gokselozgur5/pcb-design-collar-tracker/mechanical/swim-r05-route-fit/README.md

# Preliminary fit for r05f

All 69 populated envelopes and 30 analytical shell checks pass using the actual
r05f placements. C9's new bottom-side position clears the existing carrier.
The smallest checked gap remains C10/carrier at 0.24 mm. The original carrier
still fails the D1 negative control.

PCB SHA256: `1b2b4bd7b90c3931bd8cbb151637408902332a94260d4a2a820ae6df04838a09`.

This retains the r03 height profile and r02 shell geometry. Nine resistor heights
remain requirements, not approved MPNs. Pack, antennas, harness, dock, retention,
seal materials and physical qualification remain open.

The rigid envelope remains 57.4 × 49.4 × 17.6 mm, or 58.7 mm including the key.
The boot is 60.4 × 52.4 × 22.4 mm. The provisional immersion condition is 2 m fresh
water for 60 minutes. No new mesh acceptance or physical dust/water test is claimed.
The inspected populated preview shows conservative boxes and reserved volumes.

Refresh the native export, fit checks, shell checks, preview and manifest after
any source change. The preserved r02 meshes and physical-test requirements do not
become r05f acceptance simply because these dimensional screens pass.
