gokselozgur5/pcb-design-collar-tracker/docs/PCB_DESIGN.md

# PCB Design

Treat PCB work like software engineering: requirements, versioned source, small
changes, checks and a verified release. Use this workflow for future boards too.

This file defines the method. The current board state is in [STATUS](STATUS.md),
its decisions in [decisions](decisions.md), and the application of Paul's review
in [paul-nanosim](paul-nanosim.md). Dimensions and results from one board do not
automatically apply to another.

## Software engineering equivalents

| Software | PCB equivalent |
|---|---|
| Requirements and acceptance criteria | Use, dimensions, power, interfaces, environment, manufacturing and test targets |
| Architecture and API contracts | Block diagram, power tree, pins, voltages, timing and connectors |
| Source code | Schematic, native PCB, project rules, footprint and symbol libraries |
| Dependency lock | CAD version, exact MPN, datasheet revision, library commit and stackup |
| Build | Netlist, Gerber, drill, BOM, CPL, stencil and mechanical outputs |
| Static analysis | ERC, DRC, schematic–PCB parity and geometry checks |
| Unit/regression tests | Pin mapping, footprint dimensions, connectivity and before/after failure examples |
| Integration tests | Actual supplier DFM, assembly review and physical board measurements |
| Release | Checked manufacturing package linked to source by hashes |
| Production smoke test | Bring-up, programming, power/radio/sensor and end-to-end function tests |

**Clean ERC/DRC does not prove the board works. Clean PCB DFM does not qualify
assembly or functionality.** State the scope of each result.

## 1. Define the requirements

Record the following before designing. Mark unknowns as assumptions; do not
silently turn them into decisions.

- Use: what does the device do, under which conditions and how often?
- Country/operator/service: are the connectivity technology and actual service compatible?
- Mechanics: board, battery, antennas, enclosure, mounts, cables and access clearances.
- Power: supply range, peak/average current, operating modes, charging and runtime.
- Interfaces: voltage levels, pin mapping, timing, boot/reset and debug.
- Manufacturing: quantity, budget, layer count, thickness, assembly and hand-soldering needs.
- Delivery: bare PCB, assembled board, or programmed and function-tested device?
- Acceptance: which measurement or test demonstrates completion?

Do not fix battery capacity or board dimensions from an estimate alone. Place real
components, antennas and mechanical volumes together; verify fit and runtime separately.

## 2. Architecture and component selection

Draw a block diagram and power tree. Define each block's inputs, outputs, power
domain and failure behavior. Review supply dips, reset, insertion/removal and
back-powering through interfaces while the device is off.

Every physical component needs an exact MPN, manufacturer, package, pinout and
manufacturer document. A distributor SKU does not replace the MPN. Availability
and suitability are dated evidence. Similar part names do not establish matching
manufacturers, packages or pins.

Read the manufacturer's datasheet and reference design first. Record source URL,
revision, download date and SHA-256. A library symbol or AI explanation alone is
not evidence of the manufacturer's pinout.

## 3. Schematic and footprints

- Make power domains, net names, NC pins, pull-ups/downs and debug paths explicit.
- Check the chain: pin number → manufacturer function → schematic net → PCB pad.
- Run ERC and record ignored checks and justified exceptions separately.
- Independently check critical connections in the netlist. Reading the same wrong
  table used by the generator is not independent verification.
- Compare each footprint with the package drawing: pin 1, top/bottom view, pitch,
  pad dimensions, exposed pad, pegs/holes, mask, paste, courtyard and keepouts.
- Check flipped bottom-side parts and CPL rotations separately.
- One pad number can identify multiple physical pads. Use UUIDs or pad indices.
- Version project-specific footprints in a local library. Resolve differences
  between the native board and library instead of hiding mismatch warnings.

Connector lands fitting on the PCB does not establish usability. Leave space for
card insertion/removal, cable bends, latch release and tools.

## 4. Manufacturing constraints and layer stack

Use the actual supplier's limits for the selected process, layers and thickness.
Set track width, copper clearance, drill, annular ring, mask bridge, board-edge
and silkscreen rules in the project. Keep a dated capability reference.

Supplier minima need not be the design targets. Leave margin where possible.
If fixed package pitch requires an exception, scope it to that geometry; do not
lower every track/via clearance.

Choose layer count and stackup from signal, current and RF requirements. This
project's four-layer/two-inner-GND choice is not a rule for every board.
For controlled impedance, calculate against actual dielectric thickness, material,
copper and supplier stackup. A trace width alone does not establish 50 ohms.

## 5. Placement and routing

Place mechanical constraints, connector/antenna access and critical power/RF
blocks first. Follow manufacturer layouts for decoupling and sensitive feedback
loops. Review critical paths before leaving them to an autorouter.

### Ground and return paths

- Connect the pins that require GND. Connecting every pin to ground is not a goal.
- A GND net name, zero open connections and a good return path are different findings.
- Avoid unnecessary splits in reference planes. Follow return paths across layer
  changes and plane interruptions.
- Give GND pads short local connections to the plane. Do not daisy-chain unrelated
  small passives along a long ground trace.
- Adjacent IC ground pins may share a suitable short connection; record its geometry.
- Place return vias near the relevant signal/power transition. Evaluate spacing
  against the signal and stackup; an inherited number is not a universal standard.
- Measure actual connection to the correct filled plane, not just via count.
  Check isolated islands and saved fills.

### Power, thermal behavior and RF

- Review operating-voltage margin and power sequencing from the actual netlist,
  not just connectivity or DFM. A charger battery cutoff is not automatically a
  modem-rail guarantee. Distinguish typical parameters from guaranteed limits.
- Trace off-state feeds through ADC dividers, pull-ups and debug interfaces.
  A nominal reset delay does not establish a minimum disable interval after a
  brief fault; inspect the supervisor's timing-capacitor reset behavior.
- Size power paths from peak current, allowed drop, copper thickness and temperature.
- Measure short pad escapes separately from long power runs. A netclass setting
  does not prove that every actual trace uses that width.
- Review sequencing, UVLO, charge limits, NTC/protection and transients.
- Compare copper attached to both pads of small passives. Assess soldering and
  thermal balance when one side has a plane and the other a narrow neck.
- Check RF geometry against the reference design and real stackup. Antenna
  keepouts, enclosure, battery and body proximity may need separate measurements.
- Check the full RF trace projection over reference copper; a backed centerline
  can miss an edge crossing a via antipad. Validate converted fill holes against
  native point containment before trusting an independent geometry checker.
- Compare the supplier calculator's actual inputs with its catalog and guide.
  Nominal copper weight, etch taper, mask and finished thickness can use different
  conventions. Record discrepancies; numerical solver tolerance is not process tolerance.
- Adding an ESD part is insufficient by itself. Review connector → protection → IC
  routing and the protection device's ground path.

### Autorouting

Pin CAD/router versions and settings. Export a copy rather than altering the native
source. Expanded pads or keepouts used by the router are not production geometry.
Prevent long autorouted GND buses where ground should connect through planes.

After import, recheck placements, pad/net mapping, layers, locked critical traces,
ground connections, via diameters/drills and minimum widths. A router completion
message does not replace native DRC.

## 6. Verification: what actually passed?

| Check | Required evidence | Does not prove |
|---|---|---|
| ERC | Report for the right schematic/revision, with ignored defaults | Physical operation |
| DRC + parity | Violations, opens and schematic match for the right PCB/project | RF/EMC or power stability |
| Ground review | Pin/net mapping, actual fill, local connection and return measurements | Laboratory EMC performance |
| Geometry regression | Check fails on the old defect and passes on the fix | Every supplier algorithm |
| Gerber review | Actual exported layers, pads, holes and dimensions compared | Assembly correctness |
| Supplier PCB DFM | Uploaded ZIP hash, record ID, rules, completed result and PDF | SMT or functional acceptance |
| PCBA review | BOM/CPL/part/orientation/stencil/factory-preview match | Firmware and product behavior |
| Physical acceptance | Conditions, board revision, firmware and actual test results | Untested environments |

Check commands against the installed KiCad version's `--help`. Include relevant
severities, all track errors and schematic parity. Refresh zone fills; do not
accidentally use `--save-board` on a released file.
[KiCad 10 CLI documentation](https://docs.kicad.org/10.0/en/cli/cli.html).

First map each warning to real coordinates, geometry and net. Similar locations
need not be the same defect. After fixing one, inspect its symmetric counterpart.
Do not weaken rules or arbitrarily shrink manufacturer lands to get green results.

Our release practice requires **two fresh DFM runs of the same final ZIP bytes**.
This is our repeatability check, not a universal supplier requirement. Confirm the
analysis finished, every row was evaluated and rules stayed unchanged. A loaded
web page is not an analysis result.

## 7. Assembly, programming and working delivery

The BOM needs exact parts, values/tolerances, packages, references and DNP status.
Match CPL references, side, coordinates, units, origin and rotation to the supplier
preview. Do not submit DNP parts or bare contact/test pads as fitted components.

An MPN match is not a package-model match. Compare numbered lands and polarity on
both sides; supplier libraries can require different zero angles or have missing
models. Preserve the native CPL and record supplier-specific corrections separately.
After a BOM/CPL reupload, reload the preview and compare downloaded placements with
the exact uploaded bytes: a cached preview can retain earlier rotations. Record
missing fitted references explicitly; an incomplete preview cannot pass full SMT.
[JLCPCB BOM requirements](https://jlcpcb.com/help/article/bill-of-materials-for-pcb-assembly).

Connector libraries may number a signal and duplicated ground lands differently.
Map electrical functions against the manufacturer drawing before comparing geometry.
Apply each pad's local rotation; width/height alone can suggest a false mismatch.
Keep the native physical centre separate from a supplier model's origin. If a
dated model needs a CPL offset, preserve it as a supplier-specific review candidate,
prove its placement in the actual preview and obtain factory datum confirmation
before machine programming. Do not move correct native copper to match a library.

Confirm actual stock, substitutions, bottom-side assembly, stencil and special
processes for the intended order. A datasheet does not establish factory availability.

For programmed delivery, define the firmware image/hash, debug/pogo access,
programming procedure, serial identity and test fixture. Specify acceptance inputs,
measurement limits and failed-board handling.

For a multi-image MCU, inspect the linked reset vectors and actual merged image,
not only a successful compile. Prove that programming bytes exclude the persistent
data region and that the chosen bootloader/secure/non-secure layout is complete.
Keep SDK revisions and source identities with the evidence. Check vendor API
preconditions such as radio functional mode and interrupt context. Test storage
failures and duplicate delivery in the real application core, then repeat critical
power-loss cases on hardware; a host storage model is not a flash qualification.

A caller timeout does not cancel a modem operation. Keep one explicit owner for
each outstanding SDK result, release late results, and prevent overlapping work
until it finishes or the entire subsystem resets. Feed a watchdog from bounded
main-progress leases; an expired lease must stay failed even if main returns late.
Check the vendor's reset-domain table and compiled peripheral ownership. Exercise
the actual worker/supervisor with controlled failures, then observe reset and
persistent-data recovery on hardware. Host adapters do not prove modem or scheduler
behavior, and sleep/watchdog wakeups belong in measured battery accounting.

Signed boot needs more than a successful signing command. Match the image's public
key to bytes embedded in the built bootloader, verify the actual header/payload
and check that primary-image validation and boot-region protection are compiled.
Reject SDK default private keys by public-key identity, including renamed copies.
Record production key custody separately from a development signature. Retain a
reviewed migration when adding a bootloader changes the flash layout.

Check staging offsets against the chosen swap algorithm and the actual downloader
implementation. A nominally supported DFU API can still write at the wrong slot
offset. Make trial confirmation depend on useful, bounded application evidence;
exercise missing acknowledgements, confirmation failures and interrupted writes.
Host bootloader simulation and target signatures are separate evidence; neither
qualifies physical flash, watchdog handoff or power loss during swap.

Bring-up proceeds through short/resistance checks, polarity, current-limited power,
rails, reset/debug, firmware, then radio/sensor and end-to-end functions. Test the
battery, charger and protection against the selected cell's limits. Do not claim
unmeasured health or sensor performance as a validated product feature.

## 8. Git, scripts and releases

```text
AGENTS.md / CLAUDE.md   Entry instructions for a new session
docs/STATUS.md         Current revision, verified results, gaps and exact next step
docs/decisions.md      Decisions, assumptions and supporting evidence
docs/WORKLOG.md        Short record of meaningful completed steps
hardware/             Native source and local libraries
scripts/              Reproducible generation, checks and exports
experiments/<rev>/    Isolated trial sources and evidence
references/           Manufacturer sources, revisions and hash manifest
evidence/             Selected reports, measurements and before/after evidence
release/              Immutable delivery packages linked to source
mechanical/           Enclosure, mounts and real component volumes
```

Identify the actual current source in STATUS. A directory named `hardware/` is not
necessarily the latest revision.

- Use a dedicated repository; do not accidentally stage files in its parent repo.
- Write all GitHub-facing content in English: docs, comments, generated labels,
  commits, issues and PRs. Conversation language does not change this rule.
- One coherent change per commit. Keep related schematic/footprint/PCB changes
  together; separate independent fixes. Mark unfinished work as WIP.
- Preserve source and old releases. Create new trials separately; do not silently
  regenerate a finished board over its existing source.
- Compare placements, pad shapes/nets, rules and critical routes semantically.
  A large KiCad text diff alone is not a review.
- Bind source SHA, tool versions, output list, ZIP SHA, local checks and supplier
  records in a release manifest.
- Actually open Gerber/drill/mask/paste outputs. Check layers, outline, holes,
  pad openings, board edges and both sides' orientation.
- Submit only suitable manufacturing files. Exclude browser profiles, tokens,
  cookies, raw sessions, virtual environments, private notes and unrelated files
  from Git and manufacturing ZIPs.
- Check the release in a clean checkout. A useful regression must reject an
  incorrect source or changed output.

For a retained battery, test the smallest allowed pack as well as the largest
in-service envelope. A seated-pack fit does not check upward travel, sensor contact
or escape through the cap. Keep intended bearing contact separate from component
clearance. When two stops share a monolithic carrier, calculate their relative
height; do not combine opposite translations of the same part. Record the full
tolerance chain, thermal bounds and unqualified tilt/load behavior.

## Completion criteria

Name the completed stage: schematic, placement, local checks, PCB DFM, PCBA or
working product. Inspect evidence for every acceptance criterion in that stage.
Another revision's green result or a report title is insufficient.

Deliver a short result, real remaining gaps and the full artifact path.
For local files, provide a copyable command such as
`open -R "/absolute/path/package.zip"`. Update STATUS so the next session knows
where work stopped and what to do next.

## New PCB brief

```text
Purpose / use:
Confirmed requirements:
Open decisions / assumptions:
Board + battery + antenna + enclosure limits:
Power tree / peak and average current:
Critical interfaces / manufacturer references:
Supplier + process + stackup + design margins:
Current native source / revision:
Acceptance criterion → check → evidence file:
Manufacturing delivery scope:
First concrete next step:
```

## Lessons from this board

- KiCad Python's `FOOTPRINT.SetLayerAndFlip` needs an owning `BOARD`. Attach a
  library-loaded footprint with `board.Add(footprint)` before flipping it. An
  unowned test object crashed in `BOARD::FlipLayer` on KiCad 10.0.7; attaching
  it first completed normally. Treat a native crash as a failed operation,
  inspect its cause and validate saved-file integrity before continuing.
  `scripts/check_kicad_flip.py` exercises that ownership order without saving CAD;
  its process must also exit normally. A separate finalization crash has not been
  attributed to this cause.

- Remembering Paul's GIMP review is not the same as applying it to this board.
  Review each new design against its actual source.
- Two copper pours do not prove two uninterrupted ground references. Inspect
  actual tracks and saved fills on each layer.
- The same 0.3.3 ZIP returned 0/0 and later 0/1. Recheck final bytes; do not turn
  one observation into a universal guarantee.
- The mask warning involved two similar ground necks. Match coordinates individually.
- Removing items while traversing KiCad 10 SWIG collections caused failures.
  Snapshot items first and use `Delete` for removed in-memory objects. Check the
  resulting native board with DRC.
- SIM form factor does not change modem technology. Nano-SIM does not remove
  LTE-M/NB-IoT operator compatibility or the 1.8 V UICC requirement.
- Check connector insertion against the manufacturer's drawing and an actual
  component-side CAD view. Bottom-side mirroring can reverse an assumed opening
  direction; a rotation angle alone does not prove access.
- Preserve working remote pin escapes during local placement changes. Removing
  whole nets can let later routes block fine-pitch pins that were already usable.
  Reserve nearby exits together before routing long connections.
- Placement must reserve signal escapes as well as local GND connections. A
  courtyard/copper-clear part can still have pins trapped between fixed routes.
  Retain unaffected rail geometry where changed pad nets and new lands permit it;
  blanket power-net removal can unnecessarily destroy usable routing.
- Test a suspected connectivity API limitation before changing the router around
  it. KiCad's recursive track connectivity already reached vias in this board;
  an initial one-step query was insufficient evidence of a missing connection.
- For a repair route, export and import must use the same lock policy. A no-routing
  DSN/SES round-trip exposed duplicated locked native copper and two co-located
  drill holes. Preserve the named escapes, unlock replacement routes on import,
  and check the result with native DRC before running a longer search.
- Reconcile router incompletes with native pin connectivity and dangling branches.
  A higher router count is not automatically that many new electrical opens.
  Disable a repair's fanout pre-pass explicitly when testing the existing escapes.

Add reusable lessons here. Current tasks and results belong in STATUS and WORKLOG,
not a growing diary inside this guide.

- Check the router's loaded lock state, not only native KiCad locks. Freerouting
  2.5.0 treats KiCad's `(type route)` token as `USER_FIXED`; use `(type normal)`
  for deliberately movable routes and retain `(type fix)` for protected copper.
  `InspectRouterLocks.java` must reject the old model and accept the corrected
  model. Count differences after loading can reflect merged polylines.
- Native copper can join a pad interior or a trace midpoint. A router expecting
  exact centers/endpoints can report false opens. Preserve coordinate precision,
  split real junctions and check modeled connectors against existing copper.
  Validate the transfer with an isolated no-route SES round-trip and native DRC.
- Run native DRC beside the matching project and schematic. Checking a copied
  board without its project can silently use different rules. This also affects
  `LoadBoard`/`SaveBoard`: loading a bare snapshot and saving it at the real project
  path can write default rules into that project. Restore a checkpoint at its
  matching project path before loading; compare design rules and net classes
  before and after mutations. A report produced with substituted rules is invalid.
- A dangling track may feed a live branch at its midpoint. Trim only the unused
  tail, then recheck pin connectivity; deleting the whole track can break a net.
- Grow the board in a separate experiment when measured routing warrants it.
  Compare resulting power paths and native checks; more area alone does not
  establish better signal routing, enclosure fit or manufacturing acceptance.
- Read the units of individual supplier fields. The JLC measurements used here
  are in mils while board-size metadata uses inches; a shared JSON response does
  not imply one common unit. Keep raw coordinates and the explicit transform.
- Derive label bounds from the actual outline and text size/stroke from native
  rules. Check real glyphs against mask/drill geometry, bind the plan to a source
  hash, and inspect connector association after applying it.
- Give Freerouting an explicit workspace `--user_data_path` even for `-h` or
  version/help probes. Startup can migrate and save the default user settings.
- Reserve fine-pitch pin exits during wider repair routing. Inspect imported
  via coordinates and drilled holes; a nominally protected via can be retained
  beside a shifted router replacement, leaving two near-coincident holes.
- Preserve a moving connector's insertion/removal volume before placing nearby
  protection or decoupling parts. A static footprint courtyard does not model a
  card sliding over the PCB. Check the manufacturer drawing, populated bodies,
  heights and tolerances on the actual component side.
- Audit ESD routing as physical copper topology. An autorouter can connect a
  protected branch back through its same-net connector pad, bypassing the clamp.
  Compare before/after paths; a clamp-land cut can detect bypasses but cannot
  qualify surge performance. Test same-layer branches and via-mediated bypasses.
- Count unique copper around a passive pad. Summing overlapping segment widths
  can double-count one physical connection. Compare both pad exits, nearby rail
  branches and short necks; retain solder/reflow qualification as a separate step.
- Copy SWIG vector coordinates before a native mutation. A stored `GetEnd()`
  wrapper can alias the track and change after `SetEnd()`, creating a zero-length
  split segment. Construct a new `VECTOR2I` and verify native connectivity.
- A joint signal-via/ground-via move can open a site that isolated placement
  searches miss. Record the coupled geometry and recheck every affected net,
  filled plane and return-screen point instead of weakening the target.
- A loaded supplier page is not an uploaded or analyzed design. Bind acceptance
  to an actual upload request, final ZIP hash, distinct record ID, complete rows,
  raw measurements and unchanged rule bytes. Preserve failed runs separately.
- Check seal tolerance extremes using the installed geometry and rubber volume.
  Include stretch, groove-bottom radii and cavity-corner webs; a nominal squeeze
  value alone misses overfilled grooves and thin corners. Retain rejected cases.
- Inspect exported mechanical solids as well as CAD previews. Bind mesh checks
  to their inputs and verify bounds, edge closure and connected surfaces. This
  detects export/model defects; it does not establish physical sealing.
- Check component heights at actual PCB placements, including mated connectors,
  solder/warp allowances and factory wire terminations. Treat unresolved harness
  limits as requirements, not purchased parts. Native board bounding boxes can
  include Edge.Cuts stroke width; use the physical outline for board dimensions.
- Check contact backing hardware and carrier topology together. A relief that
  clears a nut can split a carrier into disconnected pieces. Retain bridging
  material, inspect the exported mesh, and use a deliberately failing CAD variant
  to prove that the interference checker can detect the original problem.
- Specify immersion conditions separately from an IP68 design target. Complete
  battery, antenna, charging and assembly definitions before tooling; qualify
  the final assembly for ingress, power, RF and retention with physical tests.
- Include the motion allowed by a retaining frame, not only the seated PCB pose.
  A small lift can consume cable clearance even when the stationary board fits.
  Keep conservative swept component bounds separate from sampled cable poses;
  a finite pose grid does not prove every continuous deformation or flex cycle.
- Reference retainer and lid-stop dimensions to assembly datums and check the
  complete closing stack. Preserve SIM insertion access in the stated service
  configuration. An internal stop must not force the gasket joint open.
- Treat room-temperature fit, assigned manufacturing limits, material expansion
  and physical retention strength as distinct evidence. Datasheet guideline
  properties do not qualify a thin machined or printed retaining feature.
- Check exported meshes before rendering previews. Coincident rectangle and
  offset-contour faces can create submicron STL slivers; use a shared outer
  contour and real internal overlap, then repeat the same edge/manifold checks.
  Preserve the failed export instead of relaxing mesh precision to hide it.

- Separate guaranteed material bounds from engineering sensitivity intervals.
  A longitudinal CLTE guideline over 23–60°C does not establish cold or transverse
  behavior. Keep actual laminate identity and moisture/creep effects explicit.
- Define axial tolerance chains precisely. If 0.05mm is an assembled-plane budget,
  its constituent length errors must fit that total; do not silently allow each
  part its own 0.05mm. Preserve shared-part temperatures when summing lengths.
- A cable optimizer can find a collision-free curve while asking a connector to
  rotate or carry excessive load. Record the admitted endpoint orientation and
  leave actual connector force, continuous movement and flex life unqualified
  until they are supported by construction limits and physical evidence.

### Routing a congested board without losing ground references

Measure the blocked regions before rerunning the same search. If extra routing
layers are justified, retain two dedicated GND planes and explicitly declare the
signal/ground allocation. Every through-via must clear every spanned signal layer;
check its local return when placing it. A saved RF track shape does not preserve
impedance when dielectric thickness or stack arrangement changes.

Before calling the new revision complete for PCB DFM, refresh connectivity, filled
plane containment, local GND paths, SIM clamp topology and populated fit from the
final source. Inspect both copper attachments on new passives. Check text against
tented drill holes as well as mask openings; native DRC alone did not catch the
r05h silkscreen findings. Preserve a failed package separately and obtain two
fresh analyses of the corrected ZIP with unchanged supplier rules.

### Charging contacts and imported assembly frames

A pogo-pin current rating or nominal free height does not establish a dock fit.
Use the actual manufacturer's datum drawing, full travel and general tolerances.
Separate the rear-seated operating position from unloaded axial float. Check the
key before the earliest possible electrical touch, not just at the final position;
include the physically reversed geometry and leave skew/load qualification explicit.
A spring force at midstroke is not a whole-stroke bound, and magnet diameter alone
is not holding-force evidence. A fuse marking is not a current-regulation function.

Imported STLs can be in a print/export frame. Read the generating transformation
before performing assembly intersections. Preserve a failed frame check as a setup
error rather than modifying a correct part until the wrong frame turns green.

### Wire movement and evidence boundaries

If an electrical contact can move in its mount, a rear-seated straight wire is not
a complete harness layout. Check both the shortest and longest endpoint spans
against controlled cut length. Extra wire can create an excessive bend or collide
with the housing, so a minimum-length check alone is insufficient.

Distinguish a constant-length curve family from an implemented restraint. A free
wire does not automatically follow the mathematical family. State the clamp,
forming fixture, cut preparation and physical cycling work separately. A static
manufacturer bend limit is not a cyclic-flex-life rating.

For continuous clearance claims, use interval envelopes or another explicit bound;
rendered/sample poses are illustrative. Bound numerical integration error before
using it to assert a dimensional limit. Include controls that reject the old
housing, stretched straight wire, excessive slack and overly tight curves.

When a review uses successor mechanical parts with an unchanged PCB, publish a
single current package with an exact part/revision map. Keep earlier packages
immutable and make the remaining manufacturing/physical gates visible in the
current drawing. A higher test count is not evidence that those gates closed.

A friction clamp needs an implemented gap, pad pockets, closing stops and an
assembly method. Check incoming pad thickness and outline extremes, not only the
nominal sheet. Keep pad displacement separate from pressure, friction, creep,
insulation damage and measured pull strength. A forming fixture does not prove
that an unrestrained flexible wire follows its nominal curve during service.

Distinguish an intentional bearing face from an interference volume. If CAD
exports a zero-thickness contact surface, verify every vertex against the intended
plane and footprint, and include a deliberately penetrating control. Do not
silently remove a contact band to make an intersection empty. Deliverable parts
still need closed, valid solid meshes; a planar analysis surface is not a part.

An immutable review archive can contain dated STATUS/RESUME snapshots. Verify
their embedded hashes against the archive manifest, while checking preserved
CAD/source/evidence against repository bytes. Requiring historical status prose
to equal today's status defeats an otherwise intact snapshot.

### Rear contact retention and manufacturable meshes

A screw/nut fitting within a reservation does not prove that it retains a contact.
Compare the complete rear bearing surface with the actual enclosure bore and
follow the clamp load back to the external head. The collar's old 6.4mm circular
reservation was smaller than its 7.34mm bore. r16 adds explicit bearing ears;
force, torque, creep and electrical contact resistance still require qualification.

Inspect exported mesh topology as well as CAD diagnostics. Two overlapping
extrusions at an oblique thickness step generated near-duplicate vertices even
with `Simple: yes`. A single blank with one subtractive step preserved dimensions
and passed the unchanged inspection grid. Keep expected planar contact distinct
from penetration and include a deliberately shifted positive-volume control.

### Internal wire routes, solder lands and movement

Route all conductors together, including actual stripped ends and the adjacent
pads. Fit the bonded length on the native copper polygon; placing only the wire
tip at the pad centre is insufficient. Include cut and position uncertainty when
changing from the insulation envelope to the smaller conductor envelope.

Keep attached parts and endpoints correlated during PCB motion. Sweeping every
part independently against a stationary attached wire invents collisions. A
different fitted curve length at every pose is also invalid for one physical
wire: cut tolerance is not elastic stretch. Use fixed-length cases, actual end
restraint and a factory/service sequence before releasing wire cut instructions.

A thinner internal wire can meet the geometry without growing the shell, but its
resistance, maximum pull and fault-current behavior must be reconsidered. Never
transfer the external harness pull target to a smaller conductor by assumption.

Apply the declared component thermal and retention-movement envelopes to every
cable family. In r17, RF checks used those envelopes while charge-wire checks
used nominal solids; the combined green count therefore had a narrower scope
than the assembly needed. r18 preserves that source and its newly reproduced
failures, then checks the revised routes against expanded envelopes. Expand
the actual cut solid so tolerances reduce usable relief space. Removing material
must also preserve capture features and leave strength/creep acceptance explicit.

Validate an optimizer's routes independently. Sparse curvature samples missed a
short tight bend in one r18 candidate. Continuous bounds rejected it; refitting
the curve with control points distributed by arc length produced a tractable
replacement. A search score, iteration status or convenient representation is
not geometry acceptance, and static geometry is not physical wire restraint.

### Staking and forming tools

Define the actual substrates carrying an adhesive load. A silicone data sheet
does not establish adhesion to untreated PTFE, solder mask, a plating finish or
flux-contaminated joints. Keep each intentional contact explicit; a shared
insulating block can own two leads, but their electrical separation still needs
independent evidence. Check both the minimum filled and maximum occupied volumes,
including the combined placement/service budget.

A shape that clears 27 static poses may still demand deformation after curing.
Report captured-section displacement instead of treating independently fitted
curves as a validated elastic motion family. Keep cure, substrate coupons,
holding force, creep, fatigue and installation acceptance separate from CAD.

Export the actual forming tools. Bound the spline-to-polyline error, account for
polygon facets and machining allowance, then check the delivered tool against an
inflated wire witness. Include a physically wrong control. An open-top channel
helps removal, but does not establish springback, cut-length capability or the
shape after transfer into the product.
