gokselozgur5/pcb-design-collar-tracker/release/collar-tracker-0.3-35x28-dfm/drill-report.txt

Drill report for collar-tracker.kicad_pcb
Created on 2026-10-24T21:14:27

Copper Layer Stackup:
    =============================================================
    L1 :  F.Cu                      front
    L2 :  In1.Cu                    in1
    L3 :  In2.Cu                    in2
    L4 :  B.Cu                      back

Drill file 'collar-tracker-PTH.drl' contains
    plated through holes:
    =============================================================
    T1  0.200mm  0.0079"  (77 holes))

    Total plated holes count 77

Drill file 'collar-tracker-NPTH.drl' contains
    unplated through holes:
    =============================================================

    Total unplated holes count 0
