gokselozgur5/pcb-design-collar-tracker/experiments/power-r05l-charge-interlock/evidence/collar-tracker-05l-charge-final2-40x32-dfm/drill-report.txt

Drill report for collar-tracker.kicad_pcb
Created on 2026-10-25T23:44:11

Copper Layer Stackup:
    =============================================================
    L1 :  F.Cu                      front
    L2 :  In1.Cu                    in1
    L3 :  In2.Cu                    in2
    L4 :  In3.Cu                    in3
    L5 :  In4.Cu                    in4
    L6 :  B.Cu                      back

Drill file 'collar-tracker-PTH.drl' contains
    plated through holes:
    =============================================================
    T1  0.200mm  0.0079"  (276 holes))

    Total plated holes count 276

Drill file 'collar-tracker-NPTH.drl' contains
    unplated through holes:
    =============================================================

    Total unplated holes count 0
