gokselozgur5/pcb-design-collar-tracker/docs/paul-nanosim.md

# Paul review and nano-SIM revision

These are the applicable requirements from Paul's earlier GIMP review, adapted to
this different PCB. The earlier GIMP board's acceptance does not validate this one.
The source review was the archived 2026-09-24 second-review record and GIMP v0.1.6
implementation. Company board files are not copied into this personal repository.

| Review point | Collar action | Acceptance still needed |
|---|---|---|
| GND vias connected by long tracks | Short pad-to-via connections; planes carry GND | All grounds connected, short stubs, no long serial ground bus |
| Two GND core layers | Four-layer revisions: In1/In2. Six-layer r05h: In1/In4 | No tracks on either dedicated GND plane; inspect actual fills |
| Return beside signal via | Add local GND vias | Screen all non-GND vias at ≤2 mm; review RF/ESD needs individually |
| Broken power pours / thin paths | Size continuous power traces | Trunks, pad escapes and worst-case current/drop reviewed |
| Unbalanced copper on small passives | Avoid excessive copper on one end | Inspect both pads, width/count/length of copper attachment |
| Awkward angles and detours | Clean local routing | DRC plus actual geometry inspection |
| SMT and useful labels | Real SMT SIM socket; clear interface labels | BOM/CPL/body/card clearance and supplier assembly acceptance |
| Jumpers, USB/CAN connectors, mounting pattern | GIMP-specific details | Do not add irrelevant circuits or blindly copy hole coordinates |

The 2 mm screen came from the earlier implementation; Paul did not establish a
universal numerical RF limit. More than 2 mm is a review candidate, not by itself a
demonstrated product failure. Fewer vias is not the goal; connected local returns are.

## Socket and ESD

GCT SIM8051-6-0-14-00-A is the no-peg SMT nano-SIM candidate. Manufacturer drawing D5
was inspected locally; revision D6 was subsequently obtained from Mouser and its
full drawing and enlarged land pattern were also inspected. The relevant dimensions
match. Do not add the optional peg holes to this part. Verify insertion and
removal access before placement acceptance. Reference files and hashes are in
`references/paul-nanosim-r04/sources.json`.

| Socket pin | Function | Board net |
|---|---|---|
| 1 / C1 | VCC | SIM_1V8 |
| 2 / C2 | Reset | SIM_RST |
| 3 / C3 | Clock | SIM_CLK |
| 5 / C5 | Ground | GND |
| 6 / C6 | VPP | Unconnected |
| 7 / C7 | I/O | SIM_IO |
| 8 (two physical lands) | Shield | GND |

Contact lands: 1.00 × 1.10 mm at x = −2.54, 0, +2.54 and y = ±5.90 mm.
Shield lands: 1.00 × 3.00 mm at x = ±5.30, y = 0 mm.
Coordinates are component-side drawing coordinates, before bottom-side placement.
Central keepout: x = ±3.575, y = −2.15 to +2.70 mm. Six 1.20 × 1.00 mm
wiper keepouts: x = −2.54, 0, +2.54; y = −4.15 and +3.45 mm.
The builder expresses these as side-specific copper/pad/track/via keepouts.

TI TPD4E1U06DCKR is the four-channel SIM ESD candidate (SC70-6). r04i uses two:
D1 pin 1 reset, pin 3 clock, pin 6 SIM supply; D2 pin 3 data.
The preserved r04h mapping exchanged D1 pins 1 and 3. Pin 2 is GND and
unused I/O channels are NC. The four protection channels are interchangeable
under the [TI datasheet](https://www.ti.com/lit/ds/symlink/tpd4e1u06.pdf).
The older single-D1 mapping belongs only to the preserved earlier sources.
Connector → ESD → modem routing and the ESD ground return must be short;
adding a named component alone does not verify ESD protection.

[Nordic's UICC interface](https://docs.nordicsemi.com/r/bundle/ps_nrf9151/page/ip/radio_lte/doc/simif_lte_m/frontpage.html)
requires external ESD for a removable card and uses native 1.8 V Class C UICC.
SIM supply is not VIO_1V8. Power the modem down before card removal; this design
does not implement hot-swap/card-detect behavior.

[Turkcell NB-IoT](https://www.turkcell.com.tr/kurumsal/dijital-is-servisleri/iot-nesnelerin-interneti/nb-iot)
is an activated M2M service. A physical nano-SIM does not turn nRF9151 into a
general LTE Cat-1 modem or establish moving-dog coverage. Operator, plan and
mobility behavior still need qualification. These are open product checks.

## Preserved r04h placement

The pre-access-repair source is `experiments/paul-nanosim-r04h-review-40x32/hardware/`.
The active r04i source and its changed positions are described below.
The 35 × 28 mm r04e source is preserved separately.
J6 (127,108), D1 (127,99.5), D2 (126.8,116.2), J5 (125,125), R14 (121.5,119),
R15 (126,118) and C10 (130.6,100.35) are on B.Cu. Charger U3 is at (105,123)
on F.Cu; C17 is at (106.2,120.25) on B.Cu, C18 at (103,120.85) and C19
at (101.8,122.5) on F.Cu. J4 is at (106,126.05) on B.Cu.
That saved stage has zero open connections, violations, warnings or parity
findings. All 91 non-GND vias pass the 2 mm return screen. D1/C10 occupy the
projected card-insertion corridor, so placement remains WIP. There is no new JLC
result; the two actual 0/0 runs belong to r04g. See STATUS for exact identities.
Power trunks are provisionally 0.4 mm, VIO 0.3 mm, signal minimum 0.2 mm;
via target 0.60/0.20 mm. A width setting is not an ampacity or voltage-drop test.

The initial r04 ground stage connected 81 GND pads through 68 vias. The saved
r04h rework uses 90: its native inventory finds all 90 centers inside both saved
inner fills, each with one filled outline and no inner tracks. U3.4 joins its own
exposed GND pad. Perimeter nRF ground necks are 0.25 mm to leave clearance beside
the 0.5-mm-pitch contacts. Adjacent IC ground pins may share a local connection;
do not route a ground bus through separate passive components. All 82 GND pads
reach local vias without using a plane shortcut. The longest measured centerline
path is C4.2 at 1.644 mm, excluding pad spreading. The only intermediate pads are
other GND pads on the same IC (U2, U3, U5), not separate passive components.

Preserve the 0.3.4 source. Its RF segments are locked/copied by the WIP builder;
their original 50 Ω stackup/body/antenna qualification is still open.

## Placement review and corrections

The [GCT product page](https://gct.co/connector/sim8051) identifies a push-pull
socket, with no card-detect switch. Rechecking the complete D6 component-side
drawing against native bottom-side pad coordinates resolved an earlier mistake:
the original angle of 0 degrees already points the opening toward decreasing y, near
C1/C2/C3 at y=102.1. In r04g, D1/C10/R15 were behind the closed end. The rejected r04c
180-degree rotation pointed the opening inward and is not used in r04d.
Do not repeat that rotation. This establishes the drawing direction; final
enclosure access, card removal and physical fit still need qualification.

r04h shortened the electrical entry paths by moving D1/C10 in front of the socket,
but their bodies now overlap the nominal card-entry projection. That placement was rejected and corrected in r04i below. GCT D6 page 2 gives
an 8.80 × 12.30 mm nano-SIM. On this board, the nominal entry strip is
x=122.60…131.40, y=98…101.90 mm before tolerances. A courtyard pass does not
prove that a moving card clears components. See `card-insertion-review.json`.

The [TI datasheet](https://www.ti.com/lit/ds/symlink/tpd4e1u06.pdf), DCK0006A
drawing 4214835/D, gives a land/paste example of 0.90 × 0.40 mm, 0.65 mm pitch
and 2.20 mm between row centers. r04d now uses that example, with 0.05 mm corner
radius, matching local library and native footprint. The earlier KiCad-derived
1.025 × 0.35 mm lands / 1.675 mm row spacing are retained only in older sources.
This footprint correction does not establish assembly acceptance or ESD layout
quality. Review connector-to-ESD-to-modem topology and the short ESD ground return
after the final routing changes.

[Nordic's VDD guidance](https://docs.nordicsemi.com/r/bundle/nwp_056/page/wp/nwp_056/vdd.html)
sets a routing DCR target below 0.1 Ω and calls for local filtering, decoupling and
low-impedance grounds. Measure actual path widths/lengths and supply droop; a
0.4 mm netclass setting does not establish compliance. Battery, ferrite, vias,
copper thickness and dynamic supply impedance must be distinguished from trace
resistance alone. `scripts/audit_power_paths.py` estimates centerline copper and
via-barrel resistance from a hash-matched geometry export; it excludes ferrite,
IC, contact and cell impedance, pad spreading, transients and thermal behavior.
The preserved r04h report includes the connected J5 supply branches and their remaining
power-review limits.
The earlier snapshot's estimate is preserved as `power-path-routed1-review.json`.
Rerun the audit after routing changes; complete power qualification remains open.

## r04h copper review

The r04g connector-to-clamp paths were 28.57 mm (supply), 24.52 mm (reset),
22.61 mm (clock) and 3.44 mm (data). All four had a copper route that bypassed
the intended clamp land. The r04h paths are respectively 1.754, 3.666, 1.754 and
1.471 mm with no entry vias. Cutting each clamp land out of the actual copper
disconnects its connector from the modem, so no bypass remains in that snapshot.
This is a topology check, not a powered ESD immunity test. The next mechanical
change must preserve or re-establish this property.

C2 now connects to a 0.4 mm VSYS trunk through one short 0.3 mm neck. R9 has one
0.2 mm branch from an offset 0.3 mm rail. C20/C21 and R1 use bounded pad necks;
manufacturer lands, masks and paste remain unchanged. Summing overlapping track
widths exaggerated the old attachment counts, so the report also measures unique
copper on contours outside each land.

At the 0.05 mm contour, the reviewed pad-width ratios are approximately 1.03
(C2), 1.14 (C20), 1.33 (C21), 1.07 (R1), 1.22 (R10) and 1.08 (R9). R10 needed
no geometry change. Wider contours include nearby rail branches; they remain in
the report rather than being hidden. These are geometric review cues, not solder
acceptance thresholds. [Murata's mounting guidance](https://www.murata.com/en-global/support/faqs/capacitor/ceramiccapacitor/mnt/0012)
also identifies solder quantity, temperature and placement variation as factors.

The main battery/modem path estimates are unchanged. The LDO input estimate
increases from 44.53 to 45.13 mΩ; C20-to-input and C21-to-output estimates rise by
about 0.56 and 0.54 mΩ. The auxiliary VIO path is 57.33 mm / 95.38 mΩ, with no
accepted port load yet. These copper-only numbers do not close transient, thermal
or full supply qualification.

## r04i access repair and final DFM

D1 is now at (133.4,99.7) and C10 at (136.4,100.35), both B.Cu, beside the
card-entry lane. R12 moved to (120.5,99.9), F.Cu. Its two attachments are each
0.2 mm at all three reviewed contours. The protected reset route crosses the
entry corridor through a short outer-layer bridge; the SPI span moved to make
room. The rejected 59.319 mm reset detour was never accepted. The unused old
clock branch and its transition vias were removed after the new route connected.

All four entry paths have no clamp bypass: supply 5.900 mm, reset 6.395 mm,
clock 10.234 mm and data 1.471 mm, each with zero entry vias. These are geometry
measurements; the longer side-routed clock entry still needs powered ESD review.
The body/land projection checks 19 bottom-side parts with a 0.20 mm lateral margin
and finds no card-lane overlap. Vertical clearance and physical insertion in the
assembled enclosure remain separate checks; the proposed carrier lifts out for service.

The final source has 82 locally connected GND pads, 91 GND vias in both continuous
inner fills, 93 non-GND vias within 2 mm, no inner tracks and 24 unchanged RF
segments. Native DRC/ERC/parity and connectivity pass. Main power-path estimates
are unchanged; unknown loads, ferrite/cell/contact impedance and transients remain
explicit limitations. Two fresh, same-byte JLC PCB reports are 0 Danger / 0 Warning.
SMT was off. See STATUS and the r04i checkpoint for hashes and record identities.

## r05h six-layer completion

The preserved r05h uses F/In2/In3/B for routing and In1/In4 as dedicated GND. The
unchanged 71-part circuit is fully connected with clear native DRC/ERC/parity.
All 94 unique ground terminals (97 physical pads) have local paths; 110 GND vias
are contained in both continuous planes. All 128 signal vias pass the inherited
2 mm screen. The original 24 RF segments and four SIM clamp paths are preserved.

The POWER_GOOD replacement route is 18.214 mm with no new vias. C30's 0.82 mm
ground attachment now matches its 0.2 mm supply attachment; all three unique-copper
contour ratios are 1.0. Manufacturer lands are unchanged. Native terminal groups
were preserved throughout unused-copper cleanup.

Both final JLC PCB runs have 0 Danger / 0 Warning, 29 rows and 449 green
measurements, with unchanged rules and SMT off. The actual dielectric stack, RF
impedance, powered circuit, factory assembly and physical ingress remain open.
Changing the stack changes impedance even when RF track geometry is unchanged.
See STATUS for final identities; do not transfer older physical or mesh claims.

## r05i RF follow-up

The six port nets now use 0.36 mm main tracks against a documented 7628 candidate
stack, with bounded module escapes. The GNSS elbow avoids the SIM via's reference
opening. All non-port tracks, pads, vias and ground returns are unchanged. Native
checks pass; two actual JLC runs report 0/0/450. See the
[RF review](../experiments/power-r05i-rf-stack/README.md).

RF acceptance is still open. The supplier's calculator/catalog/guide parameters
differ, both module pads have lower-layer VBAT beneath them, and R3's two-entry
attachment still needs correction or assembly acceptance. Its measured unique-copper
ratio is 2.09–2.41; DFM cannot establish solder balance. C11/C12 are DNP. Do not
call this a completed physical RF or factory-assembly qualification.

## r05j R3 and tuning-junction follow-up

The new R3 location moves 0.30 mm and has one 0.36 mm copper entry per land.
Unique-copper ratios at 0.05/0.15/0.30 mm are 1.004/1.003/1.001. The first local
trial still crossed the outer contours; it is preserved separately. C11's branch
shortens to 0.42 mm and C12 moves onto the main route without moving its footprint.
The total main feed is 3.02 mm longer; no RF performance improvement is claimed.

All other placements, lands, vias, inner copper, planes and rules stay unchanged.
Native DRC/ERC/parity are clean and two actual same-ZIP JLC runs each return
0/0/450. Module-pad GND is retained to avoid exposing underlying VBAT; its RF
qualification remains open. The copper balance addresses the layout finding,
while reflow and physical RF acceptance still require evidence. See the
[r05j review](../experiments/power-r05j-rf-junctions/README.md).
