gokselozgur5/pcb-design-collar-tracker/previews/collar-tracker-schematic.pdf

1 | 2 | 3 | 4 | 5 | 6 | 7 | 8 | 9 | 10 | 11
1 | 2 | 3 | 4 | 5 | 6 | 7 | 8 | 9 | 10 | 11

AB

C

D

E

## FGH

AB

C

D

E

# FGH Date: 2026-10-24

Size: A2 | Rev: 0.1-DRAFT
KiCad E.D.A. 10.0.7 | Id: 1/1

# Title: Collar tracker — schematic review draft

# File: collar-tracker.kicad_sch

# Sheet: /

# Not for fabrication — unresolved power, eSIM, RF and heart-rate interfaces

1

1 | 2
2 | J1
| LTE antenna / 50R
1 | 2 C17

# 1uF /10V PWR_FLAG

1 | 2 R7
3k /1%
1 | 2 R6
18k /1%
1 | 2 C23
100nF
SCL 1 | CS 2 | SA0 3 | SDA 4 | NC | 5 GND

6 VDD 9 VDD_IO 10 INT2 11

INT1 12 U5

### LIS2DW12TR

1 | 2 R8
10k
1 | 2 C2

### 1uF /10V

1 | 2 C4

### 10uF /10V

### PWR_FLAG

1 | 2 C21
1uF
1 | 2 R9
10k
1 | 2 C22
10nF
1 | 2 R15
100k
1 | 2 R14
100k
1 | 2 R13
4.7k
1 | 2 C24
100nF
1 | 2 C6
4.7uF
1 | 2 C8
100nF
1 | 2 R12
4.7k
IN 1 | GND

2 EN 3 NC 4 OUT_1V8 5 U4

### TPS7A0218PDBVR

1 | 2 R11
1M
1 | 2 R10
2M
1 | 2 C20
1uF
SYS | 1 BAT | 2 STAT2 | 3 nCE 4 | GND

5

TS_MR 6

ILIM_VSET 7

ISET 8 | STAT1 | 9
IN 10 | U3 BQ25185DLHR
1 | 2 C18

### 10uF /10V

1 | 2 C19

### 1uF /10V

1

1 | 2
2 | 3
3 | J4 Protected cell + NTC

### PWR_FLAG

1 | 2 R2
1k
1 | 2 R1
10k
1 | 2 C7
4.7uF
1 | 2 C3

### 47uF /10V

1 | 2 C5
100nF
1 | 2 C1

### 1uF /10V

1 | 2 FB1

### 22R @100MHz GND

1 P0.20 2 SWDCLK 3 SWDIO 4 P0.21 5 P0.22 6 P0.23 8 nRESET_2V2 9 ENABLE 10 P0.24 11 P0.25 12

VDD | 14 SIM_RST | 16 SIM_IO | 17 SIM_CLK | 18 SIM_1V8 | 19 MAGPIO0 | 21 MAGPIO1 | 22 MAGPIO2 | 23 DEC0 | 24 SIM_DET_UNUSED | 26 SDATA | 27 SCLK | 28 VIO | 29 ANT | 35 AUX | 37 GPS | 42 P0.26 44 | P0.27 45 | P0.28 47 | P0.29 48 | P0.30 49 | P0.31 50 | COEX0 | 52 COEX1 | 53 COEX2 | 54 P0.00 56 | P0.01 57 | P0.02 58 | P0.03 59 | P0.04 61 | P0.05 62 | P0.06 63 | P0.07 64 | VDD_GPIO | 65 P0.08 67 | P0.09 68 | P0.10 69 | P0.11 70 | P0.12 72 | P0.13 73 | P0.14 74 | P0.15 75 | P0.16 77 | P0.17 78 | P0.18 79 | P0.19 80 | U1

### nRF9151-LACA

1

1 | 2
2 | J3
| 5V charging input
1 | 2 C9
100nF
1 | 2 R5
100k

1

1 | 2
2 | 3
3 | 4
4 | 5
5 | 6
6 | J7 SWD / debug

1

1 | 2
2 | 3
3 | 4
4 | 5
5 | J6

### eSIM interface / SKU TBD

1 | 2 C10
100nF

1

1 | 2
2 | 3
3 | 4
4 | 5
5 | 6
6 | 7
7 | 8
8 | 9
9 | 10
10 | 11
11 | 12
12 | J5 DIGITAL health sensor interface
1 | 2 R4
1k | GND
1 VEN
2 | VCC
3 | RF_IN
5 | FILT_OUT | 7 AMP_IN
8 RF_OUT | 10 U2

### SKY65943-11

1 | 2 C12 DNP / tune
1 | 2 C11 DNP / tune
1 | 2 R3

### 0R / tune

1 | 2 C15
100nF
1 | 2 C16
1uF

1

1 | 2
2 | J2 GNSS antenna / passive
1 | 2 C14

### 39pF RF

1 | 2 C13

### 39pF RF

1 | 2 L1
9.1nH

VDD_NRF

I2C_SCL | GND

FILT_OUT

VIN_5V | GND

GPS_RF

VIN_5V

GNSS_FEM_OUT

GND

# LTE_ANT GNSS_FEM_IN

VSYS | GNSS_ANT
ISET | GND

GND

GND

GNSS_ANT

ILIM_VSET

GND

GND

GND

VIO_1V8

I2C_SDA | VIO_1V8

GND

VIO_1V8

VIO_1V8

GND

GND

GND

VIO_1V8

LTE_RF

VIO_1V8

LTE_ANT

I2C_SDA

I2C_SCL

LTE_RF | GND

VIO_1V8

LTE_ANT

VIO_1V8

GNSS_FEM_IN

GND

VIO_1V8

CHG_STAT

GNSS_LNA_EN | AMP_IN

VBAT

VIO_1V8 | GNSS_FEM_OUT

GND

FILT_OUT VDD_NRF DEBUG_RESET

CHG_FAULT

GND

GND

COEX0 | GNSS_LNA_EN

VIO_1V8

VIO_1V8 BAT_ADC | GND
HEALTH_RESET VIO_1V8 | HEALTH_EN

VDD_NRF

GND | HEALTH_EN | GND

GND

VIO_1V8 | DEBUG_RESET HEALTH_CS

VIO_1V8

SWDIO

GND

SIM_CLK

SIM_IO

I2C_SCL | GND

VIO_1V8

VIO_1V8 | GND

NRF_ENABLE SIM_RST

SIM_RST ACC_INT

VSYS | GND
| SWDCLK

VSYS

VSYS

SIM_1V8

GND

VIO_1V8

NRF_RESET

BAT_ADC

GND

GND

VIO_1V8

VSYS

I2C_SDA

BAT_ADC

I2C_SCL

VBAT

HEALTH_INT SPI_SCK

SPI_MOSI

DEC0

SPI_MISO

HEALTH_CS

VSYS

GNSS_LNA_EN

GND

ISET

ILIM_VSET

GND

GND

VIN_5V | GND

BAT_NTC

VIO_1V8 HEALTH_CS HEALTH_RESET HEALTH_EN

CHG_STAT

VSYS | GND

NRF_ENABLE

VBAT

CHG_FAULT BAT_ADC

BAT_NTC

GND
CHG_STAT VBAT VSYS CHG_FAULT
GND NRF_RESET | GND

GND

VDD_NRF | GND

GND

VDD_NRF

VSYS

VSYS DEC0

VIO_1V8

# VDD_NRF SIM_1V8

SWDIO

ACC_INT HEALTH_INT SPI_SCK

SPI_MOSI SPI_MISO

SWDCLK NRF_RESET NRF_ENABLE

AMP_IN

COEX0 GPS_RF

VIN_5V

GND

LTE_RF SIM_IO

SIM_CLK

I2C_SDA

SIM_1V8

# REFERENCE DECOUPLING / NOT A COMPLETE RF LAYOUT

Reserved pins 31-33 and 81-104: electrically unconnected. SIM_DET is not supported. No external pull-up on nRESET.

# 02 / LTE AND GNSS FRONT END

GPS and cellular do not receive/transmit concurrently. GNSS RF ESD, matching and body/enclosure tuning remain open. No NTN/B255 requirement in this draft.

HOLD: add/verify hardware undervoltage cutoff (VDD >=3.0V), VDD_GPIO startup/shutdown sequencing, charging-input protection, and battery/NTC ratings before layout release. BQ25185 internal battery cutoff alone is insufficient for nRF9151. BAT_ADC: allow divider/filter settling; do not sample immediately.

# 05 / eSIM AND DEBUG INTERFACES

J6 is NOT a purchasable eSIM or its footprint. Select 1.8V eUICC + carrier profile, then map

these signals to its actual package pins. SIM_1V8 must remain separate from VIO_1V8. ENGINEERING DRAFT 0.1 — NOT FOR FABRICATION

# Turkey / shared lightweight body / heart-rate feasibility pending

# 01 / MODEM, GNSS AND APPLICATION MCU

# 03 / POWER — FIRST CIRCUIT DRAFT

Digital interface only — not an electrode connection. PPG/ECG measurement head, power switching and protection must be designed and validated separately. No heart-rate sensor selected; no heart-rate accuracy claim. | Reset has an internal 2.2V pull-up.

Debug reset driver: open drain, compatible voltage. No external reset pull-up.

# 04 / MOTION AND HEART-RATE EXPANSION
