gokselozgur5/pcb-design-collar-tracker/mechanical/universal-mount-r01/design-overview.pdf

C O L L A R T R A C K E R / U N I V E R S A L M O U N T R 0 1

# PCB, enclosure and adjustable collar attachment

Prototype CAD · actual design geometry · dimensions in millimetres

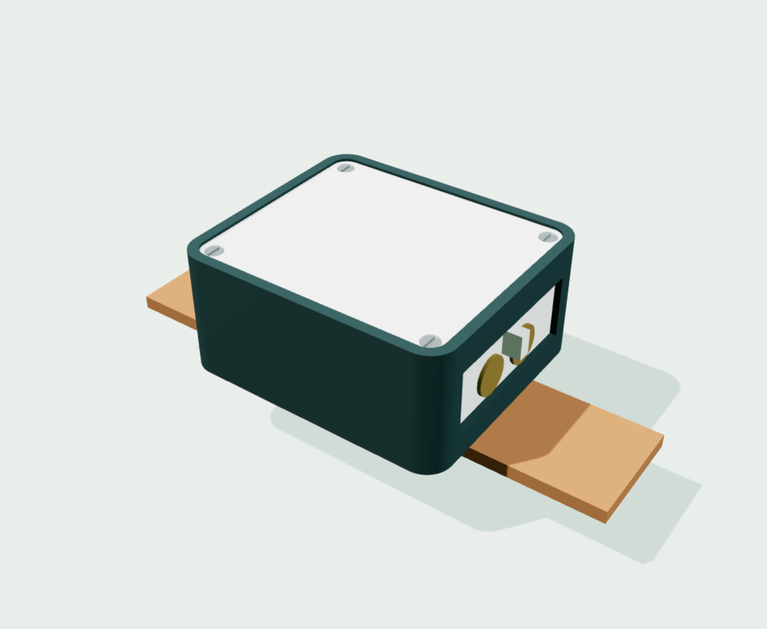
[picture p4: figure]

01 / ON THE COLLAR

Rigid housing 57.4 × 49.4 × 21 mm · outer holder 60.8 × 52.8 × 27.3 mm

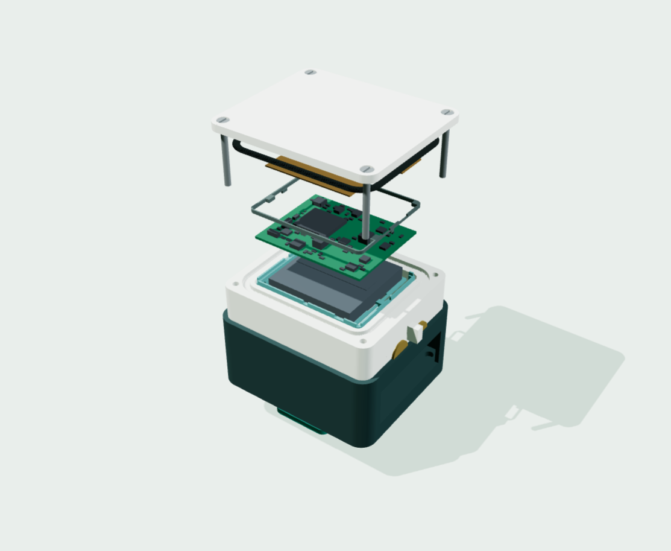
[picture p5: figure]

02 / INSIDE THE ENCLOSURE

Battery cradle · 40 × 32 mm PCB · antenna envelopes · gasket · lid

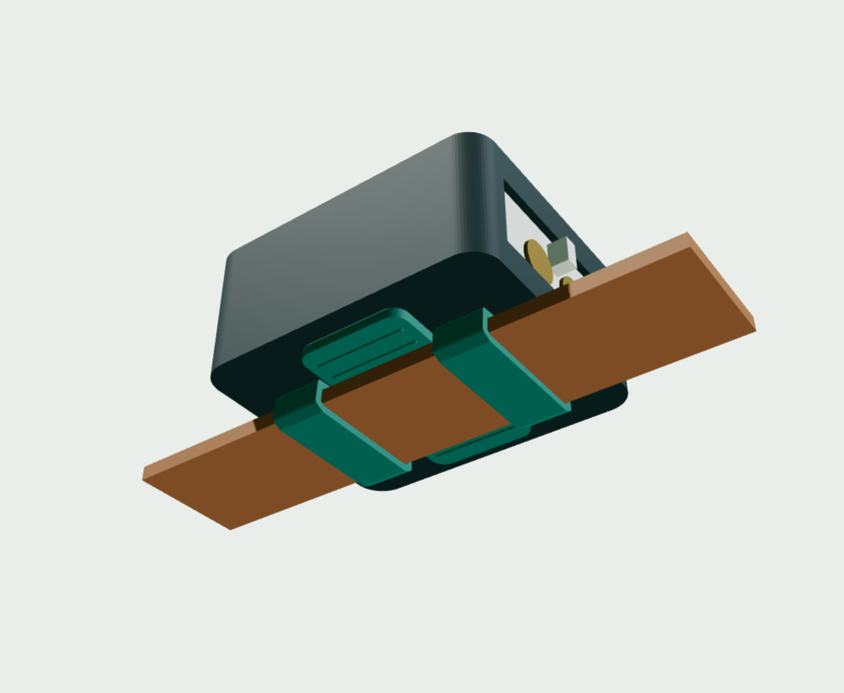
[picture p6: figure]

03 /ADJUSTABLE ATTACHMENT

Two wrap straps · flat or V-groove pad · 120 / 220 mm strap options

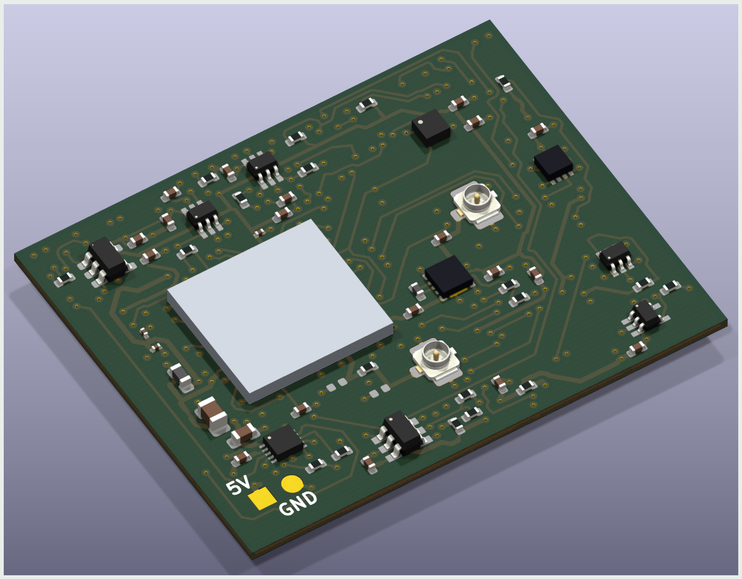
[picture p7: figure]

04 / CURRENT PCB

KiCad r05m render · four package bodies use dimensional substitutes

Checked examples: flat 8 × 1, 25 × 3, 60 × 8 mm; round Ø4, Ø8, Ø16 mm. Grip, comfort and IP68 need physical qualification.
