gokselozgur5/pcb-design-collar-tracker/mechanical/swim-r15-wire-clamp/wire-clamp-sheet.pdf

# CT-DOCK-001-C | Wire clamp and assembly fixture / r15

PROTOTYPE — geometry checked; clamp retention, dock holding and electrical release remain open

## External dry dock: 101.5 x 36 x 16mm

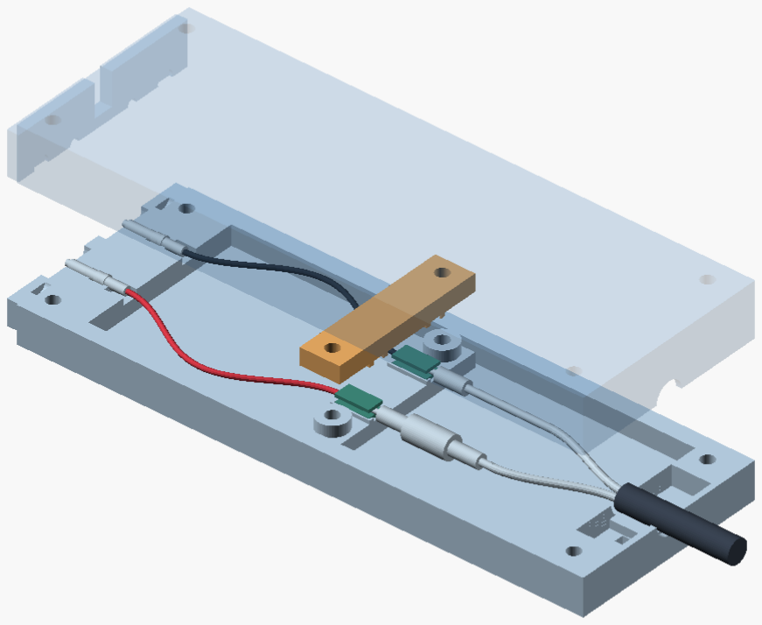
[picture p10: figure]

Wearable, PCB, key, seals and spring-contact seats unchanged.

## Clamp assembly (cap lifted for visibility)

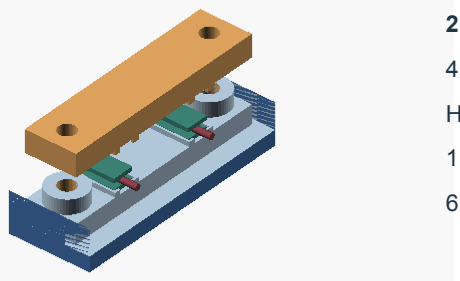
[picture p11: figure]

### 2 x M2 x 10

4 silicone pads
Hard-stop columns
1.93mm face gap
6 x 3mm pad outline

## Separate factory forming fixture

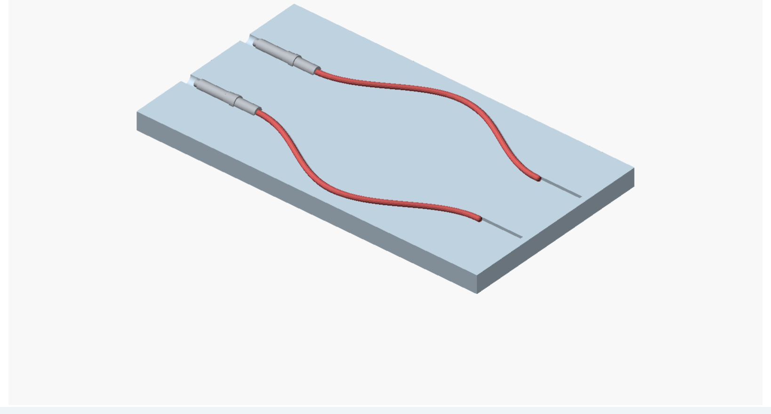
[picture p12: figure]

Free span / wire | 40.95 +/- 0.10mm at 23C
Fixed-end plane | X=49.00 +/- 0.10mm total
Sheet thickness | 0.7874 +/- 0.1016mm
Local pad displacement | 5.50..43.52% / assigned bounds
Housing / cap / fixture | Four closed CAD meshes
CAD collision checks | 5 clear / 3 contacts / 5 controls
PCB DFM | Unchanged: two runs at 0/0/455

The fixture controls assembly shape only. Free wires still require cycle tests. Squeeze is not a friction, insulation-strain or lifetime calculation.
Factory pull target: 5N / 60s per wire; no physical result exists.
Position error and later slip share the same +/- 0.10mm budget.

Open: latch, internal J3 route, pack approval, firmware and physical power/RF/water/dust testing. No order release.

2026-10-26 | Units: mm | See dock.json, sources.json, checks.json, mesh-checks.json and README | Review only
