gokselozgur5/pcb-design-collar-tracker/mechanical/swim-r12-pack-retention/pack-retention-sheet.pdf

# CT-BAT-RET-001-A | Battery capture / r12

CONDITIONAL PROTOTYPE — pack, contact regions, strength and ingress are not supplier-qualified

## Plan: cap and cradle

### Cap body: 34.4mm

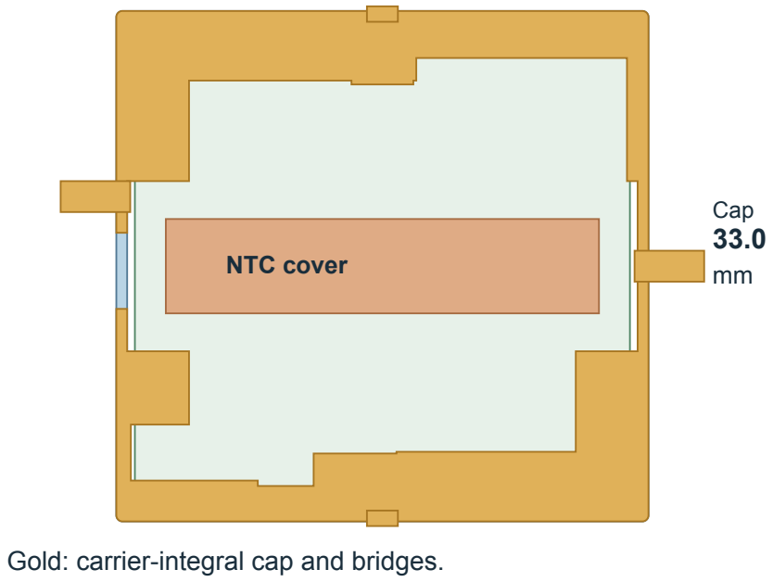
[picture p16: figure]
Cap 33.0 mm NTC cover; Gold: carrier-integral cap and bridges.

Blue: shell-integral cradle. Green: requested pack. Clearance cuts follow actual bottom-side parts.

## Vertical stack and limits

Pack support | Z=1.80mm; original shell floor
Maximum body top | Z=7.10mm seated
Cradle wall top | Z=7.10mm
Cap bearing / top | Z=7.56 / 8.31mm; 0.75mm thick
PCB support | Z=10.40mm; unchanged
Body max / min | 32 x 30.5 x 5.3 / 30.5 x 29 x 4.8mm
Component sweep | 85 parts; new-solid gap ≥0.225mm
Raised NTC cover | Gap to populated PCB ≥0.223mm
Capture regions | Four; minimum guaranteed area 1.429mm²
Rigid outside | 57.4 x 49.4 x 21.0mm + docking key
Material / process | PC candidate; physical capability unapproved

No rigid pouch preload or user soldering is intended.
Do not force the pack, carrier or lid into place.

Minimum pack dimensions and allowed bearing regions are added engineering requirements, not an approved supplier drawing. The raised-sensor check uses the shared carrier datum, independent component temperature and 0.10mm total feature error. Assigned CTE/tolerances are unchanged from r11. Pack/board tilt, loads, abrasion, cap strength and creep need physical checks. Factory lead exit, harness routing, contact termination, dock and programming/test remain unfinished. No order is authorized. The all-green PCB Gerber is unchanged. No physical water/dust test or IP68 approval is implied.

2026-10-26 | Units: mm | Actual plan geometry; dimensions govern | Review only | 1 / 1
