gokselozgur5/pcb-design-collar-tracker/mechanical/swim-r02-fit/drawing.pdf

# SWIM-r02 / DIMENSIONED PROTOTYPE

Nominal CAD plus controlled seal dimensions • CNC/process and material approval required before manufacture

### TOP VIEW / LID REMOVED

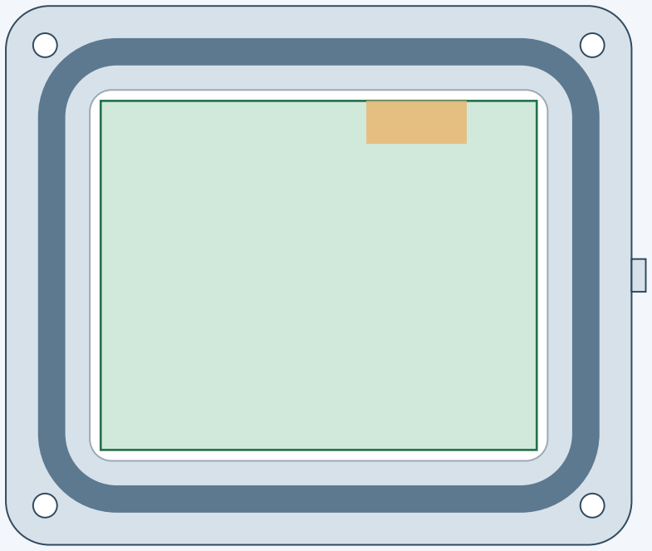
[picture p17: figure]

57.4 body width; 58.7 with key

49.4 body depth • R4 outer corners
42 × 34 cavity, R2 • PCB 40 × 32
4 × Ø2.2 at (±25.1, ±21.1)
Orange: SIM lane; lift tray for card service

### MAIN LID SEAL / SECTION

LID

BODY

1.34

2.50 ±0.05
Depth 1.34 ±0.02; local flatness budget 0.01 Centerline 49 × 41, R6; bottom corner R0.2
O-ring 50.52 ID × 1.78 section, EPDM 70A
Declared squeeze: 17.7–28.8%; fill: 62.6–83.2% Seal face Ra ≤0.8 µm; no burrs or crossing tool marks

SEALED CHARGING TARGET / CUSTOM TURNED PART

Head Ø8.5 × 0.8 | Shaft Ø7.28 × 7.70 | Rear M3 × 0.5 thread, 3.50 long
Radial gland root Ø4.64 ±0.01; width 2.80 ±0.05; center 3.85 behind head
Housing bore Ø7.34 ±0.02; seal ID 4.50 ±0.10 × section 1.80 ±0.08
Centers at Y=±6, Z=5.5 on +X wall. +Y is +5 V; −Y is GND.

Contact coating, edge finishing, retention, dock parts and electrical/immersion durability require prototype qualification.

2026-10-25 | Dimensions in mm. Diagrams are not print-scale. STL files are 1:1. | Prototype / no IP qualification
