gokselozgur5/pcb-design-collar-tracker/previews/compact-250-review.pdf

# 38 × 30 × 14 mm target body

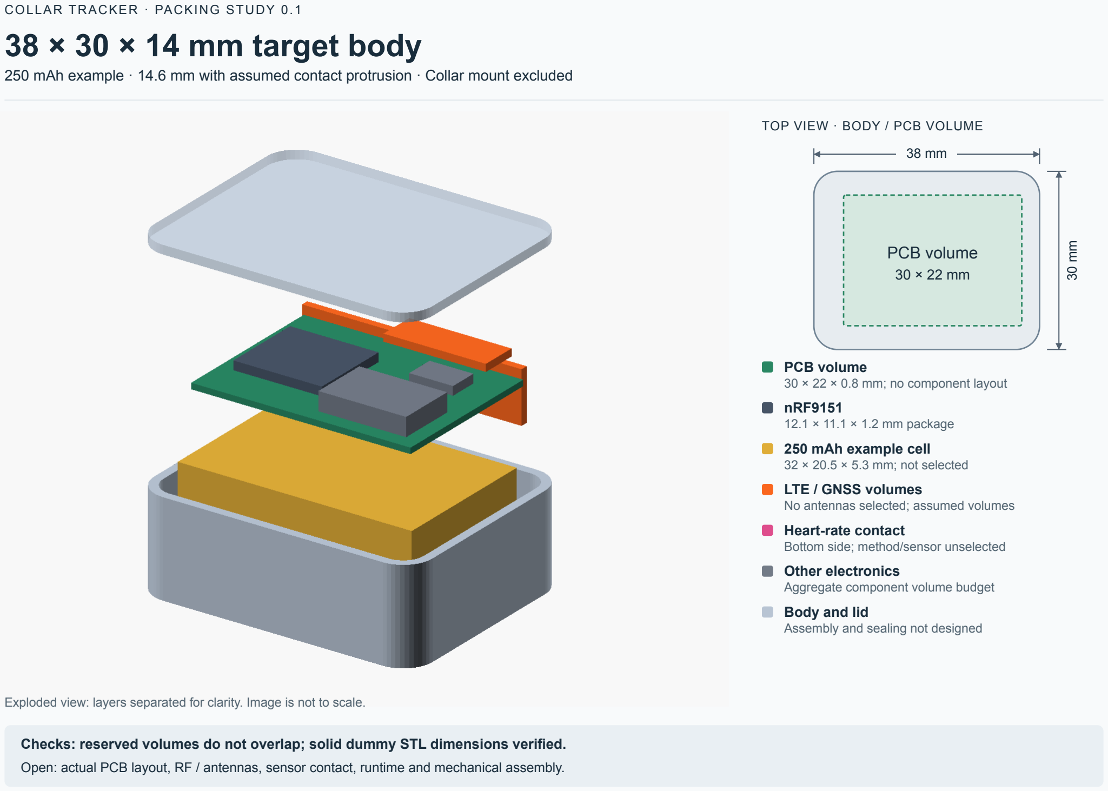
[picture p18: page 1]

CO L LAR TRACKER · PACKING STUDY 0. 1

250 mAh example · 14.6 mm with assumed contact protrusion · Collar mount excluded

Exploded view: layers separated for clarity. Image is not to scale.

TOP VIEW · BODY / PCB VOLUME

## PCB volume

30 × 22 mm

38 mm

30 mm

PCB volume
30 × 22 × 0.8 mm; no component layout nRF9151
12.1 × 11.1 × 1.2 mm package
250 mAh example cell
32 × 20.5 × 5.3 mm; not selected
LTE / GNSS volumes
No antennas selected; assumed volumes Heart-rate contact
Bottom side; method/sensor unselected Other electronics
Aggregate component volume budget Body and lid
Assembly and sealing not designed

Checks: reserved volumes do not overlap; solid dummy STL dimensions verified. Open: actual PCB layout, RF / antennas, sensor contact, runtime and mechanical assembly.
