gokselozgur5/pcb-design-collar-tracker/release/r16-current-review/pcb-review.pdf

# COLLAR TRACKER / VERIFIED PCB

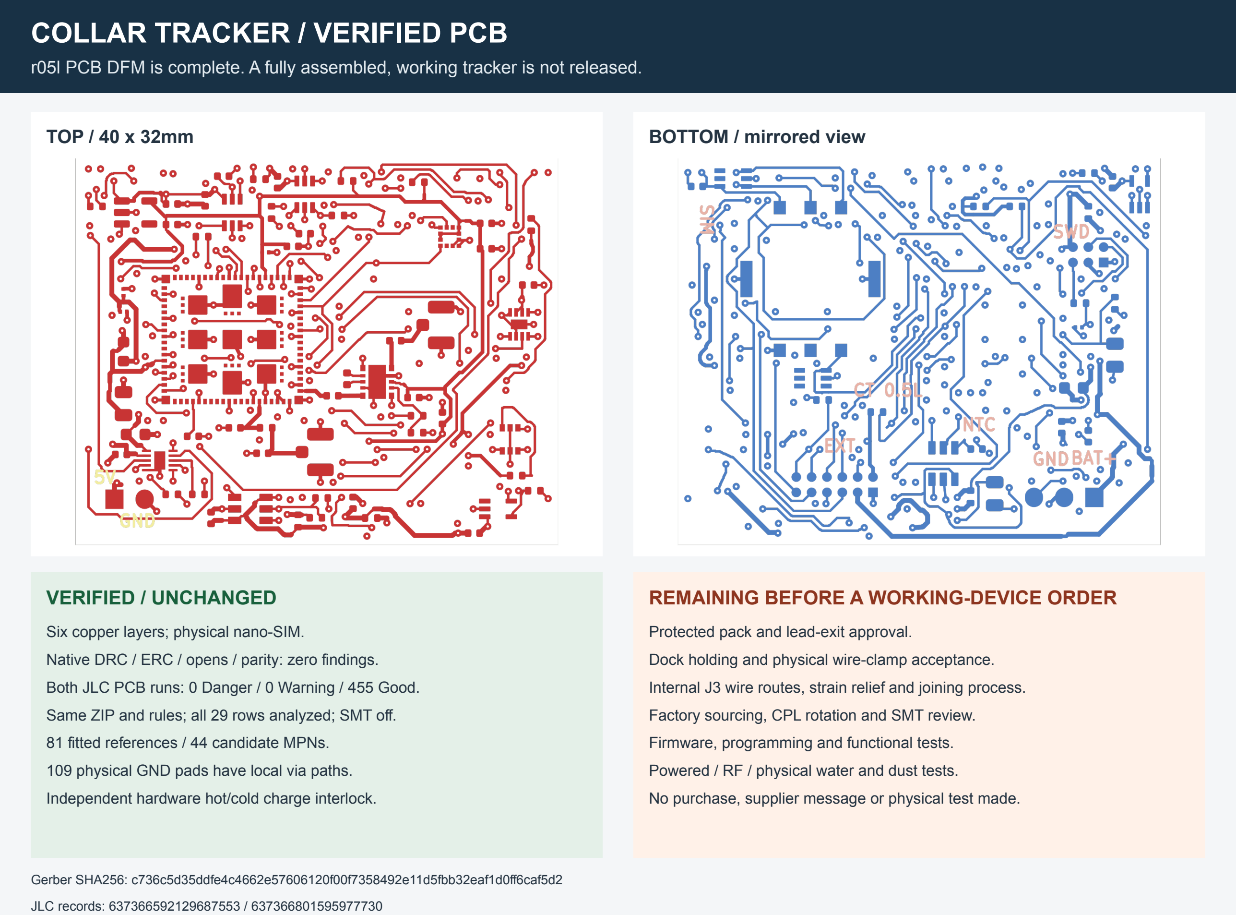
[picture p19: page 1]

r05l PCB DFM is complete. A fully assembled, working tracker is not released.

TOP / 40 x 32mm | BOTTOM / mirrored view

### VERIFIED / UNCHANGED

Six copper layers; physical nano-SIM.
Native DRC / ERC / opens / parity: zero findings.
Both JLC PCB runs: 0 Danger / 0 Warning / 455 Good. Same ZIP and rules; all 29 rows analyzed; SMT off. 81 fitted references / 44 candidate MPNs.
109 physical GND pads have local via paths. Independent hardware hot/cold charge interlock.

### REMAINING BEFORE A WORKING-DEVICE ORDER

Protected pack and lead-exit approval.
Dock holding and physical wire-clamp acceptance.
Internal J3 wire routes, strain relief and joining process. Factory sourcing, CPL rotation and SMT review. Firmware, programming and functional tests.
Powered / RF / physical water and dust tests.
No purchase, supplier message or physical test made.

Gerber SHA256: c736c5d35ddfe4c4662e57606120f00f7358492e11d5fbb32eaf1d0ff6caf5d2

JLC records: 637366592129687553 / 637366801595977730
