gokselozgur5/pcb-design-collar-tracker/release/r05l-review/pcb-review.pdf

# COLLAR TRACKER / r05l PCB REVIEW

Charge interlock implemented. Two clean PCB DFM reports; assembled release remains on hold.

TOP / native copper and silkscreen | BOTTOM / mirrored component view

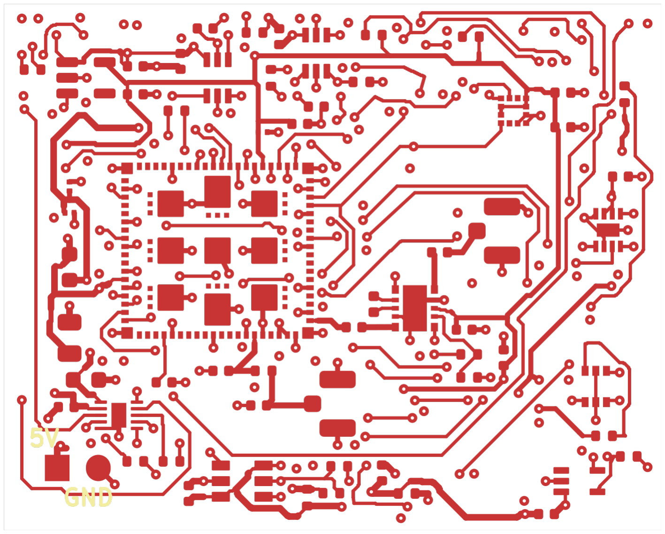
[picture p23: figure]

### VERIFIED PCB

40 × 32 mm / six Cu layers / 87 footprints
Native DRC, ERC, connectivity and parity: zero findings Two JLC runs: 0 Danger / 0 Warning / 455 Good each Same ZIP, same rules, all 29 rows analyzed; SMT off
81 fitted references / 44 exact candidate MPNs
109 physical GND pads have local paths to vias
Two GND planes; 154/154 signal-via return screens pass

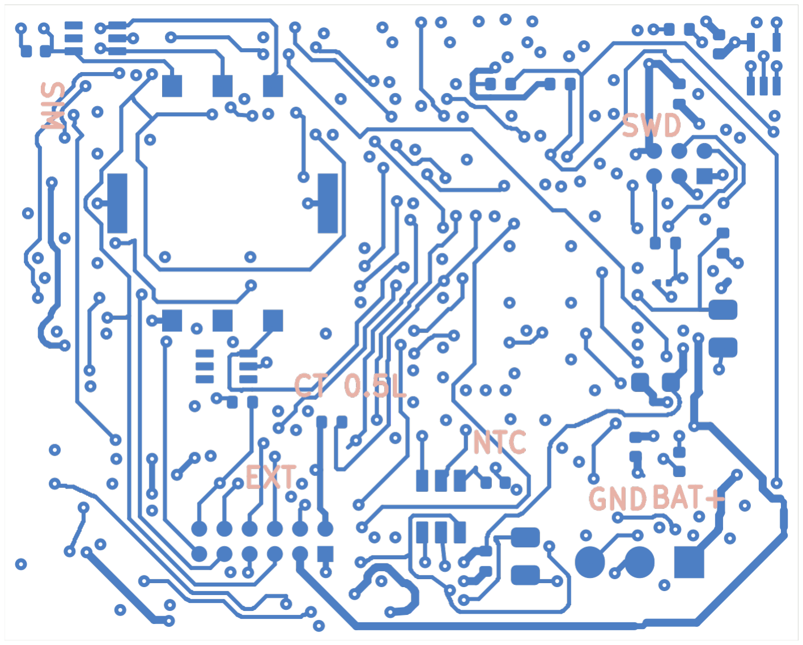
[picture p24: figure]

### REQUIRED BEFORE WORKING DELIVERY

Charge window is implemented; corner model is conditional. Thermal coupling, startup and fault transients need tests. Protected pack, NTC attachment and antennas: open. Firmware and factory programming/functional test: open. Procurement, CPL rotations and SMT acceptance: open. No physical powered, RF or water/dust result exists. This package is for review; it is not an order release.

PCB SHA256: 241c84d6ba98793c37344e1e46ddc4918e7b05322ba87daea7c9a90ffb8379b3

JLC records: 637366592129687553 / 637366801595977730
