gokselozgur5/pcb-design-collar-tracker/release/collar-tracker-0.3.4-jlc-dfm-report.pdf

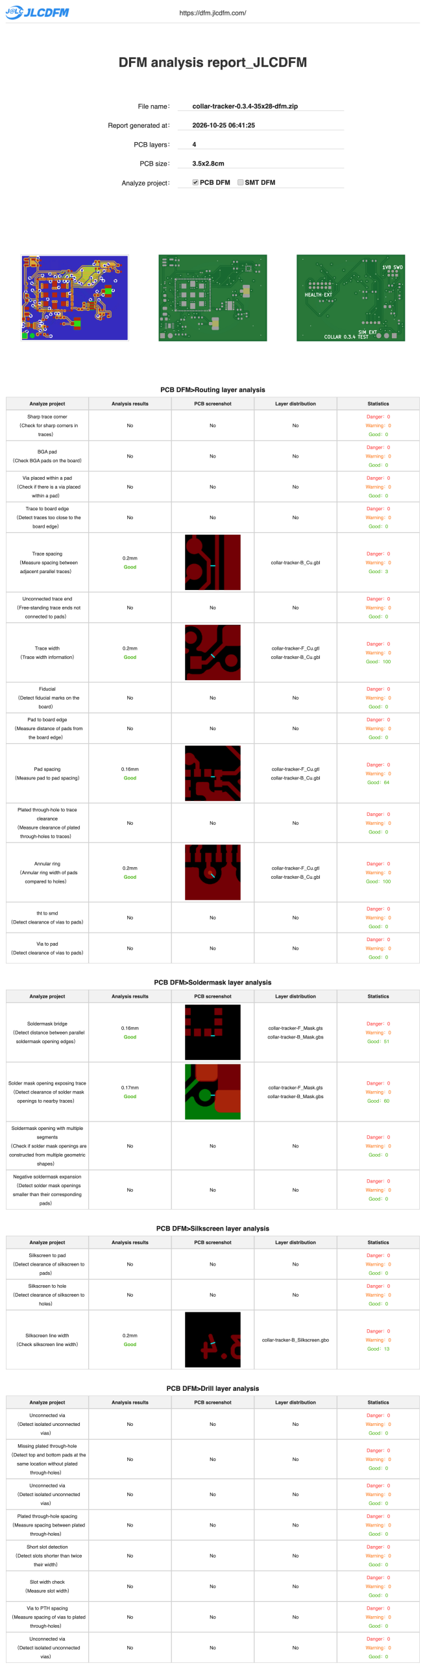
[picture p25: page 1]
