gokselozgur5/pcb-design-collar-tracker/release/collar-tracker-0.3.3-jlc-dfm-report.pdf

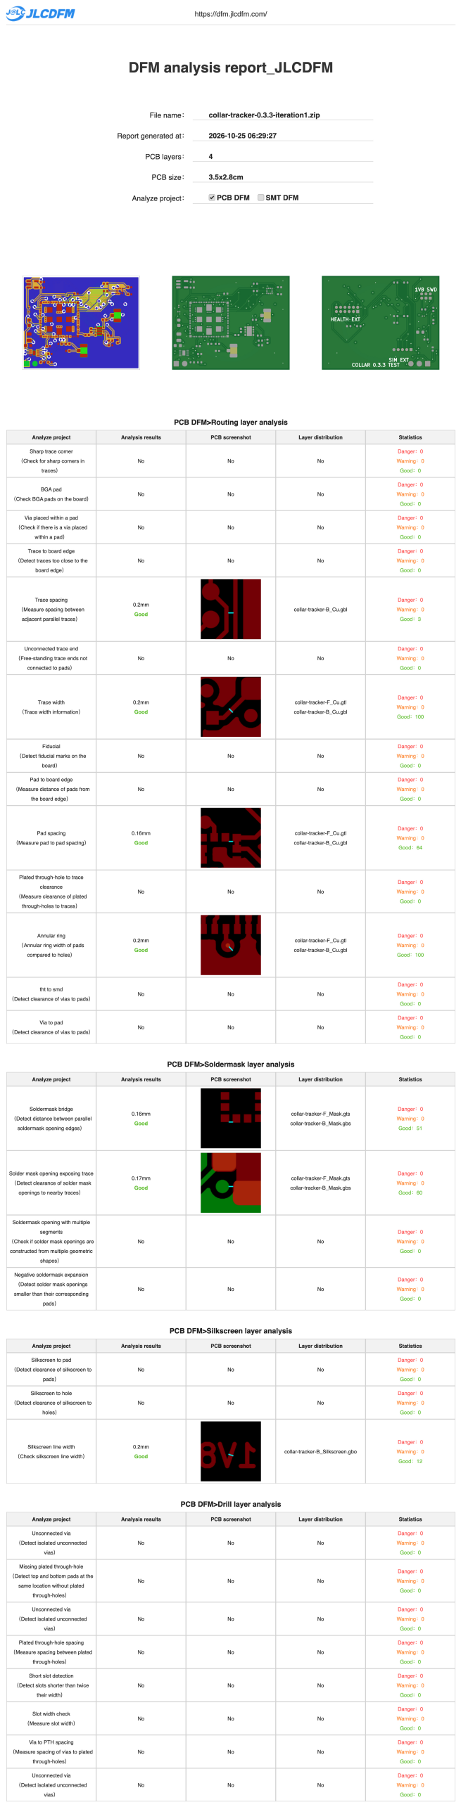
[picture p26: page 1]
