gokselozgur5/pcb-design-collar-tracker/assembly/pcba-r04/diagnostic-report.pdf

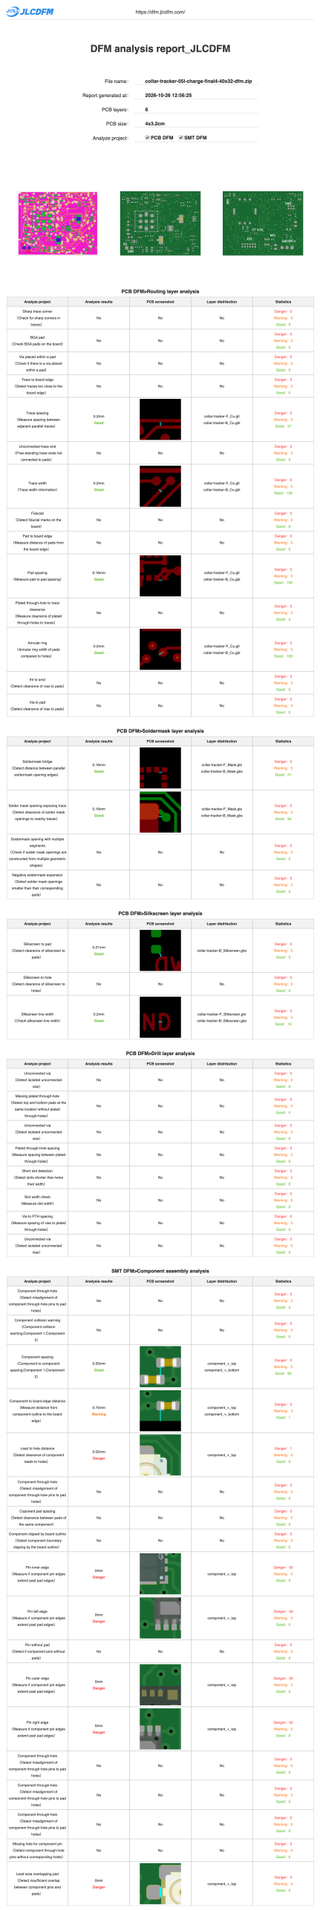
[picture p27: page 1]
