gokselozgur5/pcb-design-collar-tracker/assembly/pcba-r03/smt-report.pdf

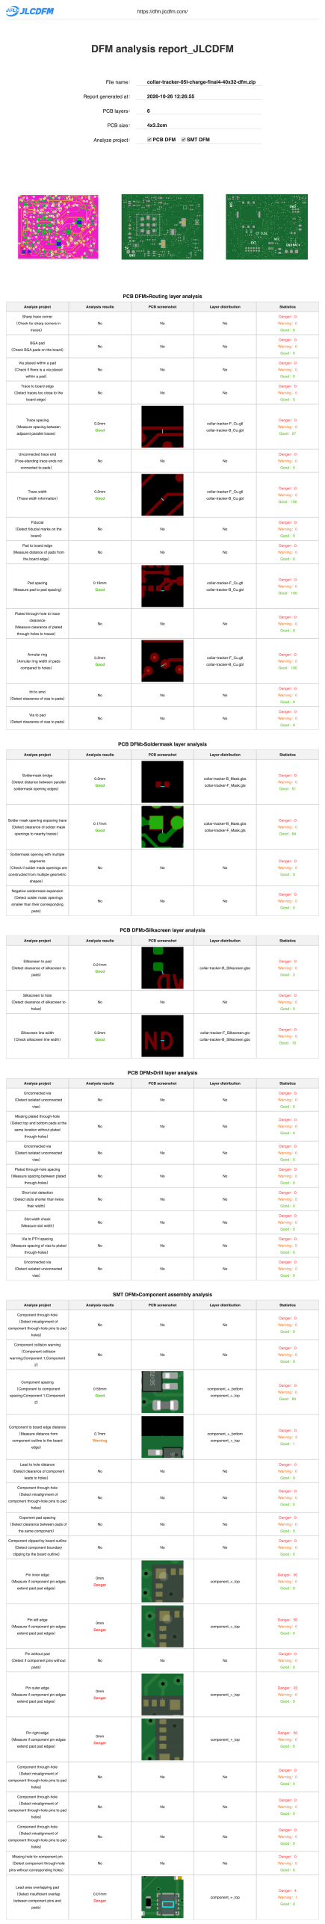
[picture p28: page 1]
