gokselozgur5/pcb-design-collar-tracker/experiments/power-r05l-charge-interlock/evidence/jlc-check1/report.pdf

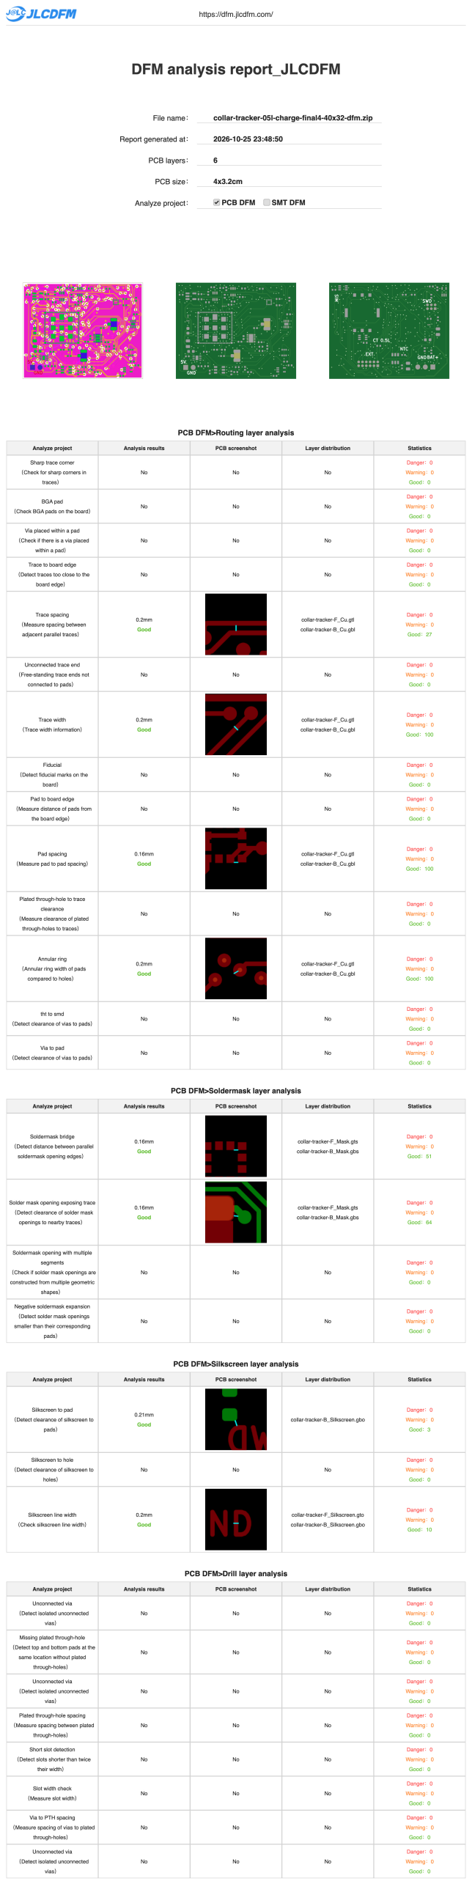
[picture p29: page 1]
