gokselozgur5/pcb-design-collar-tracker/experiments/power-r05l-charge-interlock/evidence/jlc-check2/report.pdf

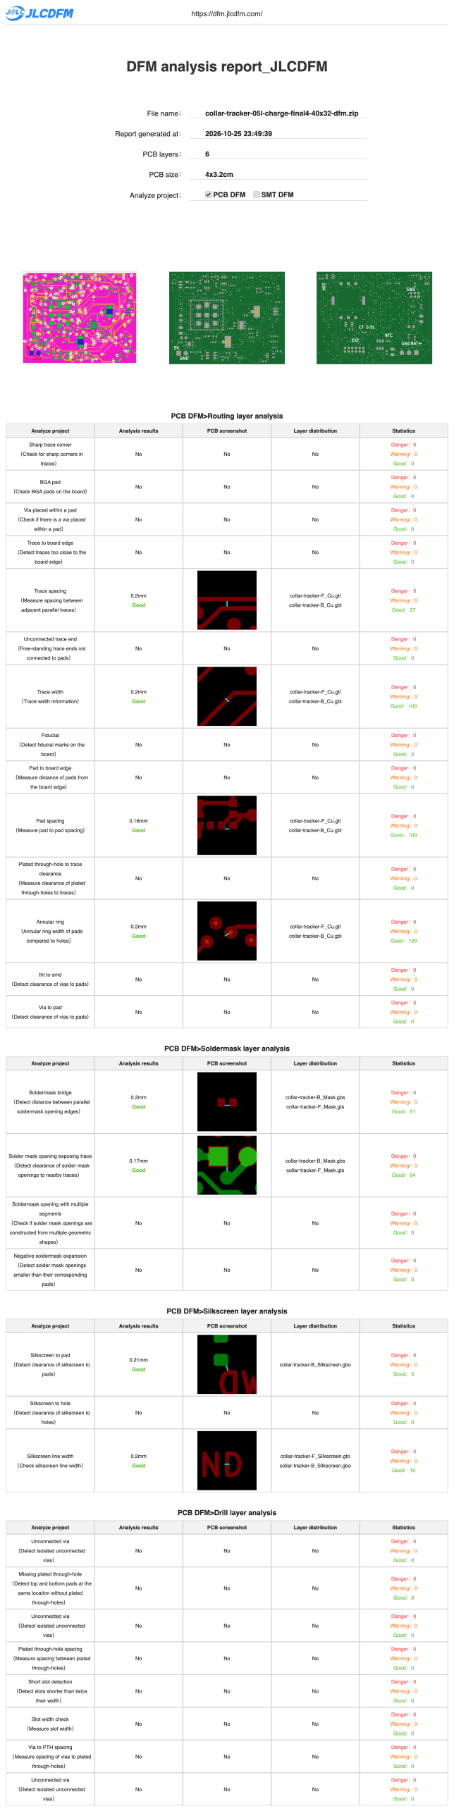
[picture p30: page 1]
