gokselozgur5/pcb-design-collar-tracker/experiments/power-r05l-charge-interlock/evidence/jlc-initial-findings/report.pdf

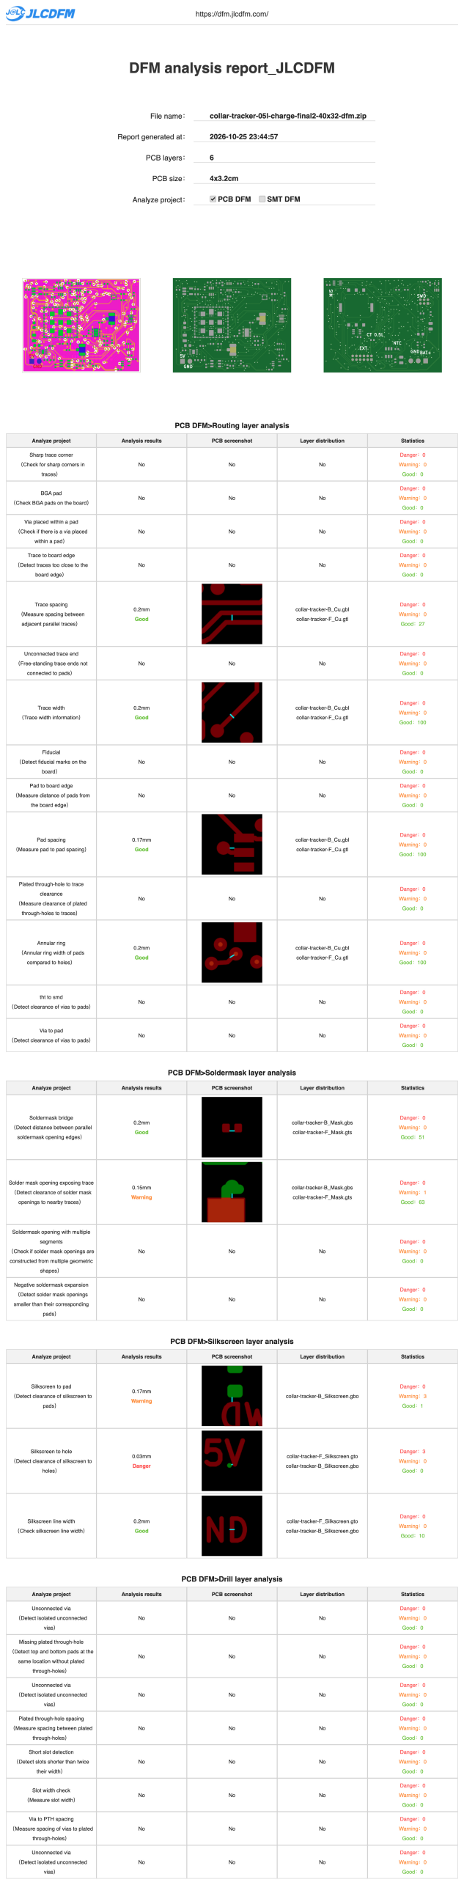
[picture p31: page 1]
