gokselozgur5/pcb-design-collar-tracker/release/r15-current-review/review.pdf

# COLLAR TRACKER / VERIFIED PCB

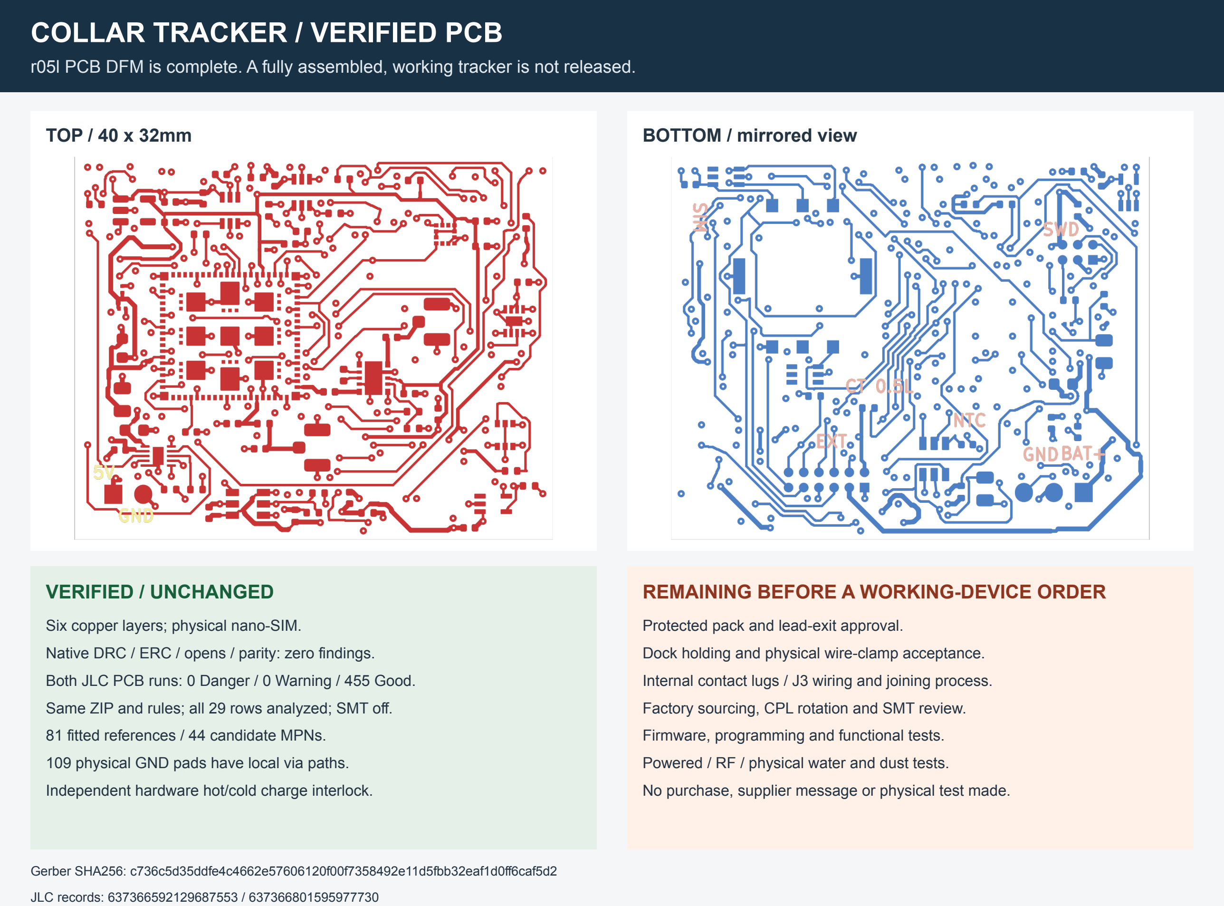
[picture p32: page 1]

r05l PCB DFM is complete. A fully assembled, working tracker is not released.

TOP / 40 x 32mm | BOTTOM / mirrored view

### VERIFIED / UNCHANGED

Six copper layers; physical nano-SIM.
Native DRC / ERC / opens / parity: zero findings.
Both JLC PCB runs: 0 Danger / 0 Warning / 455 Good. Same ZIP and rules; all 29 rows analyzed; SMT off. 81 fitted references / 44 candidate MPNs.
109 physical GND pads have local via paths. Independent hardware hot/cold charge interlock.

### REMAINING BEFORE A WORKING-DEVICE ORDER

Protected pack and lead-exit approval.
Dock holding and physical wire-clamp acceptance.
Internal contact lugs / J3 wiring and joining process. Factory sourcing, CPL rotation and SMT review. Firmware, programming and functional tests.
Powered / RF / physical water and dust tests.
No purchase, supplier message or physical test made.

Gerber SHA256: c736c5d35ddfe4c4662e57606120f00f7358492e11d5fbb32eaf1d0ff6caf5d2

JLC records: 637366592129687553 / 637366801595977730

# COLLAR TRACKER / CURRENT ASSEMBLY STUDY

Conditional geometry. Pack supplier response, factory assembly and physical validation remain open.

r12 / requested pack and retaining cap | r15 dry dock with separate wire clamp

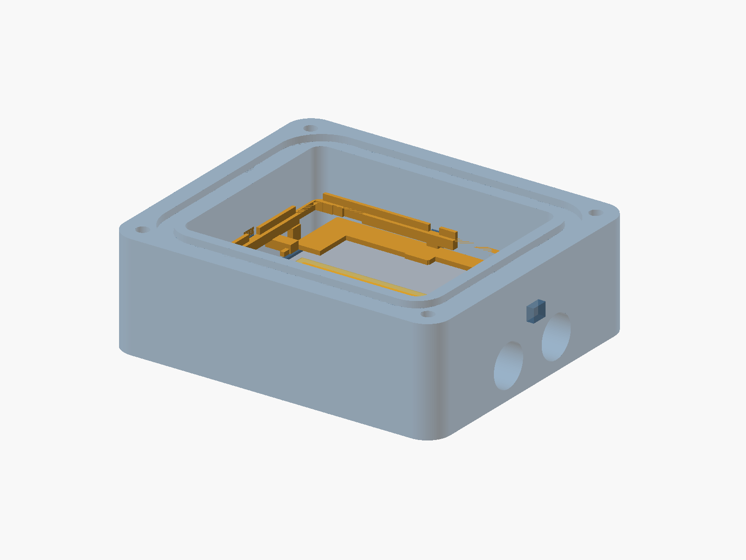
[picture p33: figure]

### CURRENT MODEL

Rigid shell + lid: 57.4 x 49.4 x 21.0mm.
Body including external key: 61.4mm in X. Boot: 60.4 x 52.4 x 25.8mm.
r12 carrier/cap; r11 lid, frame, boot and seals.
r13 shell/key; r15 dock: 101.5 x 36 x 16mm. Constant-length pigtails; continuous radius >=8.696mm. Separate padded clamp and factory forming fixture.


### LIMITS / DO NOT ORDER AS A FINISHED DEVICE

Requested pack: 32 x 30.5 x 5.3mm maximum.
That pack envelope is not supplier approved.
Free-wire geometry does not constrain real buckling. Contact holding, clamp pull and cycle tests remain open. Charging is a dry indoor prototype only.
IP68 is a target, not a certified or measured result.
2m fresh water / 60min is an engineering assumption.

Parts in this review are explicitly revision-mapped; previous releases remain preserved.

Open the repository STATUS / RESUME for the exact source, commands and remaining work.

### CT-DOCK-001-C | Wire clamp and assembly fixture / r15

PROTOTYPE — geometry checked; clamp retention, dock holding and electrical release remain open

External dry dock: 101.5 x 36 x 16mm


Wearable, PCB, key, seals and spring-contact seats unchanged.
Clamp assembly (cap lifted for visibility)


### 2 x M2 x 10

4 silicone pads
Hard-stop columns
1.93mm face gap
6 x 3mm pad outline

Separate factory forming fixture


Free span / wire | 40.95 +/- 0.10mm at 23C
Fixed-end plane | X=49.00 +/- 0.10mm total
Sheet thickness | 0.7874 +/- 0.1016mm
Local pad displacement | 5.50..43.52% / assigned bounds
Housing / cap / fixture | Four closed CAD meshes
CAD collision checks | 5 clear / 3 contacts / 5 controls
PCB DFM | Unchanged: two runs at 0/0/455

The fixture controls assembly shape only. Free wires still require cycle tests. Squeeze is not a friction, insulation-strain or lifetime calculation.
Factory pull target: 5N / 60s per wire; no physical result exists.
Position error and later slip share the same +/- 0.10mm budget.

Open: latch, internal J3 route, pack approval, firmware and physical power/RF/water/dust testing. No order release.

2026-10-26 | Units: mm | See dock.json, sources.json, checks.json, mesh-checks.json and README | Review only
