gokselozgur5/pcb-design-collar-tracker/release/r05k-review/review.pdf

# COLLAR TRACKER / r05k PCB REVIEW

Two clean PCB DFM reports. Working-device release remains on hold.

TOP / copper and silkscreen | BOTTOM / mirrored component view

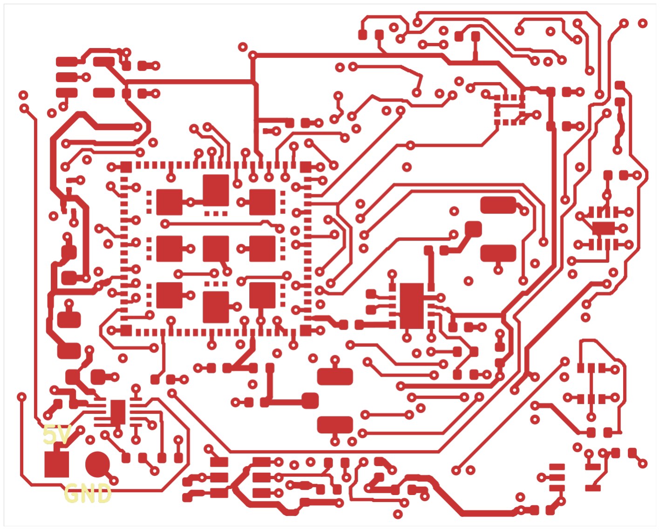
[picture p36: figure]

### VERIFIED PCB

40 × 32 mm / six Cu layers / 71 footprints
Native DRC, ERC, connectivity and parity: zero findings JLC: 0 Danger / 0 Warning / 450 Good in both runs Same ZIP, same rules, all 29 rows analyzed; SMT off 65 fitted references / 38 exact candidate MPNs
BOM, CPL, native KiCad and both reports included Two GND planes; inherited local return checks pass

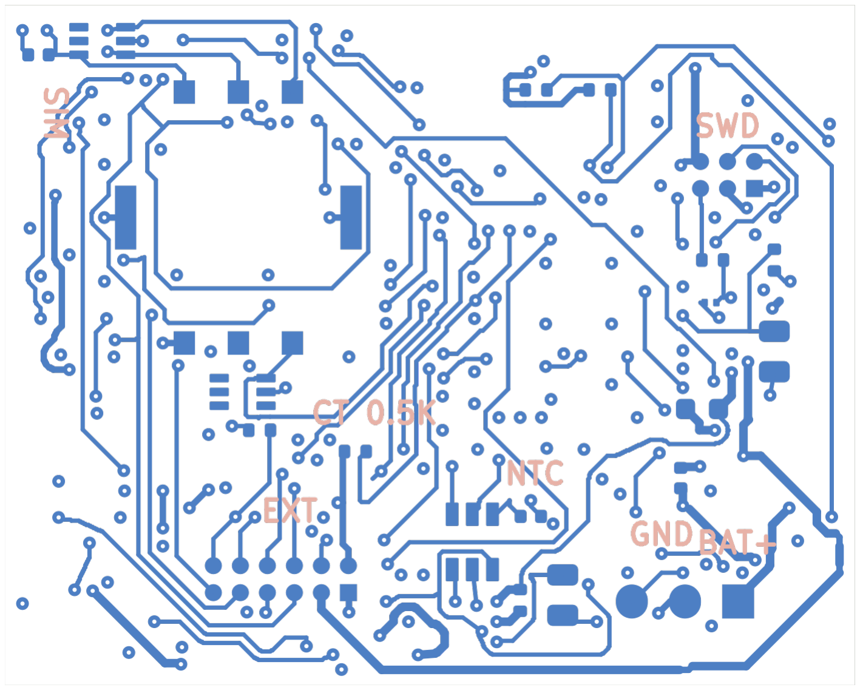
[picture p37: figure]

### REQUIRED BEFORE WORKING DELIVERY

Charging: direct 10k/B3435 NTC permits 50°C charging. Reviewed pack maximum: 45°C. /CE is tied to GND.
A cell-temperature charge interlock is not implemented. Protected pack, antennas, harness and retention: open. Firmware, factory programming and powered tests: open. Swimming/IP68: target only; no physical ingress test. This is a PCB review package, not an order release.

PCB SHA256: bea6c52a7f045b5fb21ac9714f3db0c70207f150aab3e9587b891f08e4e2b4d3
JLC records: 637356580811132930 / 637356797304328193 | 2026-10-25
