gokselozgur5/pcb-design-collar-tracker/evidence/release-034/check1/report.pdf

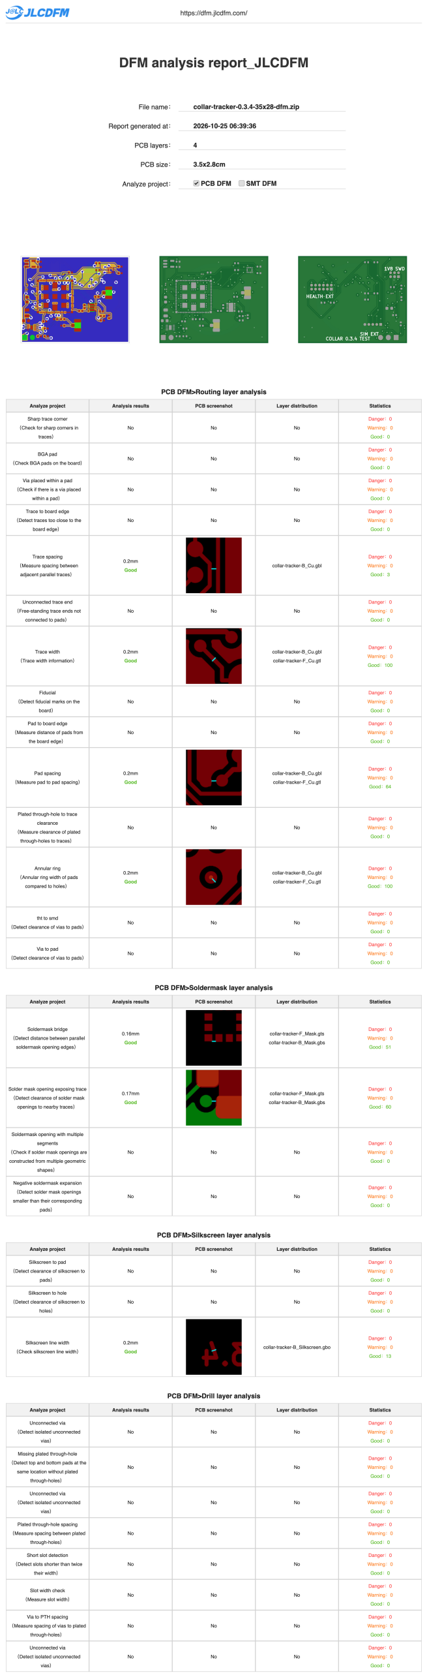
[picture p38: page 1]
