gokselozgur5/pcb-design-collar-tracker/experiments/power-r05k-selected-parts/evidence/jlc-check1/report.pdf

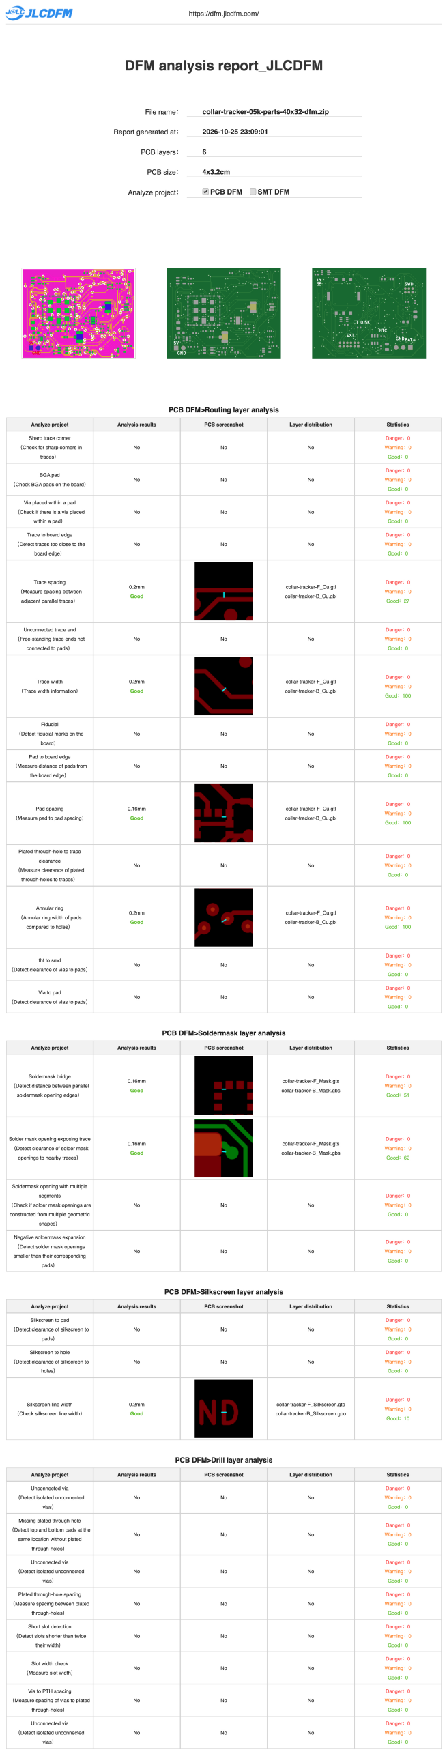
[picture p39: page 1]
