gokselozgur5/pcb-design-collar-tracker/experiments/power-r05k-selected-parts/evidence/jlc-check2/report.pdf

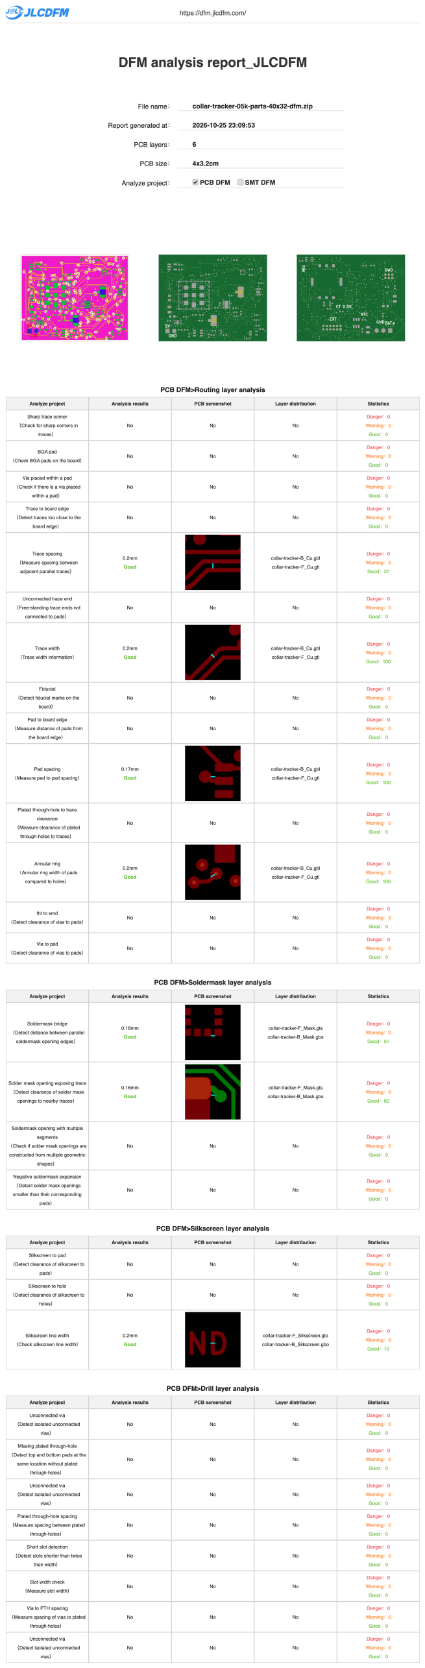
[picture p40: page 1]
