gokselozgur5/pcb-design-collar-tracker/experiments/power-r05j-rf-junctions/evidence/jlc-check1/report.pdf

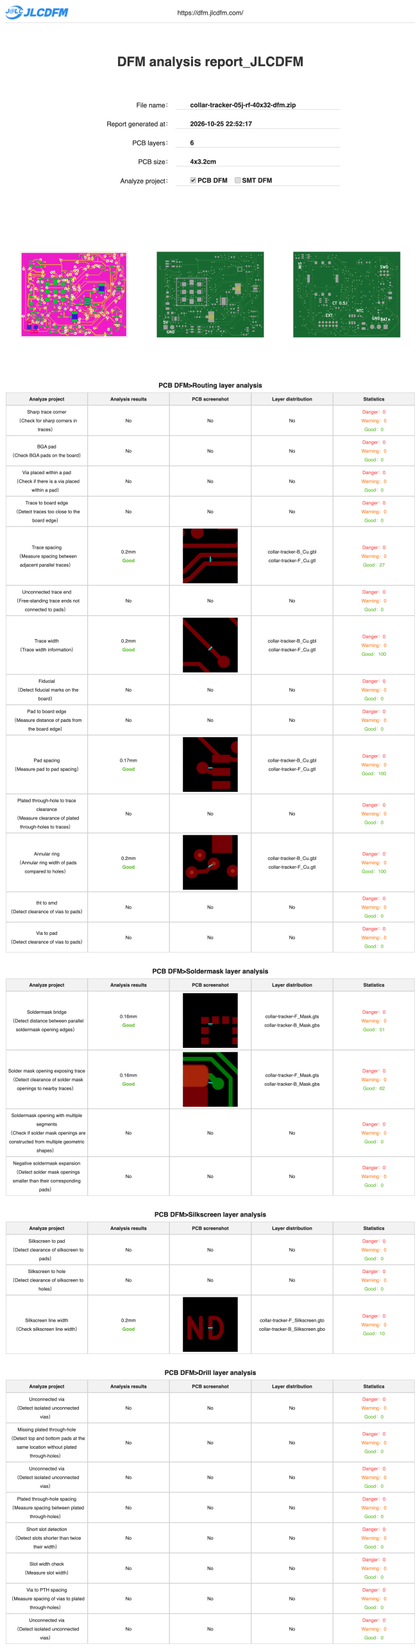
[picture p41: page 1]
