gokselozgur5/pcb-design-collar-tracker/experiments/power-r05j-rf-junctions/evidence/jlc-check2/report.pdf

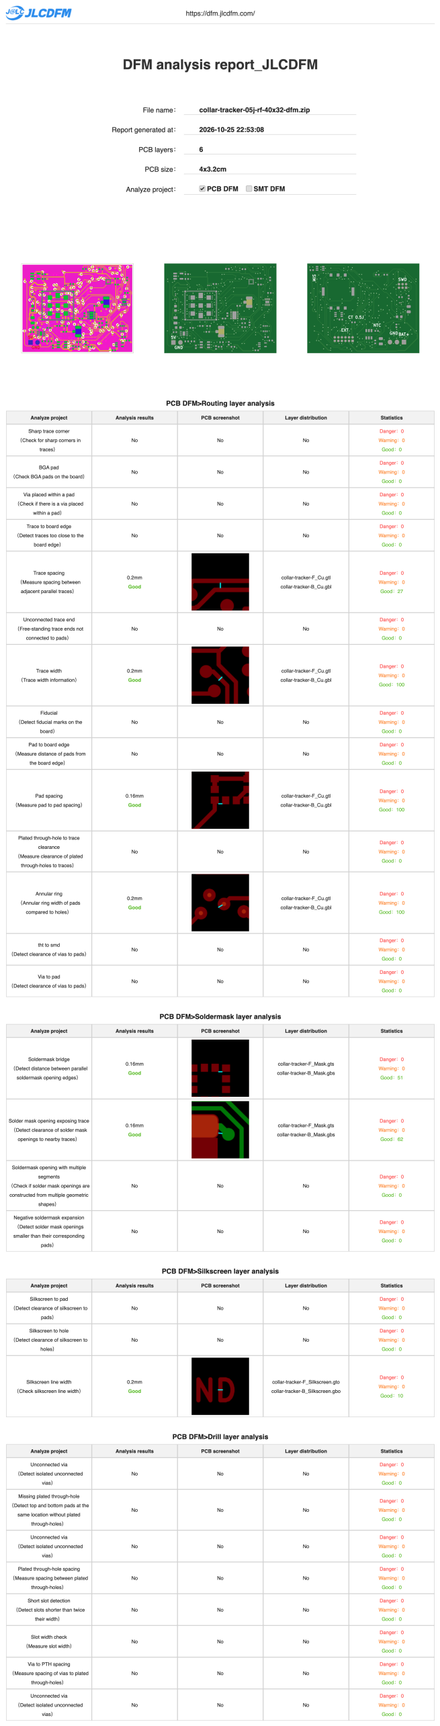
[picture p42: page 1]
