gokselozgur5/pcb-design-collar-tracker/experiments/power-r05i-rf-stack/evidence/jlc-check1/report.pdf

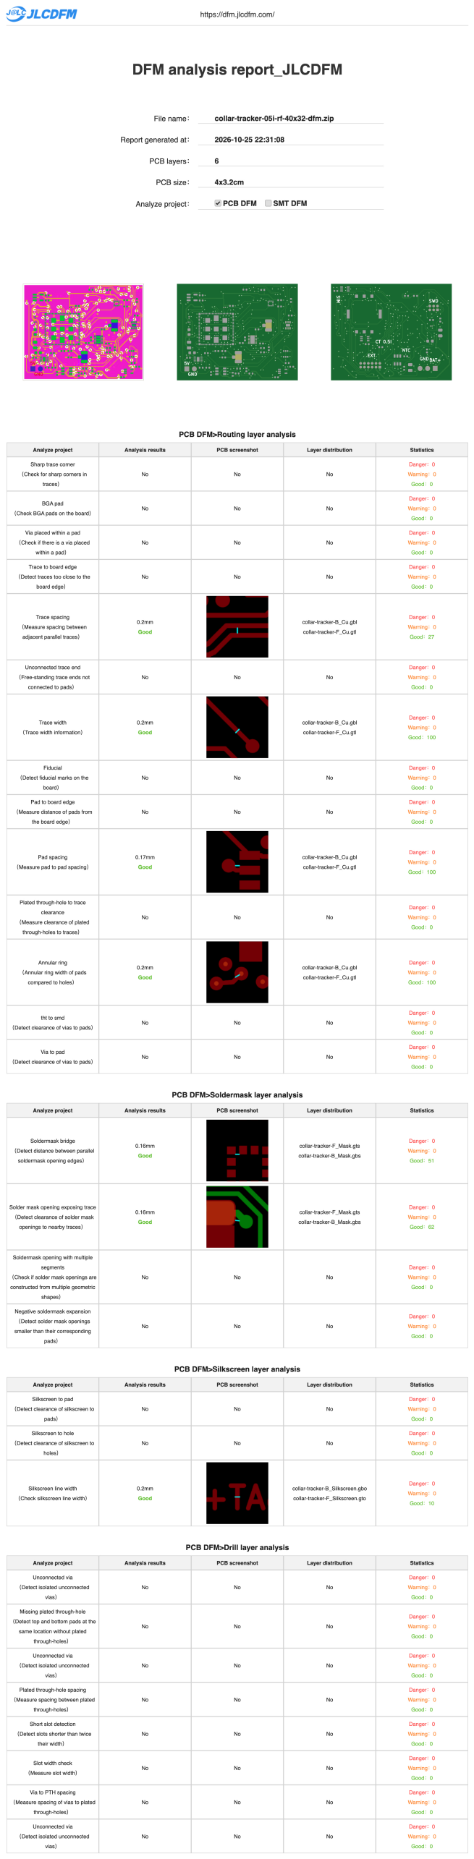
[picture p43: page 1]
