gokselozgur5/pcb-design-collar-tracker/experiments/power-r05i-rf-stack/evidence/jlc-check2/report.pdf

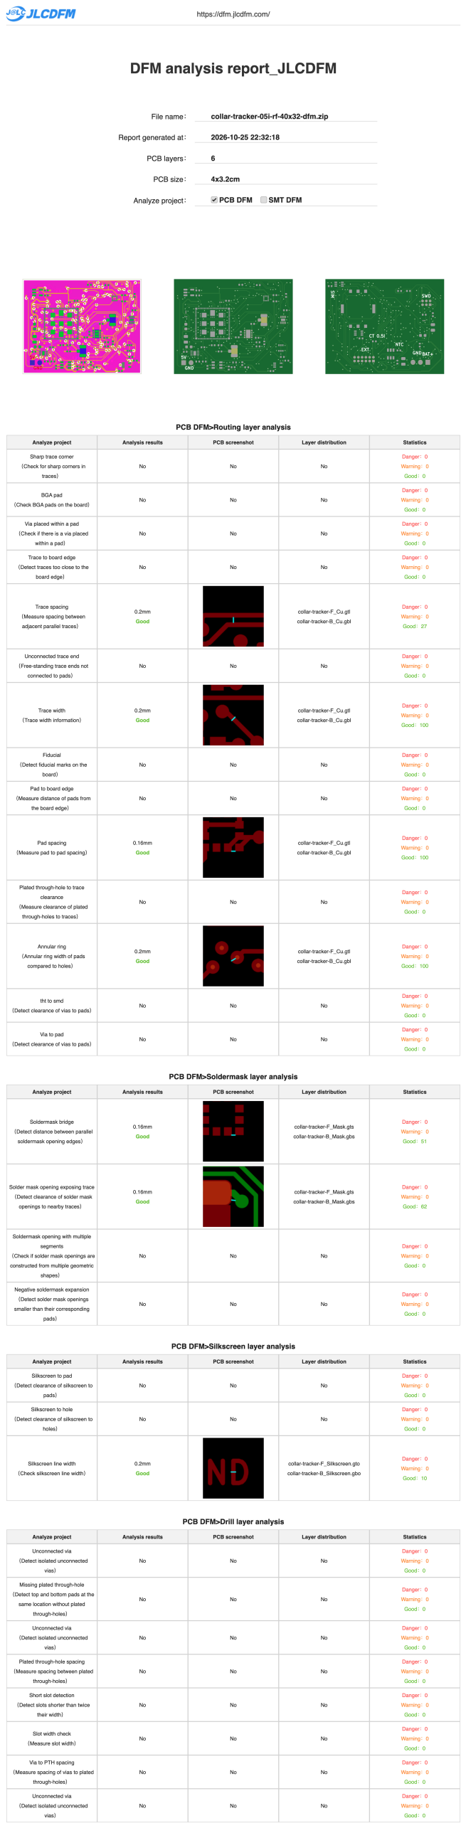
[picture p44: page 1]
