gokselozgur5/pcb-design-collar-tracker/experiments/power-r05h-six-layer/evidence/jlc-check1/report.pdf

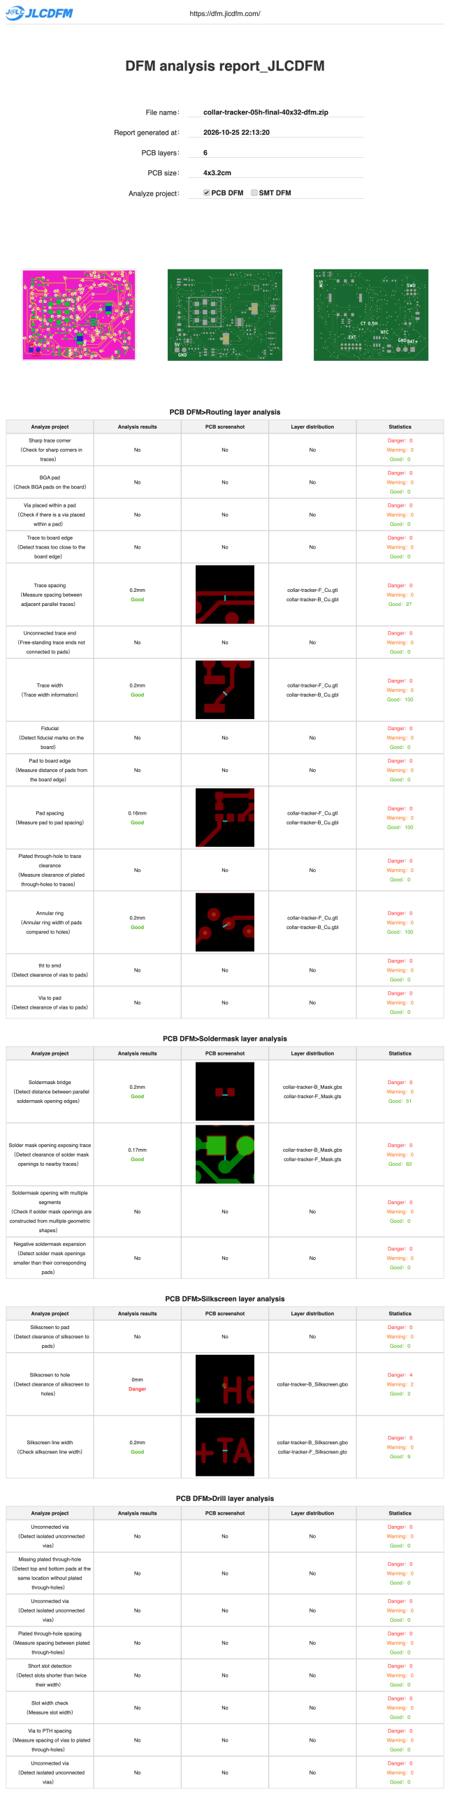
[picture p45: page 1]
