gokselozgur5/pcb-design-collar-tracker/experiments/power-r05h-six-layer/evidence/jlc-final-check1/report.pdf

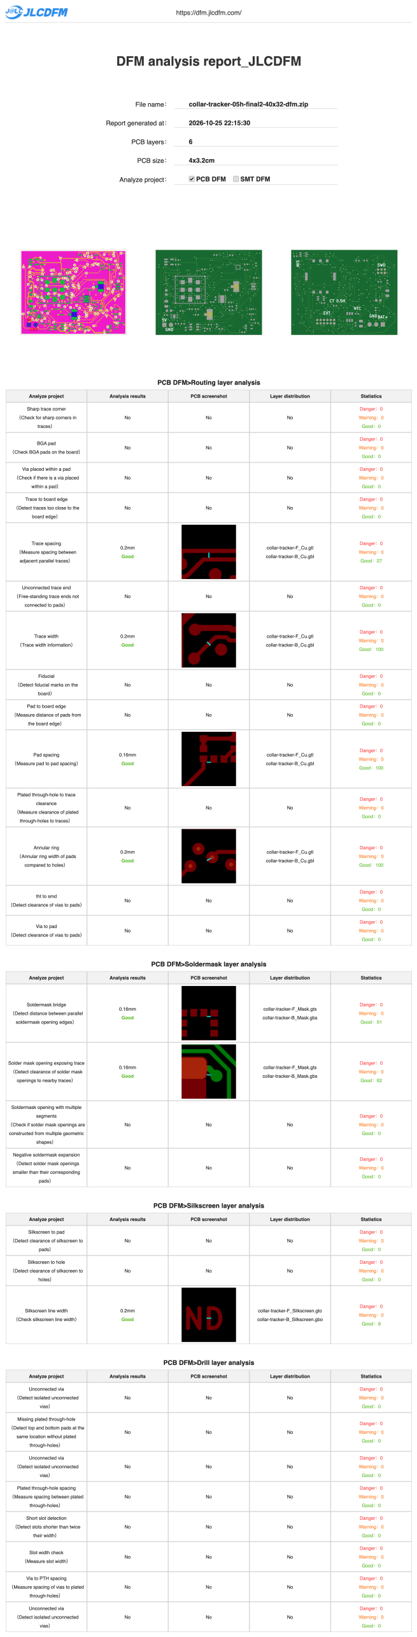
[picture p46: page 1]
