gokselozgur5/pcb-design-collar-tracker/experiments/power-r05h-six-layer/evidence/jlc-final-check2/report.pdf

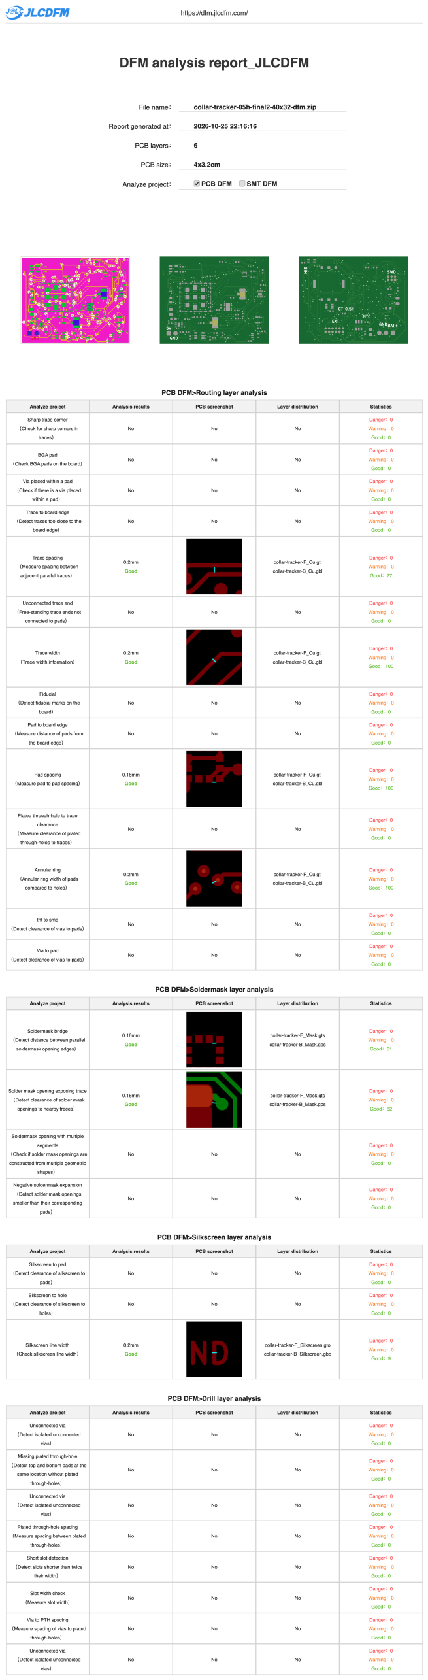
[picture p47: page 1]
