gokselozgur5/pcb-design-collar-tracker/experiments/paul-nanosim-r04i-sim-access-40x32/evidence/jlc-check1/report.pdf

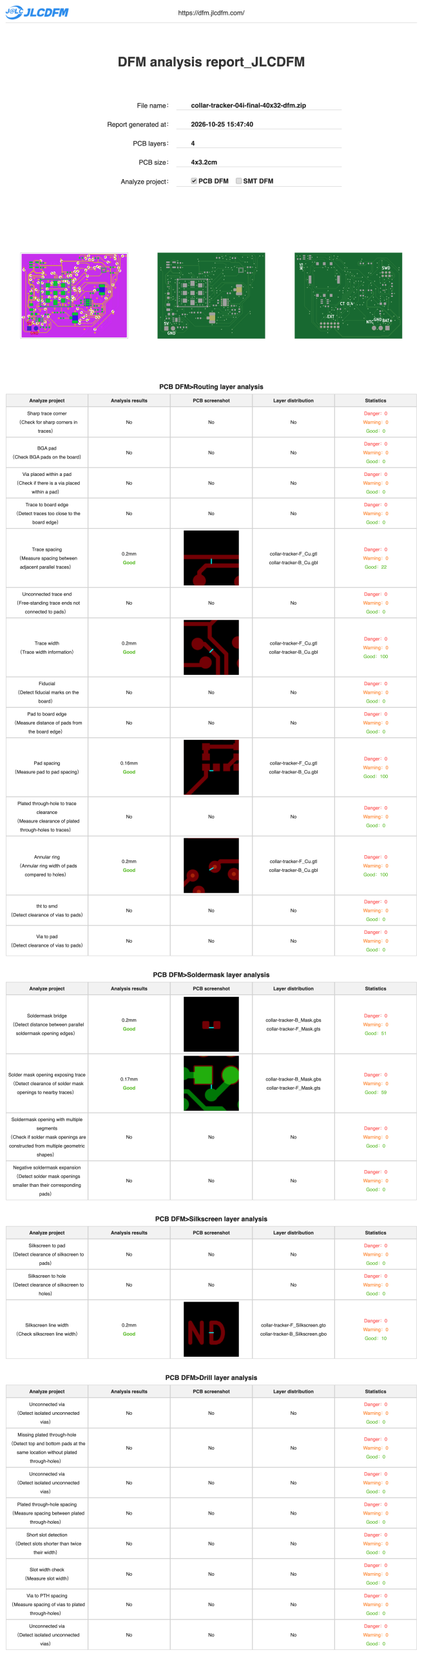
[picture p48: page 1]
