gokselozgur5/pcb-design-collar-tracker/experiments/paul-nanosim-r04i-sim-access-40x32/evidence/jlc-check2/report.pdf

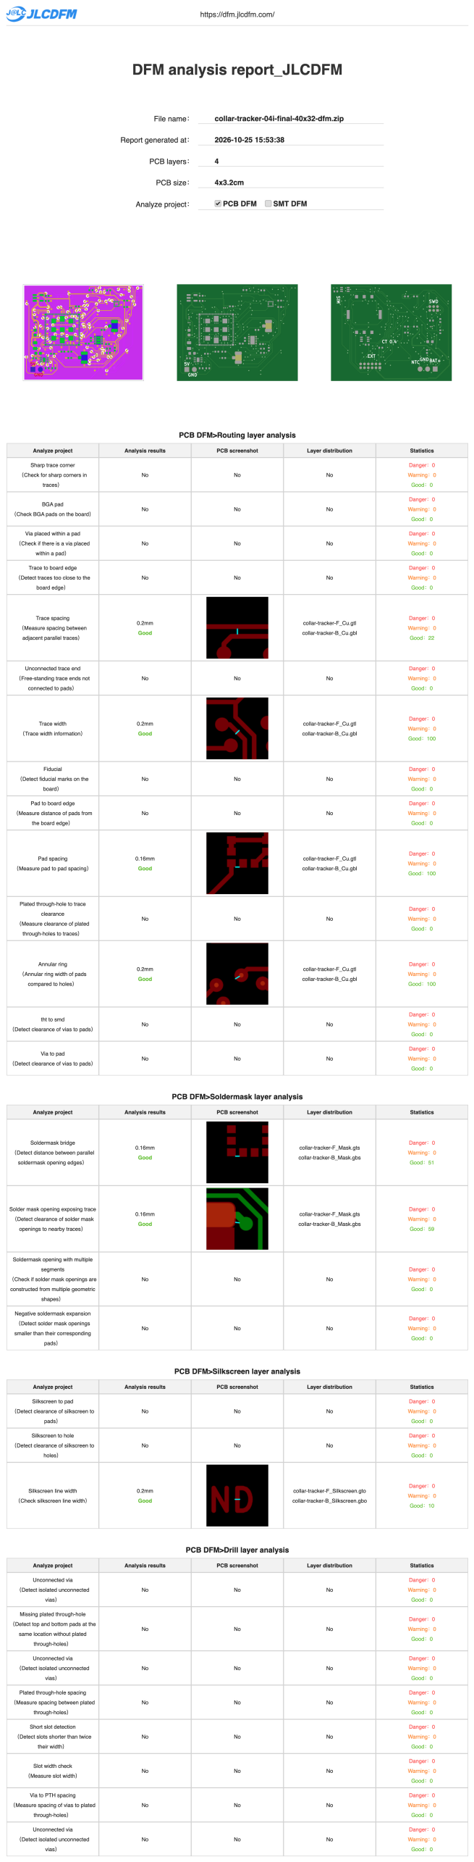
[picture p49: page 1]
