gokselozgur5/pcb-design-collar-tracker/experiments/paul-nanosim-r04i-sim-access-40x32/evidence/jlc-initial/report.pdf

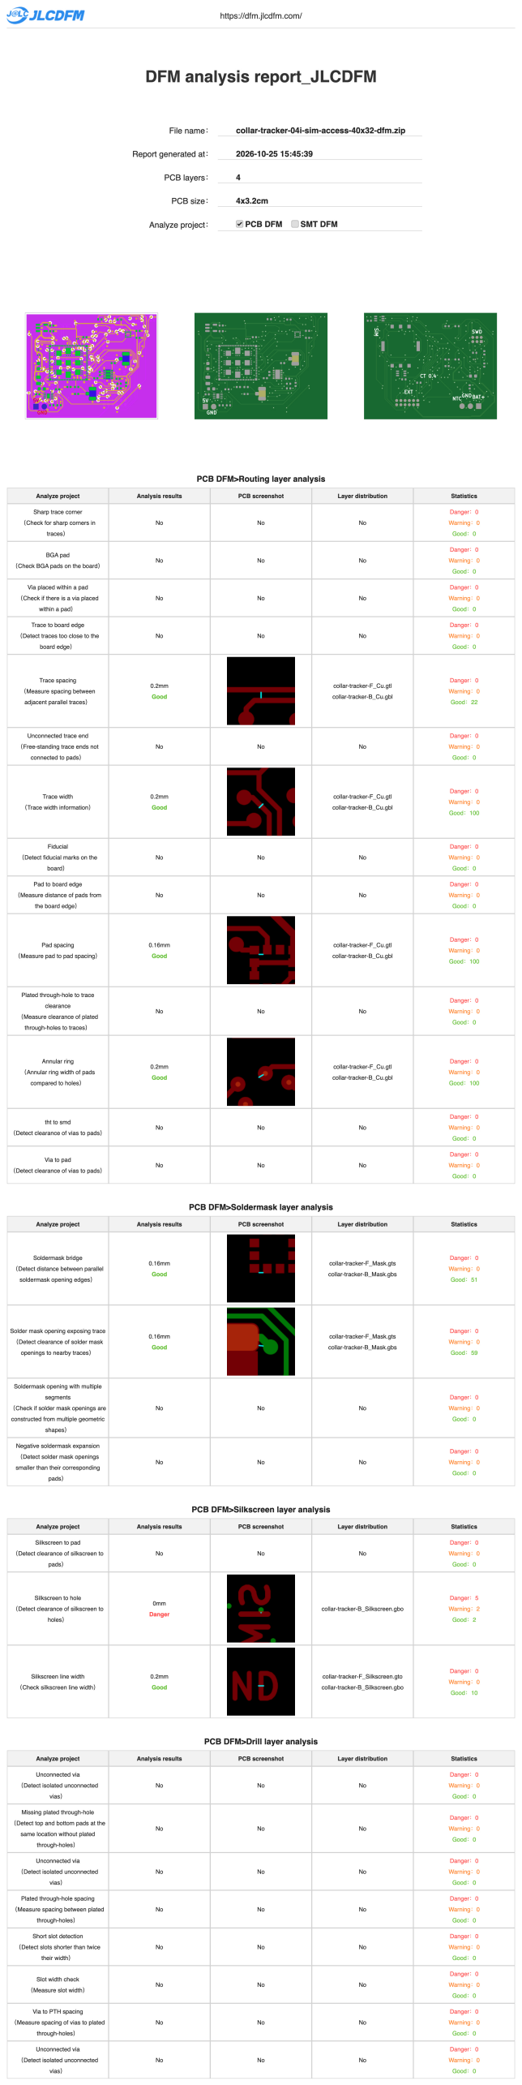
[picture p50: page 1]
