gokselozgur5/pcb-design-collar-tracker/experiments/paul-nanosim-r04g-returns-40x32/evidence/jlc-check1/report.pdf

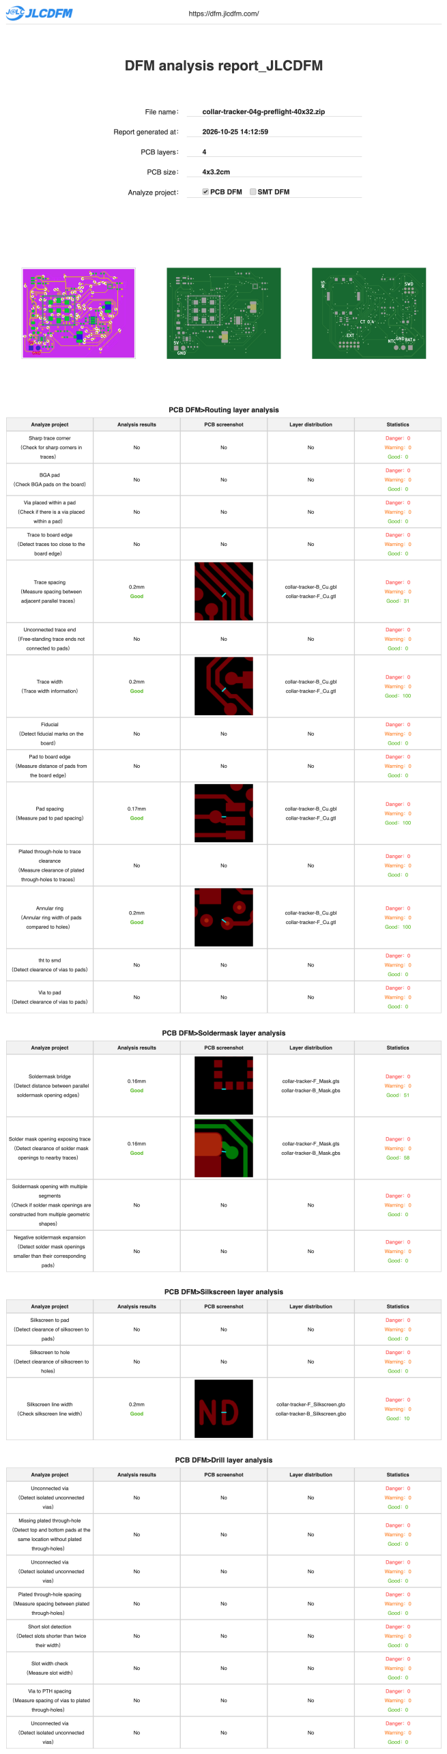
[picture p51: page 1]
