gokselozgur5/pcb-design-collar-tracker/experiments/paul-nanosim-r04g-returns-40x32/evidence/jlc-check2/report.pdf

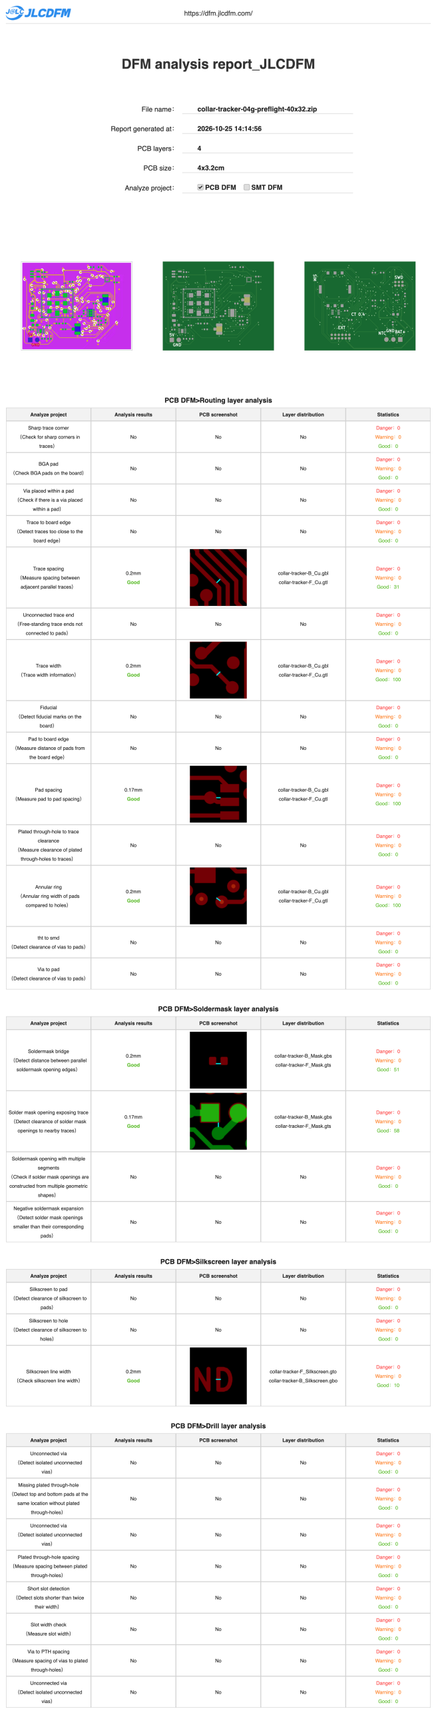
[picture p52: page 1]
