gokselozgur5/pcb-design-collar-tracker/experiments/paul-nanosim-r04f-40x32/evidence/jlc-preflight/report.pdf

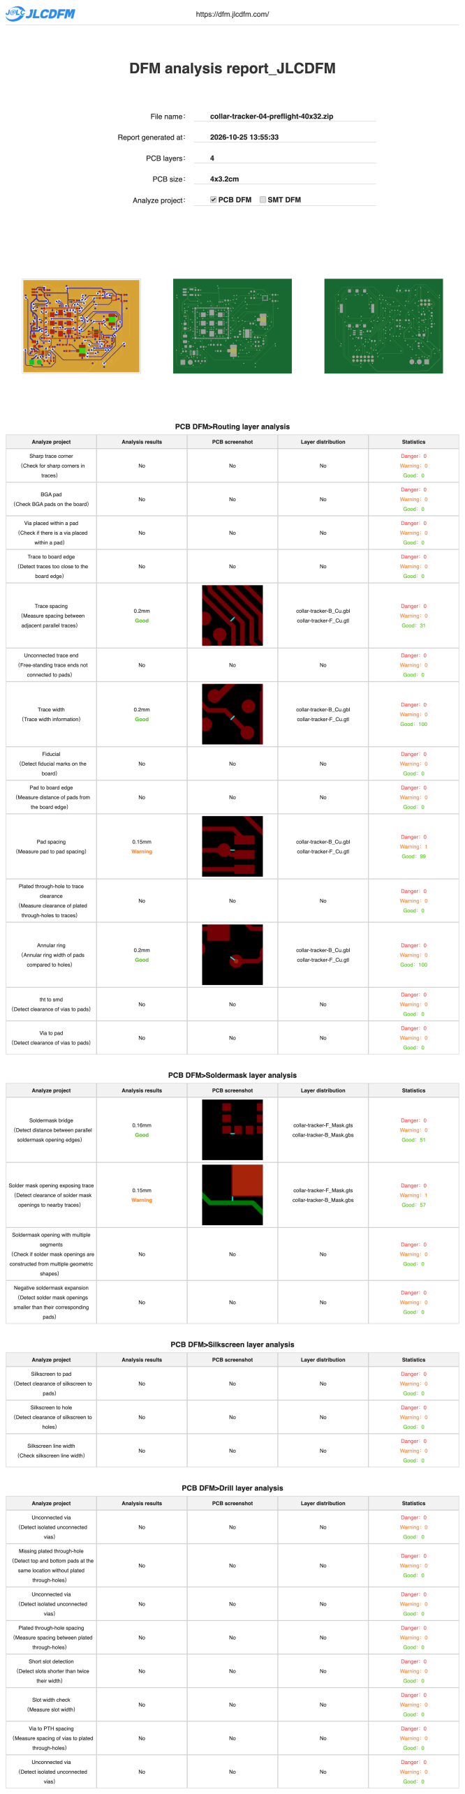
[picture p53: page 1]
