gokselozgur5/pcb-design-collar-tracker/experiments/paul-nanosim-r04h-review-40x32/evidence/schematic-detail.png

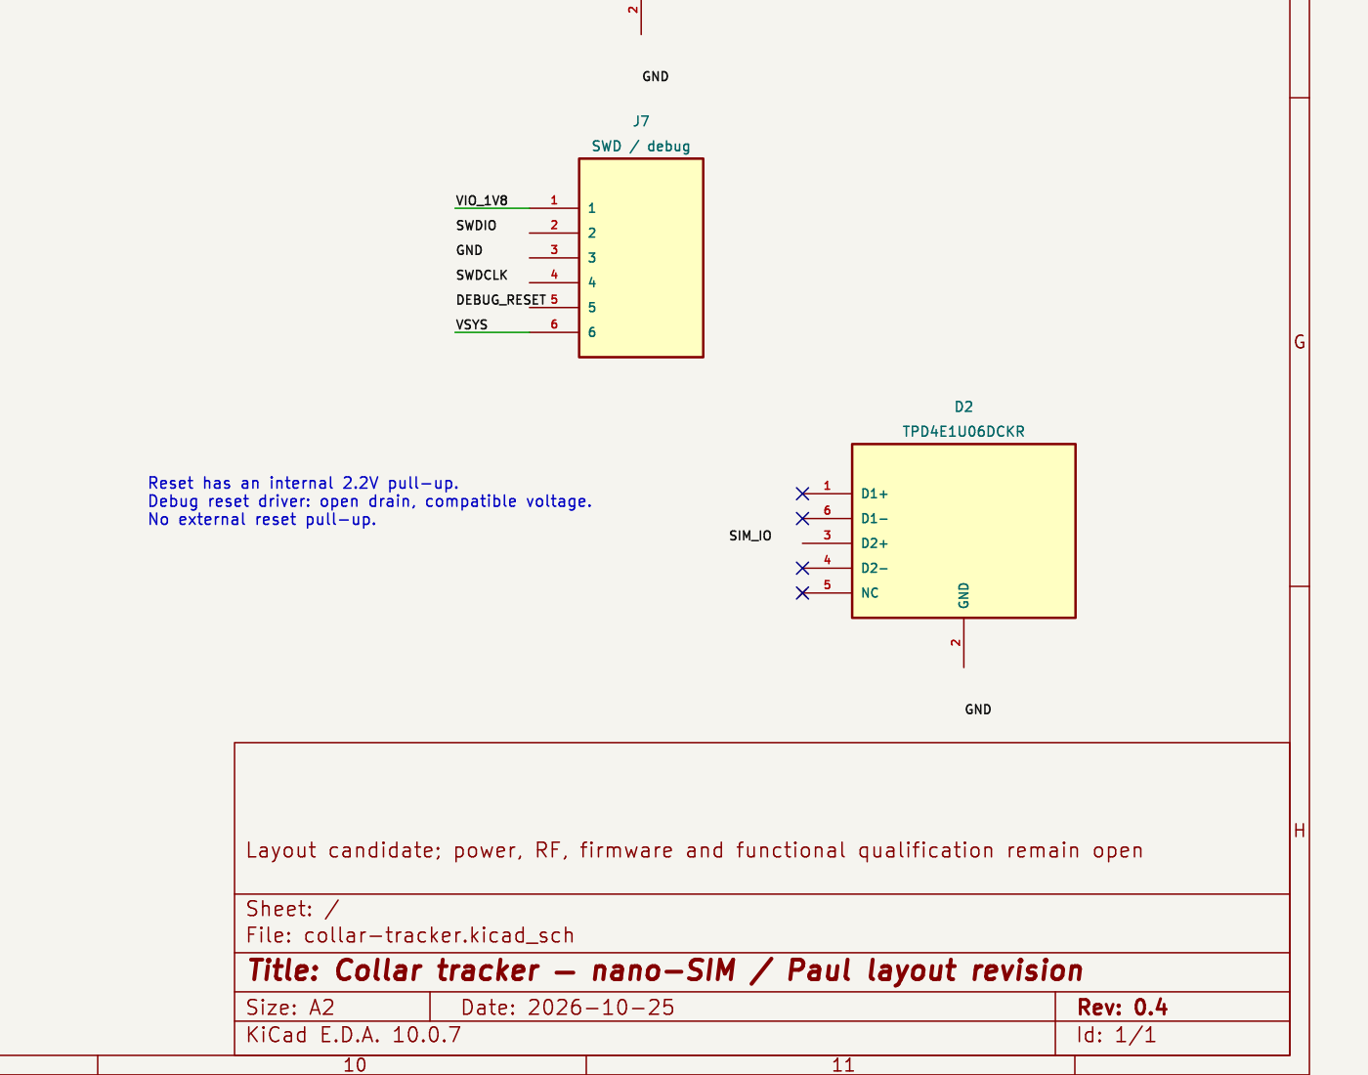
experiments/paul-nanosim-r04h-review-40x32/evidence/schematic-detail.png
