gokselozgur5/pcb-design-collar-tracker/experiments/paul-nanosim-r04h-review-40x32/evidence/schematic/collar-tracker.png

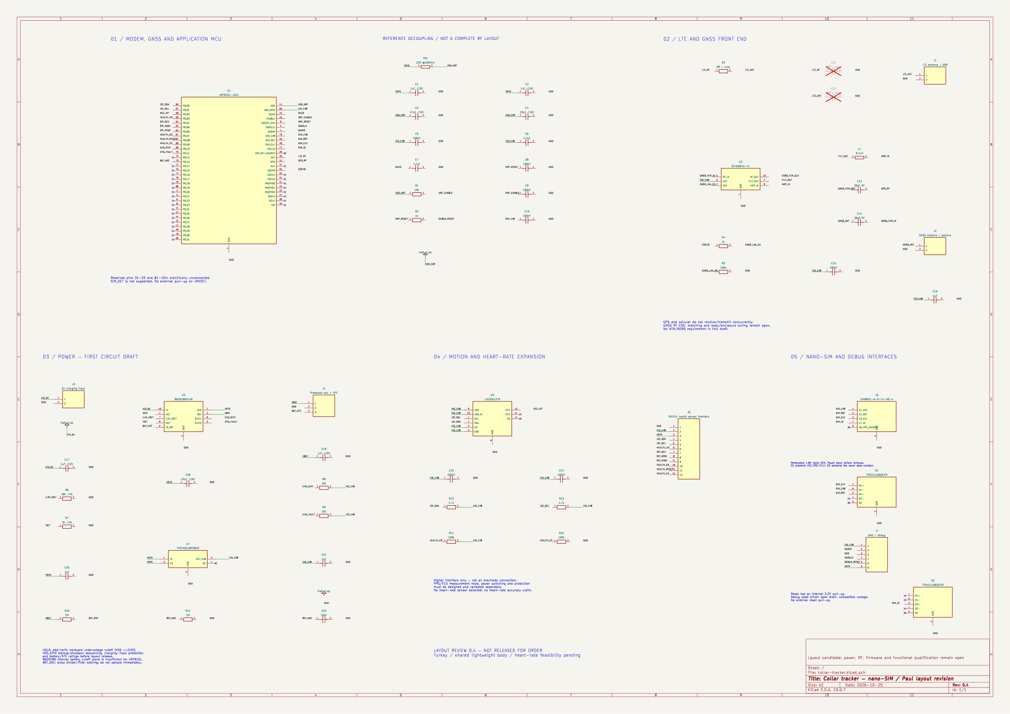
experiments/paul-nanosim-r04h-review-40x32/evidence/schematic/collar-tracker.png
