gokselozgur5/pcb-design-collar-tracker/experiments/power-r05-supervised/previews/schematic.png

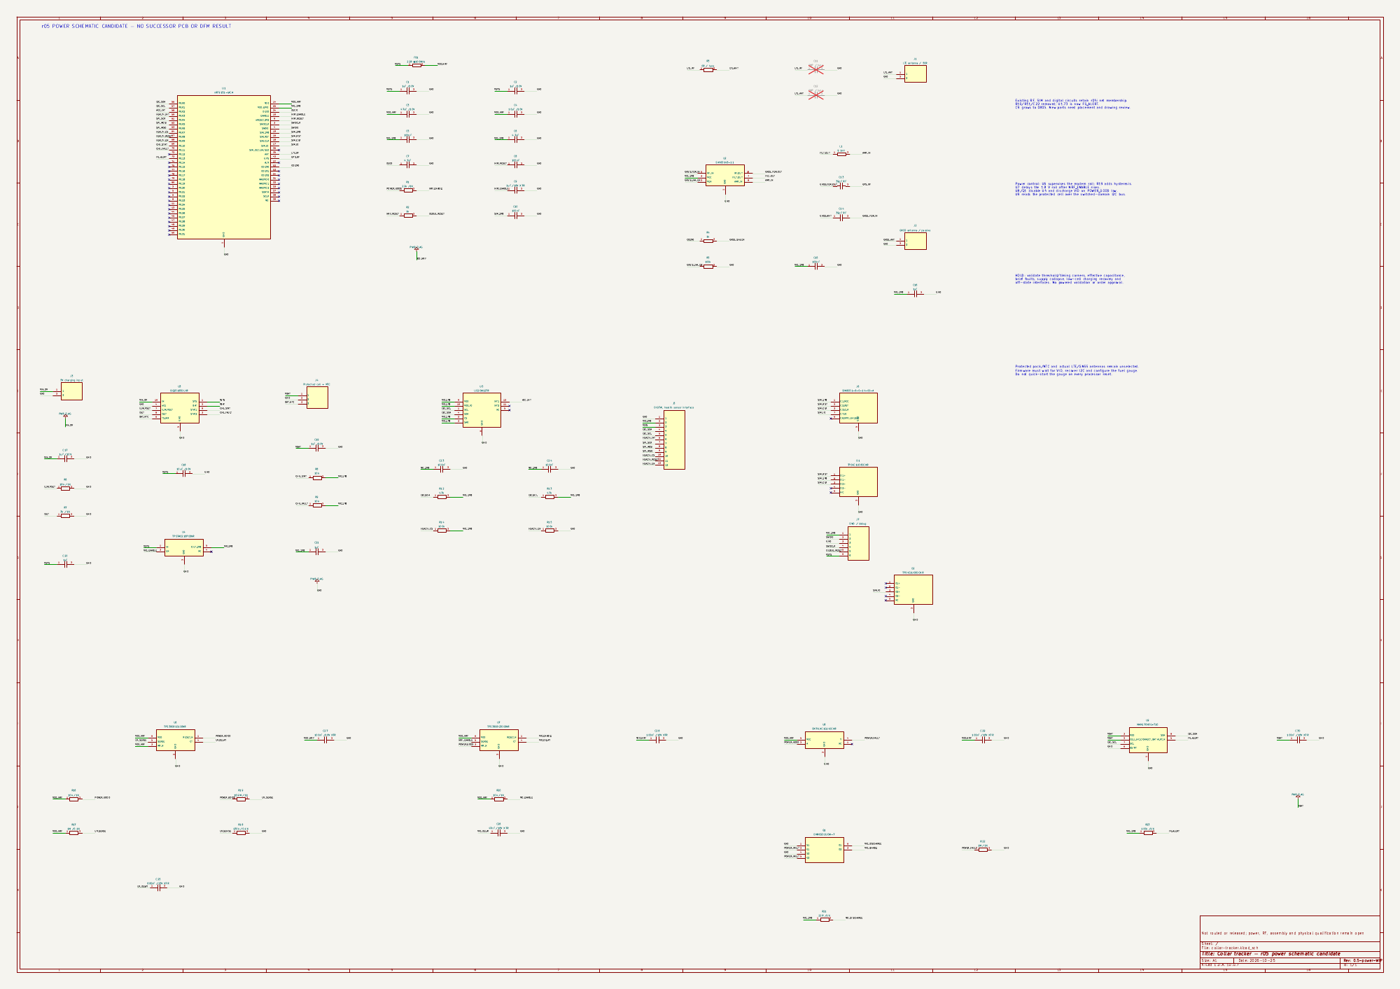
experiments/power-r05-supervised/previews/schematic.png
