gokselozgur5/pcb-design-collar-tracker/mechanical/swim-r02-fit/drawing.png

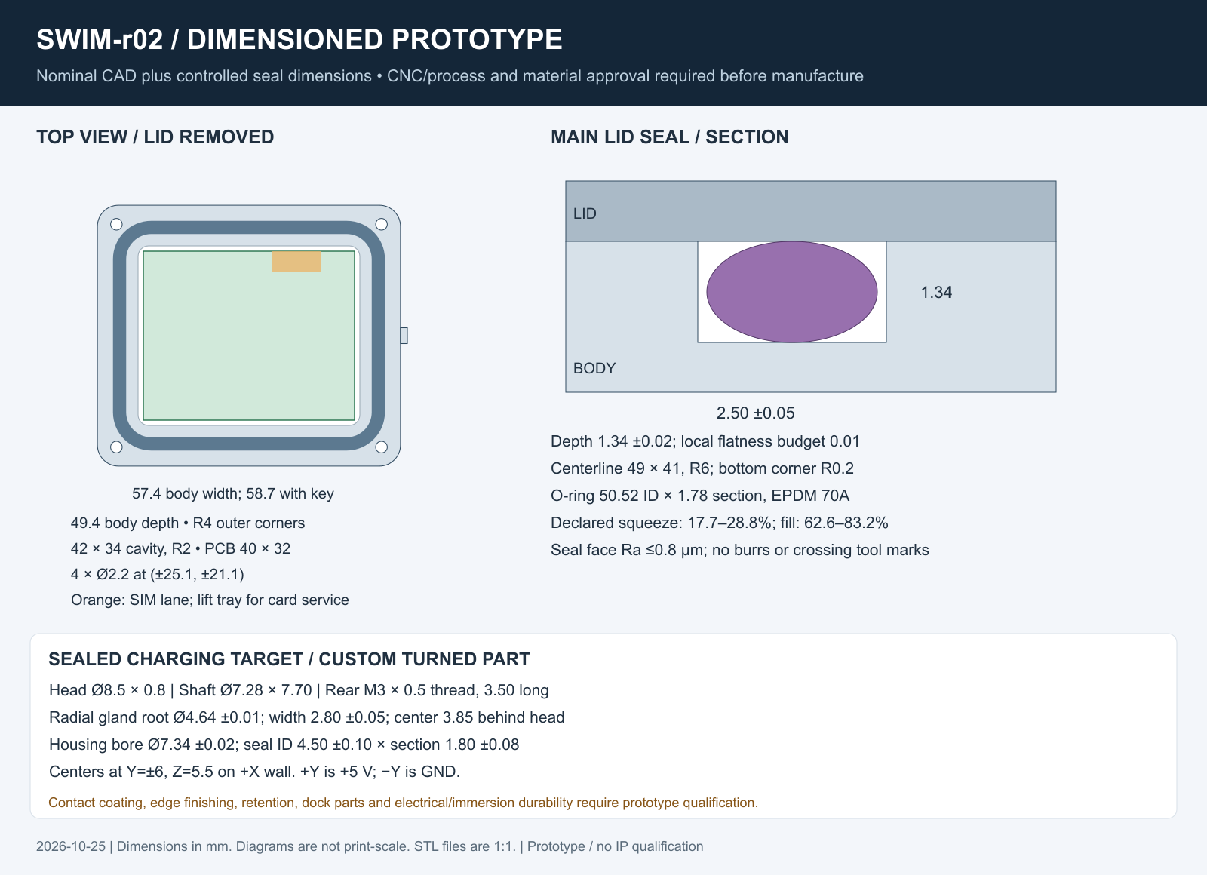
mechanical/swim-r02-fit/drawing.png
