gokselozgur5/pcb-design-collar-tracker/mechanical/swim-r02-fit/exploded.png

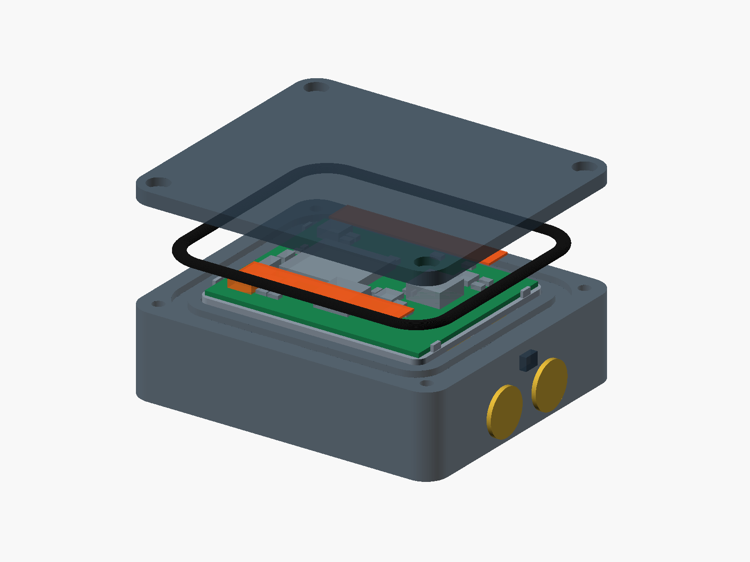
mechanical/swim-r02-fit/exploded.png
