gokselozgur5/pcb-design-collar-tracker/mechanical/swim-r02-fit/mounted.png

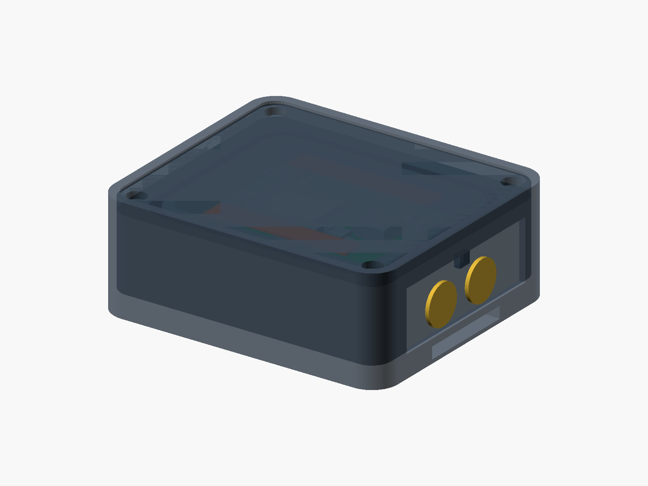
mechanical/swim-r02-fit/mounted.png
