gokselozgur5/pcb-design-collar-tracker/mechanical/swim-r02-fit/overview.png

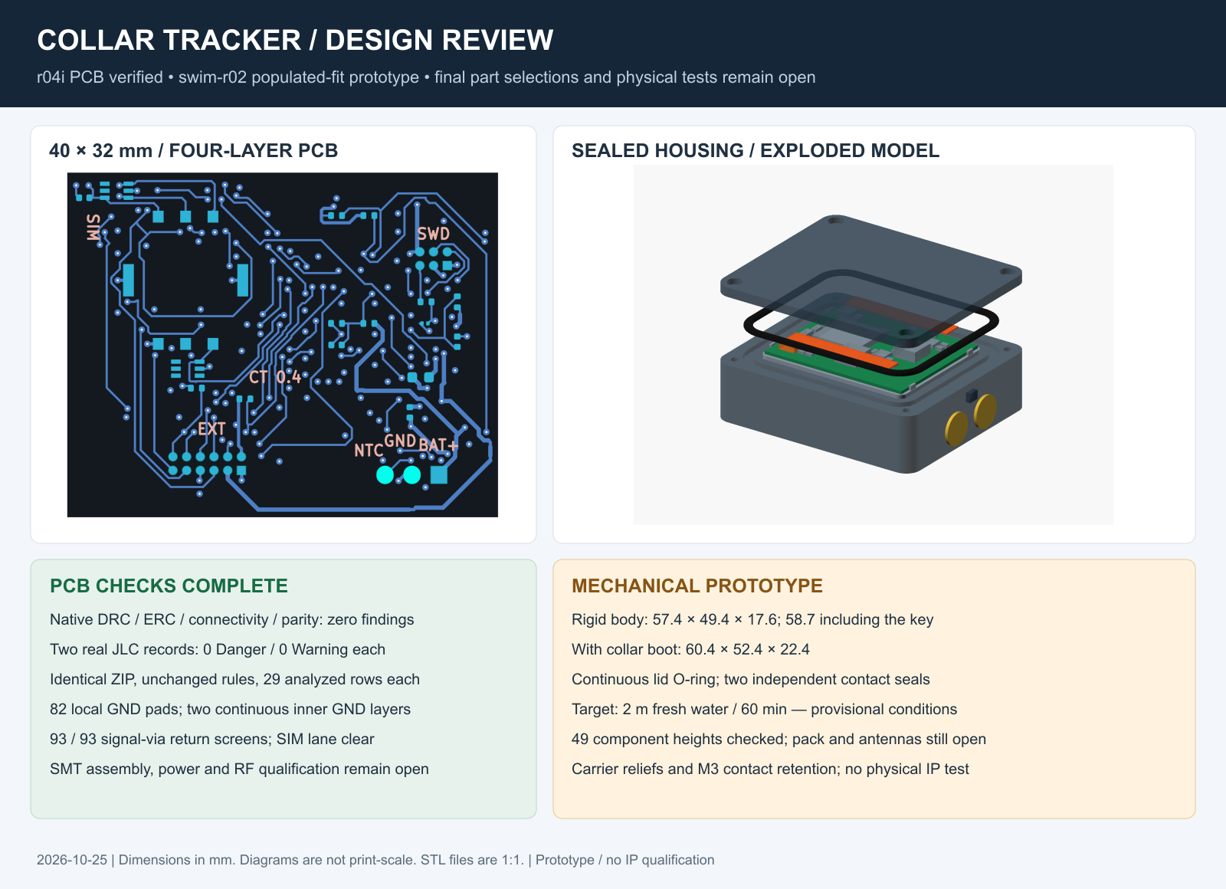
mechanical/swim-r02-fit/overview.png
