gokselozgur5/pcb-design-collar-tracker/mechanical/swim-r02-fit/populated.png

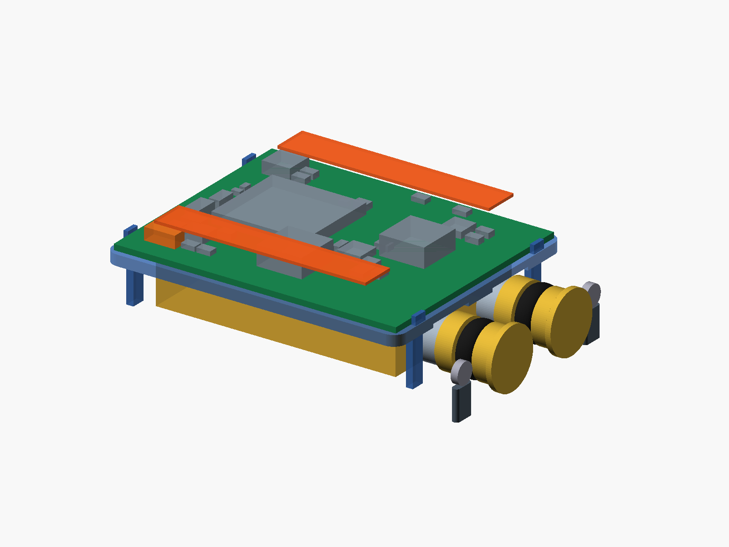
mechanical/swim-r02-fit/populated.png
