gokselozgur5/pcb-design-collar-tracker/mechanical/swim-r02-fit/section.png

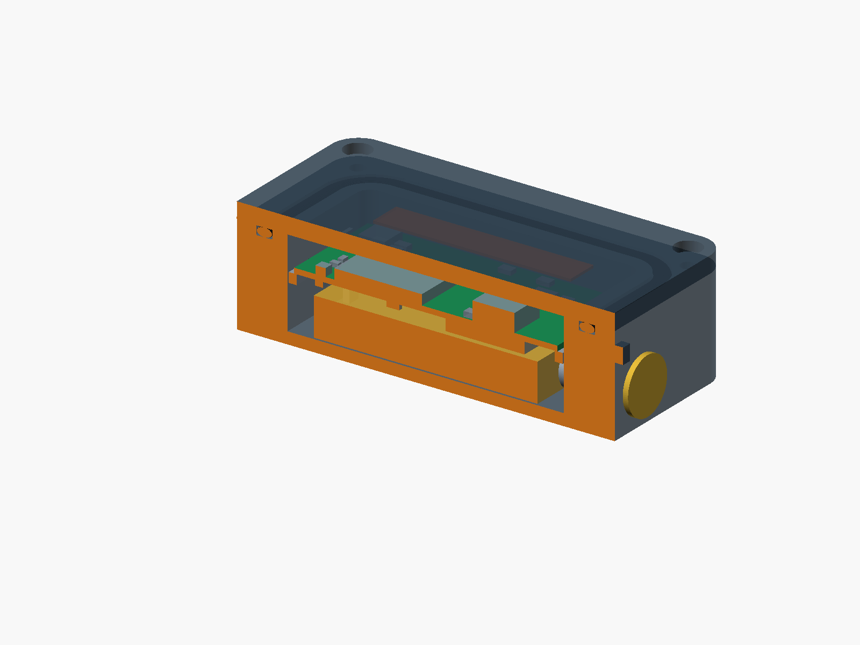
mechanical/swim-r02-fit/section.png
