gokselozgur5/pcb-design-collar-tracker/mechanical/swim-r11-thermal-fit/retention-sheet.png

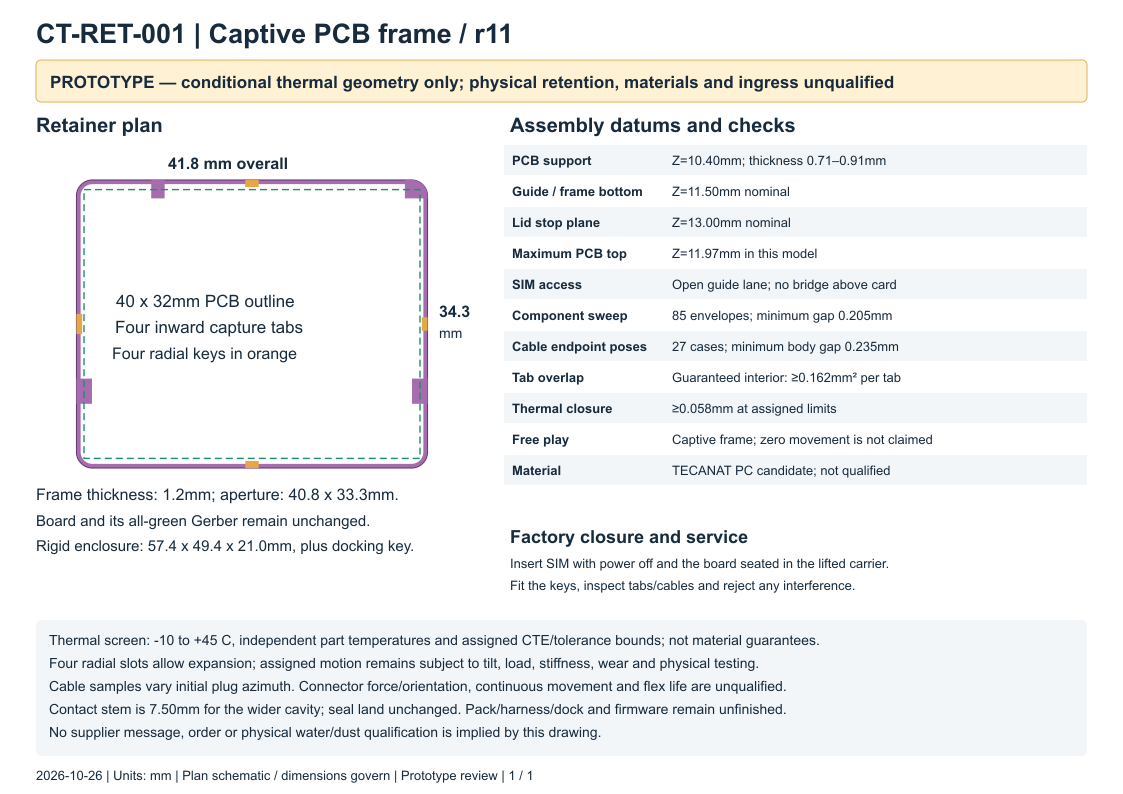
mechanical/swim-r11-thermal-fit/retention-sheet.png
