gokselozgur5/pcb-design-collar-tracker/mechanical/swim-r11-thermal-fit/routing.png

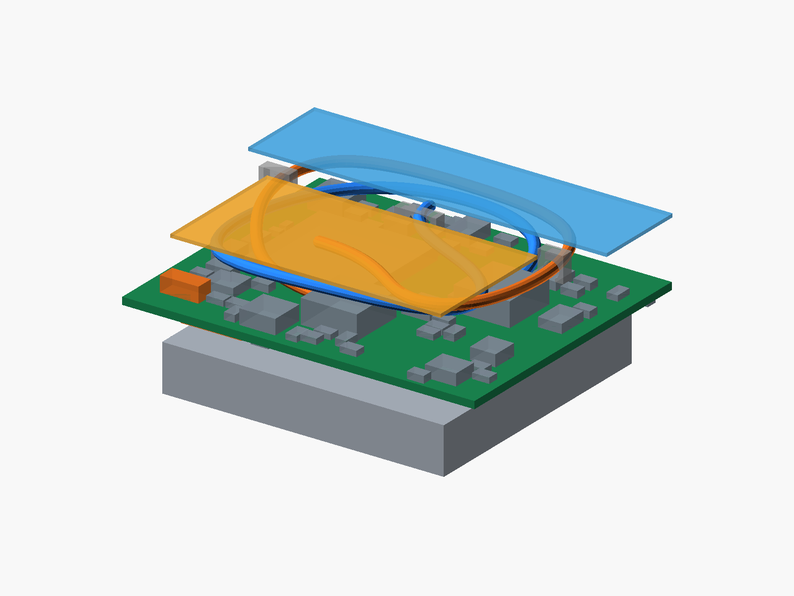
mechanical/swim-r11-thermal-fit/routing.png
