gokselozgur5/pcb-design-collar-tracker/mechanical/swim-r12-pack-retention/pack-retention-sheet.png

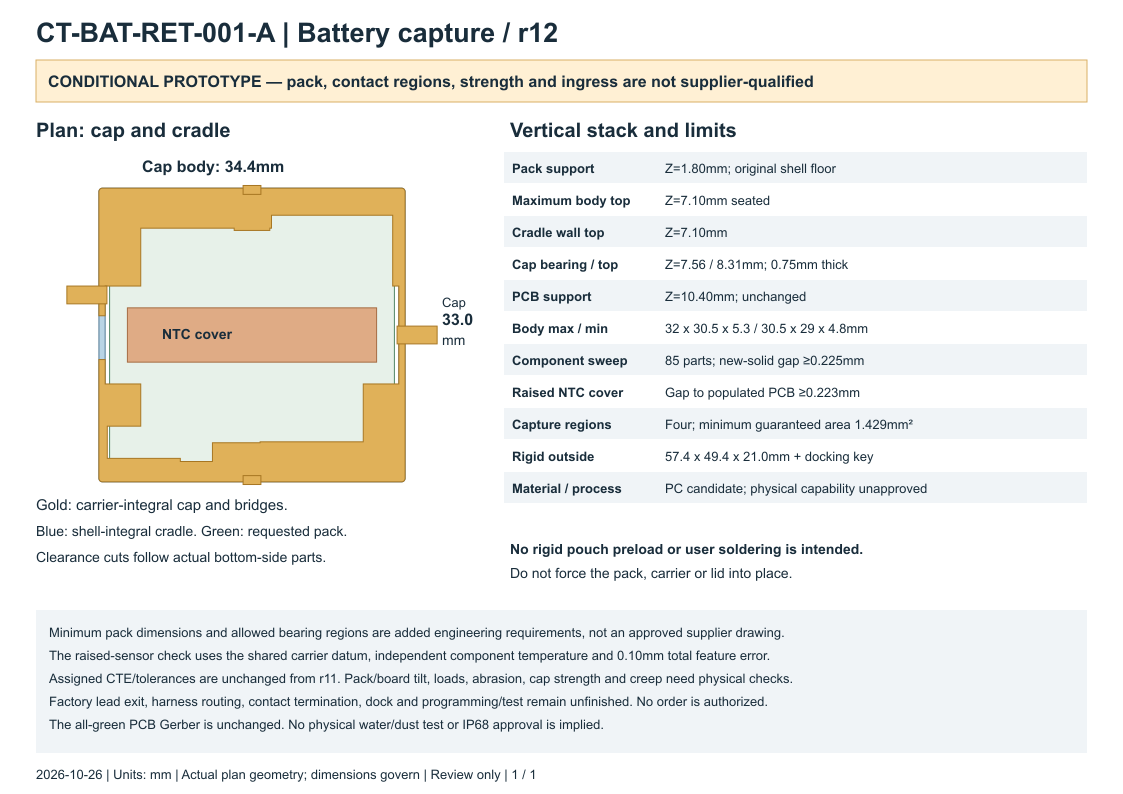
mechanical/swim-r12-pack-retention/pack-retention-sheet.png
