gokselozgur5/pcb-design-collar-tracker/mechanical/swim-r12-pack-retention/pack_exploded.png

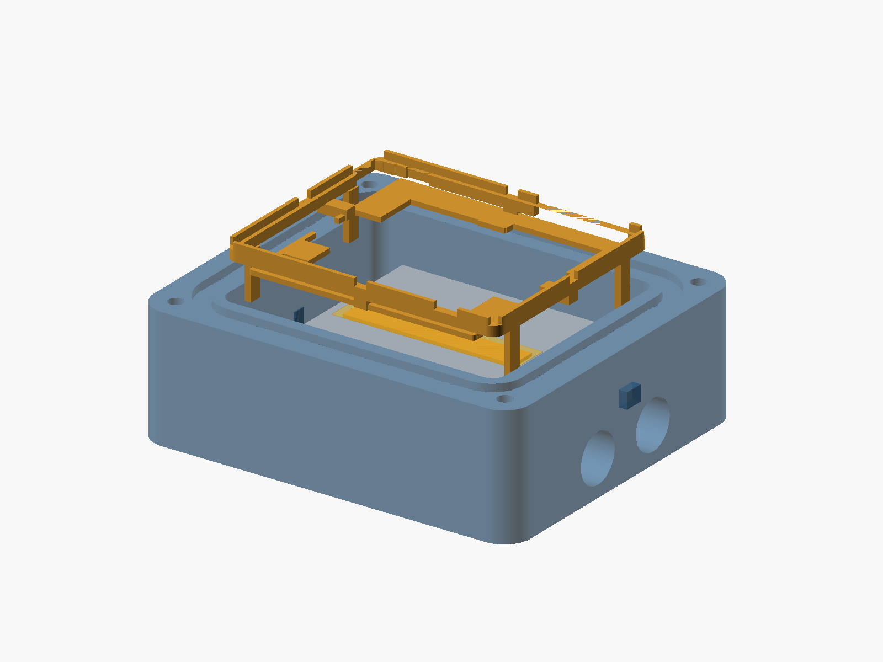
mechanical/swim-r12-pack-retention/pack_exploded.png
