gokselozgur5/pcb-design-collar-tracker/mechanical/swim-r13-charge-dock/dock-sheet.png

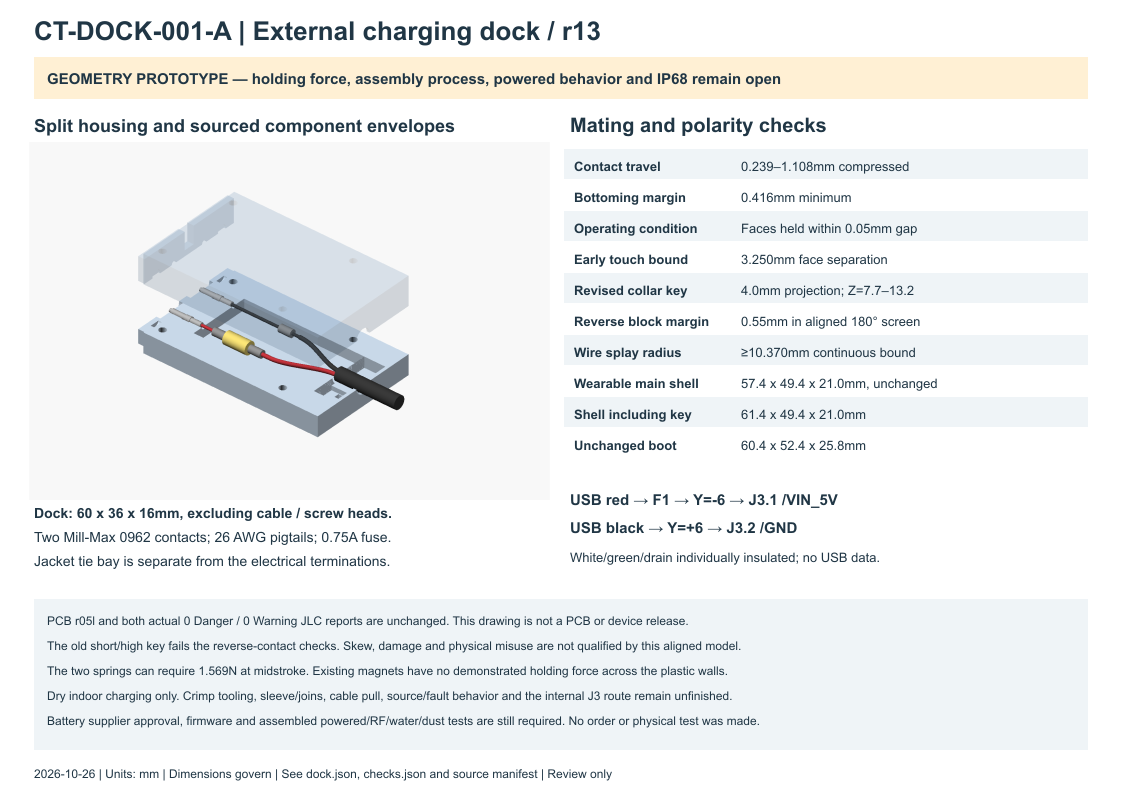
mechanical/swim-r13-charge-dock/dock-sheet.png
