gokselozgur5/pcb-design-collar-tracker/mechanical/swim-r14-wire-motion/motion.png

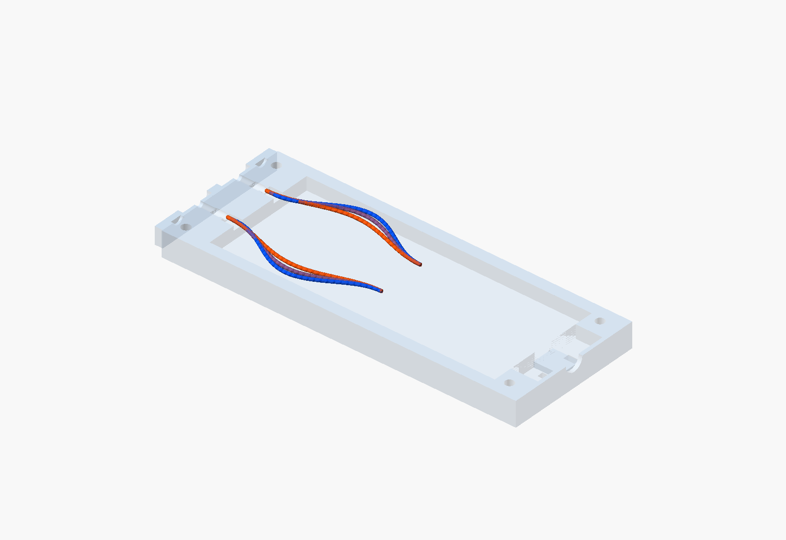
mechanical/swim-r14-wire-motion/motion.png
