gokselozgur5/pcb-design-collar-tracker/mechanical/swim-r14-wire-motion/wire-motion-sheet.png

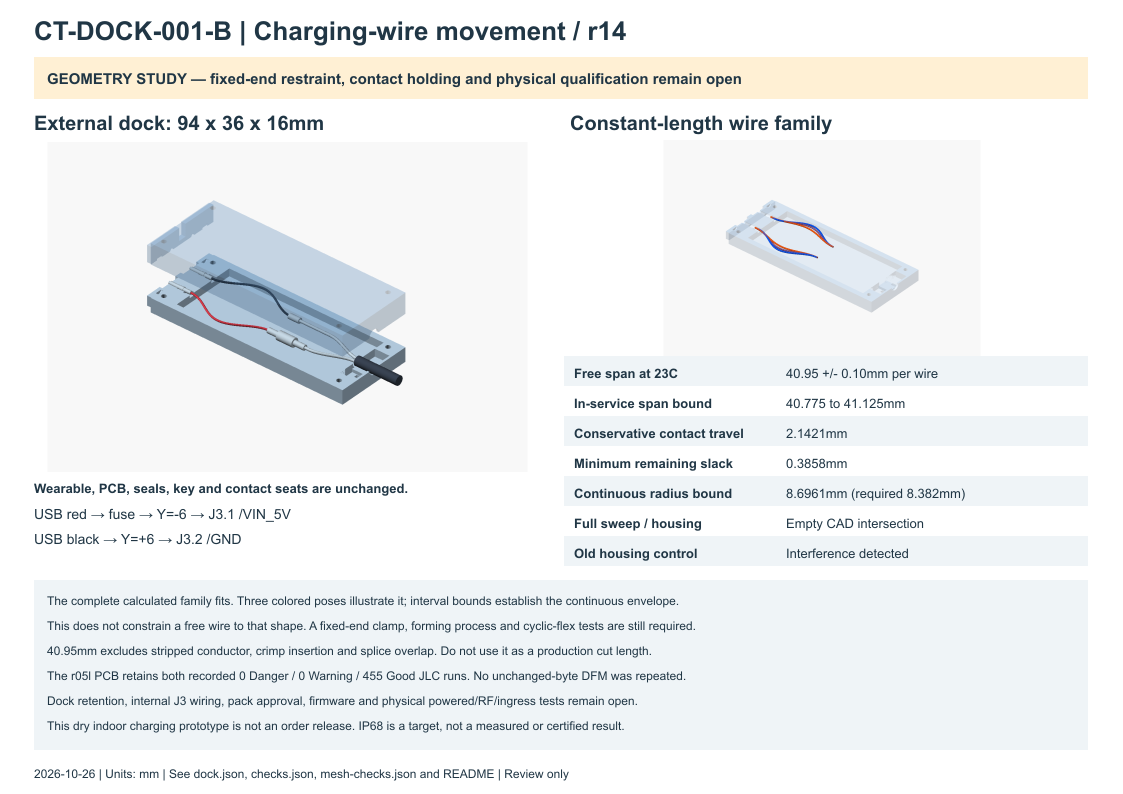
mechanical/swim-r14-wire-motion/wire-motion-sheet.png
