gokselozgur5/pcb-design-collar-tracker/mechanical/swim-r15-wire-clamp/clamp_detail.png

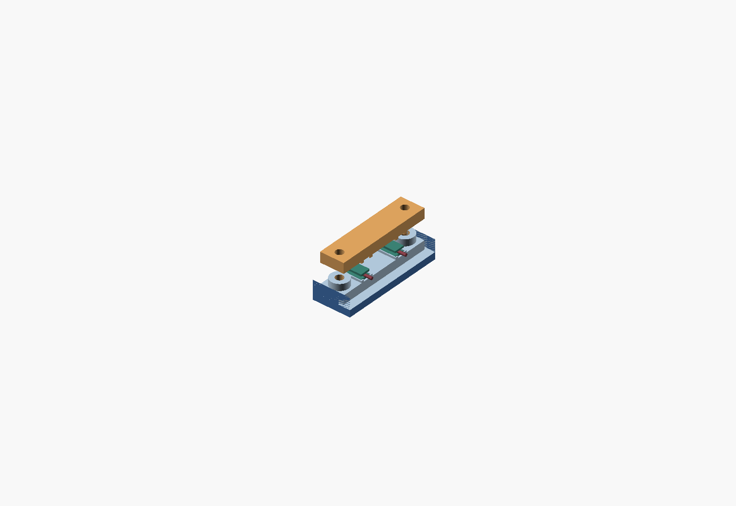
mechanical/swim-r15-wire-clamp/clamp_detail.png
