gokselozgur5/pcb-design-collar-tracker/mechanical/swim-r15-wire-clamp/fixture_review.png

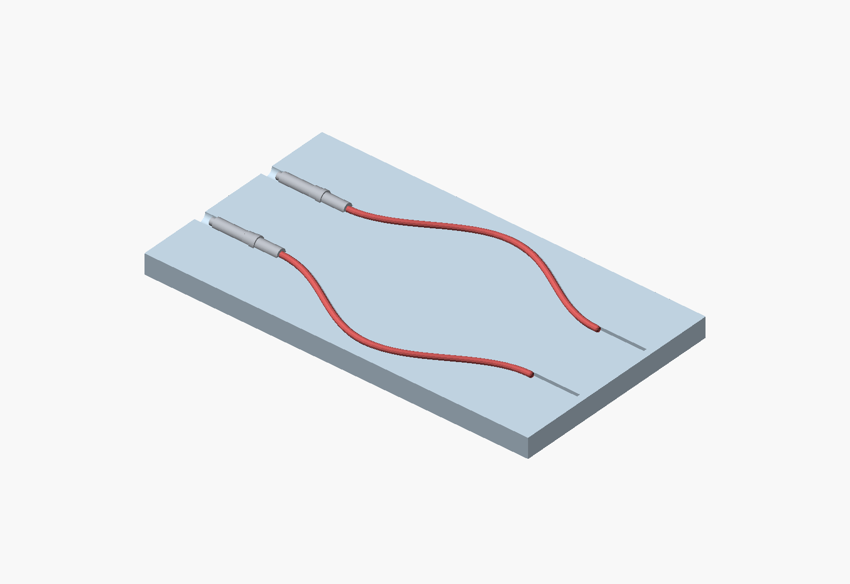
mechanical/swim-r15-wire-clamp/fixture_review.png
