gokselozgur5/pcb-design-collar-tracker/mechanical/swim-r15-wire-clamp/wire-clamp-sheet.png

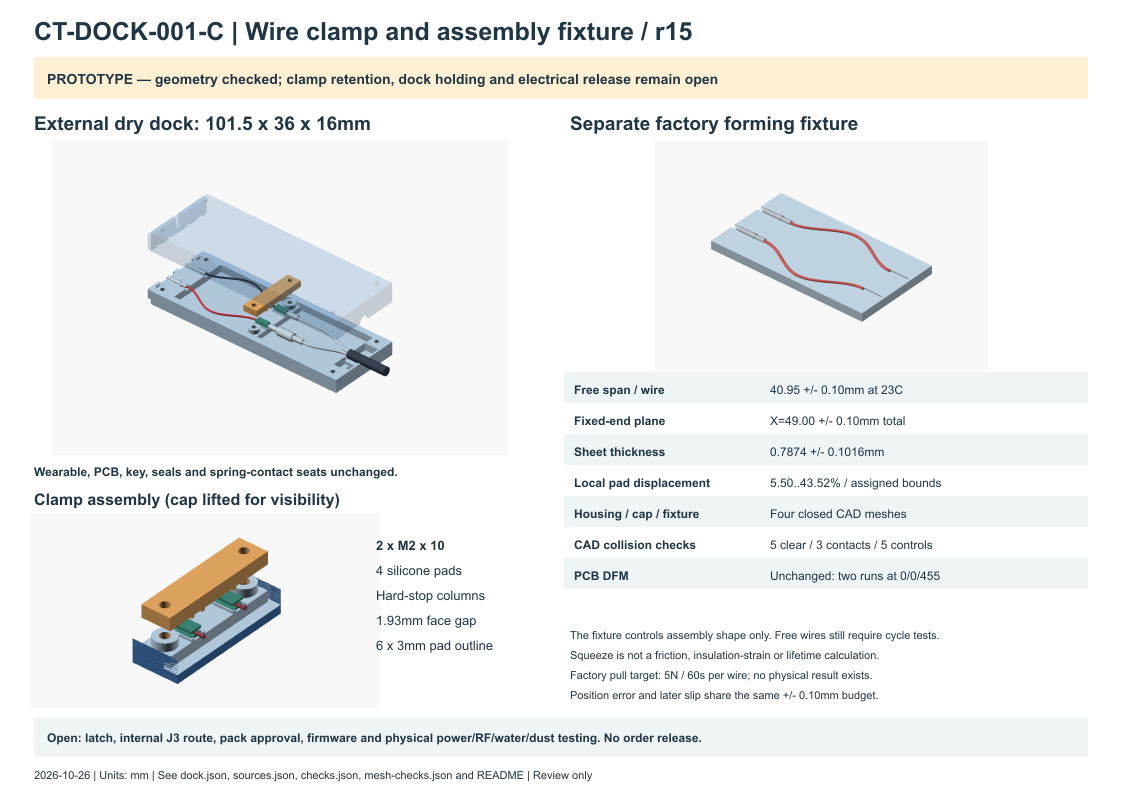
mechanical/swim-r15-wire-clamp/wire-clamp-sheet.png
