gokselozgur5/pcb-design-collar-tracker/mechanical/swim-r16-contact-retention/contact-retention-sheet.png

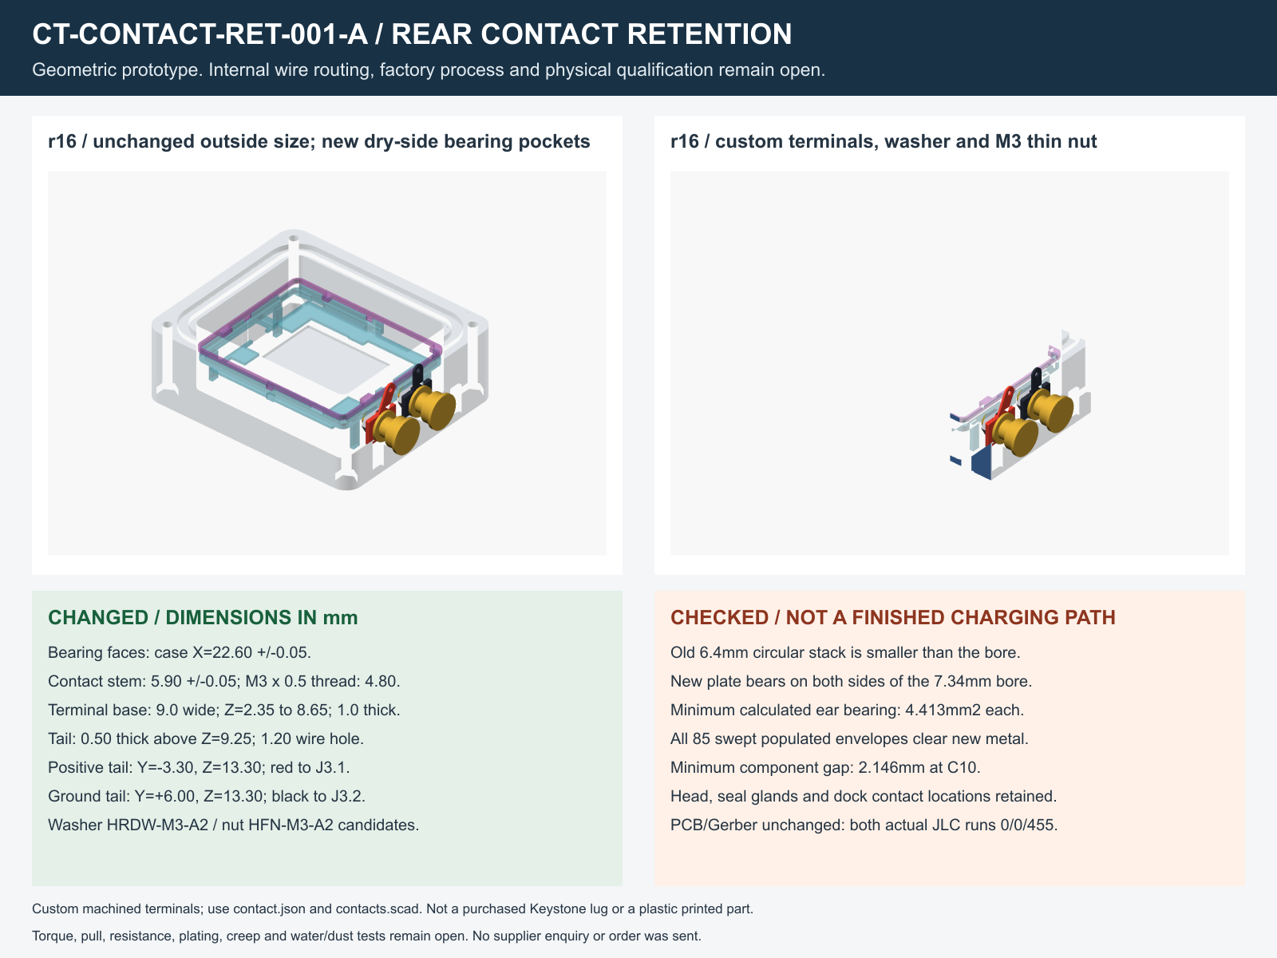
mechanical/swim-r16-contact-retention/contact-retention-sheet.png
