gokselozgur5/pcb-design-collar-tracker/mechanical/swim-r17-cable-integration/review.png

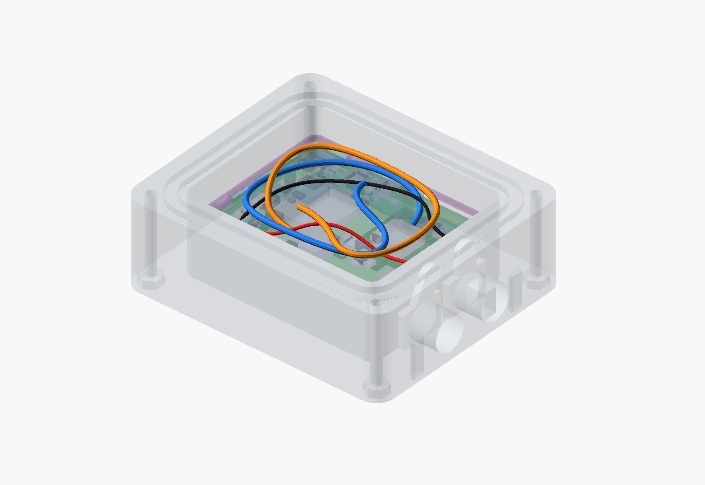
mechanical/swim-r17-cable-integration/review.png
