gokselozgur5/pcb-design-collar-tracker/mechanical/universal-mount-r01/design-overview.png

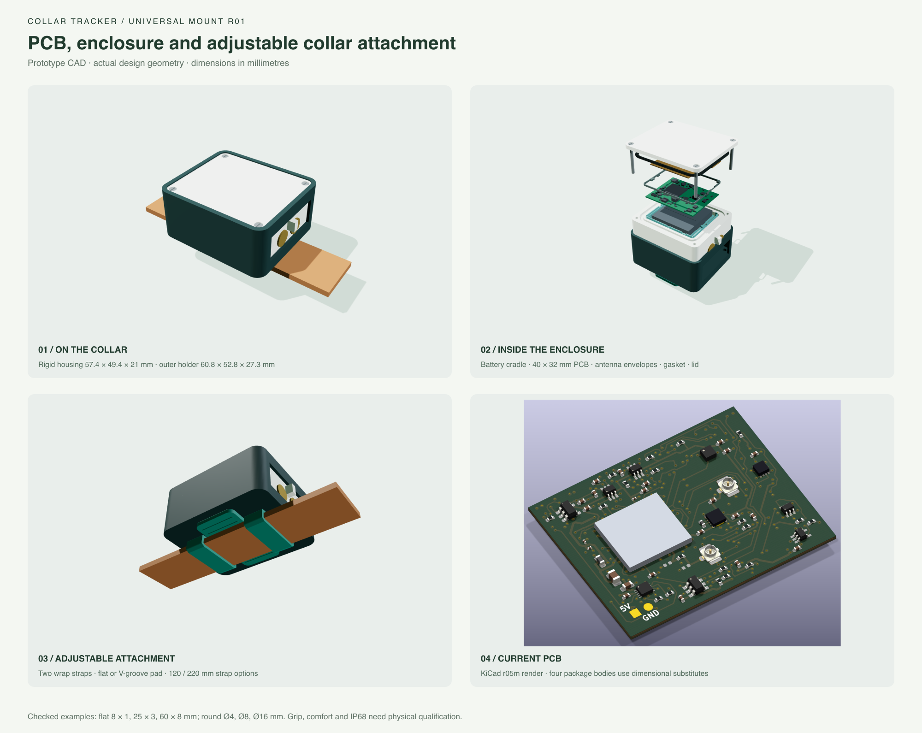
mechanical/universal-mount-r01/design-overview.png
