gokselozgur5/pcb-design-collar-tracker/mechanical/universal-mount-r01/exploded.png

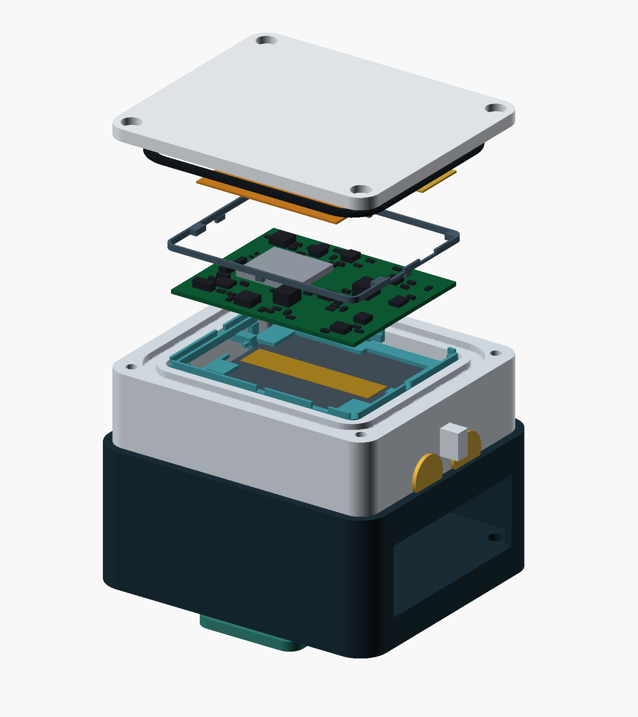
mechanical/universal-mount-r01/exploded.png
