gokselozgur5/pcb-design-collar-tracker/mechanical/universal-mount-r01/mounted.png

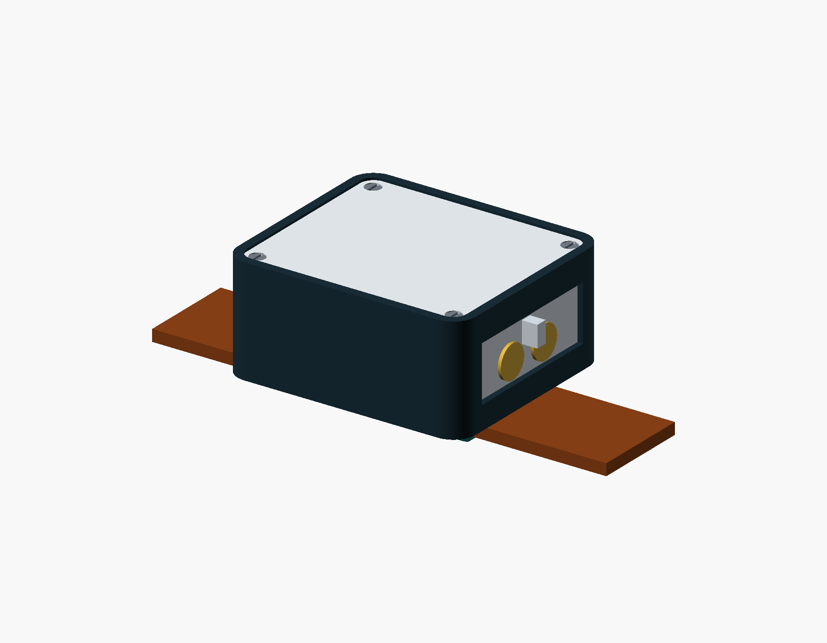
mechanical/universal-mount-r01/mounted.png
