gokselozgur5/pcb-design-collar-tracker/mechanical/universal-mount-r01/render-round.png

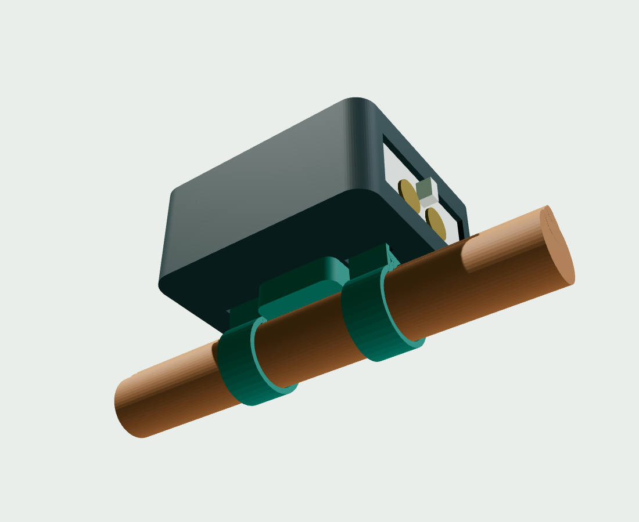
mechanical/universal-mount-r01/render-round.png
