gokselozgur5/pcb-design-collar-tracker/mechanical/universal-mount-r01/rope.png

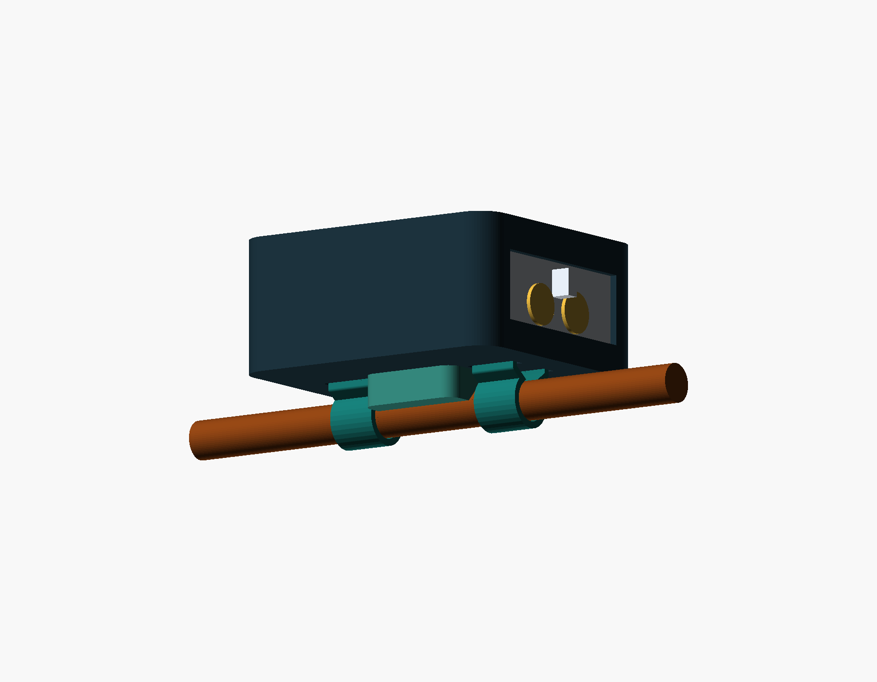
mechanical/universal-mount-r01/rope.png
