gokselozgur5/pcb-design-collar-tracker/mechanical/universal-mount-r01/view-exploded.png

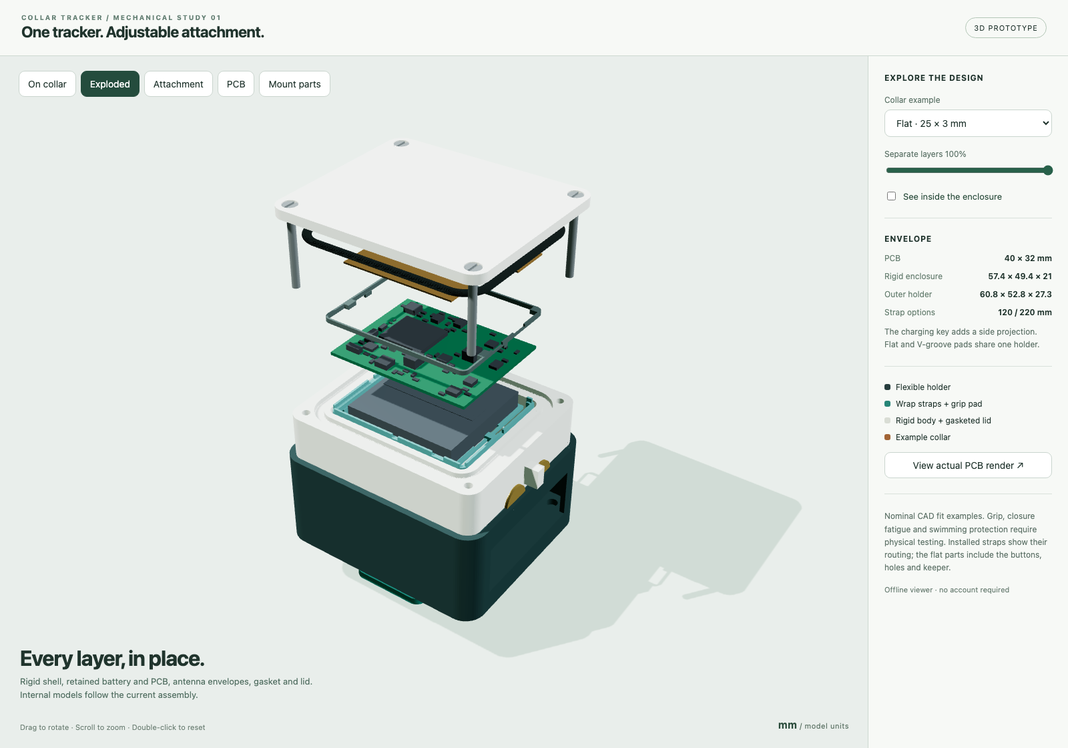
mechanical/universal-mount-r01/view-exploded.png
