gokselozgur5/pcb-design-collar-tracker/mechanical/universal-mount-r01/view-round.png

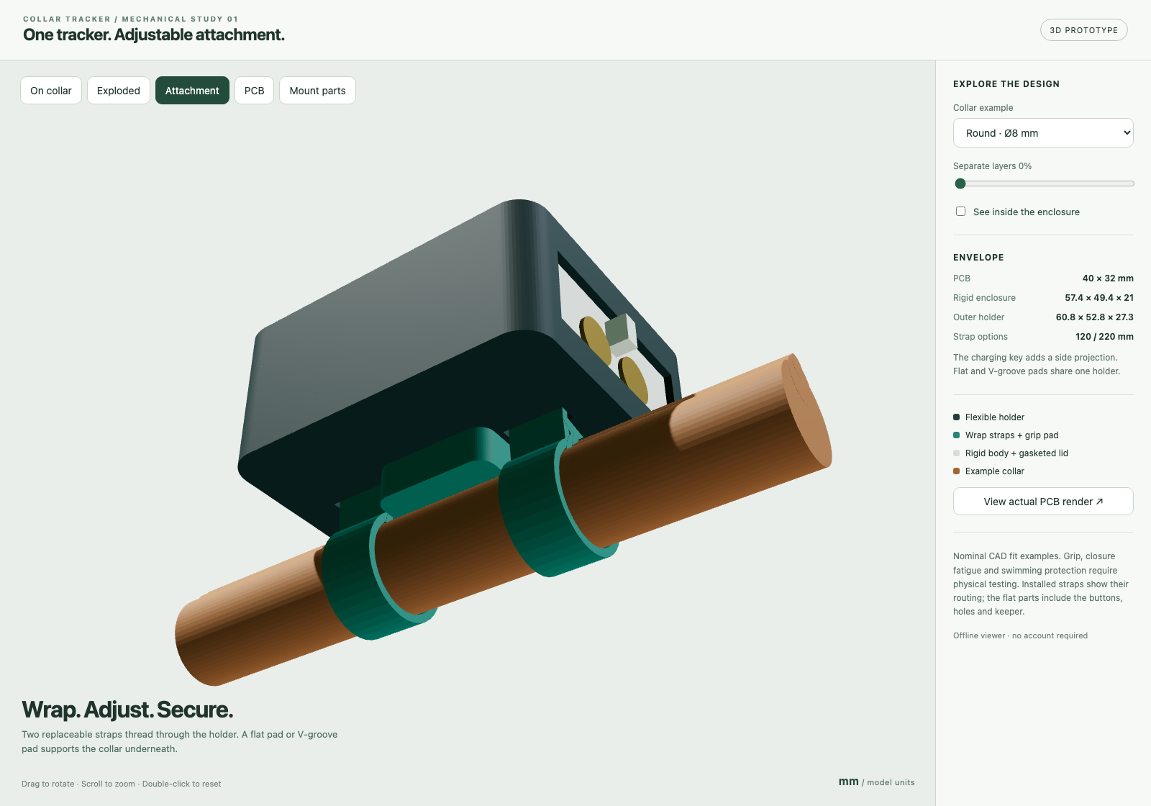
mechanical/universal-mount-r01/view-round.png
