gokselozgur5/pcb-design-collar-tracker/mechanical/universal-mount-r01/wide.png

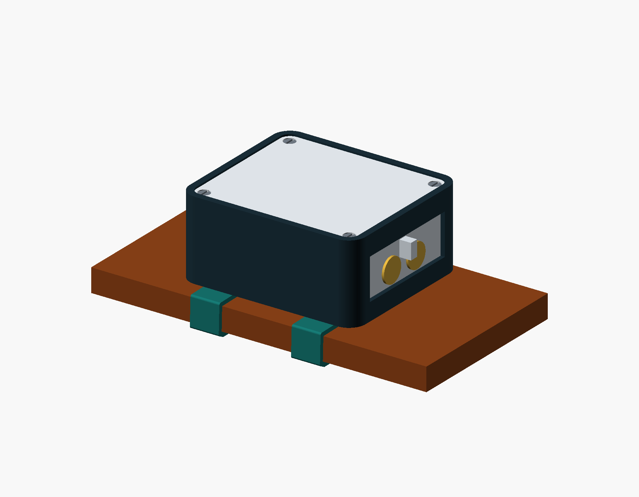
mechanical/universal-mount-r01/wide.png
