gokselozgur5/pcb-design-collar-tracker/previews/compact-250-exploded.png

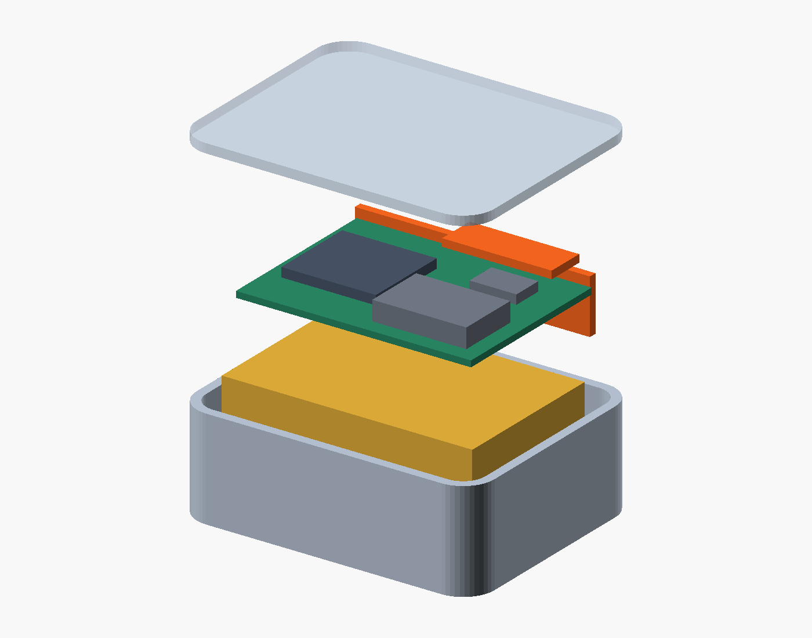
previews/compact-250-exploded.png
