gokselozgur5/pcb-design-collar-tracker/previews/compact-250-review.png

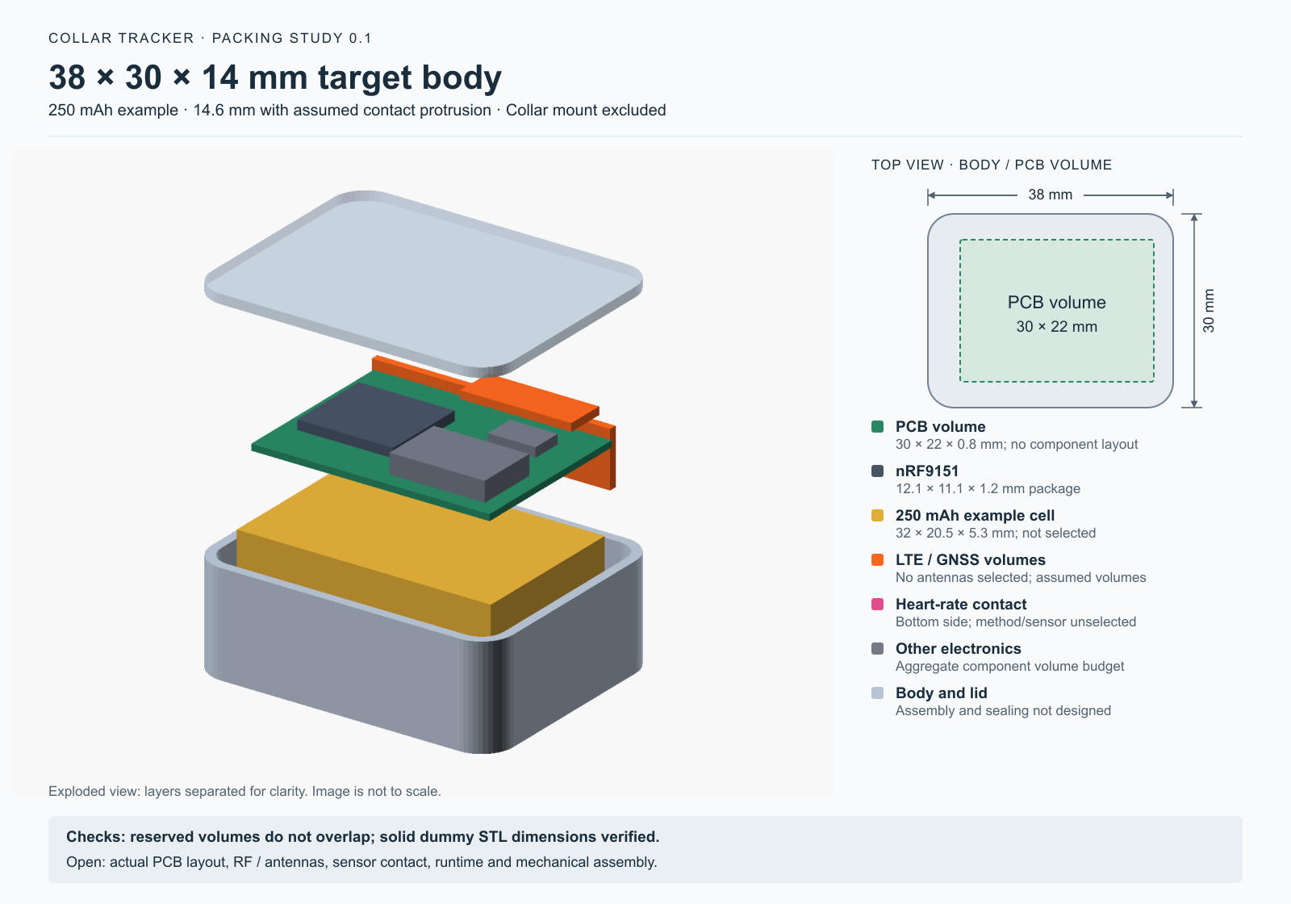
previews/compact-250-review.png
