gokselozgur5/pcb-design-collar-tracker/previews/compact-250-section.png

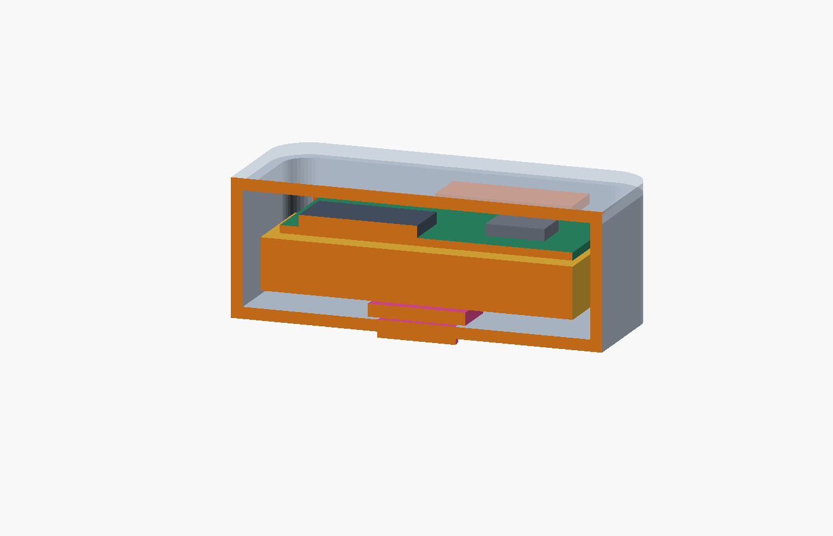
previews/compact-250-section.png
