gokselozgur5/pcb-design-collar-tracker/previews/pcb-dfm-0.2.1-bottom.png

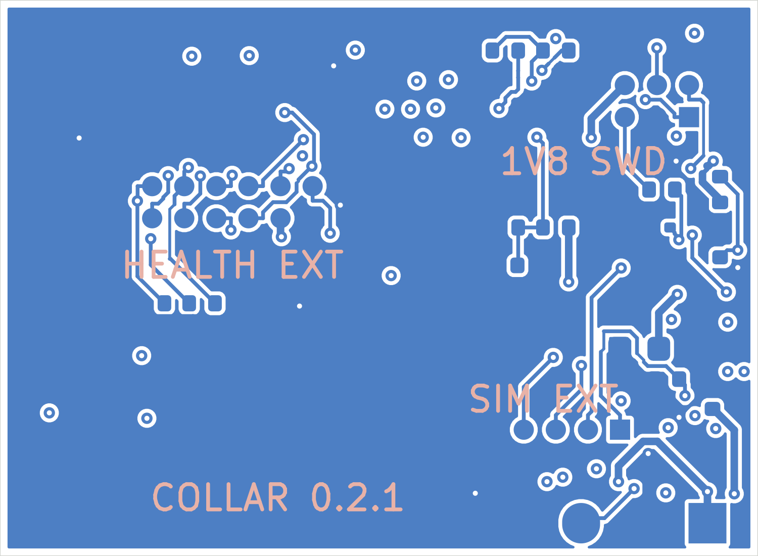
previews/pcb-dfm-0.2.1-bottom.png
