gokselozgur5/pcb-design-collar-tracker/previews/pcb-placement-top.png

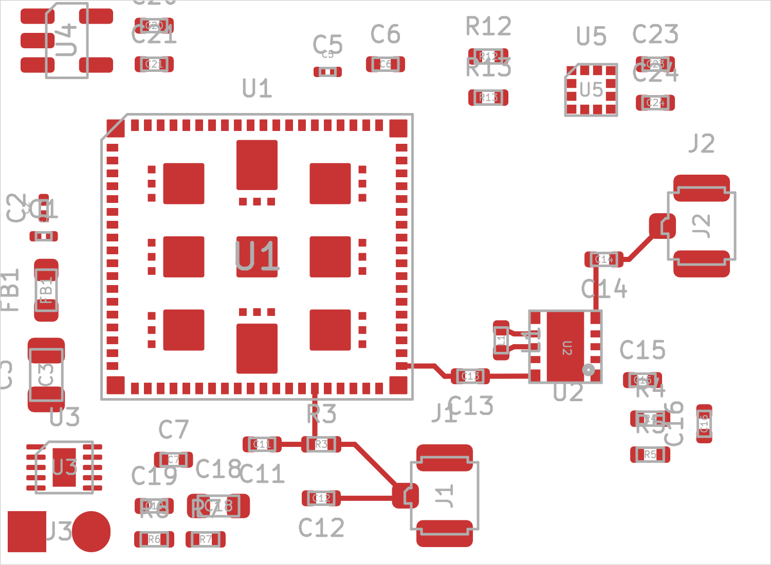
previews/pcb-placement-top.png
