gokselozgur5/pcb-design-collar-tracker/previews/sky65943-land-pattern.png

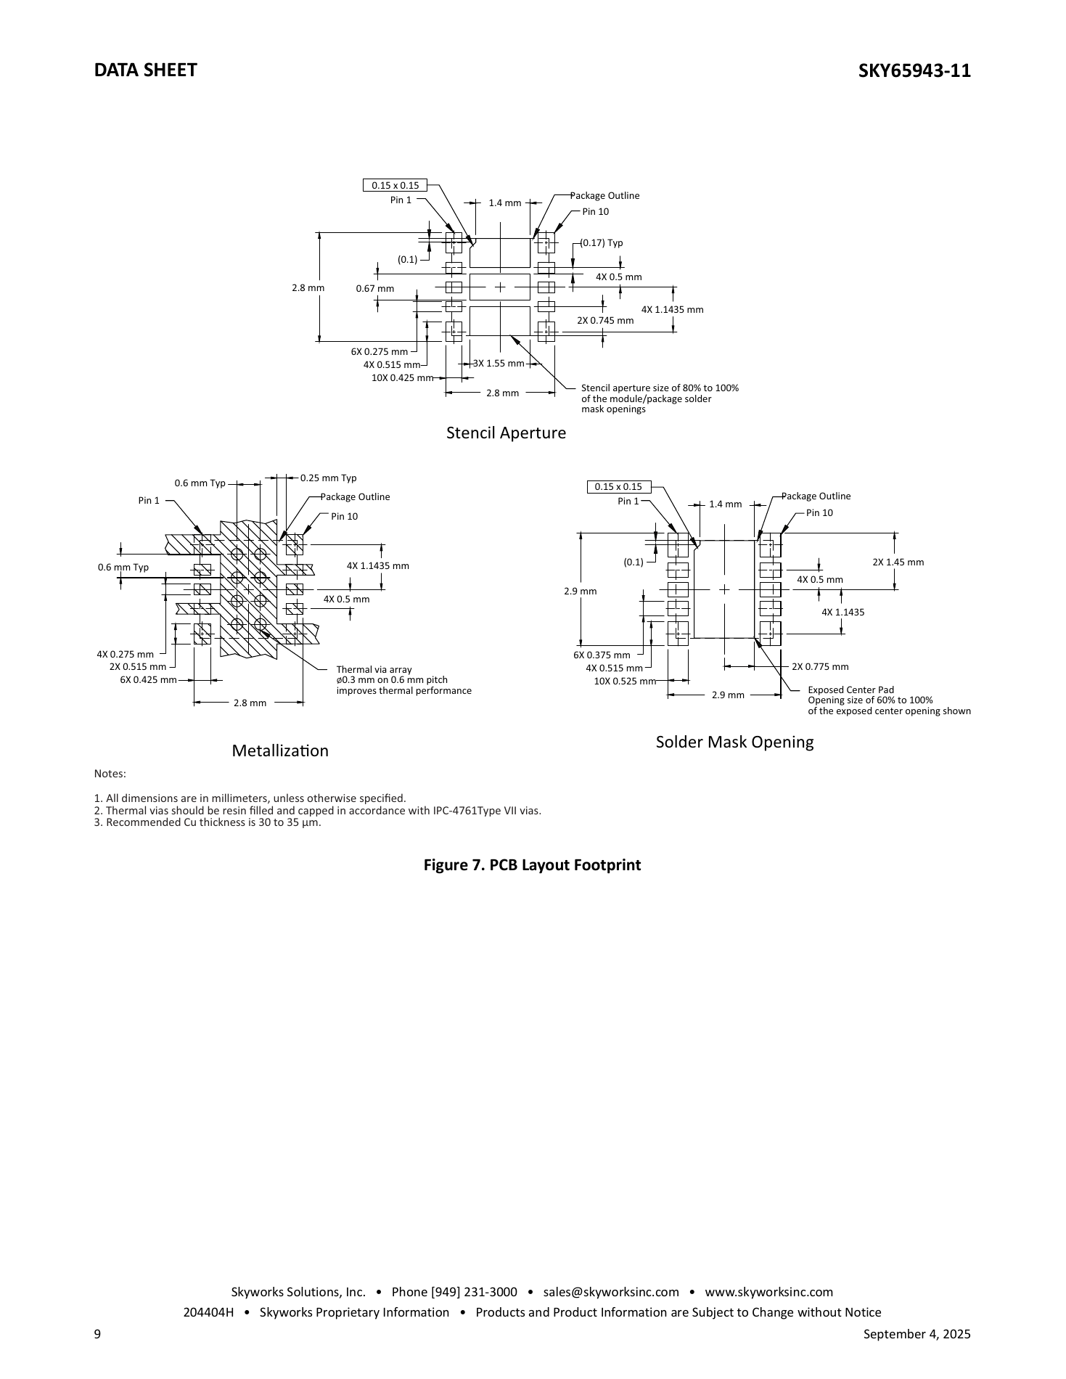
previews/sky65943-land-pattern.png
