gokselozgur5/pcb-design-collar-tracker/previews/vbat-detail.png

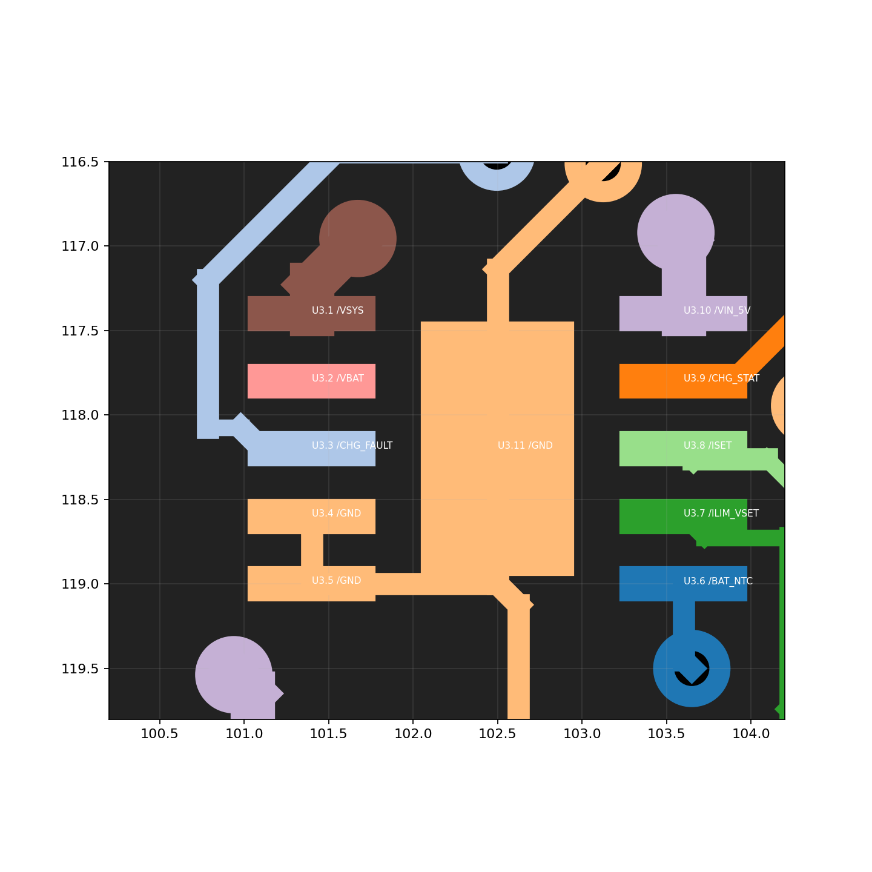
previews/vbat-detail.png
