gokselozgur5/pcb-design-collar-tracker/references/paul-nanosim-r04/SIM8051-D6-land.png

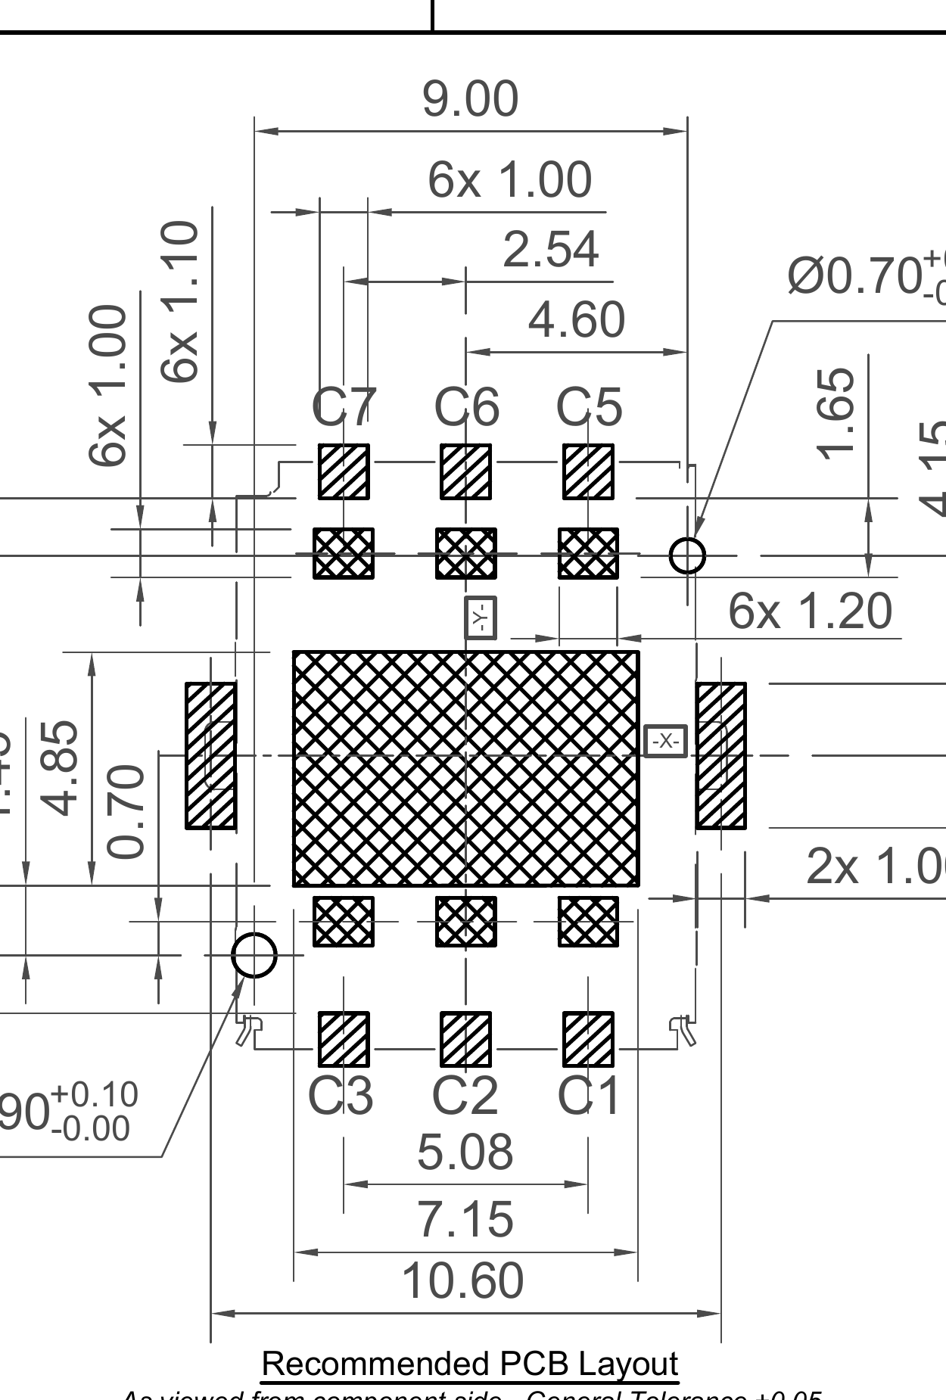
references/paul-nanosim-r04/SIM8051-D6-land.png
