gokselozgur5/pcb-design-collar-tracker/references/paul-nanosim-r04/SIM8051-land-detail.png

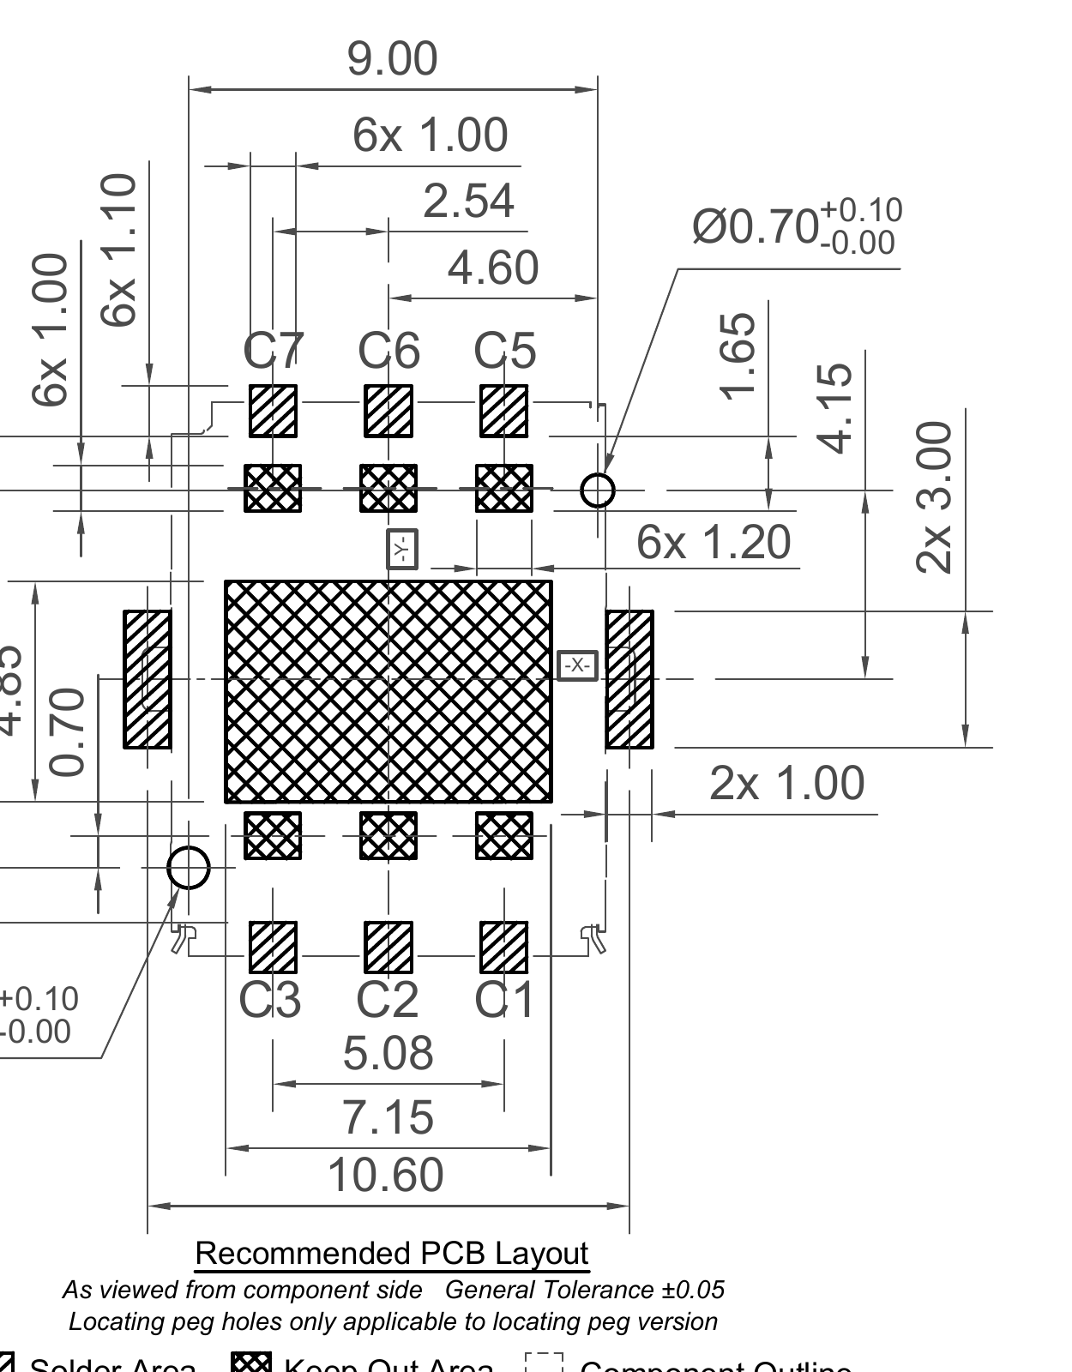
references/paul-nanosim-r04/SIM8051-land-detail.png
