gokselozgur5/pcb-design-collar-tracker/release/r05k-review/review.png

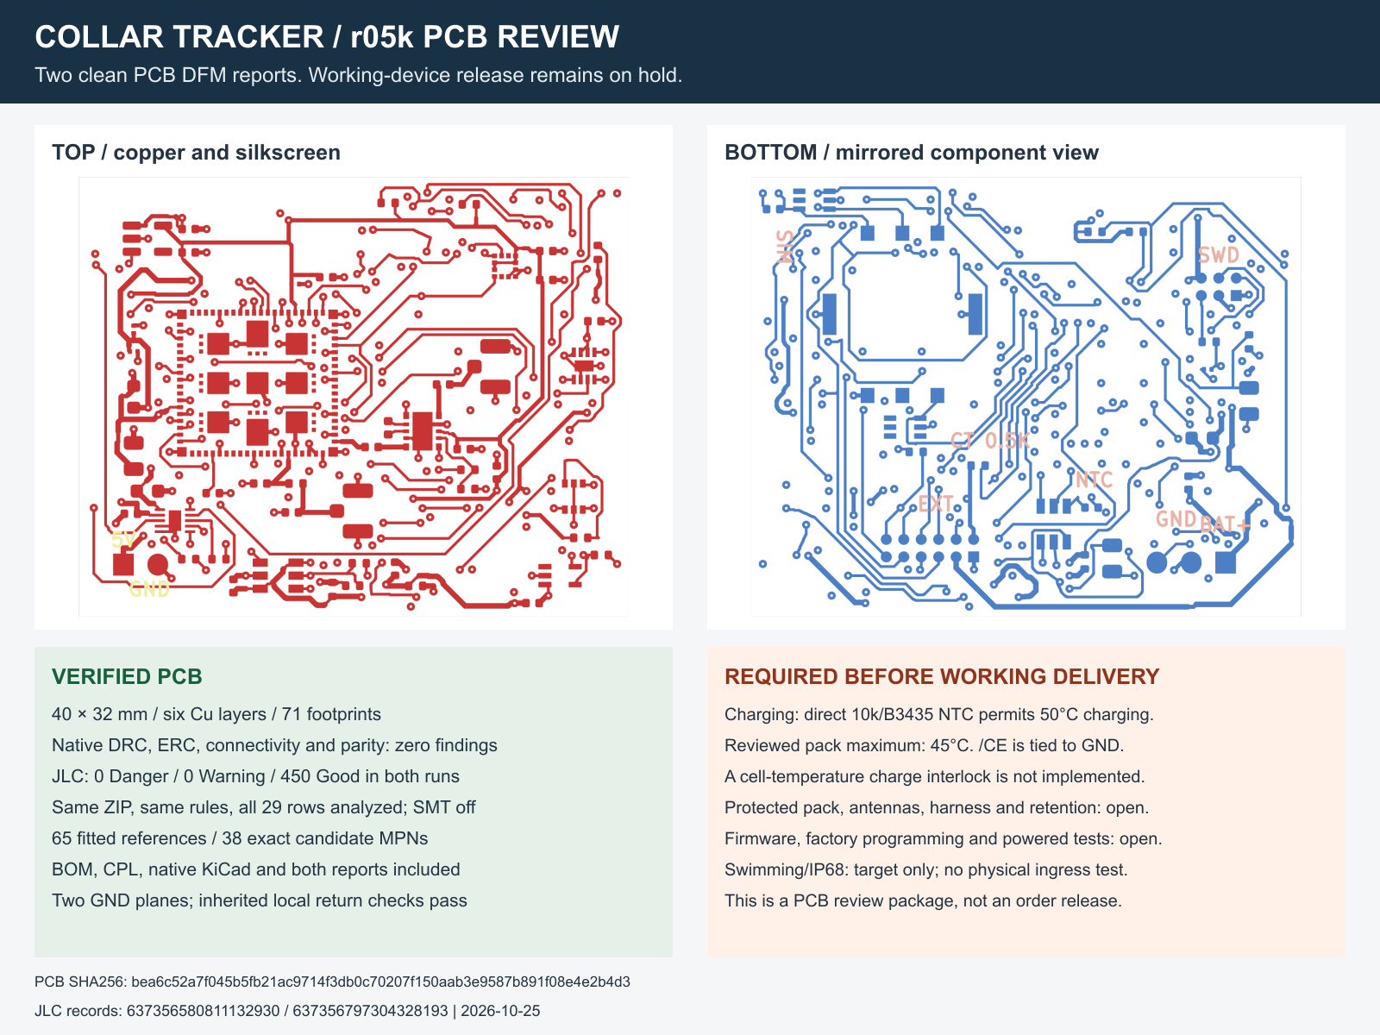
release/r05k-review/review.png
