gokselozgur5/pcb-design-collar-tracker/release/r05l-review/enclosure-review.png

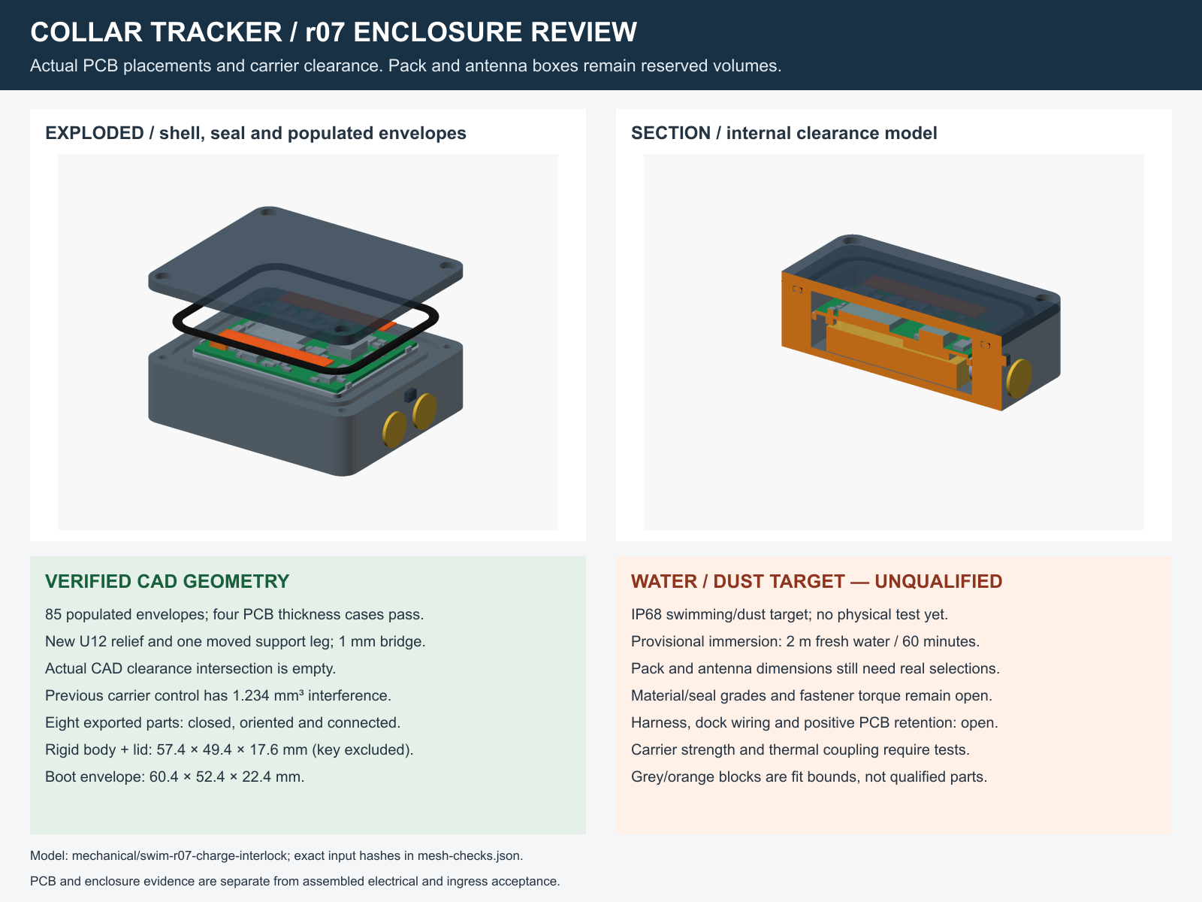
release/r05l-review/enclosure-review.png
