gokselozgur5/pcb-design-collar-tracker/release/r05l-review/pcb-review.png

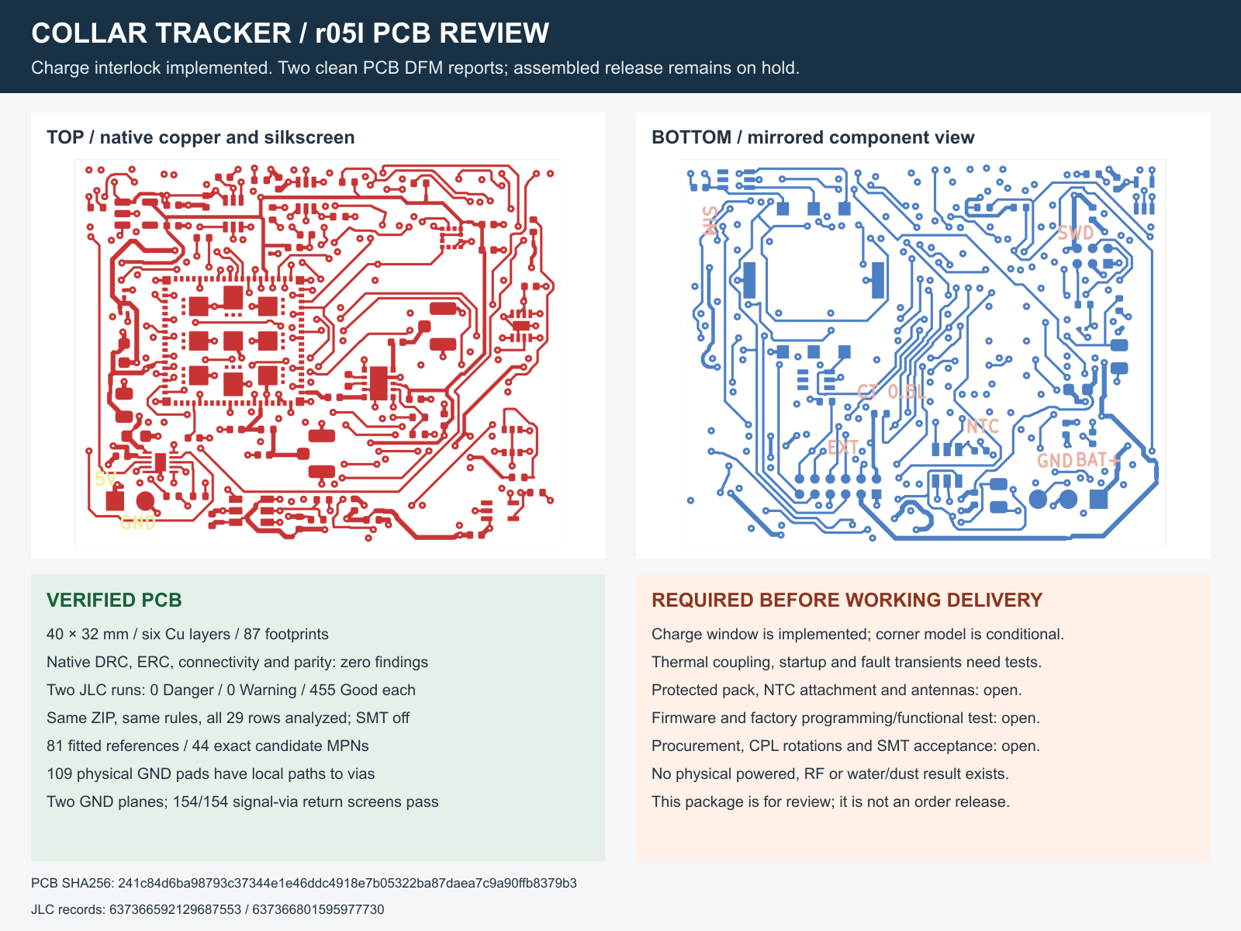
release/r05l-review/pcb-review.png
