gokselozgur5/pcb-design-collar-tracker/assembly/pcba-r04/bom.csv

Comment | Designator | Footprint | Quantity | Description
BLM18SD220SN1D | FB1 | 0603 | 1 | 22R @100MHz
BQ25185DLHR | U3 | Texas_DLH0010A_WSON-10-1EP_2.2x2mm_P0.4mm_EP0.9x1.5mm | 1 | BQ25185DLHR
CRCW040222R0FKEDHP | R21 | 0402 | 1 | 22R /1%
UM6K34NTCN | Q1 | SOT-363_SC-70-6 | 1 | UM6K34NTCN
GJM1555C1H390FB01D | C13,C14 | 0402 | 2 | 39pF RF
GRM033R60J104ME19D | C5,C8 | 0201 | 2 | 100nF
GRM033R61A105ME15D | C1,C2 | 0201 | 2 | 1uF /10V
GRM1555C1H102JA01D | C34,C35,C36 | 0402 | 3 | 1nF /50V C0G
GRM155R60J475ME47D | C6,C7 | 0402 | 2 | 4.7uF
GRM155R61A105KE15D | C16,C17,C19,C20,C21 | 0402 | 5 | 1uF; 1uF /10V
GRM155R71C104KA88D | C10,C15,C23,C24,C27,C28,C29,C30,C31,C32,C33 | 0402 | 11 | 100nF; 100nF /16V; 100nF /16V X7R
GRM155R71C473KA01D | C26 | 0402 | 1 | 47nF /16V X7R
GRM188R61A106MAALD | C18,C4 | 0603 | 2 | 10uF /10V
GRM21BR61A476ME15L | C3 | 0805 | 1 | 47uF /10V
GRM21BR71C105KA01L | C25,C9 | 0805 | 2 | 1uF /16V X7R
LIS2DW12TR | U5 | LGA-12_2x2mm_P0.5mm | 1 | LIS2DW12TR
LQW15AN9N1J00D | L1 | 0402 | 1 | 9.1nH
MAX17048G+T10 | U9 | MAX17048_T822_3_90_0065E | 1 | MAX17048G+T10
NRF9151-LACA-R | U1 | LGA_9151_12.1x11.1mm | 1 | nRF9151-LACA
RC0402FR-07100KL | R14,R15,R23,R28,R29,R30,R5 | 0402 | 7 | 100k; 100k /1%
RC0402FR-0710KL | R16,R20,R8,R9 | 0402 | 4 | 10k; 10k /1%
RC0402FR-0718KL | R6 | 0402 | 1 | 18k /1%
RC0402FR-071KL | R2,R4 | 0402 | 2 | 1k
RC0402FR-071ML | R22 | 0402 | 1 | 1M /1%
RC0402FR-0722KL | R1 | 0402 | 1 | 22k /1%
RC0402FR-073KL | R7 | 0402 | 1 | 3k /1%
RC0402FR-073M4L | R19 | 0402 | 1 | 3.4M /1%
RC0402FR-074K7L | R12,R13 | 0402 | 2 | 4.7k
RC0402JR-070RL | R3 | 0402 | 1 | 0R / tune
RT0402BRD07196KL | R24 | 0402 | 1 | 196k /0.1%
RT0402BRD07200KL | R17 | 0402 | 1 | 200k /0.1%
RT0402BRD0726K1L | R18 | 0402 | 1 | 26.1k /0.1%
RT0402BRD0727K4L | R26 | 0402 | 1 | 27.4k /0.1%
RT0402BRD0749K9L | R25,R27 | 0402 | 2 | 49.9k /0.1%
SIM8051-6-0-14-00-A | J6 | SIM8051_6_0_14_00_A | 1 | SIM8051-6-0-14-00-A
SKY65943-11 | U2 | SKY65943_DK10171 | 1 | SKY65943-11
SN74LVC1G00DCKR | U12 | TI_DCK0005A | 1 | SN74LVC1G00DCKR
SN74LVC1G14DCKR | U8 | SOT-353_SC-70-5 | 1 | SN74LVC1G14DCKR
TLV3012BIDCKR | U10,U11 | TI_DCK0006A | 2 | TLV3012BIDCKR / COLD; TLV3012BIDCKR / HOT
TPD4E1U06DCKR | D1,D2 | TPD4E1U06DCKR | 2 | TPD4E1U06DCKR
TPS3808G01DBVR | U6 | SOT-23-6 | 1 | TPS3808G01DBVR
TPS3808G30DBVR | U7 | SOT-23-6 | 1 | TPS3808G30DBVR
TPS7A0218PDBVR | U4 | SOT-23-5 | 1 | TPS7A0218PDBVR
U.FL-R-SMT-1(10) | J1,J2 | U.FL_Hirose_U.FL-R-SMT-1_Vertical | 2 | GNSS antenna / passive; LTE antenna / 50R
