gokselozgur5/pcb-design-collar-tracker/assembly/pack-antenna-r02/external-candidate-bom.csv

Reference | Quantity | Manufacturer or Supplier | Part Number | Configuration | Status
A1 | 1 | Synzen | SZK-C-3L30 | CAPH LTE FPC; nominal 100 mm 1.13 mm coax; MHF1 | Prototype fit candidate; adhesive / end datum / coax tolerance / RF qualification open
A2 | 1 | Synzen | SZK-C-0G04 | ZETA GNSS FPC; nominal 100 mm 1.13 mm coax; MHF1 | Prototype fit candidate; length tolerance / end datum / RF qualification open
S1-S4 | 4 | Vital Parts | SCH84-M2-20-A2 | M2 x 20 DIN 84 A2; 3.8 mm diameter x 1.3 mm high head | Prototype dimensional candidate; drawing tolerance / torque / corrosion qualification open
