gokselozgur5/pcb-design-collar-tracker/experiments/power-r05j-rf-junctions/hardware/bom.csv

ref | value | mpn | footprint | dnp | onboard | status
U1 | nRF9151-LACA | NRF9151-LACA-R | Collar033:U1_LGA_9151_12.1x11.1mm | False | True | candidate; LTE-M carrier unresolved
FB1 | 22R @100MHz | BLM18SD220SN1 | Collar033:FB1_L_0603_1608Metric | False | True | Nordic recommended filter; verify rail impedance
C1 | 1uF /10V | GRM033R61A105ME15 | Collar033:C1_C_0201_0603Metric | False | True | candidate
C2 | 1uF /10V | GRM033R61A105ME15 | Collar033:C2_C_0201_0603Metric | False | True | candidate
C3 | 47uF /10V | GRM21BR61A476ME15 | Collar033:C3_C_0805_2012Metric | False | True | candidate
C4 | 10uF /10V | GRM188R61A106MAAL | Collar033:C4_C_0603_1608Metric | False | True | candidate
C5 | 100nF | GRM033R60J104ME19 | Collar033:C5_C_0201_0603Metric | False | True | candidate
C6 | 4.7uF | GRM155R60J475ME47 | Collar033:C6_C_0402_1005Metric | False | True | candidate
C7 | 4.7uF | GRM155R60J475ME47 | Collar033:C7_C_0402_1005Metric | False | True | candidate
C8 | 100nF |  | Collar033:C8_C_0201_0603Metric | False | True | candidate
R1 | 22k /1% |  | Collar033:R1_R_0402_1005Metric | False | True | Power sequencing resistor; exact AVL pending
C9 | 1uF /16V X7R | GRM21BR71C105KA01L | Collar05:C9_C_0805_2012Metric | False | True | Candidate; effective C 0.60 to 1.265 uF must be qualified
R2 | 1k |  | Collar033:R2_R_0402_1005Metric | False | True | candidate
C10 | 100nF |  | Collar033:C10_C_0402_1005Metric | False | True | SIM supply decoupling beside the upper contact row
R3 | 0R / tune |  | Collar033:R3_R_0402_1005Metric | False | True | candidate
C11 | DNP / tune |  | Collar033:C11_C_0402_1005Metric | True | True | candidate
C12 | DNP / tune |  | Collar033:C12_C_0402_1005Metric | True | True | candidate
J1 | LTE antenna / 50R | U.FL-R-SMT-1(10) | Collar033:J1_U.FL_Hirose_U.FL-R-SMT-1_Vertical | False | True | bench connector; final FPC antenna TBD
U2 | SKY65943-11 | SKY65943-11 | Collar033:U2_SKY65943_DK10171 | False | True | DFM layout candidate; electrical validation pending
L1 | 9.1nH | LQW15AN9N1J00D | Collar033:L1_L_0402_1005Metric | False | True | candidate
C13 | 39pF RF |  | Collar033:C13_C_0402_1005Metric | False | True | candidate
C14 | 39pF RF |  | Collar033:C14_C_0402_1005Metric | False | True | candidate
J2 | GNSS antenna / passive | U.FL-R-SMT-1(10) | Collar033:J2_U.FL_Hirose_U.FL-R-SMT-1_Vertical | False | True | bench connector; final antenna/ESD TBD
R4 | 1k |  | Collar033:R4_R_0402_1005Metric | False | True | candidate
R5 | 100k |  | Collar033:R5_R_0402_1005Metric | False | True | candidate
C15 | 100nF |  | Collar033:C15_C_0402_1005Metric | False | True | candidate
C16 | 1uF |  | Collar033:C16_C_0402_1005Metric | False | True | candidate
J3 | 5V charging input |  | Collar033:J3_Solder_1x02_P2.5mm | False | True | onboard contact pads; external device/fixture not selected
U3 | BQ25185DLHR | BQ25185DLHR | Collar033:U3_Texas_DLH0010A_WSON-10-1EP_2.2x2mm_P0.4mm_EP0.9x1.5mm | False | True | DFM layout candidate; electrical validation pending
J4 | Protected cell + NTC |  | Collar033:J4_Solder_1x03_P2.5mm | False | True | onboard contact pads; external device/fixture not selected
C17 | 1uF /10V |  | Collar033:C17_C_0402_1005Metric | False | True | candidate
C18 | 10uF /10V |  | Collar033:C18_C_0603_1608Metric | False | True | candidate
C19 | 1uF /10V |  | Collar033:C19_C_0402_1005Metric | False | True | candidate
R6 | 18k /1% |  | Collar033:R6_R_0402_1005Metric | False | True | 4.2V / 500mA input limit per BQ25185 table
R7 | 3k /1% |  | Collar033:R7_R_0402_1005Metric | False | True | 100mA provisional; battery approval required
R8 | 10k |  | Collar033:R8_R_0402_1005Metric | False | True | candidate
R9 | 10k |  | Collar033:R9_R_0402_1005Metric | False | True | candidate
U4 | TPS7A0218PDBVR | TPS7A0218PDBVR | Collar033:U4_SOT-23-5 | False | True | GPIO supply enabled by U7; Q1 forces enable low on a power fault
C20 | 1uF |  | Collar033:C20_C_0402_1005Metric | False | True | candidate
C21 | 1uF |  | Collar033:C21_C_0402_1005Metric | False | True | candidate
U5 | LIS2DW12TR | LIS2DW12TR | Collar033:U5_LGA-12_2x2mm_P0.5mm | False | True | DFM layout candidate; electrical validation pending
C23 | 100nF |  | Collar033:C23_C_0402_1005Metric | False | True | candidate
C24 | 100nF |  | Collar033:C24_C_0402_1005Metric | False | True | candidate
R12 | 4.7k |  | Collar033:R12_R_0402_1005Metric | False | True | candidate
R13 | 4.7k |  | Collar033:R13_R_0402_1005Metric | False | True | candidate
J5 | DIGITAL health sensor interface |  | Collar033:J5_Contact_2x06_P1.27mm | False | True | onboard contact pads; external device/fixture not selected
R14 | 100k |  | Collar033:R14_R_0402_1005Metric | False | True | candidate
R15 | 100k |  | Collar033:R15_R_0402_1005Metric | False | True | candidate
J6 | SIM8051-6-0-14-00-A | SIM8051-6-0-14-00-A | Collar04:SIM8051_6_0_14_00_A | False | True | SMT removable nano-SIM; 1.8V UICC and LTE-M/NB-IoT service required
J7 | SWD / debug |  | Collar033:J7_Contact_2x03_P1.27mm | False | True | onboard contact pads; external device/fixture not selected
D1 | TPD4E1U06DCKR | TPD4E1U06DCKR | Collar04:TPD4E1U06DCKR | False | True | Three upper SIM contacts; short connector-side ESD routes
D2 | TPD4E1U06DCKR | TPD4E1U06DCKR | Collar04:TPD4E1U06DCKR | False | True | Lower SIM data contact; direct connector-to-ESD-to-modem route
U6 | TPS3808G01DBVR | TPS3808G01DBVR | Collar05:U6_SOT-23-6 | False | True | Power schematic candidate; footprint drawing and physical validation pending
U7 | TPS3808G30DBVR | TPS3808G30DBVR | Collar05:U7_SOT-23-6 | False | True | Power schematic candidate; footprint drawing and physical validation pending
U8 | SN74LVC1G14DCKR | SN74LVC1G14DCKR | Collar05:U8_SOT-353_SC-70-5 | False | True | Power schematic candidate; footprint drawing and physical validation pending
Q1 | DMN62D2UDW-7 | DMN62D2UDW-7 | Collar05:Q1_SOT-363_SC-70-6 | False | True | Power schematic candidate; footprint drawing and physical validation pending
U9 | MAX17048G+T10 | MAX17048G+T10 | Collar05:U9_MAX17048_T822_3_90_0065E | False | True | Power schematic candidate; footprint drawing and physical validation pending
R16 | 10k /1% |  | Collar05:R16_R_0402_1005Metric | False | True | Candidate; specified tolerance and exact AVL required
R17 | 1M /0.1% |  | Collar05:R17_R_0402_1005Metric | False | True | Candidate; specified tolerance and exact AVL required
R18 | 130k /0.1% |  | Collar05:R18_R_0402_1005Metric | False | True | Candidate; specified tolerance and exact AVL required
R19 | 16.9M /1% |  | Collar05:R19_R_0402_1005Metric | False | True | Candidate; specified tolerance and exact AVL required
R20 | 10k /1% |  | Collar05:R20_R_0402_1005Metric | False | True | Candidate; specified tolerance and exact AVL required
R21 | 22R /1% |  | Collar05:R21_R_0402_1005Metric | False | True | Candidate; specified tolerance and exact AVL required
R22 | 1M /1% |  | Collar05:R22_R_0402_1005Metric | False | True | Candidate; specified tolerance and exact AVL required
R23 | 100k /1% |  | Collar05:R23_R_0402_1005Metric | False | True | Candidate; specified tolerance and exact AVL required
C25 | 680nF /25V X7R | GRM219R71E684KA88D | Collar05:C25_C_0805_2012Metric | False | True | Candidate; effective capacitance and exact AVL require review
C26 | 47nF /16V X7R |  | Collar05:C26_C_0402_1005Metric | False | True | Candidate; effective capacitance and exact AVL require review
C27 | 100nF /16V X7R |  | Collar05:C27_C_0402_1005Metric | False | True | Candidate; effective capacitance and exact AVL require review
C28 | 100nF /16V X7R |  | Collar05:C28_C_0402_1005Metric | False | True | Candidate; effective capacitance and exact AVL require review
C29 | 100nF /16V X7R |  | Collar05:C29_C_0402_1005Metric | False | True | Candidate; effective capacitance and exact AVL require review
C30 | 100nF /16V X7R |  | Collar05:C30_C_0402_1005Metric | False | True | Candidate; effective capacitance and exact AVL require review
