gokselozgur5/pcb-design-collar-tracker/mechanical/universal-mount-r01/view-parts.png

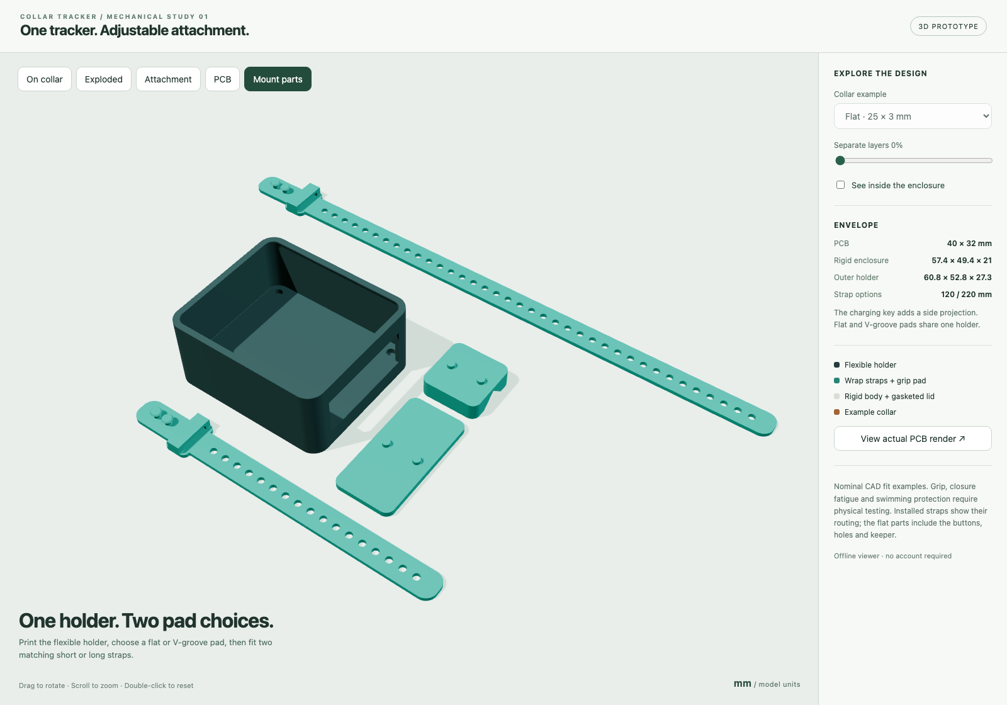
mechanical/universal-mount-r01/view-parts.png
