gokselozgur5/pcb-design-collar-tracker/assembly/internal-charge-r02/red-wire.stl

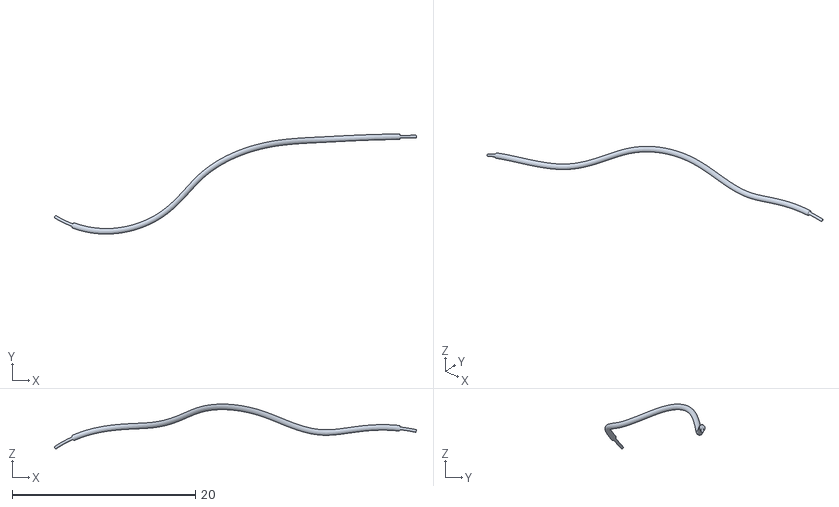
[picture p100: CAD file, 2026-10-26]
assembly/internal-charge-r02/red-wire.stl
39.5 x 10.9 x 4.89
