gokselozgur5/pcb-design-collar-tracker/assembly/internal-charge-r03/black-fixture.stl

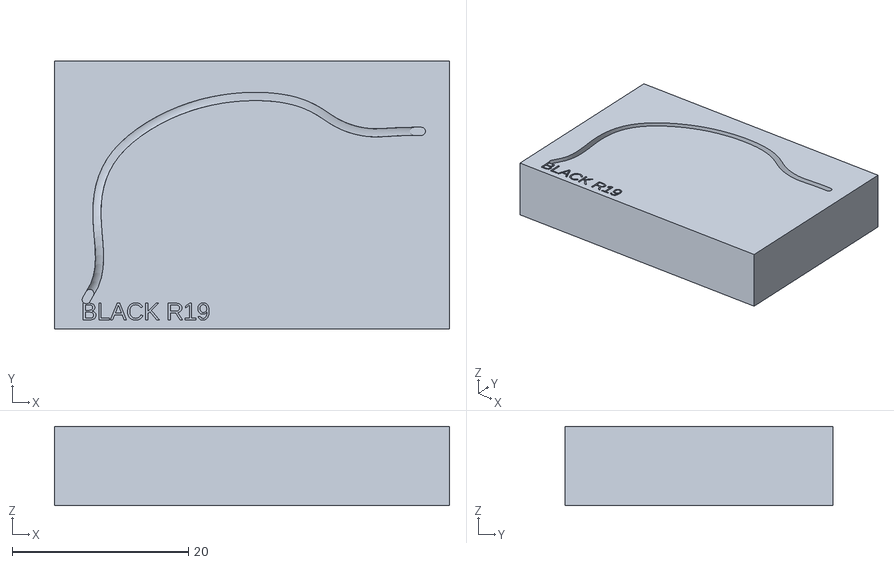
[picture p101: CAD file, 2026-10-26]
assembly/internal-charge-r03/black-fixture.stl
44.8 x 30.3 x 9.00
