gokselozgur5/pcb-design-collar-tracker/mechanical/reference-500-sizing-dummy.stl

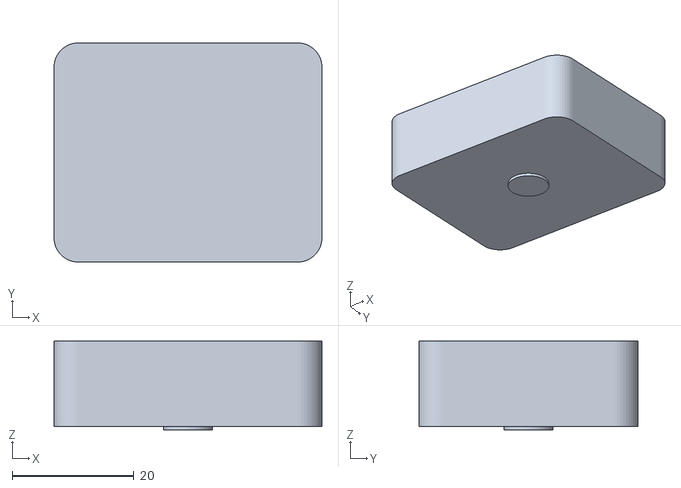
[picture p102: CAD file, 2026-10-25]
mechanical/reference-500-sizing-dummy.stl
44.0 x 36.0 x 14.6
