gokselozgur5/pcb-design-collar-tracker/mechanical/swim-r02-fit/dock.stl

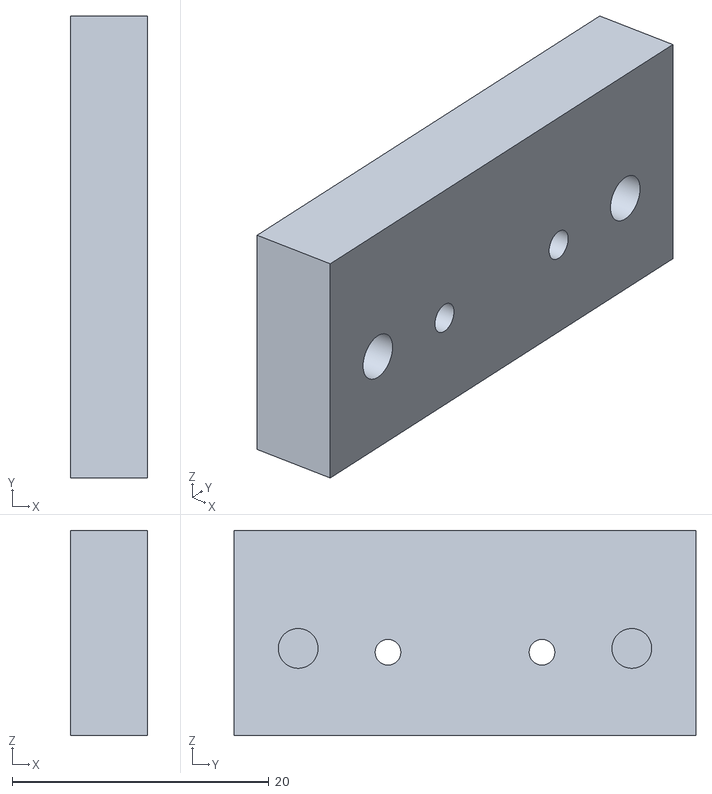
[picture p103: CAD file, 2026-10-25]
mechanical/swim-r02-fit/dock.stl
6.00 x 36.0 x 16.0
