gokselozgur5/pcb-design-collar-tracker/mechanical/swim-r08-antennas/evidence/initial-guide/intersection.stl

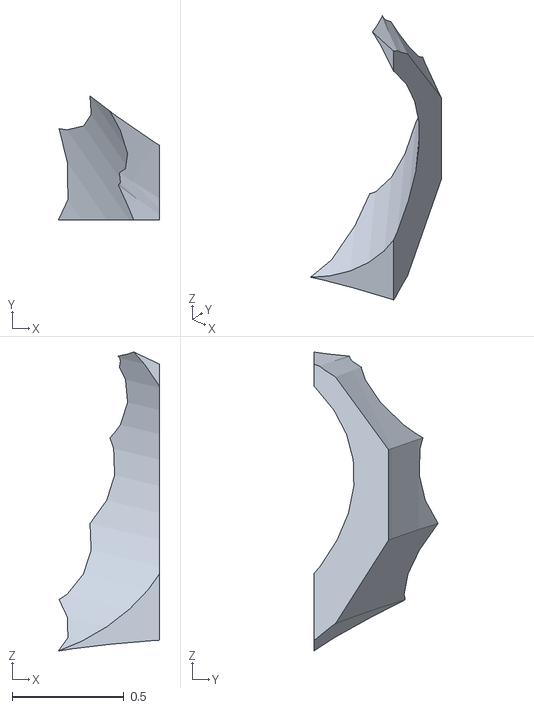
[picture p104: CAD file, 2026-10-25]
mechanical/swim-r08-antennas/evidence/initial-guide/intersection.stl
0.454 x 0.557 x 1.34
