gokselozgur5/pcb-design-collar-tracker/mechanical/swim-r08-antennas/evidence/straight-2mm-guide/intersection.stl

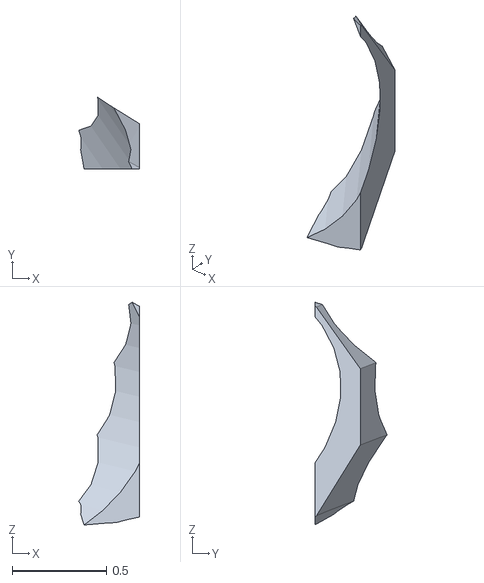
[picture p105: CAD file, 2026-10-25]
mechanical/swim-r08-antennas/evidence/straight-2mm-guide/intersection.stl
0.322 x 0.384 x 1.18
