gokselozgur5/pcb-design-collar-tracker/mechanical/swim-r11-thermal-fit/lid.stl

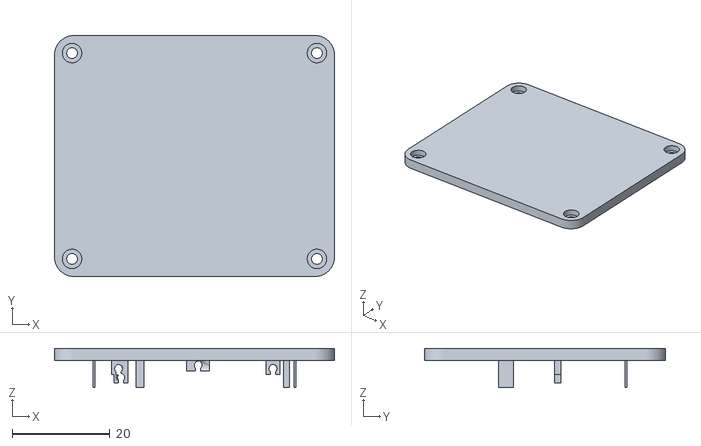
[picture p106: CAD file, 2026-10-25]
mechanical/swim-r11-thermal-fit/lid.stl
57.4 x 49.4 x 8.00
