gokselozgur5/pcb-design-collar-tracker/mechanical/swim-r12-pack-retention/body.stl

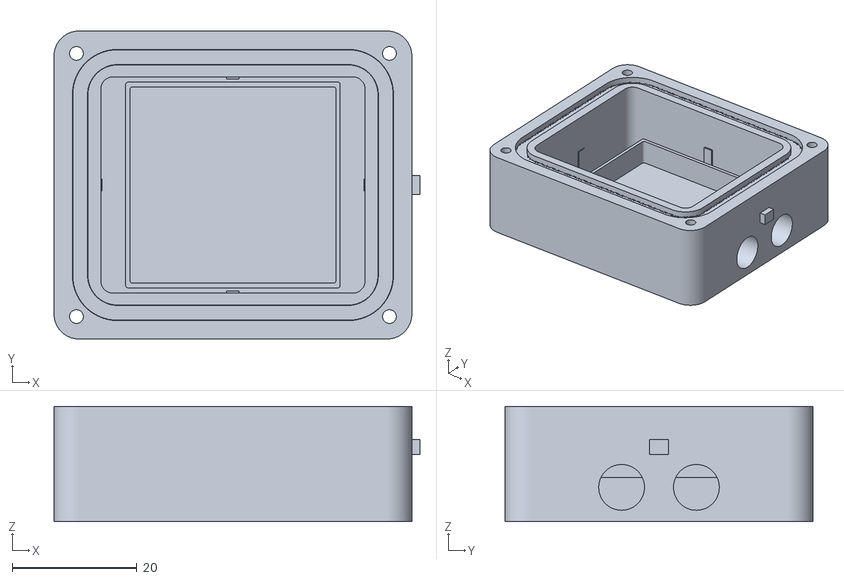
[picture p107: CAD file, 2026-10-25]
mechanical/swim-r12-pack-retention/body.stl
58.7 x 49.4 x 18.5
