gokselozgur5/pcb-design-collar-tracker/mechanical/swim-r13-charge-dock/evidence/initial-frame/collar-interference.stl

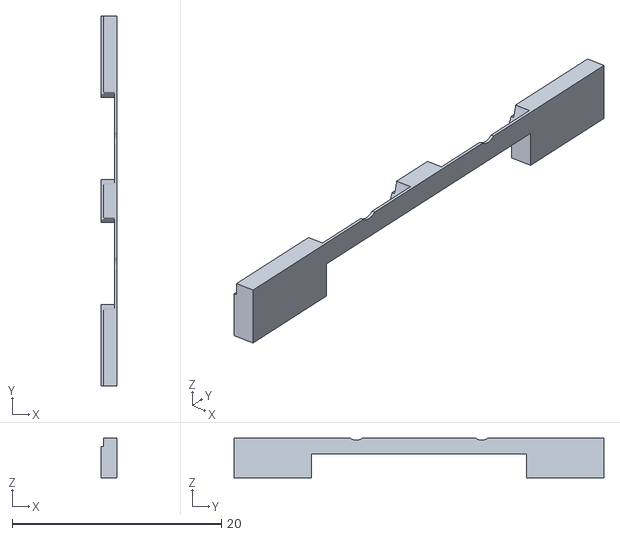
[picture p108: CAD file, 2026-10-25]
mechanical/swim-r13-charge-dock/evidence/initial-frame/collar-interference.stl
1.50 x 35.4 x 3.80
