gokselozgur5/pcb-design-collar-tracker/mechanical/swim-r14-wire-motion/lower.stl

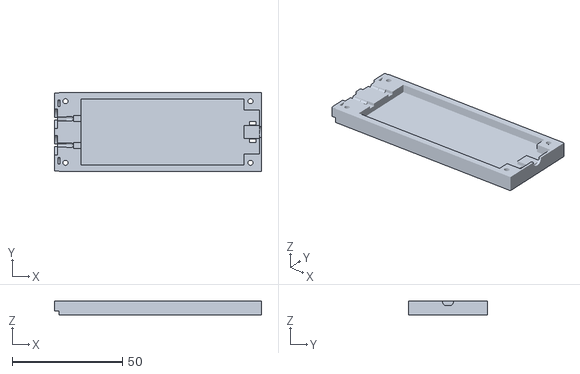
[picture p109: CAD file, 2026-10-26]
mechanical/swim-r14-wire-motion/lower.stl
94.0 x 36.0 x 6.50
