gokselozgur5/pcb-design-collar-tracker/mechanical/swim-r15-wire-clamp/lower.stl

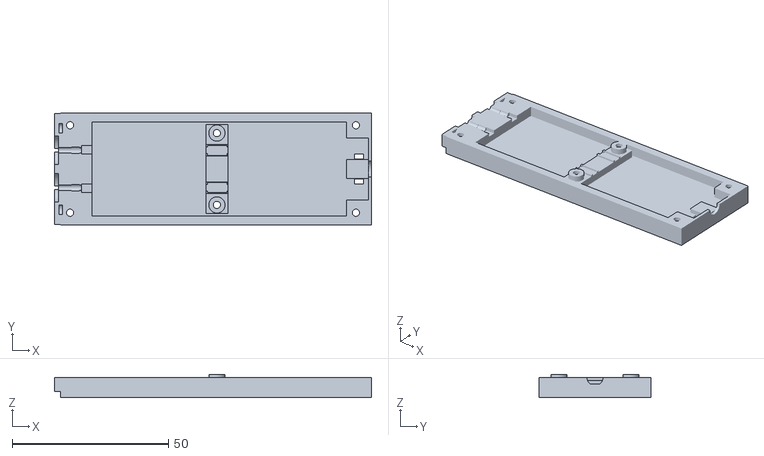
[picture p110: CAD file, 2026-10-26]
mechanical/swim-r15-wire-clamp/lower.stl
101.5 x 36.0 x 7.46
