gokselozgur5/pcb-design-collar-tracker/mechanical/swim-r16-contact-retention/evidence/initial-step/positive_terminal.stl

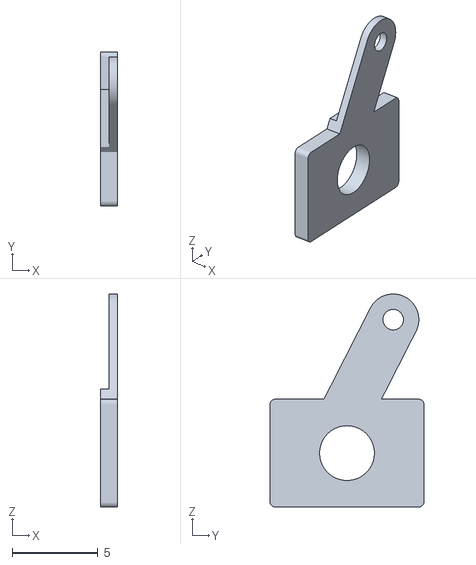
[picture p111: CAD file, 2026-10-26]
mechanical/swim-r16-contact-retention/evidence/initial-step/positive_terminal.stl
1 x 9.00 x 12.4
