gokselozgur5/pcb-design-collar-tracker/mechanical/swim-r17-cable-integration/gnss-guide-witness.stl

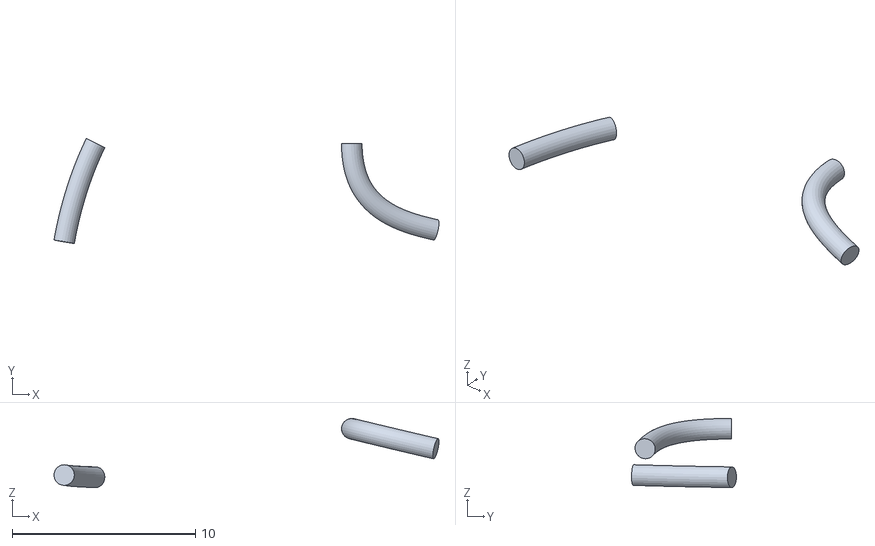
[picture p112: CAD file, 2026-10-26]
mechanical/swim-r17-cable-integration/gnss-guide-witness.stl
21.0 x 5.72 x 3.77
