gokselozgur5/pcb-design-collar-tracker/mechanical/universal-mount-r01/evidence/initial-flat-pad/flat_pad.stl

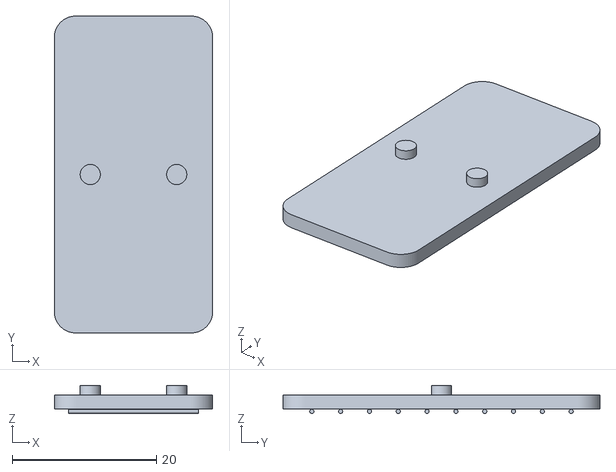
[picture p113: CAD file, 2026-10-26]
mechanical/universal-mount-r01/evidence/initial-flat-pad/flat_pad.stl
22.0 x 44.0 x 3.90
