gokselozgur5/pcb-design-collar-tracker/mechanical/universal-mount-r01/standard_collar.stl

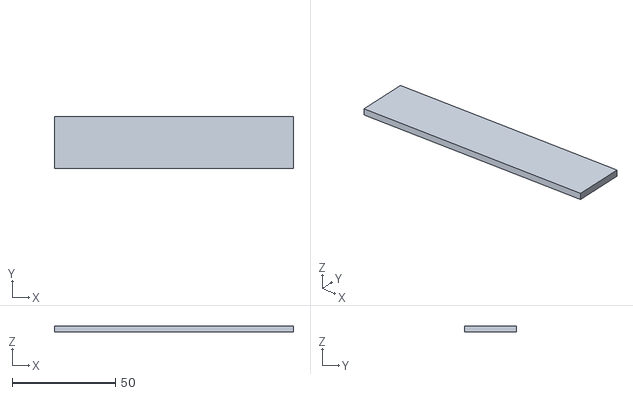
[picture p114: CAD file, 2026-10-26]
mechanical/universal-mount-r01/standard_collar.stl
116.0 x 25.0 x 3.00
