gokselozgur5/pcb-design-collar-tracker/assembly/internal-charge-r02/black-wire.stl

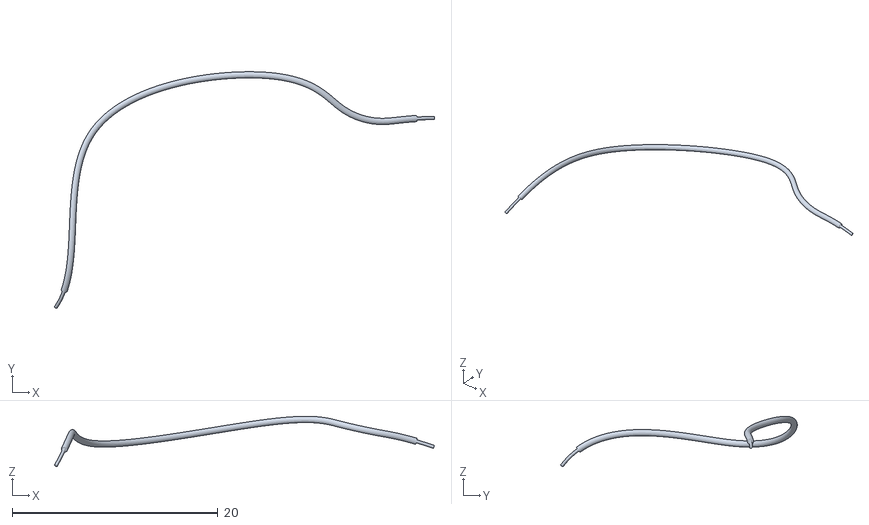
[picture p115: CAD file, 2026-10-26]
assembly/internal-charge-r02/black-wire.stl
37.0 x 23.0 x 4.90
