gokselozgur5/pcb-design-collar-tracker/assembly/internal-charge-r03/red-fixture-witness.stl

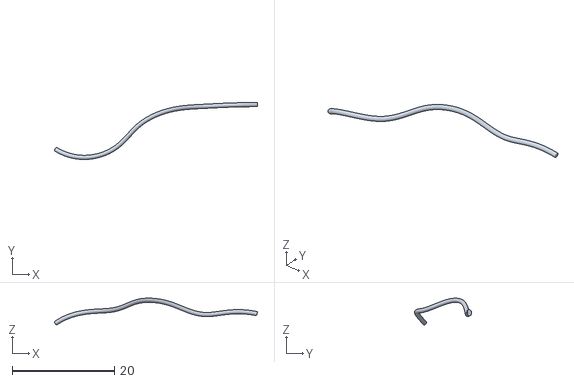
[picture p116: CAD file, 2026-10-26]
assembly/internal-charge-r03/red-fixture-witness.stl
39.8 x 11.2 x 5.23
