gokselozgur5/pcb-design-collar-tracker/mechanical/compact-250-sizing-dummy.stl

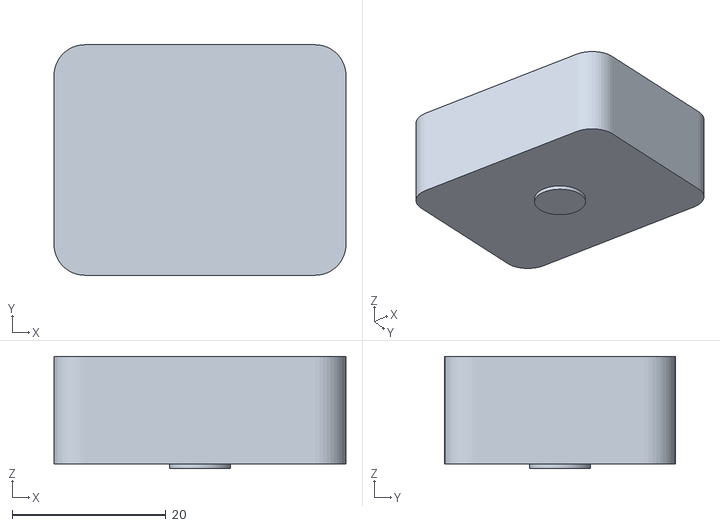
[picture p117: CAD file, 2026-10-25]
mechanical/compact-250-sizing-dummy.stl
38.0 x 30.0 x 14.6
