gokselozgur5/pcb-design-collar-tracker/mechanical/swim-r02-fit/carrier.stl

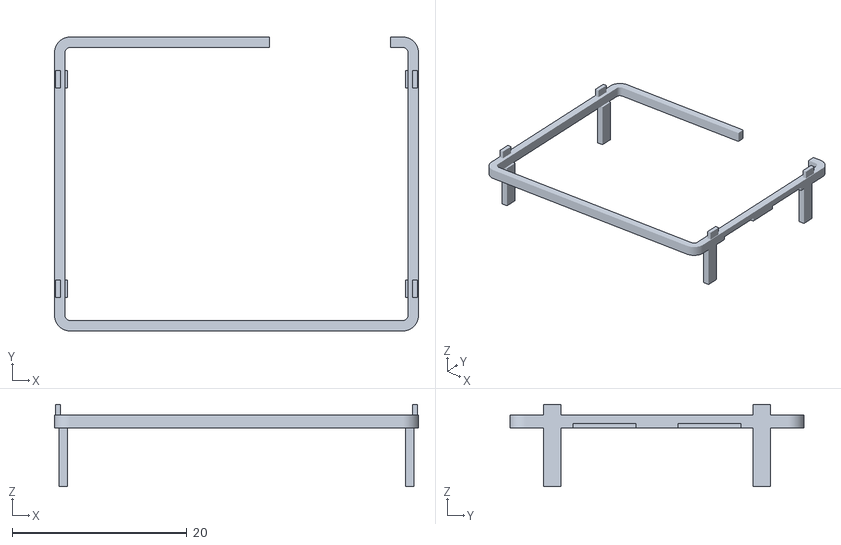
[picture p118: CAD file, 2026-10-25]
mechanical/swim-r02-fit/carrier.stl
41.6 x 33.6 x 9.40
