gokselozgur5/pcb-design-collar-tracker/mechanical/swim-r11-thermal-fit/contact.stl

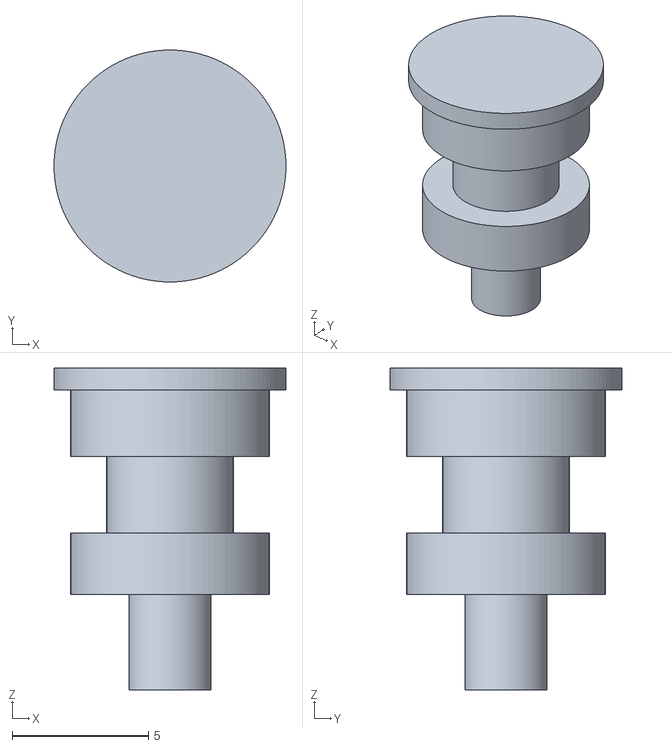
[picture p119: CAD file, 2026-10-25]
mechanical/swim-r11-thermal-fit/contact.stl
8.50 x 8.50 x 11.8
