gokselozgur5/pcb-design-collar-tracker/mechanical/swim-r12-pack-retention/carrier.stl

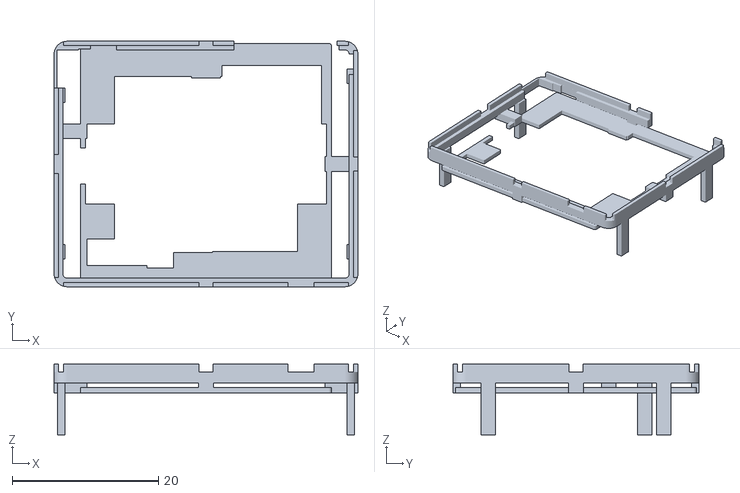
[picture p120: CAD file, 2026-10-25]
mechanical/swim-r12-pack-retention/carrier.stl
41.6 x 33.6 x 9.70
