gokselozgur5/pcb-design-collar-tracker/mechanical/swim-r13-charge-dock/body.stl

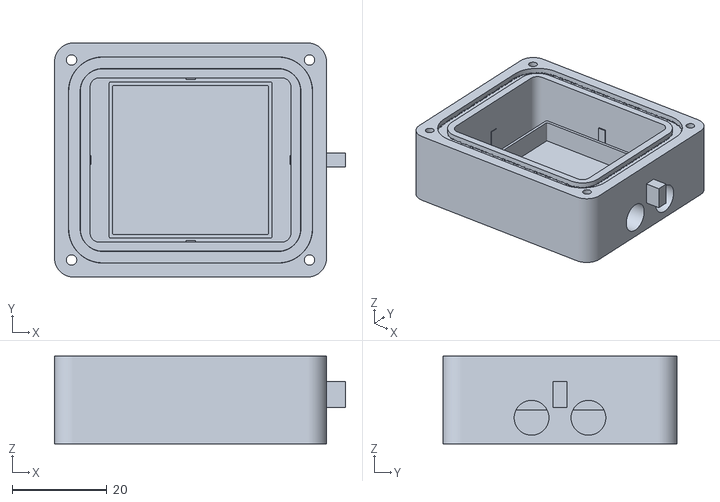
[picture p121: CAD file, 2026-10-25]
mechanical/swim-r13-charge-dock/body.stl
61.4 x 49.4 x 18.5
