gokselozgur5/pcb-design-collar-tracker/mechanical/swim-r14-wire-motion/upper.stl

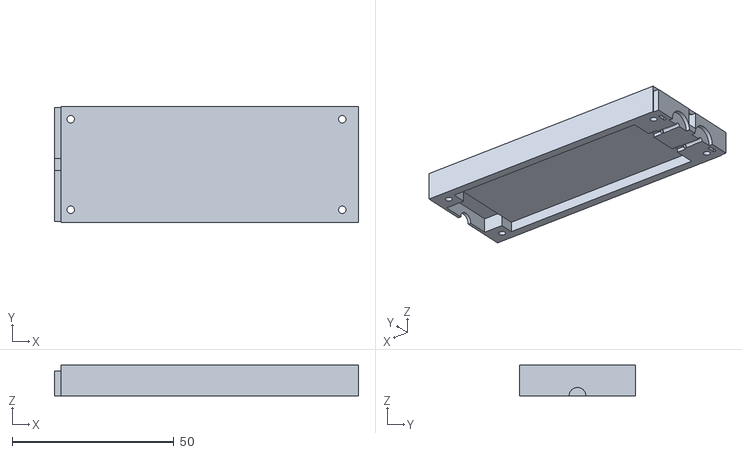
[picture p122: CAD file, 2026-10-26]
mechanical/swim-r14-wire-motion/upper.stl
94.0 x 36.0 x 9.50
