gokselozgur5/pcb-design-collar-tracker/mechanical/swim-r15-wire-clamp/fixture.stl

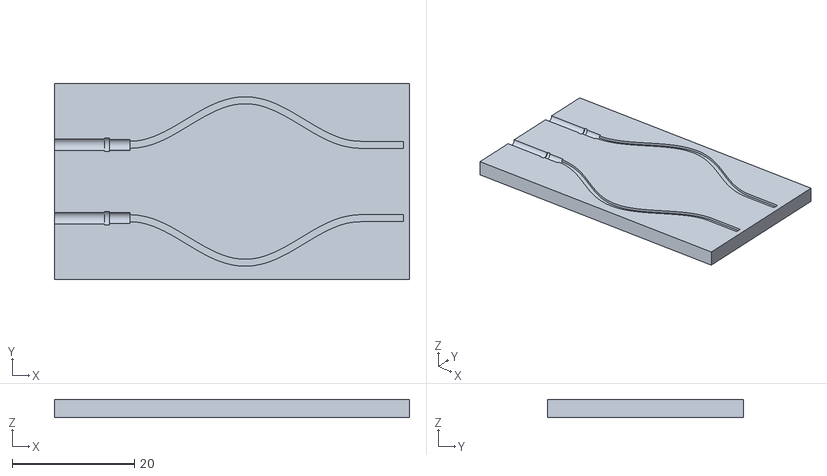
[picture p123: CAD file, 2026-10-26]
mechanical/swim-r15-wire-clamp/fixture.stl
58.0 x 32.0 x 3.00
