gokselozgur5/pcb-design-collar-tracker/mechanical/swim-r16-contact-retention/contact.stl

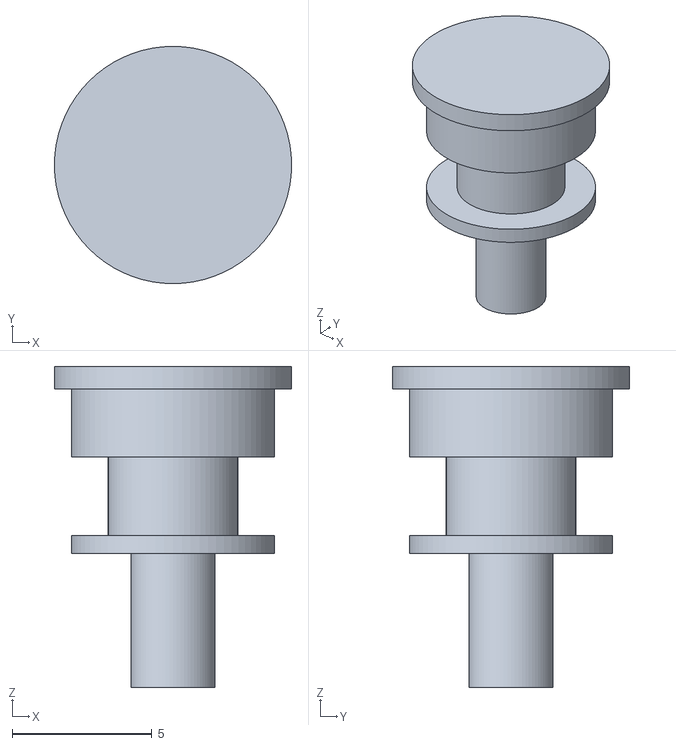
[picture p124: CAD file, 2026-10-26]
mechanical/swim-r16-contact-retention/contact.stl
8.50 x 8.50 x 11.5
