gokselozgur5/pcb-design-collar-tracker/mechanical/swim-r17-cable-integration/lte-guide-witness.stl

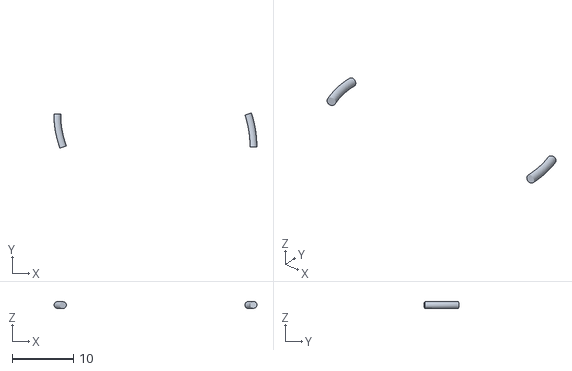
[picture p125: CAD file, 2026-10-26]
mechanical/swim-r17-cable-integration/lte-guide-witness.stl
33.2 x 5.75 x 1.17
