gokselozgur5/pcb-design-collar-tracker/mechanical/swim-r18-charge-clearance/retainer.stl

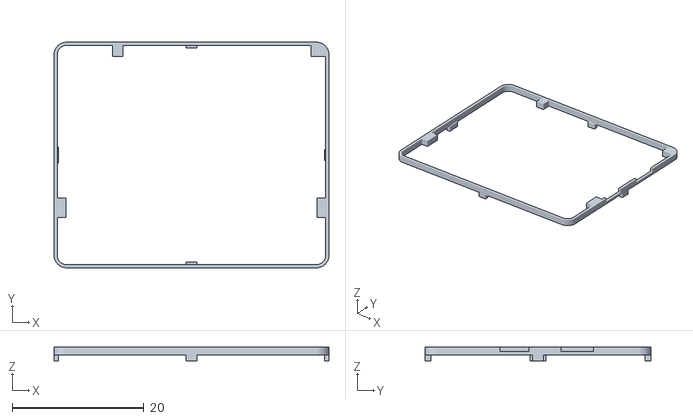
[picture p126: CAD file, 2026-10-26]
mechanical/swim-r18-charge-clearance/retainer.stl
41.8 x 34.3 x 2.10
