gokselozgur5/pcb-design-collar-tracker/mechanical/universal-mount-r01/evidence/initial-flat-pad/wide_pad_collar_collision.stl

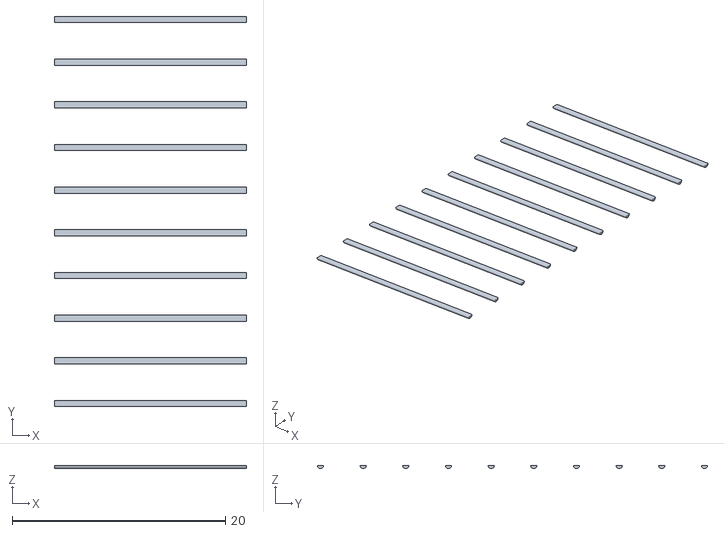
[picture p127: CAD file, 2026-10-26]
mechanical/universal-mount-r01/evidence/initial-flat-pad/wide_pad_collar_collision.stl
18.0 x 36.6 x 0.3
