gokselozgur5/pcb-design-collar-tracker/assembly/internal-charge-r03/red-fixture-wire.stl

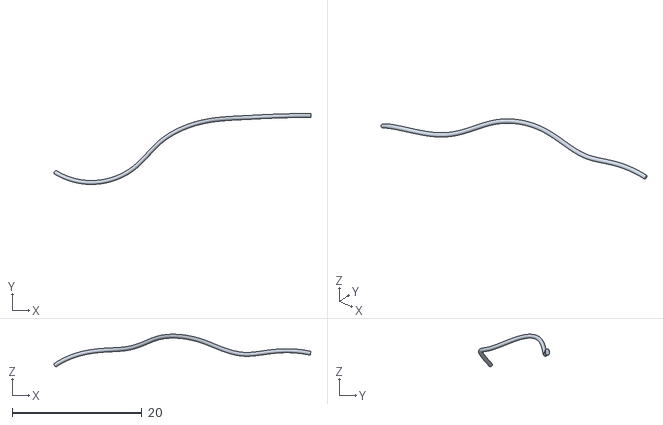
[picture p129: CAD file, 2026-10-26]
assembly/internal-charge-r03/red-fixture-wire.stl
39.7 x 10.9 x 5.03
