gokselozgur5/pcb-design-collar-tracker/mechanical/swim-r02-fit/body.stl

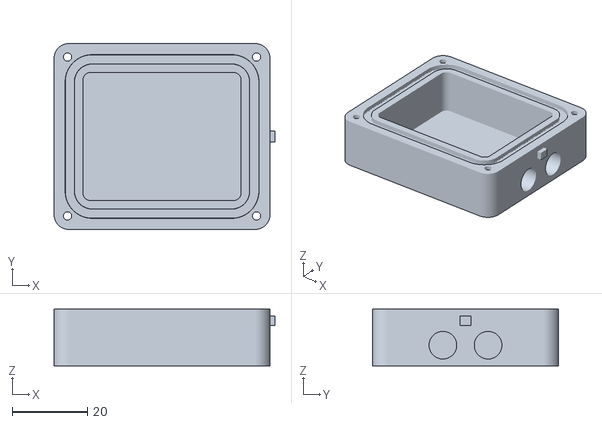
[picture p130: CAD file, 2026-10-25]
mechanical/swim-r02-fit/body.stl
58.7 x 49.4 x 15.1
