gokselozgur5/pcb-design-collar-tracker/mechanical/swim-r11-thermal-fit/boot.stl

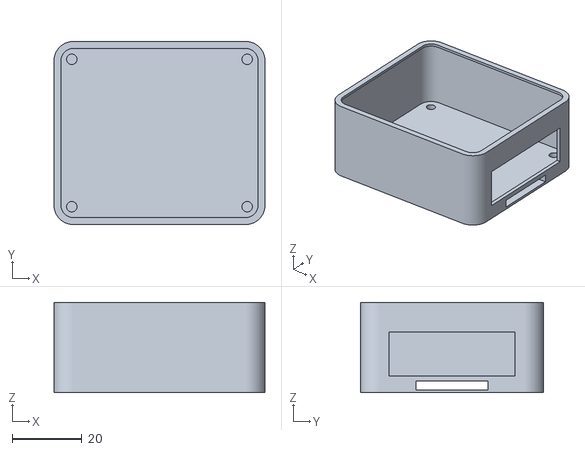
[picture p131: CAD file, 2026-10-25]
mechanical/swim-r11-thermal-fit/boot.stl
60.4 x 52.4 x 25.8
