gokselozgur5/pcb-design-collar-tracker/mechanical/swim-r15-wire-clamp/cap.stl

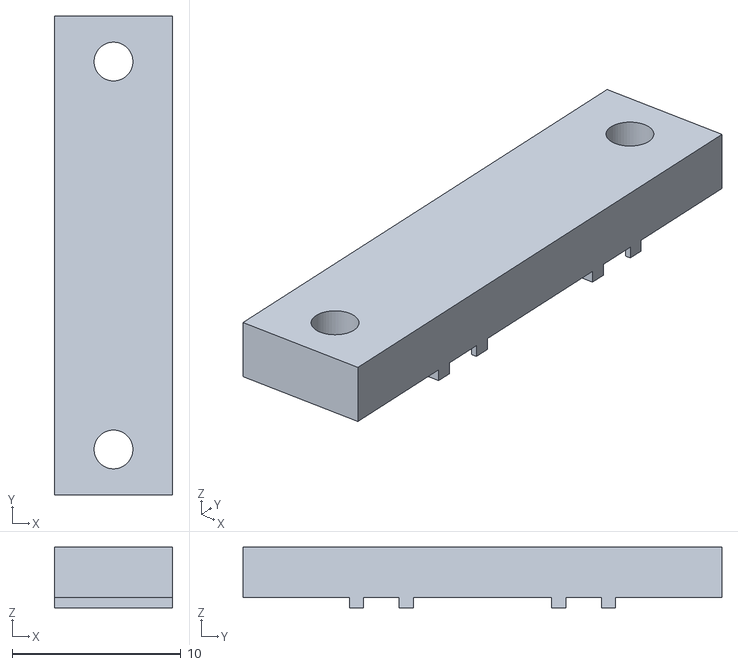
[picture p132: CAD file, 2026-10-26]
mechanical/swim-r15-wire-clamp/cap.stl
7.00 x 28.4 x 3.60
