gokselozgur5/pcb-design-collar-tracker/mechanical/swim-r18-charge-clearance/black-wire.stl

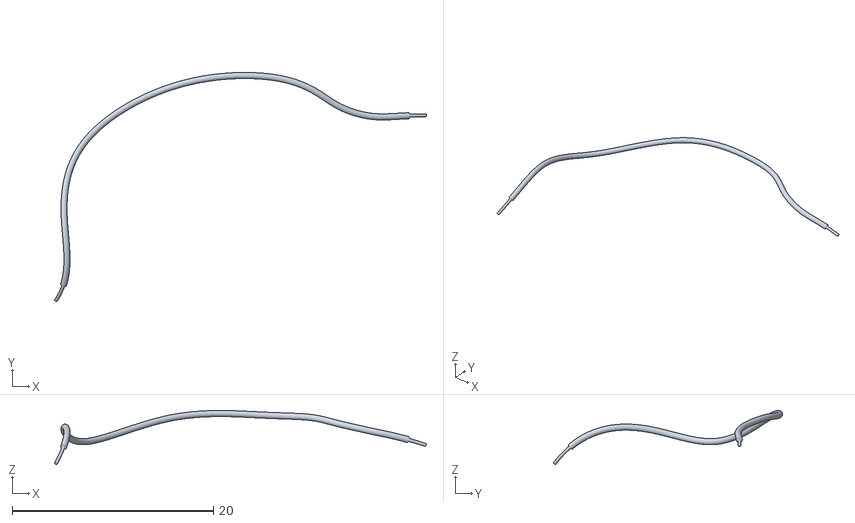
[picture p133: CAD file, 2026-10-26]
mechanical/swim-r18-charge-clearance/black-wire.stl
37.0 x 22.8 x 5.37
