gokselozgur5/pcb-design-collar-tracker/mechanical/universal-mount-r01/evidence/initial-flat-pad/narrow_pad_collar_collision.stl

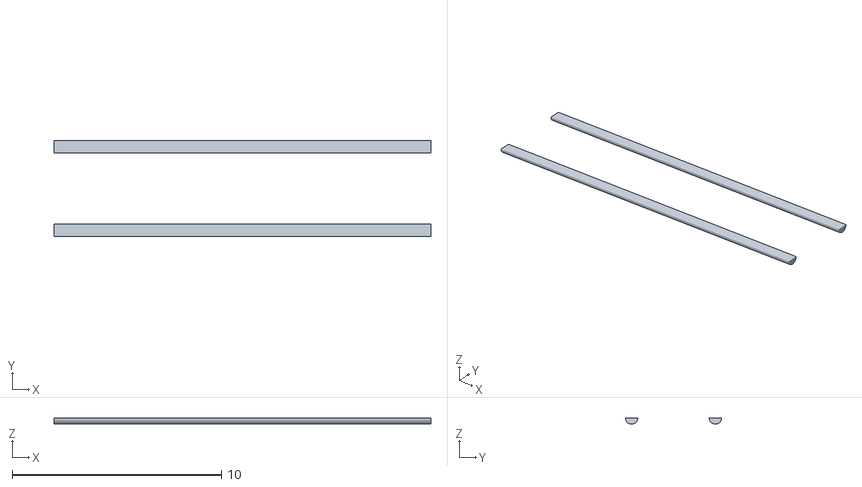
[picture p134: CAD file, 2026-10-26]
mechanical/universal-mount-r01/evidence/initial-flat-pad/narrow_pad_collar_collision.stl
18.0 x 4.60 x 0.3
