gokselozgur5/pcb-design-collar-tracker/mechanical/universal-mount-r01/pcb_substrate.stl

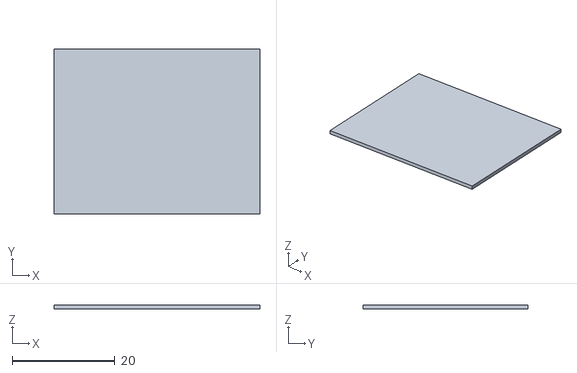
[picture p135: CAD file, 2026-10-26]
mechanical/universal-mount-r01/pcb_substrate.stl
40.0 x 32.0 x 0.841
