gokselozgur5/pcb-design-collar-tracker/assembly/internal-charge-r03/black-fixture-witness.stl

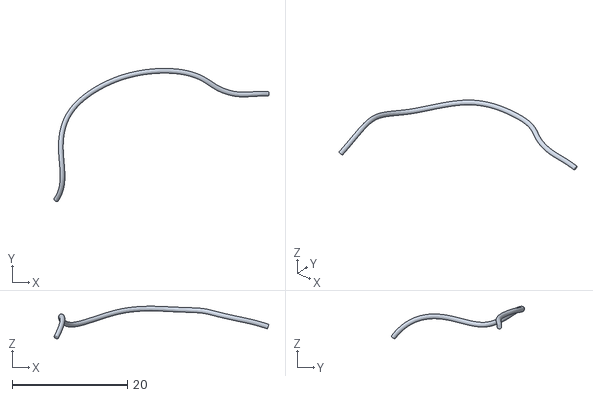
[picture p136: CAD file, 2026-10-26]
assembly/internal-charge-r03/black-fixture-witness.stl
37.3 x 23.1 x 5.65
