gokselozgur5/pcb-design-collar-tracker/mechanical/swim-r18-charge-clearance/gnss-guide-witness.stl

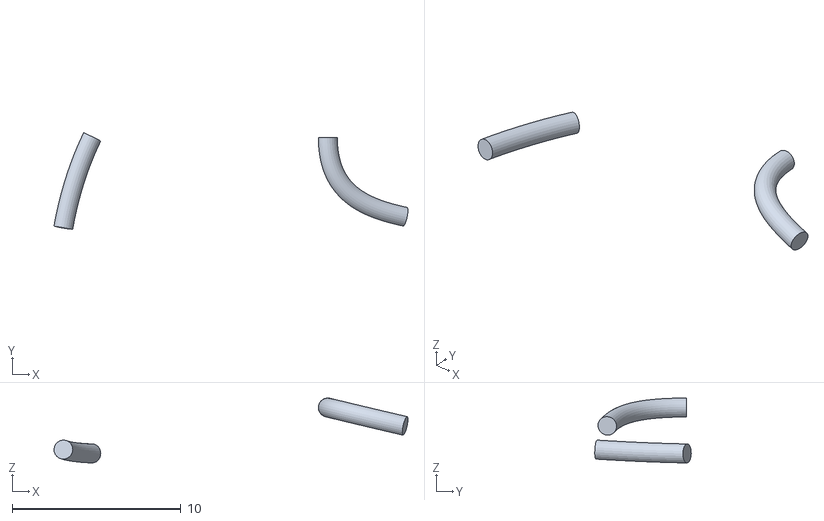
[picture p138: CAD file, 2026-10-26]
mechanical/swim-r18-charge-clearance/gnss-guide-witness.stl
21.0 x 5.73 x 3.85
