gokselozgur5/pcb-design-collar-tracker/mechanical/universal-mount-r01/evidence/initial-flat-pad/standard_pad_collar_collision.stl

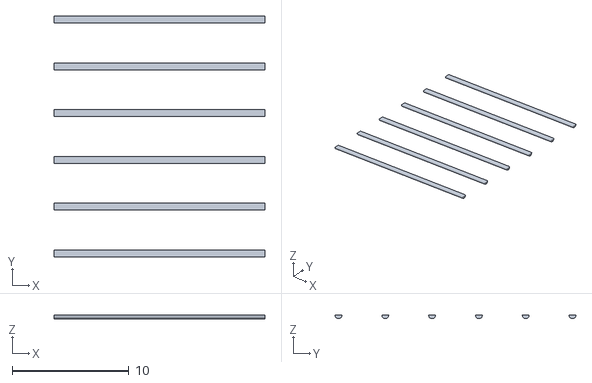
[picture p139: CAD file, 2026-10-26]
mechanical/universal-mount-r01/evidence/initial-flat-pad/standard_pad_collar_collision.stl
18.0 x 20.6 x 0.3
