gokselozgur5/pcb-design-collar-tracker/mechanical/universal-mount-r01/pcb_components.stl

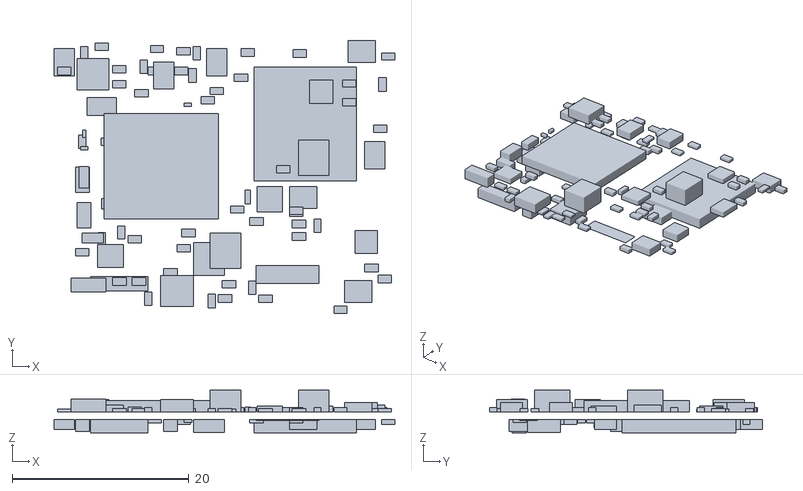
[picture p140: CAD file, 2026-10-26]
mechanical/universal-mount-r01/pcb_components.stl
38.6 x 30.9 x 4.84
