gokselozgur5/pcb-design-collar-tracker/assembly/internal-charge-r03/staking-envelopes.stl

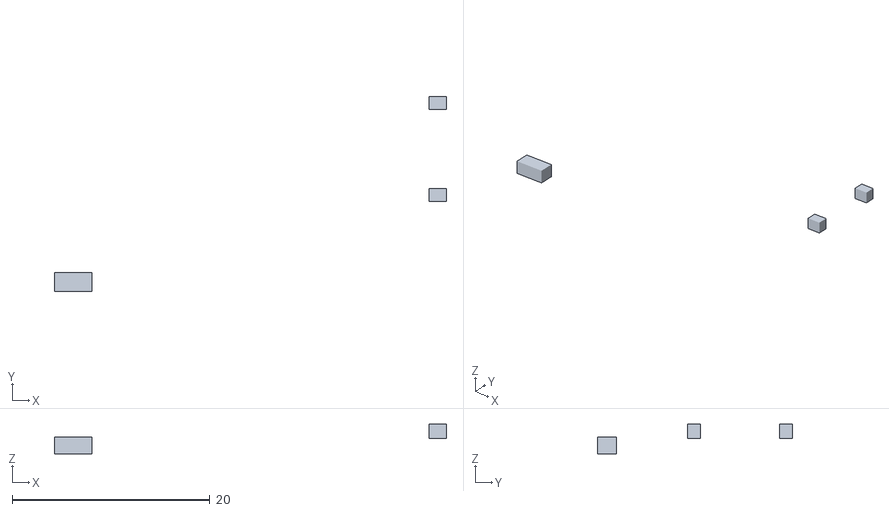
[picture p141: CAD file, 2026-10-26]
assembly/internal-charge-r03/staking-envelopes.stl
39.7 x 19.7 x 3.01
