gokselozgur5/pcb-design-collar-tracker/mechanical/swim-r02-fit/boot.stl

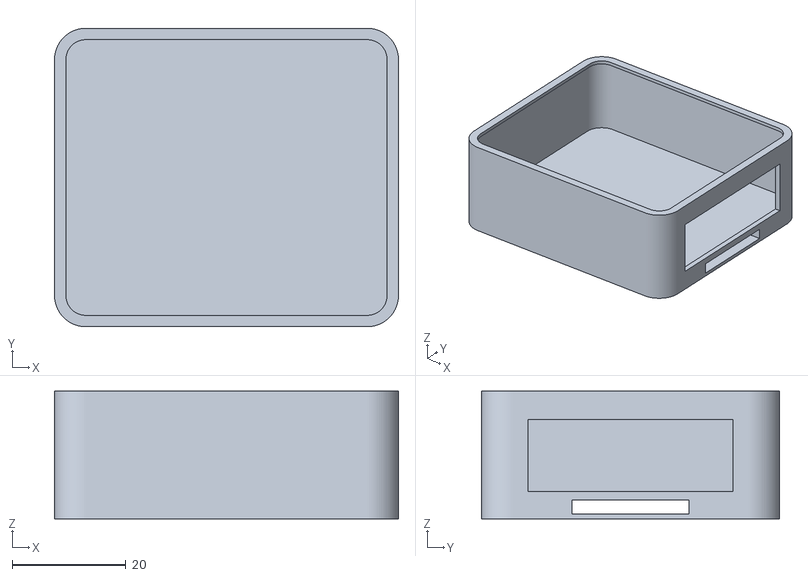
[picture p142: CAD file, 2026-10-25]
mechanical/swim-r02-fit/boot.stl
60.4 x 52.4 x 22.4
