gokselozgur5/pcb-design-collar-tracker/mechanical/universal-mount-r01/battery.stl

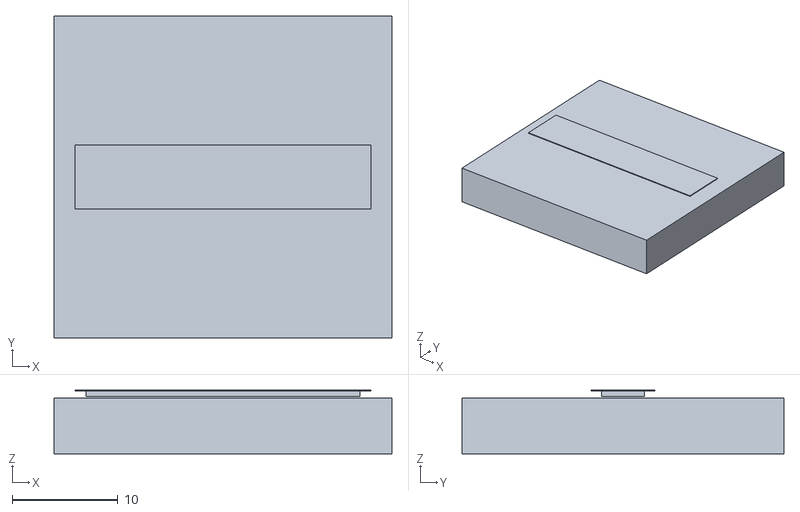
[picture p144: CAD file, 2026-10-26]
mechanical/universal-mount-r01/battery.stl
32.0 x 30.5 x 6.05
