gokselozgur5/pcb-design-collar-tracker/assembly/internal-charge-r03/black-fixture-wire.stl

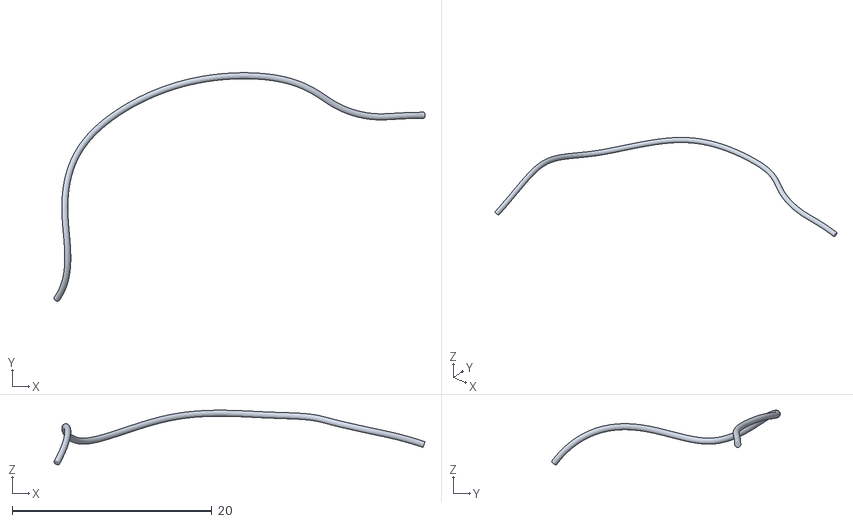
[picture p145: CAD file, 2026-10-26]
assembly/internal-charge-r03/black-fixture-wire.stl
37.2 x 22.9 x 5.47
