gokselozgur5/pcb-design-collar-tracker/mechanical/swim-r02-fit/lid.stl

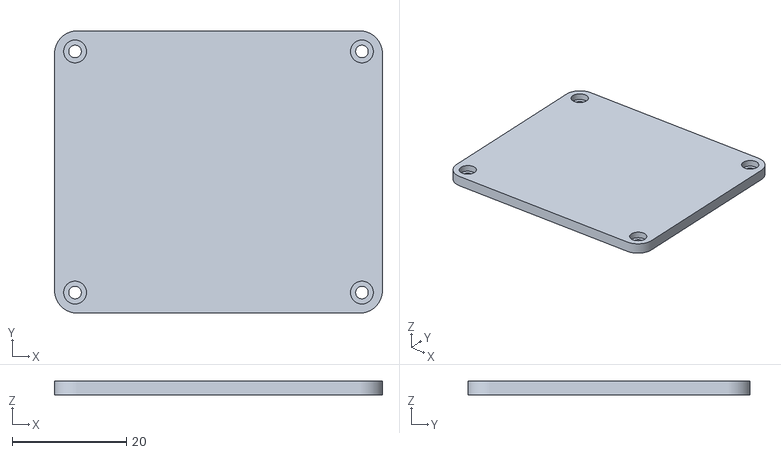
[picture p146: CAD file, 2026-10-25]
mechanical/swim-r02-fit/lid.stl
57.4 x 49.4 x 2.50
