gokselozgur5/pcb-design-collar-tracker/mechanical/swim-r11-thermal-fit/retainer.stl

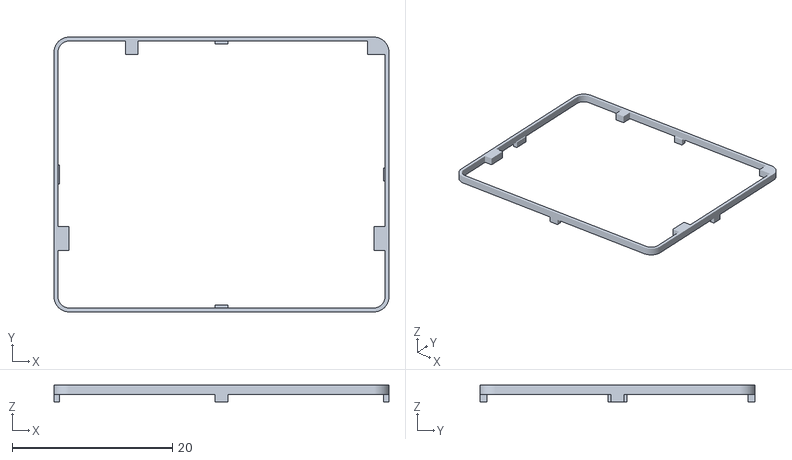
[picture p147: CAD file, 2026-10-25]
mechanical/swim-r11-thermal-fit/retainer.stl
41.8 x 34.3 x 2.10
