gokselozgur5/pcb-design-collar-tracker/mechanical/universal-mount-r01/gasket.stl

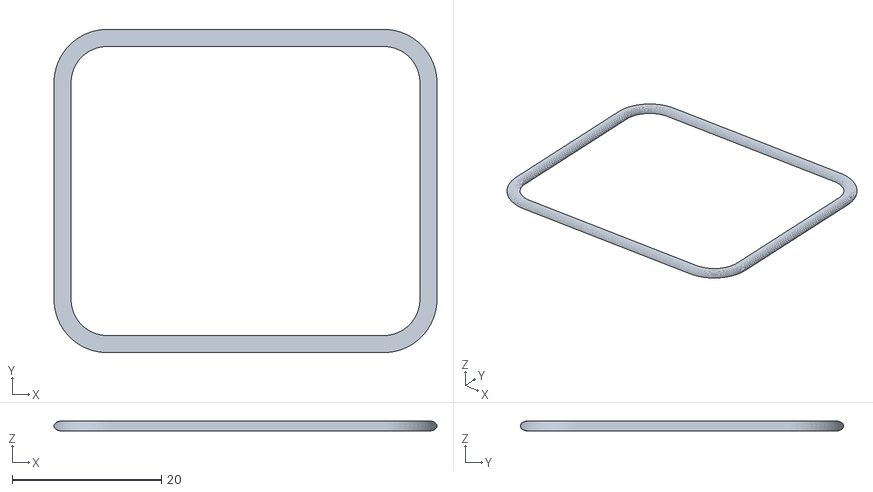
[picture p148: CAD file, 2026-10-26]
mechanical/universal-mount-r01/gasket.stl
51.3 x 43.3 x 1.34
