gokselozgur5/pcb-design-collar-tracker/assembly/internal-charge-r03/red-fixture.stl

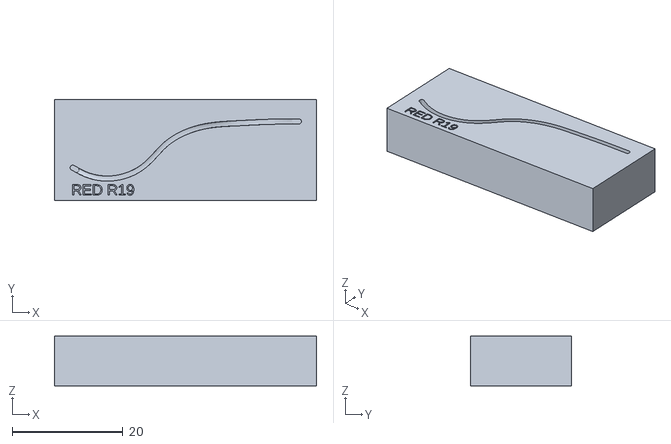
[picture p149: CAD file, 2026-10-26]
assembly/internal-charge-r03/red-fixture.stl
47.4 x 18.3 x 9.00
