gokselozgur5/pcb-design-collar-tracker/mechanical/swim-r11-thermal-fit/body.stl

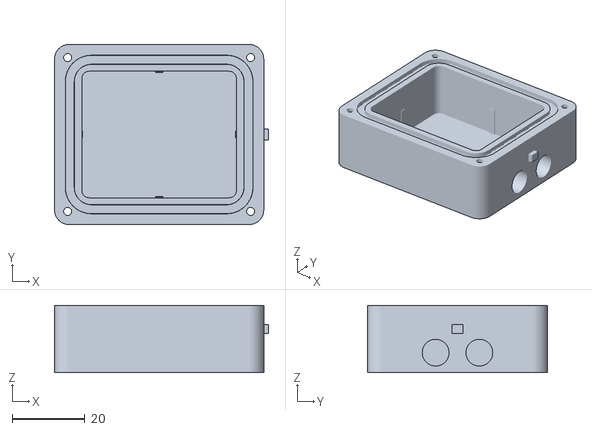
[picture p150: CAD file, 2026-10-25]
mechanical/swim-r11-thermal-fit/body.stl
58.7 x 49.4 x 18.5
