gokselozgur5/pcb-design-collar-tracker/mechanical/universal-mount-r01/rf.stl

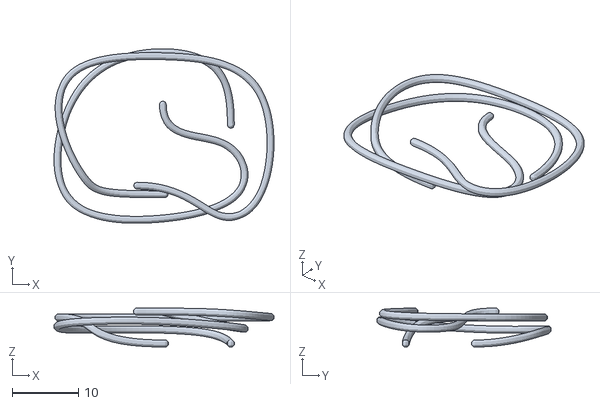
[picture p151: CAD file, 2026-10-26]
mechanical/universal-mount-r01/rf.stl
33.3 x 26.4 x 5.89
