gokselozgur5/pcb-design-collar-tracker/mechanical/swim-r11-thermal-fit/magnet_plug.stl

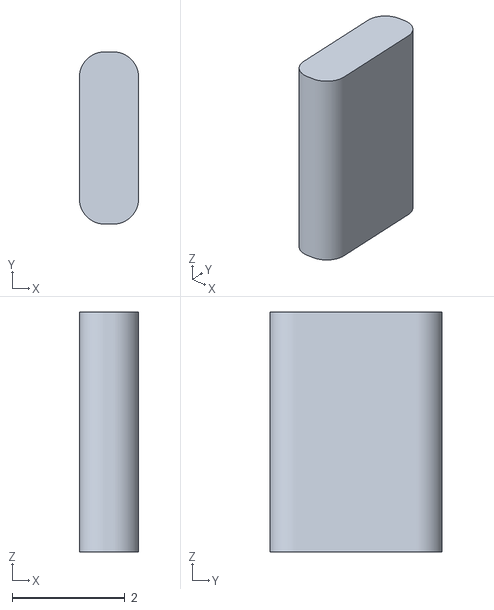
[picture p152: CAD file, 2026-10-25]
mechanical/swim-r11-thermal-fit/magnet_plug.stl
1.05 x 3.05 x 4.25
