gokselozgur5/pcb-design-collar-tracker/mechanical/universal-mount-r01/strap_long.stl

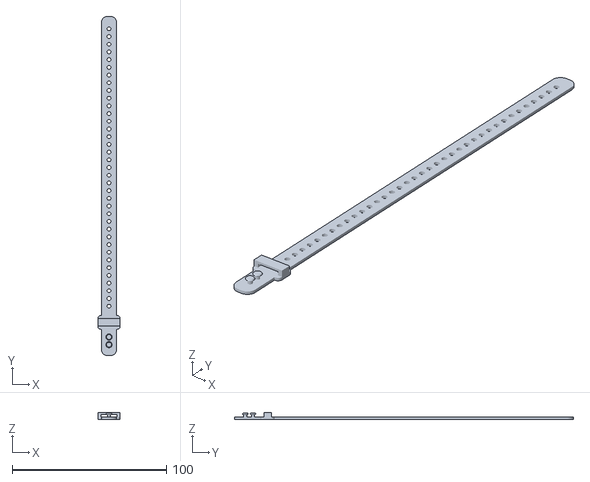
[picture p153: CAD file, 2026-10-26]
mechanical/universal-mount-r01/strap_long.stl
14.6 x 220.0 x 4.40
