gokselozgur5/pcb-design-collar-tracker/mechanical/swim-r11-thermal-fit/contact_seal.stl

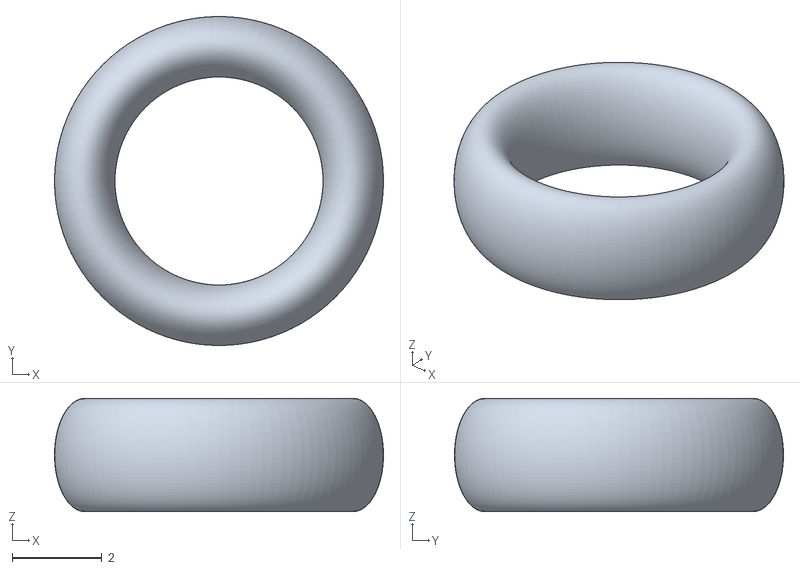
[picture p154: CAD file, 2026-10-25]
mechanical/swim-r11-thermal-fit/contact_seal.stl
7.34 x 7.34 x 2.52
