gokselozgur5/pcb-design-collar-tracker/mechanical/universal-mount-r01/rope_large_installed_straps.stl

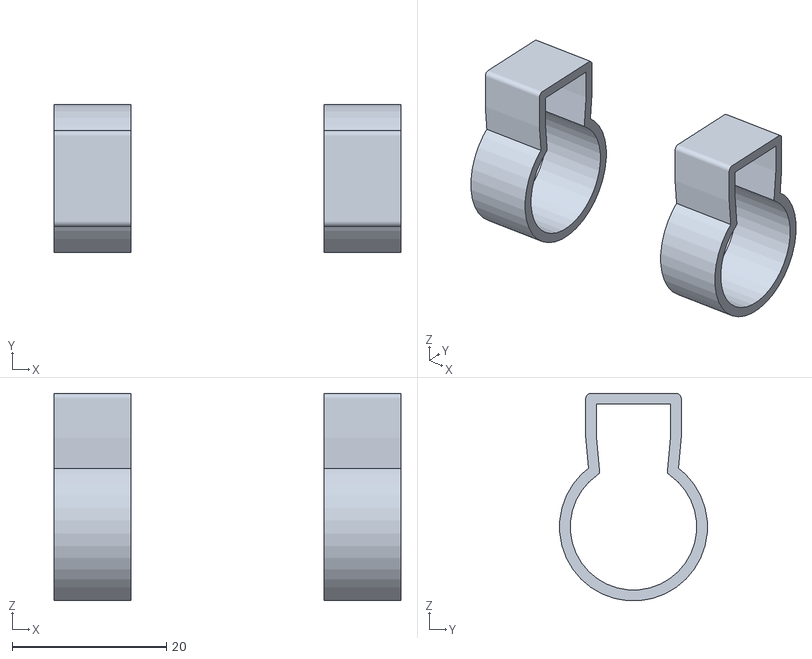
[picture p155: CAD file, 2026-10-26]
mechanical/universal-mount-r01/rope_large_installed_straps.stl
45.0 x 19.1 x 26.9
