gokselozgur5/pcb-design-collar-tracker/mechanical/universal-mount-r01/charge_wires.stl

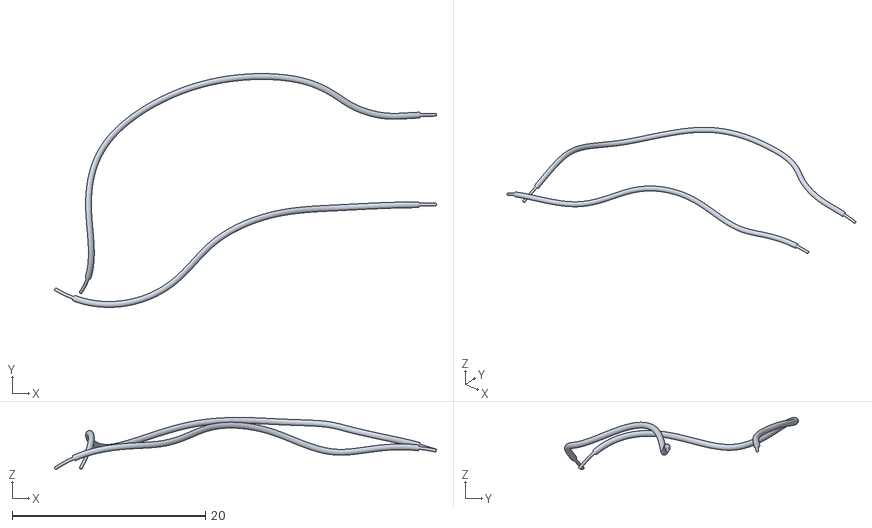
[picture p156: CAD file, 2026-10-26]
mechanical/universal-mount-r01/charge_wires.stl
39.5 x 24.2 x 5.40
