gokselozgur5/pcb-design-collar-tracker/mechanical/universal-mount-r01/round_pad.stl

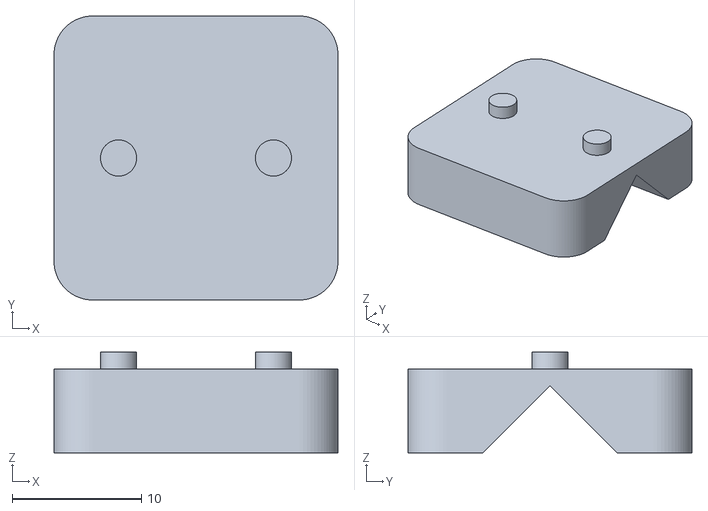
[picture p157: CAD file, 2026-10-26]
mechanical/universal-mount-r01/round_pad.stl
22.0 x 22.0 x 7.80
