gokselozgur5/pcb-design-collar-tracker/mechanical/universal-mount-r01/rope_collar.stl

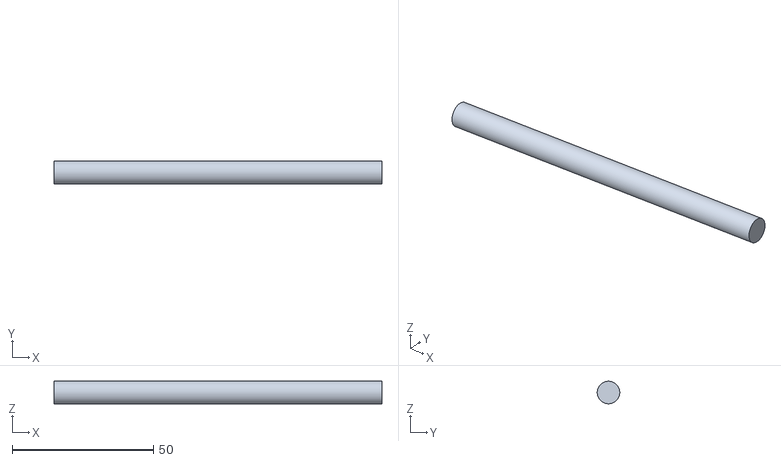
[picture p158: CAD file, 2026-10-26]
mechanical/universal-mount-r01/rope_collar.stl
116.0 x 8.00 x 8.00
