gokselozgur5/pcb-design-collar-tracker/mechanical/universal-mount-r01/rope_small_collar.stl

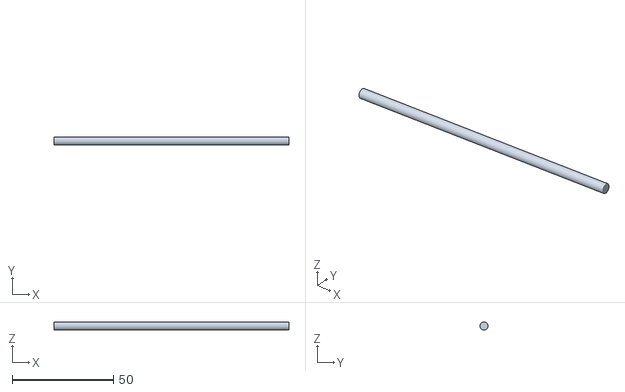
[picture p159: CAD file, 2026-10-26]
mechanical/universal-mount-r01/rope_small_collar.stl
116.0 x 4.00 x 4.00
