gokselozgur5/pcb-design-collar-tracker/mechanical/universal-mount-r01/terminals.stl

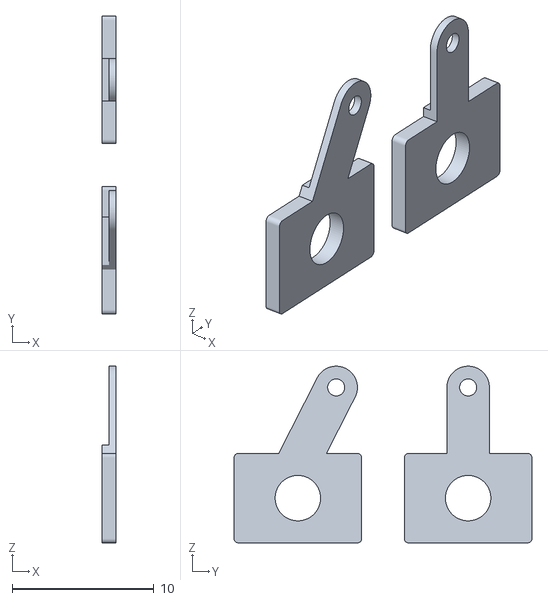
[picture p161: CAD file, 2026-10-26]
mechanical/universal-mount-r01/terminals.stl
1.00 x 21.0 x 12.4
