gokselozgur5/pcb-design-collar-tracker/mechanical/universal-mount-r01/boot.stl

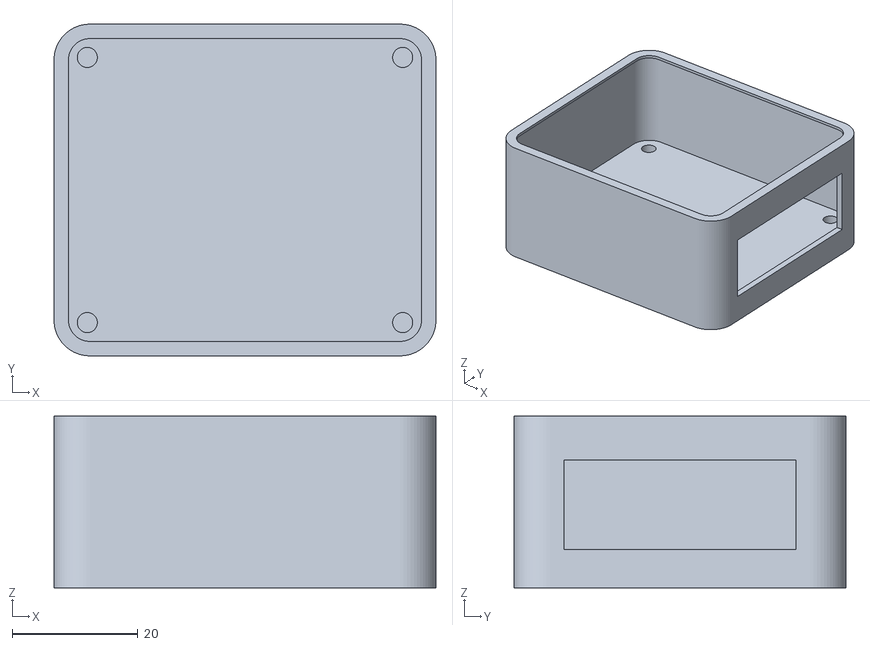
[picture p162: CAD file, 2026-10-26]
mechanical/universal-mount-r01/boot.stl
60.8 x 52.8 x 27.3
