gokselozgur5/pcb-design-collar-tracker/mechanical/universal-mount-r01/pcb.stl

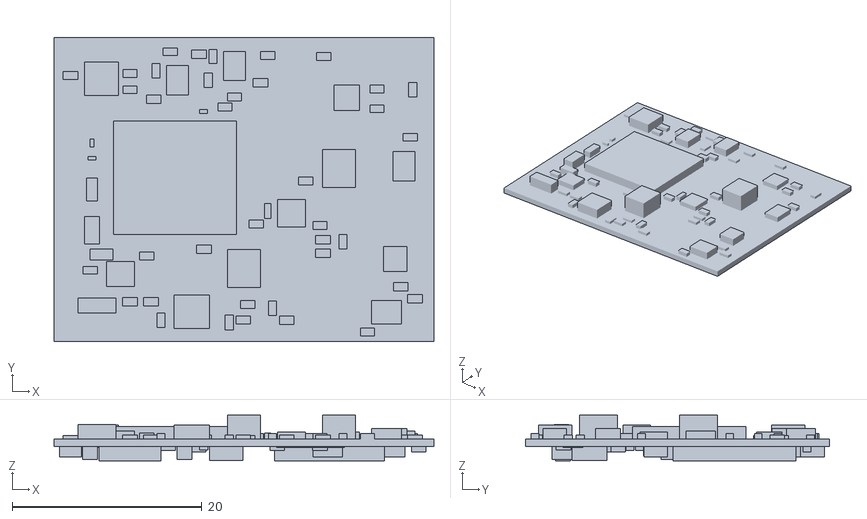
[picture p163: CAD file, 2026-10-26]
mechanical/universal-mount-r01/pcb.stl
40.0 x 32.0 x 4.84
