gokselozgur5/pcb-design-collar-tracker/mechanical/universal-mount-r01/rope_small_installed_straps.stl

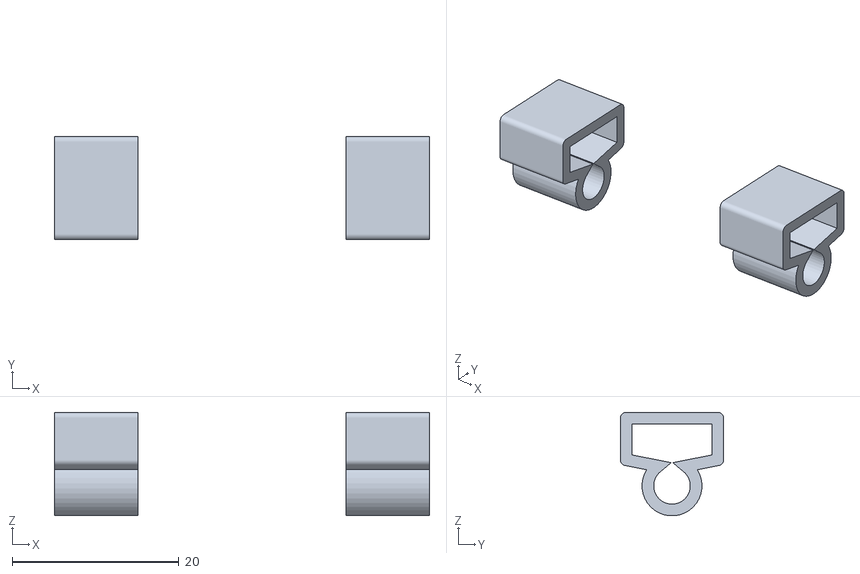
[picture p164: CAD file, 2026-10-26]
mechanical/universal-mount-r01/rope_small_installed_straps.stl
45.0 x 12.4 x 12.4
