gokselozgur5/pcb-design-collar-tracker/mechanical/universal-mount-r01/antennas.stl

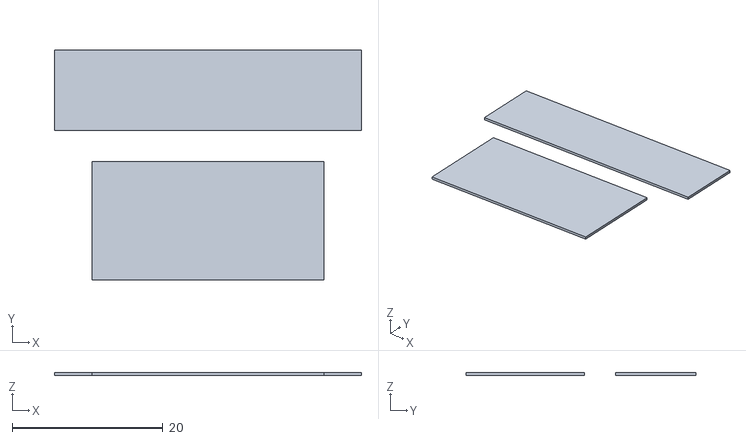
[picture p165: CAD file, 2026-10-26]
mechanical/universal-mount-r01/antennas.stl
40.7 x 30.5 x 0.4
