gokselozgur5/pcb-design-collar-tracker/mechanical/universal-mount-r01/fasteners.stl

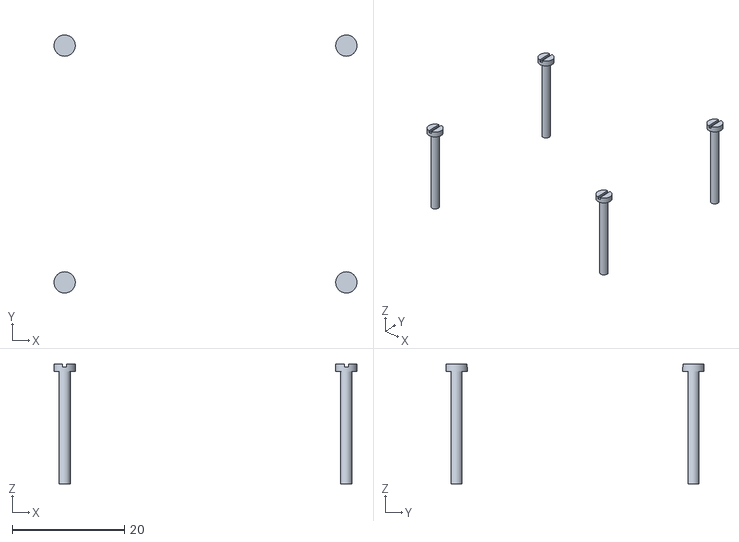
[picture p166: CAD file, 2026-10-26]
mechanical/universal-mount-r01/fasteners.stl
54.0 x 46.0 x 21.3
