gokselozgur5/pcb-design-collar-tracker/mechanical/universal-mount-r01/wide_installed_straps.stl

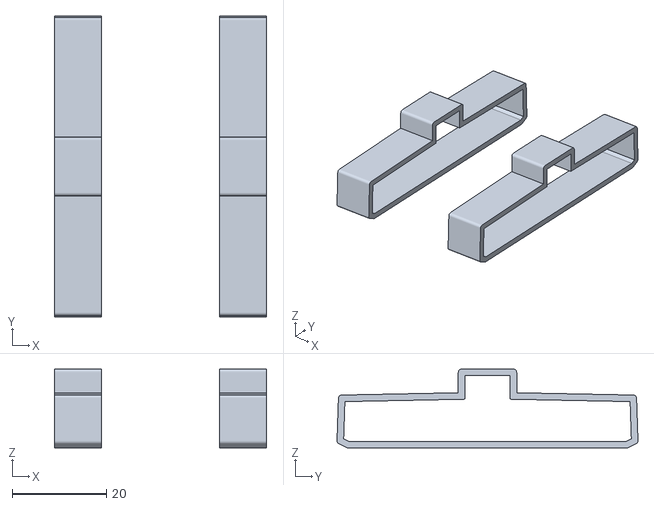
[picture p167: CAD file, 2026-10-26]
mechanical/universal-mount-r01/wide_installed_straps.stl
45.0 x 63.8 x 16.7
