gokselozgur5/pcb-design-collar-tracker/mechanical/universal-mount-r01/standard_installed_straps.stl

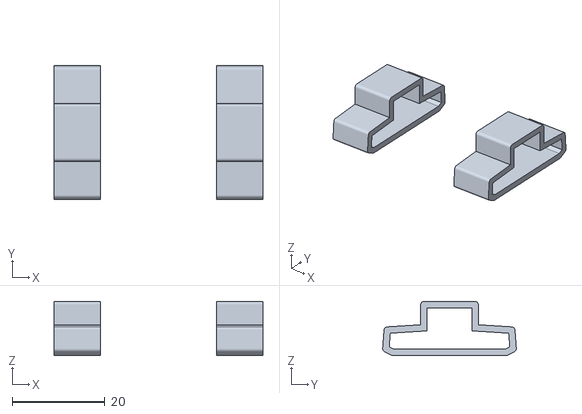
[picture p168: CAD file, 2026-10-26]
mechanical/universal-mount-r01/standard_installed_straps.stl
45.0 x 28.8 x 11.7
