gokselozgur5/pcb-design-collar-tracker/mechanical/universal-mount-r01/narrow_installed_straps.stl

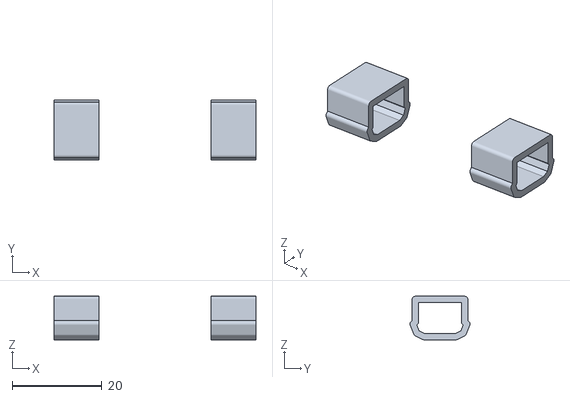
[picture p169: CAD file, 2026-10-26]
mechanical/universal-mount-r01/narrow_installed_straps.stl
45.0 x 13.4 x 9.70
