gokselozgur5/pcb-design-collar-tracker/mechanical/universal-mount-r01/rope_large_collar.stl

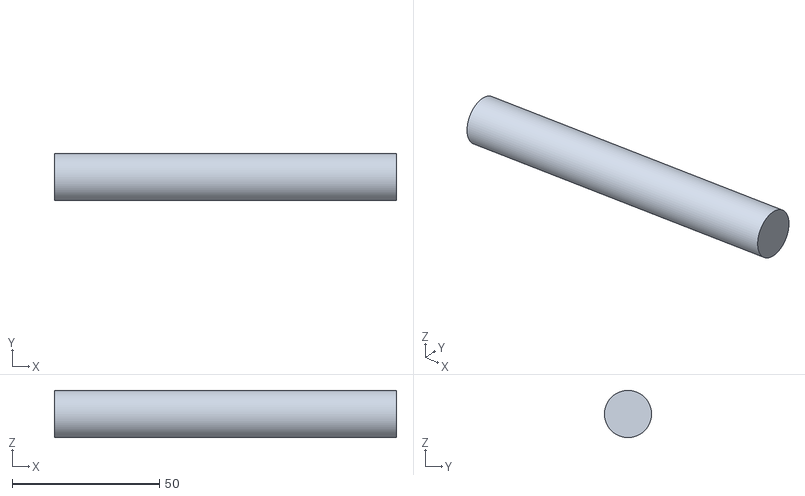
[picture p170: CAD file, 2026-10-26]
mechanical/universal-mount-r01/rope_large_collar.stl
116.0 x 16.0 x 16.0
