gokselozgur5/pcb-design-collar-tracker/mechanical/universal-mount-r01/contacts.stl

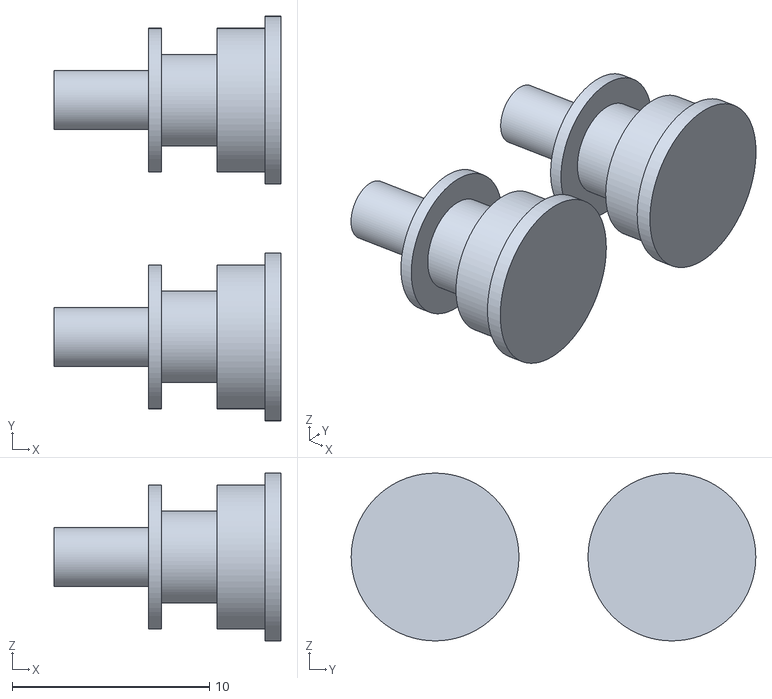
[picture p172: CAD file, 2026-10-26]
mechanical/universal-mount-r01/contacts.stl
11.5 x 20.5 x 8.50
