gokselozgur5/pcb-design-collar-tracker/mechanical/universal-mount-r01/wide_collar.stl

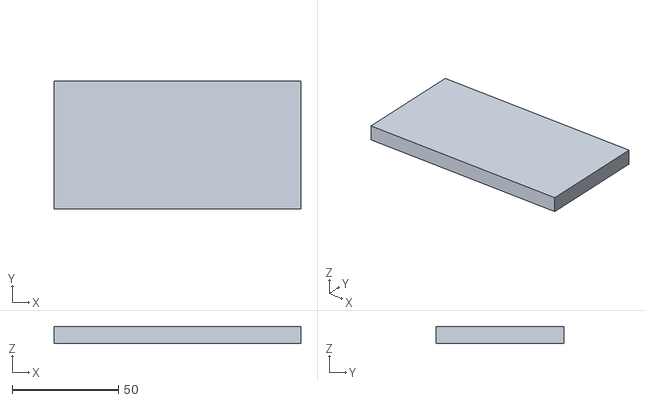
[picture p173: CAD file, 2026-10-26]
mechanical/universal-mount-r01/wide_collar.stl
116.0 x 60.0 x 8.00
