gokselozgur5/pcb-design-collar-tracker/mechanical/universal-mount-r01/strap_short.stl

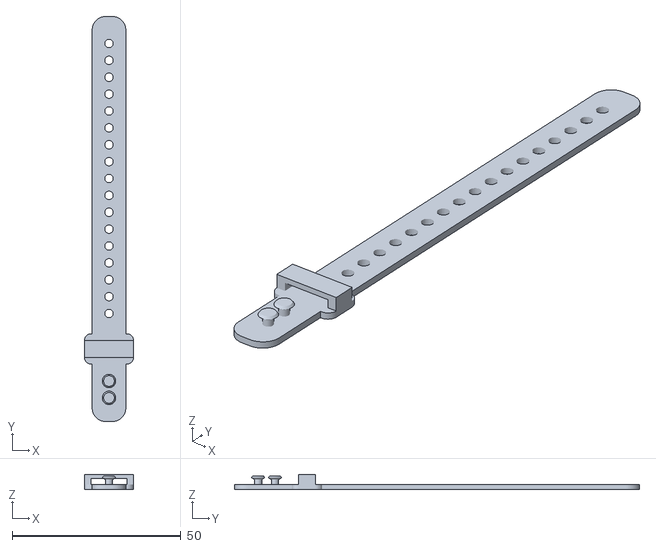
[picture p174: CAD file, 2026-10-26]
mechanical/universal-mount-r01/strap_short.stl
14.6 x 120.0 x 4.40
