gokselozgur5/pcb-design-collar-tracker/mechanical/swim-r01/parameters.scad

// Generated by scripts/build_swim_enclosure.py; edit parameters.json.
body_w = 57.4;
body_d = 49.4;
body_h = 15.1;
body_r = 4.0;
cavity_w = 42.0;
cavity_d = 34.0;
cavity_r = 2.0;
floor_t = 1.8;
lid_t = 2.5;
gland_w = 49;
gland_d = 41;
gland_r = 6.0;
gland_width = 2.5;
gland_depth = 1.34;
gland_bottom_r = 0.2;
gasket_cs = 1.78;
gasket_id = 50.52;
gasket_perimeter = 169.6991118430775;
screw_centers = [[-25.1, -21.1], [-25.1, 21.1], [25.1, -21.1], [25.1, 21.1]];
screw_hole = 2.2;
head_d = 4.0;
head_depth = 1.5;
nut_af = 4.2;
nut_depth = 1.8;
pcb_size = [40.0, 32.0, 0.8];
pcb_z = 10.0;
top_budget = 3.0;
bottom_budget = 1.8;
battery_size = [34.0, 23.5, 5.8];
battery_z = 2.0;
antenna_centers = [[0, 12.5, 14.6], [0, -12.5, 14.6]];
antenna_sizes = [[30, 5.0, 0.4], [30, 5.0, 0.4]];
contact_y = [-6.0, 6.0];
contact_z = 5.8;
contact_head_d = 8.5;
contact_head_t = 0.8;
contact_bore = 7.34;
contact_shaft = 7.28;
contact_root = 4.64;
contact_groove_w = 2.8;
contact_groove_center = 3.85;
contact_length = 7.7;
contact_thread_d = 4.0;
contact_thread_length = 3.5;
contact_oring_cs = 1.8;
contact_oring_id = 4.5;
magnet_y = [-13, 13];
magnet_z = 5.8;
magnet_d = 3.0;
magnet_t = 1.0;
magnet_pocket_d = 3.1;
magnet_wall = 1.0;
