gokselozgur5/pcb-design-collar-tracker/mechanical/swim-r12-pack-retention/pack-retention-parameters.scad

// Generated from pack-retention.json; conditional dimensional requirements.
pack_cradle_inner = [33, 31.5];
pack_cradle_outer = [34.4, 33.0];
pack_cradle_r = 0.4;
pack_platform_z = 1.8;
pack_wall_z = 7.1;
pack_cap_outer = [34.4, 33.0];
pack_cap_inner = [25, 24];
pack_cap_ntc = [33, 11];
pack_cap_r = 0.4;
pack_cap_z = 7.56;
pack_cap_top = 8.31;
pack_bridges = [[-20.8, 3.5, -16.3, 5.5], [16.3, -1, 20.8, 1], [-1, -16.8, 1, -15.8], [-1, 15.8, 1, 16.8]];
pack_bridge_top = 9.0;
pack_cap_tongues = [[-2, 11.75, 2, 16.5]];
pack_cap_reliefs = [[-8.055, -14.209999999999999, -4.445, -9.290000000000001], [-18.005, -2.76, -14.395, 2.16], [-16.259999999999998, -13.86, -7.74, -10.24], [2.19, -1.46, 15.81, 13.459999999999999], [-4.630000000000001, -12.11, 0.91, -6.390000000000001]];
pack_body_z = 1.8;
