gokselozgur5/pcb-design-collar-tracker/mechanical/swim-r14-wire-motion/parameters.scad

// Generated by check_dock_wire_motion.py; units mm.
contact_full_stroke_to_flange_back = 6.4262;
contact_stroke = 1.397;
contact_stroke_tolerance = 0.127;
contact_length_tolerance = 0.1524;
contact_diameter_tolerance = 0.0508;
contact_flange_d = 1.9812;
contact_flange_t = 0.635;
contact_crimp_d = 1.5748;
contact_crimp_length = 3.3782;
contact_upper_d = 1.8288;
contact_tip_d = 1.0668;
contact_wire_hole_d = 0.889;
contact_midstroke_force_g = [40, 80];
contact_resistance_max_ohm = 0.02;
contact_barrel_d = 1.6256;
contact_upper_step_to_flange_back = 1.8034;
dock_width = 36;
dock_depth = 94;
dock_bottom = -1;
dock_top = 15;
dock_split_z = 5.5;
dock_nose_width = 35.4;
dock_nose_bottom = 1.0;
dock_nose_top = 13.2;
dock_nose_depth = 2.1;
dock_rear_start = 2.0;
dock_pin_y = [-6, 6];
dock_pin_z = 5.5;
dock_flange_back_x = 7.9247;
dock_flange_pocket_d = 2.15;
dock_upper_bore_d = 1.8;
dock_tail_bore_d = 1.73;
dock_head_pocket_d = 9.0;
dock_head_pocket_depth = 1.3;
dock_wire_exit_x = 86;
dock_wire_exit_d = 5.2;
dock_wire_pocket_x = [12, 86];
dock_wire_pocket_y = [-15, 15];
dock_wire_pocket_z = [2, 9];
dock_screw_xy = [[5, -14], [5, 14], [89, -14], [89, 14]];
dock_screw_hole_d = 2.3;
dock_nut_af = 4.3;
dock_nut_depth = 2.1;
dock_front_stop_x = 5.4;
key_length = 4.0;
key_y_min = -1.5;
key_y_max = 1.5;
key_z_min = 7.7;
key_z_max = 13.2;
key_slot_depth = 4.3;
key_slot_y_min = -1.8;
key_slot_y_max = 1.8;
key_slot_z_min = 7.4;
key_slot_z_max = 13.5;
harness_wire_awg = 26;
harness_wire_od_max = 0.8382;
harness_wire_min_bend = 8.382;
harness_wire_conductor_d = 0.4826;
harness_wire_conductor_nominal_ohm_per_m = 0.12467191601049868;
harness_usb_cable_d_nom = 4.1;
harness_usb_cable_d_tolerance = 0.3;
harness_usb_cable_bend_radius = 24.6;
harness_usb_tail_d_requirement = 1.2;
harness_usb_tail_bend_requirement = 10;
harness_route_x = [68, 86];
harness_route_y = [6, 0.8];
harness_splice_envelope = [4, 2.4, 2.4];
harness_fuse_center = [57.25, -6, 5.5];
harness_fuse_insulated_d_requirement = 4.0;
harness_input_voltage_range = [4.75, 5.25];
harness_continuous_current_design = 0.5;
harness_fuse_body_length_requirement = 7.5;
harness_jacket_center_z_allowance = 0.28;
harness_fuse_body_drawing_mm = [7.11, 2.8];
motion_free_wire_length = 40.95;
motion_free_wire_length_tolerance = 0.1;
motion_fixed_end_x = 49;
motion_fixed_end_tolerance = 0.1;
motion_start_axial_tolerance = 0.25;
motion_route_position_allowance = 0.15;
motion_insulation_radius_allowance = 0.02;
motion_minimum_slack_at_max_span = 0.25;
motion_required_housing_clearance = 0.2;
motion_rear_relief_start_x = 8.7;
motion_rear_relief_end_x = 12.1;
motion_rear_relief_outer_y = 7.6;
motion_rear_relief_inner_y = 4.8;
motion_rear_relief_z = [4.3, 6.7];
motion_slice_step = 0.2;
motion_arc_quadrature_panels = 4096;
motion_arc_error_bound_mm = 0.0001;
motion_sampled_forward_positions = 9;
motion_factory_endpoint_retention_qualified = false;
motion_cyclic_flex_qualified = false;
motion_fixed_end_thermal_allowance = 0.2;
motion_wire_service_length_allowance = 0.075;
motion_temperature_range_C = [-10, 45];
motion_reference_temperature_C = 23;
motion_housing_CTE_max_per_K = 0.0001;
motion_wire_CTE_requirement_per_K = 5e-05;
motion_shell_clearance_allowance = 0.1;
wire_swept_cells = [[8.2217, 5.3109, 4.8109, 9.7999, 6.691104419376543, 6.1891], [8.4217, 5.3109, 4.8109, 9.999899999999998, 6.69711567837263, 6.1891], [8.6217, 5.3109, 4.8109, 10.1999, 6.707127781581485, 6.1891], [8.8217, 5.3109, 4.8109, 10.399899999999999, 6.721130743302699, 6.1891], [9.021700000000001, 5.3109, 4.8109, 10.5999, 6.7391105975015995, 6.1891], [9.2217, 5.3109, 4.8109, 10.7999, 6.76104941173845, 6.1891], [9.421700000000001, 5.3109, 4.8109, 10.9999, 6.786925305053608, 6.1891], [9.6217, 5.3109, 4.8109, 11.1999, 6.816712469790774, 6.1891], [9.8217, 5.3109, 4.8109, 11.399899999999999, 6.8503811973365965, 6.1891], [10.021700000000001, 5.3109, 4.8109, 11.5999, 6.887897907750941, 6.1891], [10.2217, 5.3109, 4.8109, 11.7999, 6.9292251832582705, 6.1891], [10.421700000000001, 5.3109, 4.8109, 11.9999, 6.974321805566759, 6.1891], [10.6217, 5.3109, 4.8109, 12.1999, 7.023142796977872, 6.1891], [10.8217, 5.3109, 4.8109, 12.399899999999999, 7.075639465245469, 6.1891], [11.021700000000001, 5.3109, 4.8109, 12.5999, 7.131759452139636, 6.1891], [11.2217, 5.3109, 4.8109, 12.7999, 7.191446785666843, 6.1891], [11.421700000000001, 5.3109, 4.8109, 12.9999, 7.254641935894334, 6.1891], [11.6217, 5.3109, 4.8109, 13.1999, 7.321281874323079, 6.1891], [11.8217, 5.3109, 4.8109, 13.399899999999999, 7.391300136750054, 6.1891], [12.021700000000001, 5.3109, 4.8109, 13.5999, 7.464626889557179, 6.1891], [12.2217, 5.3109, 4.8109, 13.7999, 7.541188999360772, 6.1891], [12.421700000000001, 5.3109, 4.8109, 13.9999, 7.620910105952079, 6.1891], [12.6217, 5.3109, 4.8109, 14.1999, 7.703710698456112, 6.1891], [12.8217, 5.3109, 4.8109, 14.399899999999999, 7.789508194632844, 6.1891], [13.021700000000001, 5.3109, 4.8109, 14.5999, 7.87821702324168, 6.1891], [13.2217, 5.3109, 4.8109, 14.7999, 7.96974870938703, 6.1891], [13.421700000000001, 5.3109, 4.8109, 14.9999, 8.064011962759892, 6.1891], [13.6217, 5.3109, 4.8109, 15.1999, 8.160912768687423, 6.1891], [13.8217, 5.3109, 4.8109, 15.399899999999999, 8.260354481899684, 6.1891], [14.021700000000001, 5.3109, 4.8109, 15.5999, 8.362237922920047, 6.1891], [14.2217, 5.3109, 4.8109, 15.7999, 8.466461476983127, 6.1891], [14.421700000000001, 5.3109, 4.8109, 15.9999, 8.572921195381586, 6.1891], [14.6217, 5.3109, 4.8109, 16.1999, 8.681510899140708, 6.1891], [14.8217, 5.3109, 4.8109, 16.3999, 8.79212228491738, 6.1891], [15.021700000000001, 5.3109, 4.8109, 16.5999, 8.904645033017822, 6.1891], [15.2217, 5.3109, 4.8109, 16.7999, 9.018966917426363, 6.1891], [15.421700000000001, 5.3109, 4.8109, 16.9999, 9.13497391773551, 6.1891], [15.6217, 5.3109, 4.8109, 17.1999, 9.252550332865658, 6.1891], [15.8217, 5.3109, 4.8109, 17.3999, 9.371578896461077, 6.1891], [16.0217, 5.3109, 4.8109, 17.599899999999998, 9.491940893847014, 6.1891], [16.221700000000002, 5.3109, 4.8109, 17.7999, 9.613516280431305, 6.1891], [16.4217, 5.3109, 4.8109, 17.9999, 9.7361838014324, 6.1891], [16.6217, 5.3109, 4.8109, 18.1999, 9.85982111281439, 6.1891], [16.8217, 5.3109, 4.8109, 18.3999, 9.984304903308415, 6.1891], [17.0217, 5.3109, 4.8109, 18.599899999999998, 10.10951101739873, 6.1891], [17.221700000000002, 5.3109, 4.8109, 18.7999, 10.235314579150836, 6.1891], [17.4217, 5.3109, 4.8109, 18.9999, 10.361590116758084, 6.1891], [17.6217, 5.3109, 4.8109, 19.1999, 10.488211687682623, 6.1891], [17.821700000000003, 5.3109, 4.8109, 19.399900000000002, 10.615053004265802, 6.1891], [18.0217, 5.3109, 4.8109, 19.599899999999998, 10.741987559682787, 6.1891], [18.221700000000002, 5.3109, 4.8109, 19.7999, 10.868888754115815, 6.1891], [18.4217, 5.3109, 4.8109, 19.9999, 10.995630021020109, 6.1891], [18.6217, 5.3109, 4.8109, 20.1999, 11.12208495335668, 6.1891], [18.821700000000003, 5.3109, 4.8109, 20.399900000000002, 11.248127429666031, 6.1891], [19.0217, 5.3109, 4.8109, 20.599899999999998, 11.373631739856995, 6.1891], [19.221700000000002, 5.3109, 4.8109, 20.7999, 11.498472710585343, 6.1891], [19.4217, 5.3109, 4.8109, 20.9999, 11.622525830097013, 6.1891], [19.6217, 5.3109, 4.8109, 21.1999, 11.745667372411532, 6.1891], [19.821700000000003, 5.3109, 4.8109, 21.399900000000002, 11.867774520721715, 6.1891], [20.0217, 5.3109, 4.8109, 21.599899999999998, 11.98872548988659, 6.1891], [20.221700000000002, 5.3109, 4.8109, 21.7999, 12.108399647895391, 6.1891], [20.4217, 5.3109, 4.8109, 21.9999, 12.226677636181435, 6.1891], [20.6217, 5.3109, 4.8109, 22.1999, 12.343441488665942, 6.1891], [20.821700000000003, 5.3109, 4.8109, 22.399900000000002, 12.458574749413028, 6.1891], [21.0217, 5.3109, 4.8109, 22.599899999999998, 12.571962588778522, 6.1891], [21.221700000000002, 5.3109, 4.8109, 22.7999, 12.68349191793682, 6.1891], [21.4217, 5.3109, 4.8109, 22.9999, 12.79305150167145, 6.1891], [21.6217, 5.3109, 4.8109, 23.1999, 12.900532069316988, 6.1891], [21.821700000000003, 5.3109, 4.8109, 23.399900000000002, 13.005826423741542, 6.1891], [22.0217, 5.3109, 4.8109, 23.599899999999998, 13.108829548261198, 6.1891], [22.221700000000002, 5.3109, 4.8109, 23.7999, 13.209438711379786, 6.1891], [22.4217, 5.3109, 4.8109, 23.9999, 13.307553569249436, 6.1891], [22.6217, 5.3109, 4.8109, 24.1999, 13.403076265749831, 6.1891], [22.821700000000003, 5.3109, 4.8109, 24.399900000000002, 13.495911530086264, 6.1891], [23.0217, 5.3109, 4.8109, 24.599899999999998, 13.585966771809186, 6.1891], [23.221700000000002, 5.3109, 4.8109, 24.7999, 13.673152173160512, 6.1891], [23.4217, 5.3109, 4.8109, 24.9999, 13.757380778654497, 6.1891], [23.6217, 5.3109, 4.8109, 25.1999, 13.83856858180392, 6.1891], [23.821700000000003, 5.3109, 4.8109, 25.399900000000002, 13.916634608905046, 6.1891], [24.0217, 5.3109, 4.8109, 25.599899999999998, 13.991500999797779, 6.1891], [24.221700000000002, 5.3109, 4.8109, 25.7999, 14.063093085520524, 6.1891], [24.421699999999998, 5.3109, 4.8109, 25.999899999999997, 14.131339462782208, 6.1891], [24.6217, 5.3109, 4.8109, 26.1999, 14.1961720651773, 6.1891], [24.821700000000003, 5.3109, 4.8109, 26.399900000000002, 14.257526231072704, 6.1891], [25.0217, 5.3109, 4.8109, 26.599899999999998, 14.315340768098883, 6.1891], [25.221700000000002, 5.3109, 4.8109, 26.7999, 14.369558014180853, 6.1891], [25.421699999999998, 5.3109, 4.8109, 26.999899999999997, 14.420123895048203, 6.1891], [25.6217, 5.3109, 4.8109, 27.1999, 14.46698797816676, 6.1891], [25.821700000000003, 5.3109, 4.8109, 27.399900000000002, 14.510103523038136, 6.1891], [26.0217, 5.3109, 4.8109, 27.599899999999998, 14.549427527816956, 6.1891], [26.221700000000002, 5.3109, 4.8109, 27.7999, 14.584920772199322, 6.1891], [26.421699999999998, 5.3109, 4.8109, 27.999899999999997, 14.616547856539672, 6.1891], [26.6217, 5.3109, 4.8109, 28.1999, 14.644277237157079, 6.1891], [26.821700000000003, 5.3109, 4.8109, 28.399900000000002, 14.668081257795757, 6.1891], [27.0217, 5.3109, 4.8109, 28.599899999999998, 14.687936177208371, 6.1891], [27.221700000000002, 5.3109, 4.8109, 28.7999, 14.703822192834686, 6.1891], [27.421700000000005, 5.3109, 4.8109, 28.999900000000004, 14.715723460551901, 6.1891], [27.6217, 5.3109, 4.8109, 29.1999, 14.723628110476994, 6.1891], [27.821700000000003, 5.3109, 4.8109, 29.399900000000002, 14.727528258805304, 6.1891], [28.0217, 5.3109, 4.8109, 29.599899999999998, 14.727976734484812, 6.1891], [28.221700000000002, 5.3109, 4.8109, 29.7999, 14.727976734484812, 6.1891], [28.421700000000005, 5.3109, 4.8109, 29.999900000000004, 14.727976734484812, 6.1891], [28.6217, 5.3109, 4.8109, 30.1999, 14.727976734484812, 6.1891], [28.821700000000003, 5.3109, 4.8109, 30.399900000000002, 14.727976734484812, 6.1891], [29.0217, 5.3109, 4.8109, 30.599899999999998, 14.727976734484812, 6.1891], [29.221700000000002, 5.3109, 4.8109, 30.7999, 14.727976734484812, 6.1891], [29.421700000000005, 5.3109, 4.8109, 30.999900000000004, 14.727976734484812, 6.1891], [29.6217, 5.3109, 4.8109, 31.1999, 14.727976734484812, 6.1891], [29.821700000000003, 5.3109, 4.8109, 31.399900000000002, 14.727580555923328, 6.1891], [30.0217, 5.3109, 4.8109, 31.599899999999998, 14.723475275294025, 6.1891], [30.221700000000002, 5.3109, 4.8109, 31.7999, 14.714920700099793, 6.1891], [30.421700000000005, 5.3109, 4.8109, 31.999900000000004, 14.701926310396184, 6.1891], [30.6217, 5.3109, 4.8109, 32.1999, 14.684506506376476, 6.1891], [30.821700000000003, 5.3109, 4.8109, 32.3999, 14.662680592413597, 6.1891], [31.0217, 5.3109, 4.8109, 32.5999, 14.636472755667295, 6.1891], [31.221700000000002, 5.3109, 4.8109, 32.79990000000001, 14.605912039280279, 6.1891], [31.421700000000005, 5.3109, 4.8109, 32.99990000000001, 14.571032310193033, 6.1891], [31.6217, 5.3109, 4.8109, 33.19990000000001, 14.531872221612973, 6.1891], [31.821700000000003, 5.3109, 4.8109, 33.39990000000001, 14.488475170179512, 6.1891], [32.021699999999996, 5.3109, 4.8109, 33.599900000000005, 14.440889247872553, 6.1891], [32.2217, 5.3109, 4.8109, 33.79990000000001, 14.389167188717643, 6.1891], [32.4217, 5.3109, 4.8109, 33.99990000000001, 14.3333663103469, 6.1891], [32.6217, 5.3109, 4.8109, 34.19990000000001, 14.273548450480462, 6.1891], [32.8217, 5.3109, 4.8109, 34.39990000000001, 14.209779898398793, 6.1891], [33.021699999999996, 5.3109, 4.8109, 34.599900000000005, 14.142131321481909, 6.1891], [33.2217, 5.3109, 4.8109, 34.79990000000001, 14.070677686896786, 6.1891], [33.4217, 5.3109, 4.8109, 34.99990000000001, 13.995498178519856, 6.1891], [33.6217, 5.3109, 4.8109, 35.19990000000001, 13.916676109186588, 6.1891], [33.8217, 5.3109, 4.8109, 35.39990000000001, 13.834298828365398, 6.1891], [34.021699999999996, 5.3109, 4.8109, 35.599900000000005, 13.74845762535827, 6.1891], [34.2217, 5.3109, 4.8109, 35.79990000000001, 13.659247628135267, 6.1891], [34.4217, 5.3109, 4.8109, 35.99990000000001, 13.566767697915097, 6.1891], [34.6217, 5.3109, 4.8109, 36.19990000000001, 13.471120319608566, 6.1891], [34.8217, 5.3109, 4.8109, 36.39990000000001, 13.372411488246279, 6.1891], [35.021699999999996, 5.3109, 4.8109, 36.599900000000005, 13.270750591516492, 6.1891], [35.2217, 5.3109, 4.8109, 36.79990000000001, 13.166250288543289, 6.1891], [35.4217, 5.3109, 4.8109, 36.99990000000001, 13.059026385039358, 6.1891], [35.6217, 5.3109, 4.8109, 37.19990000000001, 12.94919770497181, 6.1891], [35.8217, 5.3109, 4.8109, 37.39990000000001, 12.836885958883162, 6.1891], [36.021699999999996, 5.3109, 4.8109, 37.599900000000005, 12.722215609013533, 6.1891], [36.2217, 5.3109, 4.8109, 37.79990000000001, 12.605313731373347, 6.1891], [36.4217, 5.3109, 4.8109, 37.99990000000001, 12.4863098749196, 6.1891], [36.6217, 5.3109, 4.8109, 38.19990000000001, 12.365335917991567, 6.1891], [36.8217, 5.3109, 4.8109, 38.39990000000001, 12.242525922165147, 6.1891], [37.021699999999996, 5.3109, 4.8109, 38.599900000000005, 12.118015983687805, 6.1891], [37.2217, 5.3109, 4.8109, 38.79990000000001, 11.991944082658652, 6.1891], [37.4217, 5.3109, 4.8109, 38.99990000000001, 11.864449930120951, 6.1891], [37.6217, 5.3109, 4.8109, 39.19990000000001, 11.735674813236361, 6.1891], [37.8217, 5.3109, 4.8109, 39.39990000000001, 11.605761438712538, 6.1891], [38.021699999999996, 5.3109, 4.8109, 39.599900000000005, 11.474853774657689, 6.1891], [38.2217, 5.3109, 4.8109, 39.79990000000001, 11.34309689103717, 6.1891], [38.4217, 5.3109, 4.8109, 39.99990000000001, 11.210636798909096, 6.1891], [38.6217, 5.3109, 4.8109, 40.19990000000001, 11.077620288616995, 6.1891], [38.8217, 5.3109, 4.8109, 40.39990000000001, 10.944194767118887, 6.1891], [39.021699999999996, 5.3109, 4.8109, 40.599900000000005, 10.810508094633065, 6.1891], [39.2217, 5.3109, 4.8109, 40.79990000000001, 10.676708420781527, 6.1891], [39.4217, 5.3109, 4.8109, 40.99990000000001, 10.542944020412744, 6.1891], [39.6217, 5.3109, 4.8109, 41.19990000000001, 10.40936312928563, 6.1891], [39.8217, 5.3109, 4.8109, 41.39990000000001, 10.276113779796818, 6.1891], [40.021699999999996, 5.3109, 4.8109, 41.599900000000005, 10.143343636933354, 6.1891], [40.2217, 5.3109, 4.8109, 41.79990000000001, 10.01119983463246, 6.1891], [40.4217, 5.3109, 4.8109, 41.99990000000001, 9.879828812729892, 6.1891], [40.6217, 5.3109, 4.8109, 42.19990000000001, 9.749376154677433, 6.1891], [40.8217, 5.3109, 4.8109, 42.39990000000001, 9.61998642620941, 6.1891], [41.0217, 5.3109, 4.8109, 42.59990000000001, 9.491803015137105, 6.1891], [41.2217, 5.3109, 4.8109, 42.79990000000001, 9.36496797244843, 6.1891], [41.4217, 5.3109, 4.8109, 42.99990000000001, 9.239621854889098, 6.1891], [41.6217, 5.3109, 4.8109, 43.19990000000001, 9.115903569199721, 6.1891], [41.8217, 5.3109, 4.8109, 43.39990000000001, 8.993950218181322, 6.1891], [42.0217, 5.3109, 4.8109, 43.59990000000001, 8.873896948760077, 6.1891], [42.2217, 5.3109, 4.8109, 43.79990000000001, 8.755876802219415, 6.1891], [42.4217, 5.3109, 4.8109, 43.99990000000001, 8.640020566765612, 6.1891], [42.6217, 5.3109, 4.8109, 44.19990000000001, 8.526456632590241, 6.1891], [42.8217, 5.3109, 4.8109, 44.39990000000001, 8.415310849589975, 6.1891], [43.0217, 5.3109, 4.8109, 44.59990000000001, 8.306706387901633, 6.1891], [43.2217, 5.3109, 4.8109, 44.79990000000001, 8.200763601406768, 6.1891], [43.4217, 5.3109, 4.8109, 44.99990000000001, 8.09759989435729, 6.1891], [43.6217, 5.3109, 4.8109, 45.19990000000001, 7.997329591269773, 6.1891], [43.8217, 5.3109, 4.8109, 45.39990000000001, 7.900063810232681, 6.1891], [44.0217, 5.3109, 4.8109, 45.59990000000001, 7.805910339766942, 6.1891], [44.2217, 5.3109, 4.8109, 45.79990000000001, 7.714973519376266, 6.1891], [44.4217, 5.3109, 4.8109, 45.99990000000001, 7.627354123919626, 6.1891], [44.6217, 5.3109, 4.8109, 46.19990000000001, 7.543149251934048, 6.1891], [44.8217, 5.3109, 4.8109, 46.39990000000001, 7.462452218031397, 6.1891], [45.0217, 5.3109, 4.8109, 46.59990000000001, 7.38535244948851, 6.1891], [45.2217, 5.3109, 4.8109, 46.79990000000001, 7.311935387145179, 6.1891], [45.4217, 5.3109, 4.8109, 46.99990000000001, 7.242282390719857, 6.1891], [45.6217, 5.3109, 4.8109, 47.19990000000001, 7.176470648648015, 6.1891], [45.8217, 5.3109, 4.8109, 47.39990000000001, 7.114573092543024, 6.1891], [46.0217, 5.3109, 4.8109, 47.59990000000001, 7.056658316374422, 6.1891], [46.2217, 5.3109, 4.8109, 47.79990000000001, 7.002790500453072, 6.1891], [46.4217, 5.3109, 4.8109, 47.99990000000001, 6.953029340307462, 6.1891], [46.621700000000004, 5.3109, 4.8109, 48.199900000000014, 6.907429980530015, 6.1891], [46.8217, 5.3109, 4.8109, 48.39990000000001, 6.866042953666639, 6.1891], [47.0217, 5.3109, 4.8109, 48.59990000000001, 6.828914124217296, 6.1891], [47.2217, 5.3109, 4.8109, 48.79990000000001, 6.796084637809646, 6.1891], [47.4217, 5.3109, 4.8109, 48.99990000000001, 6.767590875602037, 6.1891], [47.621700000000004, 5.3109, 4.8109, 49.199900000000014, 6.743464413966466, 6.1891], [47.8217, 5.3109, 4.8109, 49.39990000000001, 6.723731989496078, 6.1891], [48.0217, 5.3109, 4.8109, 49.59990000000001, 6.708415469376077, 6.1891], [48.2217, 5.3109, 4.8109, 49.79990000000001, 6.697531827150826, 6.1891], [48.4217, 5.3109, 4.8109, 49.9891, 6.691093123914012, 6.1891]];
wire_envelope_radius = 0.6890999999999999;
wire_poses = [[11.3029, 49, 7.271348864534672], [11.0351375, 49, 6.971894777676951], [10.767375, 49, 6.657781162348512], [10.4996125, 49, 6.326835613694064], [10.23185, 49, 5.976273828985586], [9.9640875, 49, 5.602426796967032], [9.696325, 49, 5.200288156659104], [9.4285625, 49, 4.7627112895006], [9.1608, 49, 4.278853782503191]];
earliest_contact_gap = 3.2499999999999996;
