gokselozgur5/pcb-design-collar-tracker/assembly/internal-charge-r02/harness.scad

part_boxes = [["C1", [-16.625, 2.9, 11.24088], [1.25, 0.8000000000000003, 0.6400000000000006]], ["C10", [17.44, 13.030000000000001, 9.6], [1.9199999999999982, 1.2399999999999984, 0.8000000000000007]], ["C13", [0.34, -4.2700000000000005, 11.24088], [1.9200000000000002, 1.2400000000000007, 0.8000000000000007]], ["C14", [5.54, 0.27999999999999997, 11.24088], [1.92, 1.24, 0.8000000000000007]], ["C15", [7.04, -4.42, 11.24088], [1.919999999999999, 1.2400000000000002, 0.8000000000000007]], ["C16", [9.780000000000001, -6.46, 11.24088], [1.2399999999999984, 1.92, 0.8000000000000007]], ["C17", [-12.42, -7.21, 9.6], [1.2399999999999984, 1.92, 0.8000000000000007]], ["C18", [-16.425, -7.62, 11.24088], [2.8499999999999996, 1.54, 1.1999999999999993]], ["C19", [-17.16, -9.12, 11.24088], [1.92, 1.2399999999999993, 0.8000000000000007]], ["C2", [-16.4, 4.2749999999999995, 11.24088], [0.7999999999999972, 1.2500000000000009, 0.6400000000000006]], ["C20", [-12.959999999999999, 11.58, 11.24088], [1.9199999999999982, 1.2399999999999984, 0.8000000000000007]], ["C21", [-12.959999999999999, 9.88, 11.24088], [1.9199999999999982, 1.2399999999999984, 0.8000000000000007]], ["C23", [13.040000000000001, 9.98, 11.24088], [1.9199999999999982, 1.2399999999999984, 0.8000000000000007]], ["C24", [13.040000000000001, 7.88, 11.24088], [1.9199999999999982, 1.2399999999999993, 0.8000000000000007]], ["C25", [-7.245, -13.399999999999999, 8.8], [1.9900000000000002, 3.299999999999997, 1.5999999999999996]], ["C26", [-5.71, -8.67, 9.6], [1.92, 1.2400000000000002, 0.8000000000000007]], ["C27", [-9.37, -14.709999999999999, 11.24088], [1.2399999999999984, 1.9199999999999982, 0.8000000000000007]], ["C28", [2.38, -13.459999999999999, 11.24088], [1.2400000000000002, 1.9199999999999982, 0.8000000000000007]], ["C29", [12.040000000000001, -15.62, 11.24088], [1.9199999999999982, 1.2399999999999984, 0.8000000000000007]], ["C3", [-16.995, -5.95, 11.24088], [1.9900000000000002, 3.3000000000000003, 1.6999999999999993]], ["C30", [16.54, 4.88, 11.24088], [1.9200000000000017, 1.2400000000000002, 0.8000000000000007]], ["C31", [-9.87, 11.540000000000001, 11.24088], [1.2399999999999984, 1.9199999999999982, 0.8000000000000007]], ["C32", [-3.87, 13.040000000000001, 11.24088], [1.2400000000000002, 1.9199999999999982, 0.8000000000000007]], ["C33", [-16.62, 13.040000000000001, 9.6], [1.2400000000000002, 1.9199999999999982, 0.8000000000000007]], ["C34", [-8.709999999999999, 13.88, 11.24088], [1.919999999999999, 1.2399999999999984, 0.8000000000000007]], ["C35", [-1.96, 9.13, 11.24088], [1.92, 1.2399999999999984, 0.8000000000000007]], ["C36", [-14.62, -7.96, 9.6], [1.2399999999999984, 1.92, 0.8000000000000007]], ["C4", [-14.225, -3.77, 9.200000000000001], [2.8499999999999996, 1.54, 1.1999999999999993]], ["C5", [-4.875, 7.8, 11.24088], [1.25, 0.7999999999999998, 0.5800000000000001]], ["C6", [-2.96, 8.08, 11.24088], [1.92, 1.2399999999999984, 0.8499999999999996]], ["C7", [-11.209999999999999, -7.62, 11.24088], [1.9199999999999982, 1.2400000000000002, 0.8499999999999996]], ["C8", [-13.825, 1.6, 9.82], [1.2499999999999982, 0.8000000000000003, 0.5800000000000001]], ["C9", [-17.195, -1.95, 8.8], [1.9900000000000002, 3.3, 1.5999999999999996]], ["D1", [13.65, 12.760000000000002, 9.05], [3.4999999999999982, 2.9099999999999984, 1.3499999999999996]], ["D2", [7.05, -3.74, 9.05], [3.499999999999999, 2.91, 1.3499999999999996]], ["FB1", [-16.77, -1.425, 11.24088], [1.5399999999999991, 2.85, 1.1999999999999993]], ["J1", [-2.9000000000000004, -11.5, 11.24088], [6.4, 6.3999999999999995, 2.75]], ["J2", [7.1000000000000005, -0.9999999999999999, 11.24088], [6.3999999999999995, 6.4, 2.75]], ["J4", [-15.45, -13.049999999999999, 8.65], [6.899999999999999, 1.9999999999999982, 1.75]], ["J5", [3.2249999999999996, -12.235, 10.05], [7.549999999999999, 2.469999999999999, 0.34999999999999964]], ["J6", [3.0, -0.65, 8.65], [12.0, 13.299999999999999, 1.75]], ["J7", [-15.87, 6.765, 10.05], [3.7399999999999984, 2.4699999999999998, 0.34999999999999964]], ["L1", [1.9800000000000002, -3.23, 11.24088], [1.0399999999999998, 1.96, 0.8499999999999996]], ["Q1", [14.46, -8.83, 11.24088], [2.91, 3.0300000000000002, 1.3499999999999996]], ["R1", [-16.84, 3.02, 9.75], [1.2799999999999994, 1.9600000000000004, 0.6500000000000004]], ["R12", [1.52, 13.46, 11.24088], [1.96, 1.2799999999999976, 0.6500000000000004]], ["R13", [7.42, 13.360000000000001, 11.24088], [1.959999999999999, 1.2799999999999976, 0.6500000000000004]], ["R14", [2.52, -5.640000000000001, 9.75], [1.9600000000000004, 1.2800000000000011, 0.6500000000000004]], ["R15", [7.02, -4.640000000000001, 9.75], [1.959999999999999, 1.2800000000000007, 0.6500000000000004]], ["R16", [-2.19, -14.979999999999999, 11.24088], [1.2799999999999998, 1.9599999999999973, 0.6500000000000004]], ["R17", [-4.890000000000001, -12.979999999999999, 9.8], [1.2800000000000007, 1.9599999999999973, 0.5999999999999996]], ["R18", [-0.5800000000000001, -12.739999999999998, 11.24088], [1.96, 1.2799999999999976, 0.5999999999999996]], ["R19", [-1.06, -14.37, 11.24088], [1.96, 1.2799999999999994, 0.6500000000000004]], ["R2", [-14.28, 3.36, 9.75], [1.959999999999999, 1.2800000000000007, 0.6500000000000004]], ["R20", [3.52, -14.389999999999999, 11.24088], [1.9600000000000004, 1.2799999999999976, 0.6500000000000004]], ["R21", [15.520000000000001, -10.889999999999999, 11.24088], [1.959999999999999, 1.2799999999999976, 0.6500000000000004]], ["R22", [17.02, -12.139999999999999, 11.24088], [1.9600000000000009, 1.2799999999999976, 0.6500000000000004]], ["R23", [17.11, 9.520000000000001, 11.24088], [1.2800000000000011, 1.9599999999999973, 0.6500000000000004]], ["R24", [-10.479999999999999, 8.860000000000001, 11.24088], [1.9599999999999973, 1.2799999999999976, 0.5999999999999996]], ["R25", [-4.390000000000001, 10.520000000000001, 11.24088], [1.2800000000000007, 1.9599999999999973, 0.5999999999999996]], ["R26", [0.7699999999999999, 10.610000000000001, 11.24088], [1.96, 1.2799999999999976, 0.5999999999999996]], ["R27", [-5.73, 13.610000000000001, 11.24088], [1.9600000000000004, 1.2799999999999976, 0.5999999999999996]], ["R28", [-14.639999999999999, 10.520000000000001, 9.8], [1.2799999999999976, 1.9599999999999973, 0.5999999999999996]], ["R29", [-14.979999999999999, 14.110000000000001, 9.8], [1.9599999999999973, 1.2799999999999976, 0.5999999999999996]], ["R3", [-5.180000000000001, -6.94, 11.24088], [1.9600000000000009, 1.2800000000000002, 0.6500000000000004]], ["R30", [-19.23, 11.360000000000001, 11.24088], [1.9600000000000009, 1.2799999999999976, 0.5999999999999996]], ["R4", [7.319999999999999, -5.94, 11.24088], [1.96, 1.2800000000000002, 0.6500000000000004]], ["R5", [7.319999999999999, -7.34, 11.24088], [1.96, 1.2800000000000002, 0.6500000000000004]], ["R6", [-12.979999999999999, -12.44, 11.24088], [1.9599999999999973, 1.2799999999999994, 0.6500000000000004]], ["R7", [-10.78, -12.44, 11.24088], [1.959999999999999, 1.2799999999999994, 0.6500000000000004]], ["R8", [-8.979999999999999, 11.360000000000001, 9.75], [1.959999999999999, 1.2799999999999976, 0.6500000000000004]], ["R9", [-5.98, 11.360000000000001, 9.75], [1.9600000000000009, 1.2799999999999976, 0.6500000000000004]], ["U1", [-13.92, -4.92, 11.24088], [13.34, 12.34, 1.5500000000000007]], ["U10", [-8.35, 9.75, 11.24088], [2.7, 3.5, 1.3499999999999996]], ["U11", [-2.35, 11.25, 11.24088], [2.7, 3.5, 1.3499999999999996]], ["U12", [-19.599999999999998, 11.225000000000001, 9.05], [2.6999999999999957, 3.549999999999997, 1.3499999999999996]], ["U2", [3.3499999999999996, -4.15, 11.24088], [3.29999, 3.3000000000000003, 0.9499999999999993]], ["U3", [-14.674999999999999, -10.42, 11.24088], [3.349999999999998, 3.04, 1.0500000000000007]], ["U4", [-17.0, 9.680000000000001, 11.24088], [4.0, 3.919999999999998, 1.6999999999999993]], ["U5", [9.280000000000001, 8.14, 11.24088], [3.0799999999999983, 3.0799999999999983, 0.9499999999999993]], ["U6", [-7.55, -14.819999999999999, 11.24088], [4.1, 3.919999999999998, 1.6999999999999993]], ["U7", [-3.8200000000000003, -11.299999999999999, 8.700000000000001], [3.9200000000000004, 4.099999999999999, 1.6999999999999993]], ["U8", [13.225000000000001, -14.37, 11.24088], [3.549999999999997, 2.9099999999999984, 1.3499999999999996]], ["U9", [15.5, 0.71, 11.24088], [2.724999999999998, 3.5150000000000006, 1.0500000000000007]]];
pad_shapes = [[[-17.45, -11.450000000000006], [-16.05, -11.450000000000006], [-16.05, -12.95], [-17.45, -12.95]], [[-13.55336982586033, -12.31737588512799], [-13.580373495767077, -12.453129483099787], [-13.632868441257717, -12.579864134489235], [-13.709079519258006, -12.693921841139355], [-13.806078158860645, -12.790920480741994], [-13.920135865510765, -12.867131558742283], [-14.046870516900213, -12.919626504232923], [-14.181411677551004, -12.946388999999993], [-14.318588322448996, -12.946388999999993], [-14.453129483099787, -12.919626504232923], [-14.579864134489235, -12.867131558742283], [-14.693921841139355, -12.790920480741994], [-14.790920480741994, -12.693921841139355], [-14.867131558742283, -12.579864134489235], [-14.919626504232923, -12.453129483099787], [-14.94663017413967, -12.31737588512799], [-14.95, -12.248772725762194], [-14.95, -12.151227274237812], [-14.94663017413967, -12.082624114872015], [-14.919626504232923, -11.94687051690022], [-14.867131558742283, -11.820135865510771], [-14.790920480741992, -11.706078158860649], [-14.693921841139353, -11.609079519257998], [-14.579864134489235, -11.532868441257708], [-14.453129483099787, -11.480373495767068], [-14.318588322448996, -11.453610999999999], [-14.181411677551004, -11.453610999999999], [-14.046870516900213, -11.480373495767068], [-13.920135865510765, -11.532868441257708], [-13.806078158860647, -11.609079519257998], [-13.709079519258008, -11.706078158860649], [-13.632868441257717, -11.820135865510771], [-13.580373495767077, -11.94687051690022], [-13.55336982586033, -12.082624114872015], [-13.55, -12.151227274237812], [-13.55, -12.248772725762194]]];
rf_paths = [[[0.3, -8.3, 12.890880000000001], [-1.4326487399089483, -8.29590083408391, 12.91639432888889], [-2.968216131328064, -8.28201415036802, 12.98941809777778], [-4.321321569124858, -8.255956169900895, 13.104672480000005], [-5.506584448166835, -8.215343113731103, 13.256878648888891], [-6.538624163321506, -8.15779120290721, 13.440757777777781], [-7.43206010945638, -8.080916658477785, 13.65103104], [-8.201511681438962, -7.982335701491392, 13.882419608888888], [-8.861598274136766, -7.859664552996602, 14.129644657777778], [-9.426939282417294, -7.710519434041976, 14.38742736], [-9.912154101148062, -7.532516565676088, 14.65048888888889], [-10.331862125196572, -7.323272168947502, 14.913550417777776], [-10.700682749430337, -7.080402464904785, 15.17133312], [-11.033235368716864, -6.801523674596503, 15.418558168888888], [-11.344139377923657, -6.484252019071226, 15.649946737777777], [-11.648014171918232, -6.126203719377517, 15.860219999999998], [-11.956597820107728, -5.725931755948243, 16.045272201481477], [-12.270103090057841, -5.285736146753452, 16.205689878518516], [-12.5858614238739, -4.808853669147492, 16.343232639999997], [-12.901204263661228, -4.298521100484707, 16.45966009481481], [-13.213463051525162, -3.7579752181194452, 16.55673185185185], [-13.519969229571025, -3.1904527994060525, 16.63620752], [-13.818054239904143, -2.5991906216988743, 16.699846708148144], [-14.105049524629848, -1.9874254623522591, 16.749409025185184], [-14.378286525853474, -1.35839409872055, 16.786654079999998], [-14.63509668568034, -0.7153333081580968, 16.81334148148148], [-14.872811446215781, -0.06147986801924432, 16.831230838518515], [-15.088762249565125, 0.5999294443416594, 16.84208176], [-15.280280537833693, 1.2656578515702708, 16.847653854814812], [-15.444697753126825, 1.9324685763122416, 16.84970673185185], [-15.579345337549842, 2.597124841213226, 16.849999999999998], [-15.681714811871373, 3.2565745238932826, 16.849999999999998], [-15.749938011513226, 3.908504121870111, 16.849999999999998], [-15.782306850560504, 4.550784787635805, 16.849999999999994], [-15.777113243098317, 5.181287673682459, 16.849999999999998], [-15.732649103211767, 5.797883932502183, 16.849999999999998], [-15.647206344985962, 6.398444716587065, 16.85], [-15.519076882506, 6.980841178429215, 16.849999999999998], [-15.346552629857003, 7.542944470520723, 16.849999999999998], [-15.12792550112406, 8.082625745353697, 16.849999999999998], [-14.86148741039229, 8.597756155420228, 16.849999999999998], [-14.545530271746784, 9.086206853212428, 16.849999999999998], [-14.178345999272663, 9.54584899122238, 16.849999999999998], [-13.75822650705502, 9.974553721942193, 16.849999999999998], [-13.283463709178971, 10.370192197863965, 16.849999999999998], [-12.752349519729613, 10.730635571479796, 16.849999999999998], [-12.164013481182524, 11.05438627690209, 16.849999999999998], [-11.520935649575126, 11.342471874724492, 16.849999999999998], [-10.826433709335323, 11.596551207160948, 16.849999999999994], [-10.083825344891018, 11.818283116425405, 16.849999999999998], [-9.296428240670096, 12.009326444731817, 16.849999999999998], [-8.467560081100464, 12.171340034294126, 16.85], [-7.600538550610009, 12.305982727326285, 16.849999999999998], [-6.6986813336266415, 12.414913366042242, 16.849999999999998], [-5.7653061145782445, 12.499790792655944, 16.849999999999998], [-4.803730577892729, 12.562273849381338, 16.849999999999998], [-3.8172724079979767, 12.604021378432376, 16.849999999999998], [-2.8092492893219014, 12.626692222023006, 16.849999999999998], [-1.7829789062923844, 12.631945222367177, 16.849999999999998], [-0.7417789433373374, 12.621439221678838, 16.849999999999998], [0.31103291511535636, 12.596833062171935, 16.849999999999998], [1.3717703530346863, 12.558725770201503, 16.849999999999998], [2.435272527977264, 12.50347710868694, 16.849999999999998], [3.4960099658966093, 12.426387024688717, 16.849999999999994], [4.548453192746196, 12.32275546526732, 16.849999999999998], [5.5870727344795466, 12.187882377483223, 16.849999999999998], [6.606339117050175, 12.017067708396908, 16.849999999999998], [7.600722866411563, 11.805611405068856, 16.849999999999998], [8.564694508517228, 11.54881341455954, 16.849999999999998], [9.492724569320671, 11.241973683929444, 16.849999999999998], [10.379283574775418, 10.88039216023904, 16.849999999999998], [11.218842050834937, 10.459368790548815, 16.849999999999998], [12.005870523452757, 9.97420352191925, 16.849999999999998], [12.734839518582374, 9.420196301410817, 16.849999999999998], [13.400219562177307, 8.792647076083991, 16.849999999999998], [13.99648118019104, 8.086855792999268, 16.849999999999998], [14.519431188138325, 7.300610662538037, 16.850039506172838], [14.970221559778846, 6.441652948365394, 16.850316049382712], [15.351340558433531, 5.520212177467343, 16.85106666666666], [15.665276447423297, 4.546517876829924, 16.852528395061725], [15.91451749006907, 3.530799573439142, 16.854938271604937], [16.10155194969177, 2.4832867942810006, 16.85853333333333], [16.228868089612323, 1.4142090663415394, 16.86355061728395], [16.29895417315165, 0.3337959166067641, 16.870227160493826], [16.314298463630674, -0.7477231279373103, 16.8788], [16.277389224370317, -1.8201185403046836, 16.889506172839504], [16.190714718691506, -2.873160793509307, 16.90258271604938], [16.05676320991516, -3.896620360565182, 16.918266666666668], [15.878022961362202, -4.880267714486292, 16.93679506172839], [15.656982236353553, -5.813873328286633, 16.9584049382716], [15.396129298210143, -6.687207674980161, 16.983333333333334], [15.097967277198368, -7.491780838284664, 17.011705061728392], [14.765058771366546, -8.226061344733056, 17.043196049382715], [14.399981245708464, -8.890257331562042, 17.077369999999995], [14.005312165217928, -9.48457693600831, 17.113790617283946], [13.583628994888729, -10.009228295308569, 17.15202160493827], [13.137509199714657, -10.464419546699524, 17.191626666666664], [12.669530244689513, -10.850358827417868, 17.232169506172838], [12.182269594807096, -11.167254274700305, 17.27321382716049], [11.678304715061188, -11.415314025783536, 17.31432333333333], [11.160213070445588, -11.594746217904266, 17.35506172839506], [10.630572125954096, -11.705758988299191, 17.394992716049384], [10.091959346580506, -11.748560474205014, 17.433679999999995], [9.546952197318609, -11.72335881285844, 17.470687283950614], [8.998128143162194, -11.630362141496162, 17.505578271604936], [8.44806464910507, -11.469778597354889, 17.537916666666668], [7.897649978468155, -11.2435667964794, 17.56735950617284], [7.3410155878808805, -10.96068727014683, 17.593937160493827], [6.7706037322998025, -10.631851028442382, 17.617773333333332], [6.178856666681501, -10.267769081451274, 17.638991728395062], [5.558216645982533, -9.879152439258718, 17.657716049382714], [4.90112592515946, -9.476712111949922, 17.674069999999997], [4.200026759168835, -9.071159109610097, 17.688177283950616], [3.4473614029672426, -8.673204442324462, 17.700161604938273], [2.6355721115112347, -8.293559120178223, 17.710146666666667], [1.757101139757364, -7.942934153256592, 17.718256172839503], [0.804390742662217, -7.632040551644784, 17.724613827160493], [-0.23011682481765472, -7.371589325428009, 17.729343333333333], [-1.3539793077256874, -7.172291484691479, 17.732568395061726], [-2.5747544511053344, -7.044858039520404, 17.734412716049384], [-3.9, -7.0, 17.735]], [[10.3, 2.2, 12.890880000000001], [10.291420641291582, 3.1052393536355765, 12.90479432888889], [10.263143498964665, 3.9781381478203675, 12.94461809777778], [10.211359973716737, 4.817741179370881, 13.007472480000004], [10.1322614662453, 5.623093245103625, 13.09047864888889], [10.022039377247848, 6.393239141835107, 13.19075777777778], [9.876885107421874, 7.127223666381838, 13.305431040000002], [9.69299005746488, 7.8240916155603175, 13.431619608888887], [9.466545628074364, 8.482887786187066, 13.56644465777778], [9.193743219947814, 9.102656975078581, 13.707027360000001], [8.870774233782734, 9.682443979051378, 13.85048888888889], [8.493830070276612, 10.221293594921956, 13.993950417777778], [8.059102130126954, 10.718250619506835, 14.134533120000002], [7.562781814031246, 11.172359849622513, 14.26935816888889], [7.001060522686993, 11.582666082085499, 14.395546737777778], [6.370129656791686, 11.948214113712307, 14.51022], [5.668166448409468, 12.268176116787943, 14.611138868148151], [4.901291455071061, 12.542233765471419, 14.698623211851853], [4.077611065673828, 12.770196109390257, 14.77363264], [3.2052316691151375, 12.951872198171964, 14.837126761481482], [2.2922596542923537, 13.087071081444066, 14.890065185185184], [1.3468014101028463, 13.175601808834072, 14.93340752], [0.3769633254439755, 13.2172734299695, 14.968113374814816], [-0.6091482107868886, 13.21189499447787, 14.99514235851852], [-1.6034268096923832, 13.159275551986692, 15.015454080000001], [-2.597766082375138, 13.059224152123484, 15.030008148148148], [-3.5840596399377906, 12.911549844515761, 15.039764171851854], [-4.554201093482971, 12.716061678791043, 15.04568176], [-5.500084054113317, 12.472568704576842, 15.048720521481481], [-6.413602132931461, 12.180879971500676, 15.049840065185185], [-7.2866489410400375, 11.840804529190061, 15.05], [-8.112649071615708, 11.4525430868502, 15.05], [-8.891151046131274, 11.017862991997044, 15.05], [-9.623234368133545, 10.538923251724238, 15.05], [-10.30997854116934, 10.017882873125426, 15.05], [-10.952463068785491, 9.456900863294246, 15.050000000000004], [-11.551767454528806, 8.85813622932434, 15.05], [-12.108971201946115, 8.223747978309346, 15.05], [-12.625153814584234, 7.555895117342912, 15.05], [-13.10139479598999, 6.8567366535186745, 15.05], [-13.53877364971019, 6.12843159393028, 15.05], [-13.938369879291674, 5.3731389456713625, 15.05], [-14.301262988281245, 4.593017715835572, 15.05], [-14.628532480225735, 3.790226911516542, 15.05], [-14.92125785867196, 2.9669255398079217, 15.05], [-15.180518627166744, 2.1252726078033444, 15.05], [-15.406764578854592, 1.2679218950554205, 15.050074074074075], [-15.597926665270766, 0.39950627095257824, 15.050592592592594], [-15.751306127548213, -0.4748466226577789, 15.052], [-15.864204206819885, -1.350009143928245, 15.054740740740742], [-15.933922144218723, -2.2208536510114327, 15.059259259259264], [-15.957761180877682, -3.082252502059934, 15.065999999999999], [-15.933022557929704, -3.9290780552263627, 15.075407407407408], [-15.857007516507746, -4.756202668663304, 15.087925925925926], [-15.727017297744746, -5.558498700523376, 15.104], [-15.540353142773661, -6.330838508959166, 15.124074074074075], [-15.29431629272743, -7.068094452123289, 15.148592592592593], [-14.986207988739011, -7.765138888168332, 15.178], [-14.613329471941343, -8.416844175246908, 15.212740740740742], [-14.172981983467382, -9.01808267151161, 15.25325925925926], [-13.66246676445007, -9.56372673511505, 15.3], [-13.080434435455887, -10.049953124328892, 15.353111111111112], [-12.430933134785406, -10.478156197901122, 15.411555555555555], [-11.719360380172725, -10.851034714698791, 15.474], [-10.951113689351962, -11.171287433588944, 15.539111111111112], [-10.131590580057216, -11.441613113438638, 15.605555555555554], [-9.266188570022576, -11.66471051311493, 15.672], [-8.36030517698217, -11.843278391484859, 15.737111111111112], [-7.419337918670089, -11.980015507415484, 15.799555555555557], [-6.448684312820438, -12.077620619773864, 15.857999999999999], [-5.453741877167307, -12.13879248742704, 15.911111111111111], [-4.4399081294448255, -12.166229869242066, 15.957555555555555], [-3.4125805873870863, -12.162631524085995, 15.996], [-2.377156768728191, -12.130696210825883, 16.02511111111111], [-1.3390341912022306, -12.073122688328777, 16.043555555555557], [-0.3036103725433352, -11.992609715461729, 16.05], [0.7238071281433066, -11.89127132000393, 16.04355555555556], [1.7382705862680994, -11.76888260538313, 16.02511111111111], [2.7349222358703633, -11.624633943939209, 15.996], [3.7089043109893787, -11.45771570801205, 15.957555555555555], [4.655359045664465, -11.26731826994154, 15.911111111111111], [5.56942867393494, -11.052632002067563, 15.857999999999999], [6.446255429840088, -10.812847276730004, 15.799555555555557], [7.280981547419227, -10.54715446626875, 15.737111111111112], [8.068749260711664, -10.254743943023682, 15.672], [8.804700803756717, -9.934806079334681, 15.605555555555556], [9.483978410593668, -9.58653124754164, 15.539111111111112], [10.101724315261837, -9.209109819984436, 15.474], [10.65308075180053, -8.801732169002957, 15.411555555555557], [11.133189954249062, -8.363588666937083, 15.353111111111112], [11.537194156646727, -7.893869686126708, 15.3], [11.861315096579654, -7.3929350610874325, 15.25345814814815], [12.106092525821259, -6.865822475037755, 15.214331851851853], [12.273145699691767, -6.318739073371884, 15.18337], [12.364093873511418, -5.757892001484058, 15.161321481481483], [12.380556302600432, -5.189488404768485, 15.148935185185186], [12.324152242279048, -4.61973542861938, 15.14696], [12.196500947867495, -4.054840218430977, 15.156144814814816], [11.999221674686005, -3.5010099195974846, 15.177238518518518], [11.73393367805481, -2.964451677513125, 15.21099], [11.40225621329413, -2.4513726375721085, 15.258148148148148], [11.005808535724213, -1.9679799451686706, 15.319461851851853], [10.54620990066528, -1.520480745697022, 15.395679999999999], [10.025079563437568, -1.115082184551382, 15.48755148148148], [9.444036779361298, -0.7579914071259666, 15.595825185185188], [8.804700803756711, -0.45541555881500245, 15.72125], [8.110669981779875, -0.2100123248064969, 15.863853333333333], [7.373459017930211, -0.010241549463626737, 16.020776666666666], [6.606561706542966, 0.15898638305664106, 16.18844], [5.823471841953419, 0.3127610885973328, 16.363263333333336], [5.037683218496819, 0.4661721830014821, 16.541666666666664], [4.262689630508428, 0.6343092821121201, 16.720069999999996], [3.511984872323494, 0.8322620017722804, 16.894893333333332], [2.7990627382772946, 1.075119957824989, 17.062556666666666], [2.137417022705081, 1.3779727661132795, 17.219479999999997], [1.540541519942104, 1.7559100424801881, 17.36208333333333], [1.0219300243236393, 2.2240214027687357, 17.486786666666667], [0.5950763301849373, 2.7973964628219585, 17.59001], [0.2734742318612574, 3.4911248384828872, 17.668173333333332], [0.07061752368785665, 4.320296145594566, 17.71769666666667], [0.0, 5.3, 17.735]]];
tail_ys = [-3.3, 6];
fillet_height = 1.05;
fillet_x = [21.7, 22.15];
fillet_radius = 0.55;
// Nominal assembled wire prototype; geometry is not a production release.
part="review";
$fn=48;
module body(){import("../../mechanical/swim-r16-contact-retention/body.stl");}
module carrier(){translate([0,0,1.8])import("../../mechanical/swim-r12-pack-retention/carrier.stl");}
module retainer(){translate([0,0,10.6])import("../../mechanical/swim-r11-thermal-fit/retainer.stl");}
module wires(){import("red-wire.stl");import("black-wire.stl");}
module terminals(){translate([21.6,-6,2.35])import("../../mechanical/swim-r16-contact-retention/positive_terminal.stl");translate([21.6,6,2.35])import("../../mechanical/swim-r16-contact-retention/negative_terminal.stl");}
module pcb_fillet(i){translate([0,0,11.24088])linear_extrude(fillet_height)polygon(pad_shapes[i]);}
module terminal_fillet(i){translate([fillet_x[0],tail_ys[i],13.3])rotate([0,90,0])cylinder(r=fillet_radius,h=fillet_x[1]-fillet_x[0]);}
module joints(){for(i=[0:1]){pcb_fillet(i);terminal_fillet(i);}}
module components(){for(b=part_boxes)translate(b[1])cube(b[2]);}
module obstacles(){body();carrier();retainer();components();}
module collision(){intersection(){union(){wires();joints();}obstacles();}}
module metal_collision(){intersection(){wires();terminals();}}
module lowered_wire_control(){intersection(){translate([0,0,-1])import("black-wire.stl");components();}}
module rf_leads(){for(j=[0:1])color(j==0?[.9,.62,.2,.45]:[.15,.45,.85,.45])for(i=[0:len(rf_paths[j])-2])hull(){translate(rf_paths[j][i])sphere(r=.565,$fn=12);translate(rf_paths[j][i+1])sphere(r=.565,$fn=12);}}
module review(){
 color([.72,.76,.80,.2])body();
 color([.26,.62,.68,.25])carrier();
 color([.63,.3,.66,.35])retainer();
 color([.35,.42,.48,.5])components();
 color([.85,.7,.2])terminals();
 color([.75,.75,.78])joints();
 color([.9,.15,.12])import("red-wire.stl");
 color([.1,.12,.15])import("black-wire.stl");
 color([.15,.45,.25,.4])translate([-20,-16,10.4])cube([40,32,.84088]);
 rf_leads();
}
if(part=="collision")collision();
else if(part=="metal_collision")metal_collision();
else if(part=="lowered_wire_control")lowered_wire_control();
else review();
