gokselozgur5/pcb-design-collar-tracker/assembly/internal-charge-r03/black-fixture.scad

path=[[41.574985109204, 22.380881091257013, 4.2902000000000005], [40.775, 22.375999999999998, 4.2902000000000005], [40.27153100257621, 22.372928095169232, 4.4548182308946895], [39.80513703737394, 22.364448595563278, 4.6009436308173814], [39.37324701679244, 22.351665823511638, 4.730293544118405], [38.973289853230966, 22.335684101343826, 4.844585315148096], [38.60269445908881, 22.317607751389346, 4.945536288256802], [38.2588897467652, 22.298541095977704, 5.034863807794846], [37.939304628659414, 22.279588457438408, 5.114285218112569], [37.64136801717072, 22.261854158100974, 5.1855178635603085], [37.36244828207964, 22.246345786537656, 5.250161142134136], [37.099671622691815, 22.233683996291763, 5.3093426664130465], [36.85010369569418, 22.224392707149356, 5.364072102621785], [36.61081015777363, 22.218995838896493, 5.415359116985071], [36.378856665617064, 22.218017311319237, 5.464213375727647], [36.151308875911425, 22.22198104420365, 5.511644545074246], [35.9252324453436, 22.231410957335786, 5.558662291249597], [35.69769303060052, 22.246830970501712, 5.606276280478442], [35.46626917170616, 22.268719767143136, 5.655312927450913], [35.230590942032684, 22.297375085324376, 5.705865640718786], [34.99080129828935, 22.333049426765395, 5.757844577299229], [34.747043197185405, 22.375995293186165, 5.8111598942094265], [34.499459595430096, 22.426465186306643, 5.865721748466552], [34.248193449732675, 22.484711607846805, 5.921440297087779], [33.993387716802374, 22.550987059526612, 5.978225697090284], [33.735185353348434, 22.62554404306603, 6.035988105491242], [33.47378723606301, 22.708683538479878, 6.094685745450107], [33.20962592156979, 22.800900438962394, 6.154469104695421], [32.943191886475375, 22.902738116002674, 6.215536737098008], [32.67497560738636, 23.014739941089804, 6.2780871965286895], [32.405467560909344, 23.13744928571288, 6.342319036858283], [32.135158223650905, 23.271409521360987, 6.40843081195761], [31.86453807221765, 23.41716401952322, 6.476621075697491], [31.59409758321617, 23.57525615168867, 6.547088381948749], [31.32348309992569, 23.745786754403095, 6.6197381163761175], [31.048964432315962, 23.9270865244389, 6.693302991819991], [30.76596725702936, 24.117043623625158, 6.76622255291467], [30.469917250708264, 24.313546213790943, 6.836936344294468], [30.156240089995052, 24.51448245676533, 6.90388391059369], [29.8203614515321, 24.717740514377386, 6.965504796446645], [29.457707011961794, 24.921208548456192, 7.020238546487638], [29.06370244792651, 25.122774720830815, 7.066524705350977], [28.633606618171832, 25.32008981934395, 7.103488610223335], [28.162011109856227, 25.509855135892774, 7.132998768500853], [27.643340692241352, 25.688534588388073, 7.157609480132043], [27.07202013458886, 25.852592094740658, 7.179875045065417], [26.442474206160444, 25.998491572861305, 7.202349763249478], [25.749127676217746, 26.122696940660816, 7.2275879346327425], [24.98640531402245, 26.221672116049987, 7.258143859163722], [24.1487318888362, 26.291881016939616, 7.296571836790916], [23.233044004677918, 26.329338459996727, 7.343059677264312], [22.246325604595416, 26.328262856913298, 7.388329229539741], [21.19807246639374, 26.282423518137538, 7.420735852374511], [20.097780367877963, 26.185589754117668, 7.428634904525934], [18.954945086853122, 26.03153087530189, 7.400381744751302], [17.779062401124293, 25.814016192138418, 7.324331731807936], [16.579628088496523, 25.52681501507547, 7.188840224453129], [15.366137926774853, 25.163696654561253, 6.982262581444198], [14.149408912105946, 24.720535617964003, 6.69934537980534], [12.945542914002749, 24.201627200332045, 6.360400069628344], [11.771963020319843, 23.613371893633733, 5.992129319271905], [10.646092318911775, 22.962170189837416, 5.621235797094712], [9.58535389763309, 22.254422580911438, 5.2744221714554484], [8.607170844338361, 21.49652955882416, 4.978391110712808], [7.7289662468821305, 20.694891615543924, 4.759845283225477], [6.9681631931189685, 19.855909243039083, 4.645487357352144], [6.3375656847577115, 18.985190339184147, 4.652923254888462], [5.831501378924354, 18.085172425478248, 4.763371911377929], [5.439678846599193, 17.157500429326703, 4.948955515801002], [5.15180665876251, 16.2038192781348, 5.181796257138144], [4.957593386394597, 15.225773899307857, 5.434016324369811], [4.846747600475741, 14.225009220251167, 5.677737906476464], [4.808977871986221, 13.203170168370018, 5.885083192438568], [4.833992771906335, 12.161901671069735, 6.028174371236574], [4.9074786307639275, 11.104157864845025, 6.08100039235609], [4.999032817277092, 10.03812972254833, 6.025017247303268], [5.074230459711492, 8.973317426121497, 5.84354768808941], [5.098646686332781, 7.919221157506364, 5.519914466725808], [5.03785662540662, 6.885341098644805, 5.037440335223772], [4.857435405198665, 5.881177431478648, 4.379448045594586], [4.522958153974567, 4.916230337949765, 3.529260349849565], [4.0, 3.9999999999999982, 2.4702], [3.6034330553640803, 3.3052089102311877, 2.4702]];
size=[44.775, 30.329338459996727, 9.0];
radius=0.4702;

part="fixture";
module slot(r){for(i=[0:len(path)-2])hull(){
 for(j=[i:i+1])translate([path[j][0],path[j][1],path[j][2]-r])cylinder(r=r,h=size[2]+2-path[j][2]+r,$fn=24);
}}
module label(){translate([3,1,size[2]-.3])linear_extrude(.31)text("BLACK R19",size=2);}
module fixture(r=radius){difference(){cube(size);slot(r);label();}}
if(part=="label")label();
else if(part=="fixture")fixture();
else if(part=="collision")intersection(){import("black-fixture.stl");import("black-fixture-witness.stl");}
else if(part=="raised_floor_control")intersection(){translate([0,0,.30])import("black-fixture.stl");import("black-fixture-witness.stl");}
else {color([.65,.67,.72])import("black-fixture.stl");color([.08,.09,.12])import("black-fixture-wire.stl");}
