gokselozgur5/pcb-design-collar-tracker/assembly/internal-charge-r03/red-fixture.scad

path=[[44.18799741357781, 14.334214298024765, 4.2902000000000005], [43.388, 14.33218002449102, 4.2902000000000005], [42.5352814796724, 14.330011689083685, 4.45264835706587], [41.723343597738875, 14.323753679851709, 4.568309197388027], [40.94996214344714, 14.313776492280143, 4.642274189496719], [40.21291290604486, 14.300450621854033, 4.679635001922195], [39.50997167477975, 14.284146564058426, 4.685483303194701], [38.8389142388995, 14.265234814378372, 4.66491076184448], [38.197516387651795, 14.244085868298919, 4.623009046401776], [37.58355391028434, 14.221070221305114, 4.564869825396835], [36.994804548622085, 14.196558556979634, 4.495585621814504], [36.429053854799, 14.170922311295667, 4.420252376458006], [35.884089333526354, 14.144533108324037, 4.343966884585177], [35.35769848951537, 14.117762572135556, 4.2718259414538355], [34.8476688274773, 14.090982326801045, 4.208926342321815], [34.35178785212338, 14.064563996391325, 4.160364882446936], [33.86784306816486, 14.038879204977212, 4.13123835708703], [33.39362198031297, 14.014299576629524, 4.126643561499927], [32.927183848082336, 13.991001367356137, 4.150378333224181], [32.46767495020096, 13.96837936091316, 4.201044678921285], [32.01451332020022, 13.945632972993746, 4.275945647533463], [31.56711699161152, 13.921961619291064, 4.372384288002943], [31.12490399796622, 13.896564715498272, 4.487663649271946], [30.68729237279572, 13.868641677308531, 4.619086780282705], [30.253700149631392, 13.837391920415003, 4.763956729977432], [29.823545362004616, 13.802014860510852, 4.919576547298359], [29.39624585443177, 13.761709884064826, 5.083249139962092], [28.97121871536917, 13.715676260648038, 5.2522768507827795], [28.547880844258124, 13.663113230607195, 5.42396188134895], [28.125649140539956, 13.603220034288995, 5.595606433249136], [27.703940503655968, 13.535195912040141, 5.764512708071864], [27.282171833047475, 13.45824010420734, 5.927982907405669], [26.859760028155783, 13.371551851137289, 6.0833192328390755], [26.436121988422208, 13.274330393176694, 6.227823885960618], [26.010934340842294, 13.165904617441875, 6.359248969290494], [25.584912622628508, 13.046121998127635, 6.477146189075581], [25.15903209854755, 12.914959656198391, 6.581517152494419], [24.734268033366117, 12.772394712618558, 6.672363466725551], [24.311595691850915, 12.618404288352558, 6.7496867389475295], [23.89199033876864, 12.45296550436481, 6.813488576338889], [23.476427238885993, 12.276055481619732, 6.863770586078184], [23.065881656969676, 12.08765134108174, 6.9005343753439465], [22.661328713168185, 11.88773019379601, 6.9237817334826754], [22.263742949157223, 11.676269111130743, 6.933515178512671], [21.874098761994283, 11.45324515453489, 6.92973741062017], [21.493370548736852, 11.218635385457404, 6.912451129991426], [21.122532706442442, 10.97241686534724, 6.881659036812676], [20.76255963216854, 10.71456665565335, 6.837363831270171], [20.414425722972645, 10.445061817824692, 6.779568213550151], [20.07910537591225, 10.163879413310216, 6.708274883838866], [19.756925622252755, 9.871285174485795, 6.623777905451687], [19.445624030091174, 9.568699517434972, 6.527536794220493], [19.14229080173242, 9.257831529168207, 6.421302429106282], [18.8440161394814, 8.940390296695968, 6.306825689070072], [18.547890245643035, 8.61808490702871, 6.185857453072858], [18.251003322522237, 8.292624447176902, 6.0601486000756495], [17.950445572423916, 7.965718004150997, 5.931450009039455], [17.643307197652987, 7.639074664961457, 5.801512558925278], [17.326650701943546, 7.314403624597672, 5.672152806216715], [16.997427794746386, 6.993414509964671, 5.545450017487754], [16.65256248694149, 6.677817055946424, 5.423549136834975], [16.288978789408837, 6.369320997426886, 5.308595108354963], [15.903600713028403, 6.069636069290011, 5.202732876144287], [15.49335226868017, 5.780472006419767, 5.108107384299531], [15.05515746724411, 5.50353854370011, 5.0268635769172825], [14.585940319600208, 5.240545416014999, 4.96114639809411], [14.083517157000845, 4.993507786682272, 4.911807035886943], [13.549273592188003, 4.765662532755298, 4.874521654194071], [12.985487558276088, 4.560551959721321, 4.843672660874132], [12.39443698837948, 4.381718373067587, 4.81364246378576], [11.778399815612582, 4.232704078281342, 4.778813470787595], [11.139653973089784, 4.1170513808498335, 4.733568089738272], [10.480477393925472, 4.038302586260304, 4.6722887284964205], [9.803148011234054, 4.0, 4.589357794920684], [9.10993523469933, 4.0056887802051, 4.4791535119764685], [8.403074380282842, 4.058925495607491, 4.336037363056288], [7.6847922405155344, 4.163269567587999, 4.154366646659431], [6.957315607928354, 4.322280417527448, 3.928498661285177], [6.222871275052263, 4.53951746680665, 3.6527907054328264], [5.483686034418202, 4.818540136806433, 3.321600077601648], [4.741986678557133, 5.162907848907617, 2.929284076290948], [4.0, 5.576180024491022, 2.4702], [3.301097405585289, 5.9654552016091955, 2.4702]];
size=[47.388, 18.33218002449102, 9.0];
radius=0.4702;

part="fixture";
module slot(r){for(i=[0:len(path)-2])hull(){
 for(j=[i:i+1])translate([path[j][0],path[j][1],path[j][2]-r])cylinder(r=r,h=size[2]+2-path[j][2]+r,$fn=24);
}}
module label(){translate([3,1,size[2]-.3])linear_extrude(.31)text("RED R19",size=2);}
module fixture(r=radius){difference(){cube(size);slot(r);label();}}
if(part=="label")label();
else if(part=="fixture")fixture();
else if(part=="collision")intersection(){import("red-fixture.stl");import("red-fixture-witness.stl");}
else if(part=="raised_floor_control")intersection(){translate([0,0,.30])import("red-fixture.stl");import("red-fixture-witness.stl");}
else {color([.65,.67,.72])import("red-fixture.stl");color([.95,.15,.1])import("red-fixture-wire.stl");}
