gokselozgur5/pcb-design-collar-tracker/mechanical/swim-r02-fit/populated.scad

// Generated by scripts/audit_populated_fit.py. Conservative fit envelopes, not detailed part models.
fit_boxes = [["C1", [-16.625, 2.9, 10.8], [1.25, 0.8000000000000003, 0.6400000000000006], "existing_bom_part"], ["C10", [17.44, 13.030000000000001, 9.2], [1.9199999999999982, 1.2399999999999984, 0.8000000000000007], "candidate_part"], ["C13", [0.34, -4.2700000000000005, 10.8], [1.9200000000000002, 1.2400000000000007, 0.8000000000000007], "candidate_part"], ["C14", [5.54, 0.27999999999999997, 10.8], [1.92, 1.24, 0.8000000000000007], "candidate_part"], ["C15", [7.04, -4.42, 10.8], [1.919999999999999, 1.2400000000000002, 0.8000000000000007], "candidate_part"], ["C16", [9.780000000000001, -6.46, 10.8], [1.2399999999999984, 1.92, 0.8000000000000007], "candidate_part"], ["C17", [-12.42, -7.21, 9.2], [1.2399999999999984, 1.92, 0.8000000000000007], "candidate_part"], ["C18", [-16.425, -7.62, 10.8], [2.8499999999999996, 1.54, 1.1999999999999993], "candidate_part"], ["C19", [-17.16, -9.12, 10.8], [1.92, 1.2399999999999993, 0.8000000000000007], "candidate_part"], ["C2", [-16.4, 4.2749999999999995, 10.8], [0.7999999999999972, 1.2500000000000009, 0.6400000000000006], "existing_bom_part"], ["C20", [-12.959999999999999, 11.58, 10.8], [1.9199999999999982, 1.2399999999999984, 0.8000000000000007], "candidate_part"], ["C21", [-12.959999999999999, 9.88, 10.8], [1.9199999999999982, 1.2399999999999984, 0.8000000000000007], "candidate_part"], ["C22", [-5.96, -0.62, 9.2], [1.92, 1.24, 0.8000000000000007], "candidate_part"], ["C23", [13.040000000000001, 9.98, 10.8], [1.9199999999999982, 1.2399999999999984, 0.8000000000000007], "candidate_part"], ["C24", [13.040000000000001, 7.88, 10.8], [1.9199999999999982, 1.2399999999999993, 0.8000000000000007], "candidate_part"], ["C3", [-16.995, -5.95, 10.8], [1.9900000000000002, 3.3000000000000003, 1.6999999999999993], "existing_bom_part"], ["C4", [-14.225, -3.77, 8.8], [2.8499999999999996, 1.54, 1.1999999999999993], "existing_bom_part"], ["C5", [-4.875, 7.8, 10.8], [1.25, 0.7999999999999998, 0.5800000000000001], "existing_bom_part"], ["C6", [-2.96, 8.08, 10.8], [1.92, 1.2399999999999984, 0.8499999999999996], "existing_bom_part"], ["C7", [-11.209999999999999, -7.62, 10.8], [1.9199999999999982, 1.2400000000000002, 0.8499999999999996], "existing_bom_part"], ["C8", [-13.825, 1.6, 9.42], [1.2499999999999982, 0.8000000000000003, 0.5800000000000001], "candidate_part"], ["C9", [-16.82, -0.66, 9.2], [1.2400000000000002, 1.92, 0.8000000000000007], "candidate_part"], ["D1", [13.65, 12.760000000000002, 8.65], [3.4999999999999982, 2.9099999999999984, 1.3499999999999996], "existing_bom_part"], ["D2", [7.05, -3.74, 8.65], [3.499999999999999, 2.91, 1.3499999999999996], "existing_bom_part"], ["FB1", [-16.77, -1.425, 10.8], [1.5399999999999991, 2.85, 1.1999999999999993], "existing_bom_part"], ["J1", [-2.9000000000000004, -11.5, 10.8], [6.4, 6.3999999999999995, 2.75], "existing_bom_with_mate_requirement"], ["J2", [7.1000000000000005, -0.9999999999999999, 10.8], [6.3999999999999995, 6.4, 2.75], "existing_bom_with_mate_requirement"], ["J3", [-17.7, -13.2, 10.8], [4.399999999999999, 1.9999999999999982, 1.75], "harness_reservation"], ["J4", [-15.45, -13.049999999999999, 8.25], [6.899999999999999, 1.9999999999999982, 1.75], "harness_reservation"], ["J5", [3.2249999999999996, -12.235, 9.65], [7.549999999999999, 2.469999999999999, 0.34999999999999964], "bare_pads"], ["J6", [3.0, -0.65, 8.25], [12.0, 13.299999999999999, 1.75], "existing_bom_part"], ["J7", [-15.87, 6.765, 9.65], [3.7399999999999984, 2.4699999999999998, 0.34999999999999964], "bare_pads"], ["L1", [1.9800000000000002, -3.23, 10.8], [1.0399999999999998, 1.96, 0.8499999999999996], "existing_bom_part"], ["R1", [-16.84, 3.02, 9.35], [1.2799999999999994, 1.9600000000000004, 0.6500000000000004], "candidate_part"], ["R10", [-8.979999999999999, 1.36, 9.35], [1.959999999999999, 1.28, 0.6500000000000004], "candidate_part"], ["R11", [-5.98, 1.36, 9.35], [1.9600000000000009, 1.28, 0.6500000000000004], "candidate_part"], ["R12", [1.52, 13.46, 10.8], [1.96, 1.2799999999999976, 0.6500000000000004], "candidate_part"], ["R13", [7.42, 13.360000000000001, 10.8], [1.959999999999999, 1.2799999999999976, 0.6500000000000004], "candidate_part"], ["R14", [2.52, -5.640000000000001, 9.35], [1.9600000000000004, 1.2800000000000011, 0.6500000000000004], "candidate_part"], ["R15", [7.02, -4.640000000000001, 9.35], [1.959999999999999, 1.2800000000000007, 0.6500000000000004], "candidate_part"], ["R2", [-14.28, 3.36, 9.35], [1.959999999999999, 1.2800000000000007, 0.6500000000000004], "candidate_part"], ["R3", [-5.48, -6.94, 10.8], [1.9600000000000004, 1.2800000000000002, 0.6500000000000004], "candidate_part"], ["R4", [7.319999999999999, -5.94, 10.8], [1.96, 1.2800000000000002, 0.6500000000000004], "candidate_part"], ["R5", [7.319999999999999, -7.34, 10.8], [1.96, 1.2800000000000002, 0.6500000000000004], "candidate_part"], ["R6", [-12.979999999999999, -12.44, 10.8], [1.9599999999999973, 1.2799999999999994, 0.6500000000000004], "candidate_part"], ["R7", [-10.78, -12.44, 10.8], [1.959999999999999, 1.2799999999999994, 0.6500000000000004], "candidate_part"], ["R8", [-8.979999999999999, 11.360000000000001, 9.35], [1.959999999999999, 1.2799999999999976, 0.6500000000000004], "candidate_part"], ["R9", [-5.98, 11.360000000000001, 9.35], [1.9600000000000009, 1.2799999999999976, 0.6500000000000004], "candidate_part"], ["U1", [-13.92, -4.92, 10.8], [13.34, 12.34, 1.5500000000000007], "existing_bom_part"], ["U2", [3.3499999999999996, -4.15, 10.8], [3.29999, 3.3000000000000003, 0.9499999999999993], "existing_bom_part"], ["U3", [-14.674999999999999, -10.42, 10.8], [3.349999999999998, 3.04, 1.0500000000000007], "existing_bom_part"], ["U4", [-17.0, 9.680000000000001, 10.8], [4.0, 3.919999999999998, 1.6999999999999993], "existing_bom_part"], ["U5", [9.280000000000001, 8.14, 10.8], [3.0799999999999983, 3.0799999999999983, 0.9499999999999993], "existing_bom_part"]];
carrier_reliefs = [[3.8, 14.8, 14.4, 18.8, 1.5], [13.4, 14.8, 17.6, 18.8, 1.5], [17.8, -9.6, 21.8, -2.4, 0.5], [17.8, 2.4, 21.8, 9.6, 0.5]];
retention_d = 6.4;
retention_stack = 2.8;
