gokselozgur5/pcb-design-collar-tracker/mechanical/swim-r11-thermal-fit/cables.scad

// Generated by check_antenna_assembly.py; nominal conditional cable geometry.
cable_radius = 0.565;
cable_0 = [[0.3, -8.3, 12.89088], [-0.241358, -8.299656, 12.893232], [-0.764058, -8.298582, 12.900192], [-1.268494, -8.296712, 12.911618], [-1.755061, -8.293983, 12.927367], [-2.224154, -8.29033, 12.947297], [-2.676167, -8.285689, 12.971266], [-3.111496, -8.279995, 12.99913], [-3.530535, -8.273185, 13.030748], [-3.933679, -8.265193, 13.065976], [-4.321322, -8.255956, 13.104672], [-4.693859, -8.245409, 13.146695], [-5.051685, -8.233488, 13.1919], [-5.395194, -8.220127, 13.240146], [-5.724782, -8.205264, 13.29129], [-6.040843, -8.188834, 13.345189], [-6.343772, -8.170771, 13.401701], [-6.633964, -8.151013, 13.460684], [-6.911812, -8.129494, 13.521995], [-7.177713, -8.10615, 13.585492], [-7.43206, -8.080917, 13.651031], [-7.675249, -8.05373, 13.718471], [-7.907674, -8.024525, 13.787668], [-8.129729, -7.993239, 13.858481], [-8.34181, -7.959805, 13.930767], [-8.544312, -7.92416, 14.004382], [-8.737628, -7.88624, 14.079186], [-8.922155, -7.845981, 14.155035], [-9.098285, -7.803317, 14.231786], [-9.266415, -7.758185, 14.309298], [-9.426939, -7.710519, 14.387427], [-9.580252, -7.660257, 14.466032], [-9.726748, -7.607333, 14.544969], [-9.866822, -7.551683, 14.624096], [-10.000868, -7.493243, 14.70327], [-10.129283, -7.431949, 14.78235], [-10.252459, -7.367735, 14.861191], [-10.370793, -7.300538, 14.939653], [-10.484678, -7.230293, 15.017593], [-10.59451, -7.156936, 15.094867], [-10.700683, -7.080402, 15.171333], [-10.803591, -7.000628, 15.246849], [-10.903631, -6.917549, 15.321273], [-11.001196, -6.8311, 15.394461], [-11.09668, -6.741217, 15.466272], [-11.19048, -6.647836, 15.536562], [-11.282989, -6.550892, 15.605189], [-11.374602, -6.450321, 15.672011], [-11.465714, -6.346059, 15.736885], [-11.55672, -6.238042, 15.799669], [-11.648014, -6.126204, 15.86022], [-11.739914, -6.010507, 15.918427], [-11.832424, -5.891013, 15.974306], [-11.925474, -5.767809, 16.027905], [-12.018991, -5.640983, 16.07927], [-12.112902, -5.510622, 16.12845], [-12.207136, -5.376814, 16.175493], [-12.301622, -5.239645, 16.220444], [-12.396285, -5.099204, 16.263353], [-12.491056, -4.955578, 16.304267], [-12.585861, -4.808854, 16.343233], [-12.680629, -4.659119, 16.380298], [-12.775288, -4.506461, 16.41551], [-12.869765, -4.350967, 16.448917], [-12.963988, -4.192725, 16.480567], [-13.057886, -4.031823, 16.510505], [-13.151386, -3.868346, 16.538781], [-13.244417, -3.702384, 16.565442], [-13.336905, -3.534022, 16.590535], [-13.42878, -3.363349, 16.614108], [-13.519969, -3.190453, 16.636208], [-13.6104, -3.01542, 16.656882], [-13.700002, -2.838337, 16.676179], [-13.788701, -2.659293, 16.694145], [-13.876426, -2.478374, 16.710829], [-13.963105, -2.295669, 16.726277], [-14.048666, -2.111263, 16.740538], [-14.133036, -1.925246, 16.753659], [-14.216145, -1.737704, 16.765687], [-14.297919, -1.548724, 16.776669], [-14.378287, -1.358394, 16.786654], [-14.457176, -1.166802, 16.795689], [-14.534515, -0.974034, 16.803821], [-14.610231, -0.780178, 16.811098], [-14.684253, -0.585322, 16.817567], [-14.756508, -0.389553, 16.823276], [-14.826924, -0.192959, 16.828272], [-14.89543, 0.004374, 16.832604], [-14.961953, 0.202358, 16.836317], [-15.026421, 0.400906, 16.839461], [-15.088762, 0.599929, 16.842082], [-15.148905, 0.799342, 16.844228], [-15.206776, 0.999055, 16.845946], [-15.262304, 1.198983, 16.847284], [-15.315417, 1.399037, 16.84829], [-15.366044, 1.59913, 16.84901], [-15.41411, 1.799175, 16.849493], [-15.459546, 1.999085, 16.849786], [-15.502279, 2.198771, 16.849937], [-15.542236, 2.398147, 16.849992], [-15.579345, 2.597125, 16.85], [-15.61354, 2.795623, 16.85], [-15.644769, 2.993578, 16.85], [-15.672986, 3.190933, 16.85], [-15.698146, 3.38763, 16.85], [-15.720201, 3.583612, 16.85], [-15.739107, 3.778822, 16.85], [-15.754817, 3.973202, 16.85], [-15.767284, 4.166693, 16.85], [-15.776463, 4.35924, 16.85], [-15.782307, 4.550785, 16.85], [-15.784771, 4.741269, 16.85], [-15.783807, 4.930636, 16.85], [-15.779372, 5.118828, 16.85], [-15.771417, 5.305788, 16.85], [-15.759897, 5.491457, 16.85], [-15.744766, 5.675779, 16.85], [-15.725977, 5.858697, 16.85], [-15.703485, 6.040152, 16.85], [-15.677244, 6.220087, 16.85], [-15.647206, 6.398445, 16.85], [-15.613327, 6.575168, 16.85], [-15.57556, 6.750199, 16.85], [-15.533859, 6.92348, 16.85], [-15.488178, 7.094953, 16.85], [-15.438471, 7.264563, 16.85], [-15.384691, 7.432249, 16.85], [-15.326793, 7.597957, 16.85], [-15.26473, 7.761627, 16.85], [-15.198456, 7.923202, 16.85], [-15.127926, 8.082626, 16.85], [-15.053092, 8.23984, 16.85], [-14.973909, 8.394786, 16.85], [-14.890331, 8.547409, 16.85], [-14.802312, 8.697649, 16.85], [-14.709805, 8.84545, 16.85], [-14.612765, 8.990753, 16.85], [-14.511145, 9.133503, 16.85], [-14.404899, 9.27364, 16.85], [-14.293982, 9.411108, 16.85], [-14.178346, 9.545849, 16.85], [-14.057946, 9.677806, 16.85], [-13.932736, 9.806921, 16.85], [-13.802669, 9.933136, 16.85], [-13.6677, 10.056395, 16.85], [-13.527782, 10.176639, 16.85], [-13.38287, 10.293812, 16.85], [-13.232916, 10.407855, 16.85], [-13.077876, 10.518712, 16.85], [-12.917702, 10.626325, 16.85], [-12.75235, 10.730636, 16.85], [-12.581794, 10.831604, 16.85], [-12.406103, 10.929259, 16.85], [-12.225365, 11.023644, 16.85], [-12.039671, 11.114804, 16.85], [-11.84911, 11.202784, 16.85], [-11.653771, 11.287628, 16.85], [-11.453745, 11.369383, 16.85], [-11.24912, 11.448091, 16.85], [-11.039986, 11.523799, 16.85], [-10.826434, 11.596551, 16.85], [-10.608551, 11.666392, 16.85], [-10.386429, 11.733366, 16.85], [-10.160156, 11.797518, 16.85], [-9.929823, 11.858894, 16.85], [-9.695518, 11.917537, 16.85], [-9.457332, 11.973493, 16.85], [-9.215353, 12.026807, 16.85], [-8.969672, 12.077523, 16.85], [-8.720378, 12.125685, 16.85], [-8.46756, 12.17134, 16.85], [-8.211309, 12.214531, 16.85], [-7.951713, 12.255304, 16.85], [-7.688863, 12.293703, 16.85], [-7.422848, 12.329773, 16.85], [-7.153757, 12.363558, 16.85], [-6.88168, 12.395105, 16.85], [-6.606707, 12.424456, 16.85], [-6.328928, 12.451658, 16.85], [-6.048431, 12.476754, 16.85], [-5.765306, 12.499791, 16.85], [-5.479644, 12.520812, 16.85], [-5.191532, 12.539862, 16.85], [-4.901063, 12.556986, 16.85], [-4.608323, 12.572229, 16.85], [-4.313404, 12.585636, 16.85], [-4.016395, 12.597251, 16.85], [-3.717386, 12.60712, 16.85], [-3.416465, 12.615286, 16.85], [-3.113723, 12.621795, 16.85], [-2.809249, 12.626692, 16.85], [-2.503133, 12.630022, 16.85], [-2.195464, 12.631828, 16.85], [-1.886333, 12.632156, 16.85], [-1.575827, 12.631052, 16.85], [-1.264038, 12.628558, 16.85], [-0.951054, 12.624722, 16.85], [-0.636966, 12.619586, 16.85], [-0.321862, 12.613196, 16.85], [-0.005832, 12.605597, 16.85], [0.311033, 12.596833, 16.85], [0.628635, 12.586921, 16.85], [0.946834, 12.575762, 16.85], [1.265481, 12.56323, 16.85], [1.584427, 12.549198, 16.85], [1.903521, 12.533538, 16.85], [2.222616, 12.516124, 16.85], [2.541562, 12.496829, 16.85], [2.860209, 12.475525, 16.85], [3.178408, 12.452087, 16.85], [3.49601, 12.426387, 16.85], [3.812865, 12.398298, 16.85], [4.128825, 12.367694, 16.85], [4.44374, 12.334447, 16.85], [4.75746, 12.298431, 16.85], [5.069837, 12.259518, 16.85], [5.38072, 12.217582, 16.85], [5.689962, 12.172496, 16.85], [5.997411, 12.124133, 16.85], [6.30292, 12.072366, 16.85], [6.606339, 12.017068, 16.85], [6.907519, 11.958112, 16.85], [7.206309, 11.895372, 16.85], [7.502562, 11.82872, 16.85], [7.796127, 11.75803, 16.85], [8.086856, 11.683174, 16.85], [8.374599, 11.604026, 16.85], [8.659206, 11.520459, 16.85], [8.940529, 11.432346, 16.85], [9.218418, 11.33956, 16.85], [9.492725, 11.241974, 16.85], [9.763298, 11.139461, 16.85], [10.02999, 11.031895, 16.85], [10.292651, 10.919148, 16.85], [10.551132, 10.801093, 16.85], [10.805283, 10.677604, 16.85], [11.054956, 10.548554, 16.85], [11.3, 10.413816, 16.85], [11.540267, 10.273263, 16.85], [11.775607, 10.126768, 16.85], [12.005871, 9.974204, 16.85], [12.230909, 9.815444, 16.85], [12.450573, 9.650361, 16.85], [12.664713, 9.478829, 16.85], [12.87318, 9.30072, 16.85], [13.075824, 9.115908, 16.85], [13.272496, 8.924266, 16.85], [13.463047, 8.725666, 16.85], [13.647328, 8.519983, 16.85], [13.825189, 8.307088, 16.85], [13.996481, 8.086856, 16.85], [14.161091, 7.859226, 16.850001], [14.31905, 7.624407, 16.850009], [14.470424, 7.382676, 16.850029], [14.615282, 7.134309, 16.850068], [14.753691, 6.879582, 16.850133], [14.885717, 6.61877, 16.85023], [15.011428, 6.352152, 16.850366], [15.13089, 6.080002, 16.850546], [15.244172, 5.802596, 16.850778], [15.351341, 5.520212, 16.851067], [15.452462, 5.233125, 16.85142], [15.547605, 4.941611, 16.851843], [15.636835, 4.645947, 16.852343], [15.720221, 4.346409, 16.852927], [15.797828, 4.043272, 16.8536], [15.869725, 3.736814, 16.854369], [15.935979, 3.42731, 16.855241], [15.996657, 3.115037, 16.856221], [16.051825, 2.80027, 16.857316], [16.101552, 2.483287, 16.858533], [16.145904, 2.164362, 16.859878], [16.184949, 1.843773, 16.861358], [16.218753, 1.521796, 16.862978], [16.247384, 1.198706, 16.864746], [16.270909, 0.87478, 16.866667], [16.289396, 0.550294, 16.868748], [16.302911, 0.225525, 16.870995], [16.311522, -0.099252, 16.873415], [16.315295, -0.42376, 16.876015], [16.314298, -0.747723, 16.8788], [16.308599, -1.070865, 16.881777], [16.298264, -1.39291, 16.884953], [16.283361, -1.713581, 16.888333], [16.263956, -2.032603, 16.891924], [16.240117, -2.349698, 16.895733], [16.211911, -2.664592, 16.899766], [16.179406, -2.977007, 16.90403], [16.142668, -3.286667, 16.90853], [16.101765, -3.593297, 16.913274], [16.056763, -3.89662, 16.918267], [16.007731, -4.19636, 16.923516], [15.954734, -4.492241, 16.929027], [15.897842, -4.783986, 16.934807], [15.837119, -5.07132, 16.940863], [15.772635, -5.353965, 16.9472], [15.704455, -5.631647, 16.953825], [15.632647, -5.904088, 16.960745], [15.557279, -6.171012, 16.967965], [15.478417, -6.432145, 16.975492], [15.396129, -6.687208, 16.983333], [15.310482, -6.935973, 16.991491], [15.221546, -7.178398, 16.999958], [15.12939, -7.41449, 17.00872], [15.034083, -7.644254, 17.017768], [14.935695, -7.867695, 17.027088], [14.834296, -8.084819, 17.036669], [14.729956, -8.295631, 17.0465], [14.622744, -8.500138, 17.056568], [14.512729, -8.698345, 17.066862], [14.399981, -8.890257, 17.07737], [14.28457, -9.075881, 17.08808], [14.166566, -9.255221, 17.098981], [14.046037, -9.428283, 17.11006], [13.923054, -9.595074, 17.121306], [13.797686, -9.755598, 17.132707], [13.670003, -9.909861, 17.144252], [13.540074, -10.05787, 17.155927], [13.407969, -10.199628, 17.167723], [13.273758, -10.335143, 17.179627], [13.137509, -10.46442, 17.191627], [12.999293, -10.587463, 17.203711], [12.85918, -10.70428, 17.215868], [12.717238, -10.814875, 17.228085], [12.573538, -10.919255, 17.240352], [12.428149, -11.017424, 17.252656], [12.281141, -11.109389, 17.264986], [12.132582, -11.195154, 17.277329], [11.982544, -11.274727, 17.289674], [11.831095, -11.348111, 17.30201], [11.678305, -11.415314, 17.314323], [11.524243, -11.47634, 17.326604], [11.36898, -11.531195, 17.338839], [11.212584, -11.579885, 17.351017], [11.055126, -11.622416, 17.363126], [10.896675, -11.658792, 17.375155], [10.737301, -11.68902, 17.387092], [10.577072, -11.713105, 17.398925], [10.416059, -11.731053, 17.410641], [10.254332, -11.74287, 17.42223], [10.091959, -11.74856, 17.43368], [9.929011, -11.748131, 17.444978], [9.765557, -11.741587, 17.456114], [9.601667, -11.728933, 17.467075], [9.43741, -11.710176, 17.477849], [9.272856, -11.685322, 17.488425], [9.108075, -11.654375, 17.49879], [8.943135, -11.617342, 17.508934], [8.778107, -11.574227, 17.518844], [8.61306, -11.525038, 17.528509], [8.448065, -11.469779, 17.537917], [8.283144, -11.408502, 17.547058], [8.118139, -11.341451, 17.555933], [7.952847, -11.268915, 17.564546], [7.787063, -11.191182, 17.5729], [7.620583, -11.108541, 17.580999], [7.453203, -11.021282, 17.588845], [7.284719, -10.929695, 17.596442], [7.114927, -10.834068, 17.603794], [6.943624, -10.73469, 17.610903], [6.770604, -10.631851, 17.617773], [6.595664, -10.52584, 17.624408], [6.418599, -10.416946, 17.630811], [6.239207, -10.305458, 17.636984], [6.057282, -10.191666, 17.642932], [5.872621, -10.075858, 17.648658], [5.685019, -9.958324, 17.654165], [5.494273, -9.839354, 17.659456], [5.300178, -9.719235, 17.664535], [5.10253, -9.598258, 17.669405], [4.901126, -9.476712, 17.67407], [4.695761, -9.354886, 17.678532], [4.486231, -9.233068, 17.682796], [4.272332, -9.111549, 17.686864], [4.053861, -8.990618, 17.69074], [3.830612, -8.870563, 17.694427], [3.602383, -8.751673, 17.697929], [3.368968, -8.634239, 17.701248], [3.130164, -8.518549, 17.704389], [2.885767, -8.404893, 17.707354], [2.635572, -8.293559, 17.710147], [2.379376, -8.184837, 17.712771], [2.116975, -8.079016, 17.71523], [1.848164, -7.976385, 17.717526], [1.57274, -7.877234, 17.719664], [1.290498, -7.781851, 17.721646], [1.001235, -7.690527, 17.723477], [0.704746, -7.603549, 17.725158], [0.400827, -7.521207, 17.726694], [0.089274, -7.443791, 17.728088], [-0.230117, -7.371589, 17.729343], [-0.557549, -7.304892, 17.730463], [-0.893228, -7.243987, 17.731451], [-1.237357, -7.189164, 17.73231], [-1.590139, -7.140713, 17.733044], [-1.95178, -7.098922, 17.733655], [-2.322484, -7.064081, 17.734148], [-2.702453, -7.03648, 17.734526], [-3.091893, -7.016406, 17.734792], [-3.491007, -7.00415, 17.734948], [-3.9, -7.0, 17.735]];
cable_1 = [[10.3, 2.2, 12.89088], [10.299268, 2.474911, 12.892163], [10.297003, 2.746971, 12.895958], [10.293102, 3.016155, 12.902189], [10.287463, 3.282437, 12.910778], [10.279982, 3.545791, 12.921647], [10.270558, 3.806191, 12.934719], [10.259086, 4.063613, 12.949915], [10.245464, 4.318028, 12.967157], [10.22959, 4.569413, 12.986369], [10.21136, 4.817741, 13.007472], [10.190672, 5.062987, 13.030389], [10.167422, 5.305124, 13.055042], [10.141509, 5.544127, 13.081353], [10.112829, 5.779969, 13.109245], [10.081279, 6.012627, 13.138639], [10.046756, 6.242072, 13.169458], [10.009159, 6.468281, 13.201625], [9.968383, 6.691226, 13.235061], [9.924326, 6.910882, 13.269689], [9.876885, 7.127224, 13.305431], [9.825958, 7.340225, 13.342209], [9.771441, 7.54986, 13.379947], [9.713231, 7.756102, 13.418565], [9.651227, 7.958927, 13.457986], [9.585325, 8.158308, 13.498132], [9.515421, 8.35422, 13.538927], [9.441414, 8.546637, 13.580291], [9.363201, 8.735532, 13.622148], [9.280678, 8.920881, 13.664419], [9.193743, 9.102657, 13.707027], [9.102293, 9.280835, 13.749895], [9.006226, 9.455388, 13.792943], [8.905437, 9.626292, 13.836095], [8.799825, 9.793519, 13.879273], [8.689287, 9.957046, 13.9224], [8.57372, 10.116845, 13.965396], [8.45302, 10.27289, 14.008186], [8.327086, 10.425157, 14.05069], [8.195814, 10.573619, 14.092832], [8.059102, 10.718251, 14.134533], [7.916847, 10.859026, 14.175716], [7.768945, 10.995919, 14.216303], [7.615294, 11.128904, 14.256217], [7.455792, 11.257956, 14.295379], [7.290334, 11.383048, 14.333712], [7.11882, 11.504155, 14.371138], [6.941145, 11.621251, 14.40758], [6.757207, 11.73431, 14.442959], [6.566903, 11.843306, 14.477198], [6.37013, 11.948214, 14.51022], [6.166839, 12.049011, 14.541963], [5.957195, 12.145689, 14.572437], [5.741418, 12.238242, 14.601667], [5.519725, 12.326666, 14.62968], [5.292336, 12.410955, 14.6565], [5.05947, 12.491104, 14.682155], [4.821346, 12.567107, 14.70667], [4.578182, 12.638961, 14.73007], [4.330197, 12.706659, 14.752383], [4.077611, 12.770196, 14.773633], [3.820642, 12.829568, 14.793846], [3.559508, 12.884768, 14.81305], [3.29443, 12.935793, 14.831268], [3.025625, 12.982636, 14.848528], [2.753313, 13.025293, 14.864855], [2.477712, 13.063759, 14.880276], [2.199042, 13.098027, 14.894815], [1.917521, 13.128094, 14.9085], [1.633368, 13.153954, 14.921355], [1.346801, 13.175602, 14.933408], [1.058041, 13.193032, 14.944682], [0.767305, 13.20624, 14.955206], [0.474813, 13.21522, 14.965004], [0.180783, 13.219968, 14.974103], [-0.114565, 13.220477, 14.982528], [-0.411013, 13.216744, 14.990305], [-0.708342, 13.208762, 14.99746], [-1.006334, 13.196527, 15.004019], [-1.304768, 13.180033, 15.010009], [-1.603427, 13.159276, 15.015454], [-1.902091, 13.134249, 15.020381], [-2.200542, 13.104949, 15.024816], [-2.49856, 13.071369, 15.028784], [-2.795928, 13.033505, 15.032312], [-3.092425, 12.991352, 15.035426], [-3.387834, 12.944904, 15.038151], [-3.681934, 12.894156, 15.040513], [-3.974508, 12.839103, 15.042538], [-4.265337, 12.77974, 15.044252], [-4.554201, 12.716062, 15.045682], [-4.840882, 12.648063, 15.046852], [-5.125161, 12.575739, 15.047789], [-5.406818, 12.499084, 15.048519], [-5.685636, 12.418093, 15.049067], [-5.961395, 12.332761, 15.04946], [-6.233877, 12.243083, 15.049724], [-6.502862, 12.149053, 15.049883], [-6.768131, 12.050667, 15.049965], [-7.029467, 11.947919, 15.049996], [-7.286649, 11.840805, 15.05], [-7.539501, 11.729329, 15.05], [-7.788009, 11.613539, 15.05], [-8.032204, 11.493494, 15.05], [-8.272115, 11.369251, 15.05], [-8.50777, 11.24087, 15.05], [-8.739199, 11.108409, 15.05], [-8.96643, 10.971925, 15.05], [-9.189494, 10.831477, 15.05], [-9.408419, 10.687124, 15.05], [-9.623234, 10.538923, 15.05], [-9.833969, 10.386933, 15.05], [-10.040652, 10.231213, 15.05], [-10.243314, 10.07182, 15.05], [-10.441982, 9.908813, 15.05], [-10.636686, 9.74225, 15.05], [-10.827455, 9.572189, 15.05], [-11.014319, 9.398689, 15.05], [-11.197306, 9.221808, 15.05], [-11.376446, 9.041604, 15.05], [-11.551767, 8.858136, 15.05], [-11.7233, 8.671462, 15.05], [-11.891073, 8.48164, 15.05], [-12.055115, 8.288728, 15.05], [-12.215455, 8.092785, 15.05], [-12.372123, 7.89387, 15.05], [-12.525147, 7.692039, 15.05], [-12.674557, 7.487352, 15.05], [-12.820383, 7.279867, 15.05], [-12.962652, 7.069643, 15.05], [-13.101395, 6.856737, 15.05], [-13.23664, 6.641207, 15.05], [-13.368416, 6.423113, 15.05], [-13.496754, 6.202512, 15.05], [-13.621681, 5.979463, 15.05], [-13.743227, 5.754024, 15.05], [-13.861421, 5.526253, 15.05], [-13.976293, 5.296208, 15.05], [-14.087871, 5.063949, 15.05], [-14.196185, 4.829533, 15.05], [-14.301263, 4.593018, 15.05], [-14.403135, 4.354463, 15.05], [-14.50183, 4.113925, 15.05], [-14.597378, 3.871465, 15.05], [-14.689807, 3.627138, 15.05], [-14.779146, 3.381005, 15.05], [-14.865424, 3.133123, 15.05], [-14.948672, 2.88355, 15.05], [-15.028917, 2.632346, 15.05], [-15.10619, 2.379567, 15.05], [-15.180519, 2.125273, 15.05], [-15.251916, 1.869534, 15.050002], [-15.320325, 1.612477, 15.050016], [-15.385674, 1.354239, 15.050054], [-15.44789, 1.09496, 15.050128], [-15.5069, 0.834777, 15.05025], [-15.56263, 0.573828, 15.050432], [-15.615009, 0.312254, 15.050686], [-15.663963, 0.05019, 15.051024], [-15.70942, -0.212222, 15.051458], [-15.751306, -0.474847, 15.052], [-15.789549, -0.737544, 15.052662], [-15.824075, -1.000175, 15.053456], [-15.854813, -1.262603, 15.054394], [-15.881689, -1.524688, 15.055488], [-15.904629, -1.786292, 15.05675], [-15.923563, -2.047276, 15.058192], [-15.938415, -2.307503, 15.059826], [-15.949114, -2.566834, 15.061664], [-15.955587, -2.82513, 15.063718], [-15.957761, -3.082253, 15.066], [-15.955563, -3.338064, 15.068522], [-15.94892, -3.592425, 15.071296], [-15.937759, -3.845197, 15.074334], [-15.922008, -4.096243, 15.077648], [-15.901593, -4.345423, 15.08125], [-15.876442, -4.5926, 15.085152], [-15.846482, -4.837634, 15.089366], [-15.81164, -5.080388, 15.093904], [-15.771842, -5.320722, 15.098778], [-15.727017, -5.558499, 15.104], [-15.677092, -5.793579, 15.109582], [-15.621992, -6.025826, 15.115536], [-15.561647, -6.255099, 15.121874], [-15.495982, -6.48126, 15.128608], [-15.424925, -6.704172, 15.13575], [-15.348403, -6.923696, 15.143312], [-15.266343, -7.139693, 15.151306], [-15.178673, -7.352025, 15.159744], [-15.085319, -7.560553, 15.168638], [-14.986208, -7.765139, 15.178], [-14.881268, -7.965644, 15.187842], [-14.770426, -8.161931, 15.198176], [-14.653609, -8.35386, 15.209014], [-14.530744, -8.541293, 15.220368], [-14.401758, -8.724092, 15.23225], [-14.266579, -8.902118, 15.244672], [-14.125133, -9.075233, 15.257646], [-13.977347, -9.243299, 15.271184], [-13.82315, -9.406176, 15.285298], [-13.662467, -9.563727, 15.3], [-13.495262, -9.715848, 15.315294], [-13.321646, -9.862576, 15.331152], [-13.141763, -10.003986, 15.347538], [-12.955759, -10.140149, 15.364416], [-12.76378, -10.271139, 15.38175], [-12.565972, -10.397028, 15.399504], [-12.36248, -10.517889, 15.417642], [-12.15345, -10.633795, 15.436128], [-11.939029, -10.74482, 15.454926], [-11.71936, -10.851035, 15.474], [-11.494592, -10.952513, 15.493314], [-11.264868, -11.049329, 15.512832], [-11.030335, -11.141553, 15.532518], [-10.791138, -11.22926, 15.552336], [-10.547424, -11.312522, 15.57225], [-10.299338, -11.391413, 15.592224], [-10.047026, -11.466004, 15.612222], [-9.790633, -11.536368, 15.632208], [-9.530305, -11.60258, 15.652146], [-9.266189, -11.664711, 15.672], [-8.998429, -11.722834, 15.691734], [-8.727171, -11.777022, 15.711312], [-8.452561, -11.827349, 15.730698], [-8.174746, -11.873886, 15.749856], [-7.89387, -11.916707, 15.76875], [-7.610079, -11.955885, 15.787344], [-7.323519, -11.991492, 15.805602], [-7.034337, -12.023602, 15.823488], [-6.742676, -12.052287, 15.840966], [-6.448684, -12.077621, 15.858], [-6.152506, -12.099675, 15.874554], [-5.854288, -12.118523, 15.890592], [-5.554175, -12.134238, 15.906078], [-5.252314, -12.146892, 15.920976], [-4.948849, -12.156559, 15.93525], [-4.643927, -12.163312, 15.948864], [-4.337694, -12.167222, 15.961782], [-4.030294, -12.168364, 15.973968], [-3.721875, -12.166809, 15.985386], [-3.412581, -12.162632, 15.996], [-3.102558, -12.155904, 16.005774], [-2.791952, -12.146698, 16.014672], [-2.48091, -12.135088, 16.022658], [-2.169575, -12.121146, 16.029696], [-1.858095, -12.104946, 16.03575], [-1.546616, -12.086559, 16.040784], [-1.235281, -12.066059, 16.044762], [-0.924239, -12.043519, 16.047648], [-0.613633, -12.019012, 16.049406], [-0.30361, -11.99261, 16.05], [0.005686, -11.96437, 16.049406], [0.314123, -11.934287, 16.047648], [0.621568, -11.902339, 16.044762], [0.927892, -11.868504, 16.040784], [1.232962, -11.832759, 16.03575], [1.536647, -11.795083, 16.029696], [1.838817, -11.755455, 16.022658], [2.139341, -11.713852, 16.014672], [2.438086, -11.670252, 16.005774], [2.734922, -11.624634, 15.996], [3.029718, -11.576976, 15.985386], [3.322343, -11.527255, 15.973968], [3.612665, -11.475451, 15.961782], [3.900553, -11.42154, 15.948864], [4.185876, -11.365502, 15.93525], [4.468503, -11.307315, 15.920976], [4.748303, -11.246956, 15.906078], [5.025145, -11.184404, 15.890592], [5.298897, -11.119636, 15.874554], [5.569429, -11.052632, 15.858], [5.836608, -10.983369, 15.840966], [6.100305, -10.911825, 15.823488], [6.360387, -10.837978, 15.805602], [6.616724, -10.761807, 15.787344], [6.869185, -10.68329, 15.76875], [7.117638, -10.602405, 15.749856], [7.361952, -10.519129, 15.730698], [7.601996, -10.433442, 15.711312], [7.837639, -10.345321, 15.691734], [8.068749, -10.254744, 15.672], [8.295196, -10.16169, 15.652146], [8.516849, -10.066136, 15.632208], [8.733576, -9.968062, 15.612222], [8.945246, -9.867444, 15.592224], [9.151727, -9.764261, 15.57225], [9.35289, -9.658492, 15.552336], [9.548602, -9.550114, 15.532518], [9.738733, -9.439106, 15.512832], [9.92315, -9.325445, 15.493314], [10.101724, -9.20911, 15.474], [10.274323, -9.090079, 15.454926], [10.440816, -8.96833, 15.436128], [10.601071, -8.843841, 15.417642], [10.754958, -8.716591, 15.399504], [10.902345, -8.586557, 15.38175], [11.043101, -8.453717, 15.364416], [11.177095, -8.318051, 15.347538], [11.304196, -8.179535, 15.331152], [11.424273, -8.038149, 15.315294], [11.537194, -7.89387, 15.3], [11.642858, -7.746707, 15.285303], [11.741279, -7.596798, 15.271227], [11.8325, -7.444309, 15.257791], [11.916566, -7.289408, 15.245016], [11.993521, -7.132263, 15.232921], [12.063407, -6.973041, 15.221528], [12.126269, -6.81191, 15.210856], [12.18215, -6.649038, 15.200925], [12.231094, -6.484592, 15.191757], [12.273146, -6.318739, 15.18337], [12.308348, -6.151648, 15.175785], [12.336744, -5.983485, 15.169023], [12.358378, -5.814419, 15.163104], [12.373293, -5.644617, 15.158047], [12.381535, -5.474247, 15.153874], [12.383145, -5.303476, 15.150604], [12.378168, -5.132471, 15.148257], [12.366648, -4.961402, 15.146854], [12.348628, -4.790434, 15.146415], [12.324152, -4.619735, 15.14696], [12.293264, -4.449474, 15.14851], [12.256008, -4.279818, 15.151084], [12.212426, -4.110934, 15.154703], [12.162564, -3.94299, 15.159387], [12.106464, -3.776154, 15.165156], [12.04417, -3.610593, 15.172031], [11.975727, -3.446474, 15.180032], [11.901177, -3.283966, 15.189178], [11.820565, -3.123236, 15.199491], [11.733934, -2.964452, 15.21099], [11.641328, -2.80778, 15.223696], [11.54279, -2.653389, 15.237628], [11.438365, -2.501447, 15.252808], [11.328096, -2.352121, 15.269254], [11.212027, -2.205578, 15.286989], [11.090202, -2.061986, 15.306031], [10.962664, -1.921512, 15.326401], [10.829457, -1.784325, 15.348119], [10.690624, -1.650592, 15.371205], [10.54621, -1.520481, 15.39568], [10.396258, -1.394158, 15.421564], [10.240812, -1.271792, 15.448877], [10.079915, -1.153551, 15.477639], [9.913612, -1.039601, 15.50787], [9.741946, -0.93011, 15.539591], [9.564961, -0.825247, 15.572822], [9.3827, -0.725178, 15.607584], [9.195207, -0.630072, 15.643895], [9.002526, -0.540095, 15.681777], [8.804701, -0.455416, 15.72125], [8.601828, -0.376105, 15.762314], [8.39422, -0.301853, 15.804893], [8.182239, -0.23225, 15.84889], [7.96625, -0.16689, 15.894207], [7.746619, -0.105366, 15.940749], [7.523708, -0.047269, 15.988418], [7.297883, 0.007807, 16.037119], [7.069507, 0.06027, 16.086754], [6.838945, 0.110527, 16.137226], [6.606562, 0.158986, 16.18844], [6.372721, 0.206055, 16.240298], [6.137787, 0.25214, 16.292704], [5.902125, 0.297649, 16.345561], [5.666098, 0.34299, 16.398772], [5.430072, 0.388569, 16.452241], [5.194409, 0.434795, 16.505871], [4.959475, 0.482074, 16.559566], [4.725635, 0.530815, 16.613228], [4.493251, 0.581424, 16.666762], [4.26269, 0.634309, 16.72007], [4.034314, 0.689878, 16.773056], [3.808489, 0.748537, 16.825623], [3.585578, 0.810695, 16.877674], [3.365946, 0.876758, 16.929113], [3.149958, 0.947135, 16.979844], [2.937977, 1.022232, 17.029769], [2.730368, 1.102456, 17.078791], [2.527496, 1.188217, 17.126815], [2.329724, 1.27992, 17.173744], [2.137417, 1.377973, 17.21948], [1.95094, 1.482784, 17.263927], [1.770656, 1.594759, 17.30699], [1.59693, 1.714307, 17.348569], [1.430126, 1.841836, 17.388571], [1.270609, 1.977751, 17.426896], [1.118744, 2.122461, 17.46345], [0.974893, 2.276373, 17.498135], [0.839422, 2.439895, 17.530854], [0.712695, 2.613433, 17.561511], [0.595076, 2.797396, 17.59001], [0.48693, 2.992191, 17.616253], [0.388621, 3.198225, 17.640144], [0.300514, 3.415906, 17.661587], [0.222971, 3.645641, 17.680484], [0.156359, 3.887837, 17.696739], [0.101042, 4.142902, 17.710255], [0.057382, 4.411244, 17.720936], [0.025746, 4.693269, 17.728685], [0.006497, 4.989385, 17.733405], [0.0, 5.3, 17.735]];
cable_paths = [cable_0,cable_1];
cable_clips = [[[-15.579859181201652, 2.6, 16.849999999999998], [-0.1759308029166919, 0.9844025358485665, 0.0], [-17.02985918120165, 1.9, 15.699999999999998], [-14.129859181201653, 3.3, 18.5], 1.8, 1.0], [[16.08390217946675, 2.6, 16.858071725095495], [0.15235268396134732, -0.9883186977400641, 0.003848556503159672], [14.633902179466752, 1.9, 15.708071725095495], [17.53390217946675, 3.3, 18.5], 1.8, 1.0], [[-15.038993942870865, 2.6, 15.05], [-0.29649622436932277, -0.9550340250141542, 0.0], [-16.488993942870867, 1.9, 13.9], [-13.588993942870866, 3.3, 18.5], 1.8, 1.0], [[0.7219456750509492, 2.6, 17.559271894358353], [-0.5618899294576891, 0.8159508739737836, 0.13602896175245832], [-1.6780543249490507, 1.9, 16.409271894358355], [3.121945675050949, 3.3, 18.5], 2.0, 1.0]];
