gokselozgur5/pcb-design-collar-tracker/mechanical/swim-r11-thermal-fit/retention.scad

// Generated r11 thermal-fit prototype; physical qualification remains open.
retainer_outer = [41.8, 34.3];
retainer_inner = [40.8, 33.3];
retainer_outer_r = 1.9;
retainer_inner_r = 1.4;
retainer_z = 11.5;
retainer_h = 1.2;
retainer_tabs = [[-20.9, -9.5, -19.05, -6.5], [19.05, -9.5, 20.9, -6.5], [-12, 14.95, -10.4, 17.15], [18.2, 14.95, 20.9, 17.15]];
retainer_posts = [[-20.85, -9.5, -20.35, -6.5], [20.35, -9.5, 20.85, -6.5], [-12, 16.35, -10.4, 16.85], [18.2, 16.35, 19.5, 16.85]];
retainer_post_z = 13.0;
locator_ribs = [[-21.2, -1, -21, 1], [21, -1, 21.2, 1], [-1, -17.3, 1, -17], [-1, 17, 1, 17.3]];
guide_rails = [[-20.8, -15.5, -20.2, 15.5], [20.2, -15.5, 20.8, 15.5], [-19.5, -16.8, 19.5, -16.2], [-19.5, 16.2, 19.5, 16.8]];
guide_top_z = 11.5;
sim_bridge_cut = [3.8, 14.8, 17.95, 18.8];
guide_reliefs = [[11.2, -17.0, 14.8, -13.6], [-21.0, 10.4, -18.8, 15.6]];
radial_keys = [[-20.9, -1.2, -20.22, 1.2], [20.22, -0.8, 20.9, 0.8], [-0.8, -17.15, 0.8, -16.3], [-0.8, 16.3, 0.8, 17.15]];
radial_slots = [[-21.2, -1.325, -19.95, 1.325], [19.95, -0.925, 21.2, 0.925], [-0.925, -17.5, 0.925, -16.0], [-0.925, 16.0, 0.925, 17.5]];
key_z = 10.6;
key_slot_z = 10.3;
motion_boxes = [["C1", [-17.535, 1.99, 11.02], [3.0700000000000003, 2.62, 1.6700000000000017]], ["C10", [16.53, 12.120000000000001, 9.469999999999999], [3.7399999999999984, 3.0599999999999987, 1.7921087000000018]], ["C13", [-0.5700000000000001, -5.180000000000001, 11.02], [3.74, 3.0600000000000005, 1.8300000000000018]], ["C14", [4.63, -0.6300000000000001, 11.02], [3.7399999999999993, 3.0600000000000005, 1.8300000000000018]], ["C15", [6.13, -5.33, 11.02], [3.7399999999999993, 3.0600000000000005, 1.8300000000000018]], ["C16", [8.870000000000001, -7.37, 11.02], [3.0599999999999987, 3.74, 1.8300000000000018]], ["C17", [-13.33, -8.12, 9.469999999999999], [3.0599999999999987, 3.7399999999999993, 1.7921087000000018]], ["C18", [-17.335, -8.53, 11.02], [4.67, 3.3599999999999994, 2.2300000000000004]], ["C19", [-18.07, -10.03, 11.02], [3.74, 3.0599999999999996, 1.8300000000000018]], ["C2", [-17.31, 3.3649999999999993, 11.02], [2.6199999999999974, 3.070000000000001, 1.6700000000000017]], ["C20", [-13.87, 10.67, 11.02], [3.7399999999999984, 3.0599999999999987, 1.8300000000000018]], ["C21", [-13.87, 8.97, 11.02], [3.7399999999999984, 3.0599999999999987, 1.8300000000000018]], ["C23", [12.13, 9.07, 11.02], [3.7399999999999984, 3.0599999999999987, 1.8300000000000018]], ["C24", [12.13, 6.97, 11.02], [3.7399999999999984, 3.0599999999999996, 1.8300000000000018]], ["C25", [-8.155, -14.309999999999999, 8.67], [3.8099999999999996, 5.119999999999997, 2.5921087000000007]], ["C26", [-6.62, -9.58, 9.469999999999999], [3.74, 3.0600000000000005, 1.7921087000000018]], ["C27", [-10.28, -15.62, 11.02], [3.0599999999999987, 3.7399999999999984, 1.8300000000000018]], ["C28", [1.4699999999999998, -14.37, 11.02], [3.0600000000000005, 3.7399999999999984, 1.8300000000000018]], ["C29", [11.13, -16.529999999999998, 11.02], [3.7399999999999984, 3.059999999999997, 1.8300000000000018]], ["C3", [-17.905, -6.86, 11.02], [3.8100000000000005, 5.120000000000001, 2.7300000000000004]], ["C30", [15.629999999999999, 3.9699999999999998, 11.02], [3.740000000000002, 3.0600000000000005, 1.8300000000000018]], ["C31", [-10.78, 10.63, 11.02], [3.0599999999999987, 3.7399999999999984, 1.8300000000000018]], ["C32", [-4.78, 12.13, 11.02], [3.0600000000000005, 3.7399999999999984, 1.8300000000000018]], ["C33", [-17.53, 12.13, 9.469999999999999], [3.0600000000000005, 3.7399999999999984, 1.7921087000000018]], ["C34", [-9.62, 12.97, 11.02], [3.7399999999999993, 3.059999999999997, 1.8300000000000018]], ["C35", [-2.87, 8.22, 11.02], [3.74, 3.0599999999999987, 1.8300000000000018]], ["C36", [-15.53, -8.87, 9.469999999999999], [3.0599999999999987, 3.7399999999999993, 1.7921087000000018]], ["C4", [-15.135, -4.68, 9.07], [4.67, 3.36, 2.1921087000000004]], ["C5", [-5.785, 6.89, 11.02], [3.0700000000000003, 2.62, 1.6100000000000012]], ["C6", [-3.87, 7.17, 11.02], [3.74, 3.0599999999999987, 1.8800000000000008]], ["C7", [-12.12, -8.53, 11.02], [3.7399999999999984, 3.0599999999999996, 1.8800000000000008]], ["C8", [-14.735, 0.6900000000000001, 9.69], [3.0699999999999985, 2.6200000000000006, 1.5721087000000011]], ["C9", [-18.105, -2.86, 8.67], [3.8100000000000005, 5.119999999999999, 2.5921087000000007]], ["D1", [12.74, 11.850000000000001, 8.92], [5.3199999999999985, 4.729999999999997, 2.3421087000000007]], ["D2", [6.14, -4.65, 8.92], [5.319999999999999, 4.73, 2.3421087000000007]], ["FB1", [-17.68, -2.335, 11.02], [3.3599999999999994, 4.67, 2.2300000000000004]], ["J1", [-3.8100000000000005, -12.41, 11.02], [8.22, 8.219999999999999, 3.780000000000001]], ["J2", [6.19, -1.91, 11.02], [8.219999999999999, 8.22, 3.780000000000001]], ["J3", [-18.61, -14.11, 11.02], [6.219999999999999, 3.8199999999999985, 2.780000000000001]], ["J4", [-16.36, -13.959999999999999, 8.52], [8.719999999999999, 3.8199999999999985, 2.742108700000001]], ["J5", [2.3149999999999995, -13.145, 9.92], [9.37, 4.289999999999999, 1.3421087000000007]], ["J6", [2.09, -1.56, 8.52], [13.82, 15.12, 2.742108700000001]], ["J7", [-16.78, 5.8549999999999995, 9.92], [5.5600000000000005, 4.29, 1.3421087000000007]], ["L1", [1.0700000000000003, -4.14, 11.02], [2.86, 3.78, 1.8800000000000008]], ["Q1", [13.55, -9.74, 11.02], [4.73, 4.8500000000000005, 2.380000000000001]], ["R1", [-17.75, 2.11, 9.62], [3.0999999999999996, 3.7800000000000007, 1.6421087000000014]], ["R12", [0.61, 12.55, 11.02], [3.78, 3.099999999999998, 1.6800000000000015]], ["R13", [6.51, 12.450000000000001, 11.02], [3.7799999999999994, 3.099999999999998, 1.6800000000000015]], ["R14", [1.6099999999999999, -6.550000000000001, 9.62], [3.7800000000000007, 3.1000000000000014, 1.6421087000000014]], ["R15", [6.109999999999999, -5.550000000000001, 9.62], [3.7799999999999994, 3.100000000000001, 1.6421087000000014]], ["R16", [-3.1, -15.889999999999999, 11.02], [3.1, 3.7799999999999976, 1.6800000000000015]], ["R17", [-5.800000000000001, -13.889999999999999, 9.67], [3.100000000000001, 3.7799999999999976, 1.5921087000000007]], ["R18", [-1.4900000000000002, -13.649999999999999, 11.02], [3.7800000000000002, 3.099999999999998, 1.6300000000000008]], ["R19", [-1.9700000000000002, -15.28, 11.02], [3.7800000000000002, 3.0999999999999996, 1.6800000000000015]], ["R2", [-15.19, 2.4499999999999997, 9.62], [3.7799999999999994, 3.100000000000001, 1.6421087000000014]], ["R20", [2.61, -15.299999999999999, 11.02], [3.7800000000000007, 3.099999999999998, 1.6800000000000015]], ["R21", [14.610000000000001, -11.799999999999999, 11.02], [3.7799999999999994, 3.099999999999998, 1.6800000000000015]], ["R22", [16.11, -13.049999999999999, 11.02], [3.780000000000001, 3.099999999999998, 1.6800000000000015]], ["R23", [16.2, 8.610000000000001, 11.02], [3.1000000000000014, 3.7799999999999976, 1.6800000000000015]], ["R24", [-11.389999999999999, 7.950000000000001, 11.02], [3.7799999999999976, 3.099999999999998, 1.6300000000000008]], ["R25", [-5.300000000000001, 9.610000000000001, 11.02], [3.100000000000001, 3.7799999999999976, 1.6300000000000008]], ["R26", [-0.14000000000000012, 9.700000000000001, 11.02], [3.7800000000000002, 3.099999999999998, 1.6300000000000008]], ["R27", [-6.640000000000001, 12.700000000000001, 11.02], [3.7800000000000007, 3.099999999999998, 1.6300000000000008]], ["R28", [-15.549999999999999, 9.610000000000001, 9.67], [3.099999999999998, 3.7799999999999976, 1.5921087000000007]], ["R29", [-15.889999999999999, 13.200000000000001, 9.67], [3.7799999999999976, 3.099999999999996, 1.5921087000000007]], ["R3", [-6.090000000000001, -7.8500000000000005, 11.02], [3.780000000000001, 3.1000000000000005, 1.6800000000000015]], ["R30", [-20.14, 10.450000000000001, 11.02], [3.780000000000001, 3.099999999999998, 1.6300000000000008]], ["R4", [6.409999999999999, -6.8500000000000005, 11.02], [3.7800000000000002, 3.1000000000000005, 1.6800000000000015]], ["R5", [6.409999999999999, -8.25, 11.02], [3.7800000000000002, 3.1000000000000005, 1.6800000000000015]], ["R6", [-13.889999999999999, -13.35, 11.02], [3.7799999999999976, 3.0999999999999996, 1.6800000000000015]], ["R7", [-11.69, -13.35, 11.02], [3.7799999999999994, 3.0999999999999996, 1.6800000000000015]], ["R8", [-9.889999999999999, 10.450000000000001, 9.62], [3.7799999999999994, 3.099999999999998, 1.6421087000000014]], ["R9", [-6.890000000000001, 10.450000000000001, 9.62], [3.780000000000001, 3.099999999999998, 1.6421087000000014]], ["U1", [-14.83, -5.83, 11.02], [15.16, 14.16, 2.580000000000002]], ["U10", [-9.26, 8.84, 11.02], [4.5200000000000005, 5.32, 2.380000000000001]], ["U11", [-3.2600000000000002, 10.34, 11.02], [4.5200000000000005, 5.32, 2.380000000000001]], ["U12", [-20.509999999999998, 10.315000000000001, 8.92], [4.519999999999996, 5.369999999999997, 2.3421087000000007]], ["U2", [2.4399999999999995, -5.0600000000000005, 11.02], [5.1199900000000005, 5.12, 1.9800000000000004]], ["U3", [-15.584999999999999, -11.33, 11.02], [5.169999999999998, 4.86, 2.080000000000002]], ["U4", [-17.91, 8.770000000000001, 11.02], [5.82, 5.739999999999998, 2.7300000000000004]], ["U5", [8.370000000000001, 7.23, 11.02], [4.899999999999999, 4.899999999999999, 1.9800000000000004]], ["U6", [-8.459999999999999, -15.729999999999999, 11.02], [5.92, 5.739999999999998, 2.7300000000000004]], ["U7", [-4.73, -12.209999999999999, 8.57], [5.74, 5.919999999999999, 2.6921087000000004]], ["U8", [12.315000000000001, -15.28, 11.02], [5.369999999999997, 4.729999999999999, 2.380000000000001]], ["U9", [14.59, -0.20000000000000018, 11.02], [4.544999999999998, 5.335000000000001, 2.080000000000002]]];
frame_motion_boxes = [["C1", [-17.425, 2.0999999999999996, 10.549999999999999], [2.8500000000000014, 2.4000000000000004, 1.6700000000000017]], ["C10", [16.64, 12.23, 8.759999999999998], [3.5199999999999996, 2.84, 2.032108700000002]], ["C13", [-0.46, -5.07, 10.549999999999999], [3.5200000000000005, 2.8400000000000007, 1.8300000000000018]], ["C14", [4.74, -0.52, 10.549999999999999], [3.5199999999999996, 2.8400000000000003, 1.8300000000000018]], ["C15", [6.24, -5.22, 10.549999999999999], [3.5199999999999996, 2.84, 1.8300000000000018]], ["C16", [8.98, -7.26, 10.549999999999999], [2.84, 3.5199999999999996, 1.8300000000000018]], ["C17", [-13.22, -8.01, 8.759999999999998], [2.84, 3.5199999999999996, 2.032108700000002]], ["C18", [-17.225, -8.42, 10.549999999999999], [4.450000000000001, 3.1399999999999997, 2.2300000000000004]], ["C19", [-17.96, -9.92, 10.549999999999999], [3.5200000000000014, 2.84, 1.8300000000000018]], ["C2", [-17.2, 3.4749999999999996, 10.549999999999999], [2.3999999999999986, 2.8500000000000005, 1.6700000000000017]], ["C20", [-13.76, 10.78, 10.549999999999999], [3.5199999999999996, 2.84, 1.8300000000000018]], ["C21", [-13.76, 9.08, 10.549999999999999], [3.5199999999999996, 2.84, 1.8300000000000018]], ["C23", [12.24, 9.18, 10.549999999999999], [3.5199999999999996, 2.84, 1.8300000000000018]], ["C24", [12.24, 7.08, 10.549999999999999], [3.5199999999999996, 2.84, 1.8300000000000018]], ["C25", [-8.045, -14.2, 7.959999999999999], [3.59, 4.899999999999999, 2.832108700000001]], ["C26", [-6.51, -9.47, 8.759999999999998], [3.5199999999999996, 2.8400000000000007, 2.032108700000002]], ["C27", [-10.17, -15.51, 10.549999999999999], [2.839999999999999, 3.5199999999999996, 1.8300000000000018]], ["C28", [1.5799999999999998, -14.26, 10.549999999999999], [2.84, 3.5199999999999996, 1.8300000000000018]], ["C29", [11.24, -16.419999999999998, 10.549999999999999], [3.5199999999999996, 2.839999999999998, 1.8300000000000018]], ["C3", [-17.795, -6.75, 10.549999999999999], [3.5900000000000016, 4.9, 2.7300000000000004]], ["C30", [15.739999999999998, 4.08, 10.549999999999999], [3.520000000000003, 2.84, 1.8300000000000018]], ["C31", [-10.67, 10.74, 10.549999999999999], [2.839999999999999, 3.5199999999999996, 1.8300000000000018]], ["C32", [-4.67, 12.24, 10.549999999999999], [2.84, 3.5199999999999996, 1.8300000000000018]], ["C33", [-17.42, 12.24, 8.759999999999998], [2.8400000000000016, 3.5199999999999996, 2.032108700000002]], ["C34", [-9.51, 13.08, 10.549999999999999], [3.5199999999999996, 2.84, 1.8300000000000018]], ["C35", [-2.76, 8.33, 10.549999999999999], [3.5199999999999996, 2.84, 1.8300000000000018]], ["C36", [-15.42, -8.76, 8.759999999999998], [2.84, 3.5199999999999996, 2.032108700000002]], ["C4", [-15.025, -4.57, 8.36], [4.450000000000001, 3.1400000000000006, 2.4321087000000006]], ["C5", [-5.675, 7.0, 10.549999999999999], [2.8499999999999996, 2.4000000000000004, 1.6100000000000012]], ["C6", [-3.76, 7.28, 10.549999999999999], [3.5199999999999996, 2.839999999999999, 1.8800000000000008]], ["C7", [-12.01, -8.42, 10.549999999999999], [3.5199999999999996, 2.84, 1.8800000000000008]], ["C8", [-14.625, 0.8, 8.979999999999999], [2.8499999999999996, 2.4000000000000004, 1.8121087000000013]], ["C9", [-17.995, -2.75, 7.959999999999999], [3.5900000000000016, 4.9, 2.832108700000001]], ["D1", [12.85, 11.96, 8.209999999999999], [5.1, 4.509999999999998, 2.582108700000001]], ["D2", [6.25, -4.54, 8.209999999999999], [5.1, 4.51, 2.582108700000001]], ["FB1", [-17.57, -2.225, 10.549999999999999], [3.1400000000000006, 4.45, 2.2300000000000004]], ["J1", [-3.7, -12.3, 10.549999999999999], [8.0, 8.0, 3.780000000000001]], ["J2", [6.300000000000001, -1.7999999999999998, 10.549999999999999], [8.0, 8.0, 3.780000000000001]], ["J3", [-18.5, -14.0, 10.549999999999999], [6.0, 3.5999999999999996, 2.780000000000001]], ["J4", [-16.25, -13.85, 7.809999999999999], [8.5, 3.5999999999999996, 2.9821087000000013]], ["J5", [2.425, -13.035, 9.209999999999999], [9.149999999999999, 4.07, 1.582108700000001]], ["J6", [2.1999999999999997, -1.4500000000000002, 7.809999999999999], [13.600000000000001, 14.899999999999999, 2.9821087000000013]], ["J7", [-16.669999999999998, 5.965, 9.209999999999999], [5.339999999999998, 4.07, 1.582108700000001]], ["L1", [1.1800000000000002, -4.03, 10.549999999999999], [2.64, 3.5600000000000005, 1.8800000000000008]], ["Q1", [13.66, -9.63, 10.549999999999999], [4.510000000000002, 4.630000000000001, 2.380000000000001]], ["R1", [-17.64, 2.2199999999999998, 8.909999999999998], [2.880000000000001, 3.5600000000000005, 1.8821087000000016]], ["R12", [0.7200000000000001, 12.66, 10.549999999999999], [3.56, 2.879999999999999, 1.6800000000000015]], ["R13", [6.62, 12.56, 10.549999999999999], [3.5599999999999996, 2.879999999999999, 1.6800000000000015]], ["R14", [1.72, -6.44, 8.909999999999998], [3.5600000000000005, 2.880000000000001, 1.8821087000000016]], ["R15", [6.22, -5.44, 8.909999999999998], [3.5599999999999996, 2.880000000000001, 1.8821087000000016]], ["R16", [-2.99, -15.78, 10.549999999999999], [2.88, 3.5599999999999987, 1.6800000000000015]], ["R17", [-5.69, -13.78, 8.959999999999999], [2.880000000000001, 3.5599999999999987, 1.832108700000001]], ["R18", [-1.38, -13.54, 10.549999999999999], [3.5599999999999996, 2.879999999999999, 1.6300000000000008]], ["R19", [-1.86, -15.17, 10.549999999999999], [3.56, 2.880000000000001, 1.6800000000000015]], ["R2", [-15.08, 2.5599999999999996, 8.909999999999998], [3.5600000000000005, 2.880000000000001, 1.8821087000000016]], ["R20", [2.72, -15.19, 10.549999999999999], [3.56, 2.879999999999999, 1.6800000000000015]], ["R21", [14.72, -11.69, 10.549999999999999], [3.5600000000000005, 2.879999999999999, 1.6800000000000015]], ["R22", [16.22, -12.94, 10.549999999999999], [3.5600000000000023, 2.879999999999999, 1.6800000000000015]], ["R23", [16.31, 8.72, 10.549999999999999], [2.8800000000000026, 3.5599999999999987, 1.6800000000000015]], ["R24", [-11.28, 8.06, 10.549999999999999], [3.559999999999998, 2.879999999999999, 1.6300000000000008]], ["R25", [-5.19, 9.72, 10.549999999999999], [2.880000000000001, 3.5599999999999987, 1.6300000000000008]], ["R26", [-0.030000000000000027, 9.81, 10.549999999999999], [3.5599999999999996, 2.879999999999999, 1.6300000000000008]], ["R27", [-6.53, 12.81, 10.549999999999999], [3.56, 2.879999999999999, 1.6300000000000008]], ["R28", [-15.44, 9.72, 8.959999999999999], [2.879999999999999, 3.5599999999999987, 1.832108700000001]], ["R29", [-15.78, 13.31, 8.959999999999999], [3.5599999999999987, 2.8799999999999972, 1.832108700000001]], ["R3", [-5.98, -7.74, 10.549999999999999], [3.5600000000000005, 2.88, 1.6800000000000015]], ["R30", [-20.03, 10.56, 10.549999999999999], [3.5600000000000023, 2.879999999999999, 1.6300000000000008]], ["R4", [6.52, -6.74, 10.549999999999999], [3.5600000000000005, 2.88, 1.6800000000000015]], ["R5", [6.52, -8.14, 10.549999999999999], [3.5600000000000005, 2.880000000000001, 1.6800000000000015]], ["R6", [-13.78, -13.24, 10.549999999999999], [3.5599999999999987, 2.880000000000001, 1.6800000000000015]], ["R7", [-11.58, -13.24, 10.549999999999999], [3.5600000000000005, 2.880000000000001, 1.6800000000000015]], ["R8", [-9.78, 10.56, 8.909999999999998], [3.5599999999999996, 2.879999999999999, 1.8821087000000016]], ["R9", [-6.78, 10.56, 8.909999999999998], [3.5600000000000005, 2.879999999999999, 1.8821087000000016]], ["U1", [-14.72, -5.72, 10.549999999999999], [14.940000000000001, 13.940000000000001, 2.580000000000002]], ["U10", [-9.15, 8.95, 10.549999999999999], [4.300000000000001, 5.100000000000001, 2.380000000000001]], ["U11", [-3.1500000000000004, 10.45, 10.549999999999999], [4.300000000000001, 5.100000000000001, 2.380000000000001]], ["U12", [-20.4, 10.425, 8.209999999999999], [4.299999999999997, 5.149999999999999, 2.582108700000001]], ["U2", [2.5499999999999994, -4.95, 10.549999999999999], [4.899990000000001, 4.9, 1.9800000000000004]], ["U3", [-15.475, -11.22, 10.549999999999999], [4.949999999999999, 4.640000000000001, 2.080000000000002]], ["U4", [-17.8, 8.88, 10.549999999999999], [5.600000000000001, 5.52, 2.7300000000000004]], ["U5", [8.48, 7.340000000000001, 10.549999999999999], [4.68, 4.679999999999999, 1.9800000000000004]], ["U6", [-8.35, -15.62, 10.549999999999999], [5.7, 5.52, 2.7300000000000004]], ["U7", [-4.62, -12.1, 7.8599999999999985], [5.5200000000000005, 5.699999999999999, 2.9321087000000015]], ["U8", [12.425, -15.17, 10.549999999999999], [5.149999999999999, 4.51, 2.380000000000001]], ["U9", [14.7, -0.09000000000000008, 10.549999999999999], [4.324999999999999, 5.115, 2.080000000000002]]];
carrier_motion_boxes = [["C1", [-17.175, 2.3499999999999996, 11.02], [2.3500000000000014, 1.9000000000000004, 1.6700000000000017]], ["C10", [16.89, 12.48, 9.469999999999999], [3.0199999999999996, 2.34, 1.7921087000000018]], ["C13", [-0.21000000000000002, -4.82, 11.02], [3.0200000000000005, 2.3400000000000007, 1.8300000000000018]], ["C14", [4.99, -0.2700000000000001, 11.02], [3.0199999999999996, 2.3400000000000003, 1.8300000000000018]], ["C15", [6.49, -4.97, 11.02], [3.0199999999999996, 2.34, 1.8300000000000018]], ["C16", [9.23, -7.01, 11.02], [2.34, 3.0199999999999996, 1.8300000000000018]], ["C17", [-12.97, -7.76, 9.469999999999999], [2.34, 3.0199999999999996, 1.7921087000000018]], ["C18", [-16.975, -8.17, 11.02], [3.950000000000001, 2.6399999999999997, 2.2300000000000004]], ["C19", [-17.71, -9.67, 11.02], [3.0200000000000014, 2.34, 1.8300000000000018]], ["C2", [-16.95, 3.7249999999999996, 11.02], [1.8999999999999986, 2.3500000000000005, 1.6700000000000017]], ["C20", [-13.51, 11.03, 11.02], [3.0199999999999996, 2.34, 1.8300000000000018]], ["C21", [-13.51, 9.33, 11.02], [3.0199999999999996, 2.34, 1.8300000000000018]], ["C23", [12.49, 9.43, 11.02], [3.0199999999999996, 2.34, 1.8300000000000018]], ["C24", [12.49, 7.33, 11.02], [3.0199999999999996, 2.34, 1.8300000000000018]], ["C25", [-7.795, -13.95, 8.67], [3.09, 4.399999999999999, 2.5921087000000007]], ["C26", [-6.26, -9.22, 9.469999999999999], [3.0199999999999996, 2.3400000000000007, 1.7921087000000018]], ["C27", [-9.92, -15.26, 11.02], [2.339999999999999, 3.0199999999999996, 1.8300000000000018]], ["C28", [1.8299999999999998, -14.01, 11.02], [2.34, 3.0199999999999996, 1.8300000000000018]], ["C29", [11.49, -16.169999999999998, 11.02], [3.0199999999999996, 2.339999999999998, 1.8300000000000018]], ["C3", [-17.545, -6.5, 11.02], [3.0900000000000016, 4.4, 2.7300000000000004]], ["C30", [15.989999999999998, 4.33, 11.02], [3.020000000000003, 2.34, 1.8300000000000018]], ["C31", [-10.42, 10.99, 11.02], [2.34, 3.0199999999999996, 1.8300000000000018]], ["C32", [-4.42, 12.49, 11.02], [2.34, 3.0199999999999996, 1.8300000000000018]], ["C33", [-17.17, 12.49, 9.469999999999999], [2.3400000000000016, 3.0199999999999996, 1.7921087000000018]], ["C34", [-9.26, 13.33, 11.02], [3.0199999999999996, 2.34, 1.8300000000000018]], ["C35", [-2.51, 8.58, 11.02], [3.0199999999999996, 2.34, 1.8300000000000018]], ["C36", [-15.17, -8.51, 9.469999999999999], [2.34, 3.0199999999999996, 1.7921087000000018]], ["C4", [-14.775, -4.32, 9.07], [3.950000000000001, 2.6400000000000006, 2.1921087000000004]], ["C5", [-5.425, 7.25, 11.02], [2.3499999999999996, 1.9000000000000004, 1.6100000000000012]], ["C6", [-3.51, 7.53, 11.02], [3.0199999999999996, 2.339999999999999, 1.8800000000000008]], ["C7", [-11.76, -8.17, 11.02], [3.0199999999999996, 2.34, 1.8800000000000008]], ["C8", [-14.375, 1.05, 9.69], [2.3499999999999996, 1.9000000000000001, 1.5721087000000011]], ["C9", [-17.745, -2.5, 8.67], [3.0900000000000016, 4.4, 2.5921087000000007]], ["D1", [13.1, 12.21, 8.92], [4.6, 4.009999999999998, 2.3421087000000007]], ["D2", [6.5, -4.29, 8.92], [4.6, 4.01, 2.3421087000000007]], ["FB1", [-17.32, -1.975, 11.02], [2.6400000000000006, 3.95, 2.2300000000000004]], ["J1", [-3.45, -12.05, 11.02], [7.5, 7.5, 3.780000000000001]], ["J2", [6.550000000000001, -1.5499999999999998, 11.02], [7.5, 7.5, 3.780000000000001]], ["J3", [-18.25, -13.75, 11.02], [5.5, 3.0999999999999996, 2.780000000000001]], ["J4", [-16.0, -13.6, 8.52], [8.0, 3.0999999999999996, 2.742108700000001]], ["J5", [2.675, -12.785, 9.92], [8.649999999999999, 3.5700000000000003, 1.3421087000000007]], ["J6", [2.45, -1.2000000000000002, 8.52], [13.100000000000001, 14.399999999999999, 2.742108700000001]], ["J7", [-16.419999999999998, 6.215, 9.92], [4.839999999999998, 3.5700000000000003, 1.3421087000000007]], ["L1", [1.4300000000000002, -3.7800000000000002, 11.02], [2.14, 3.0600000000000005, 1.8800000000000008]], ["Q1", [13.91, -9.38, 11.02], [4.010000000000002, 4.130000000000001, 2.380000000000001]], ["R1", [-17.39, 2.4699999999999998, 9.62], [2.380000000000001, 3.0600000000000005, 1.6421087000000014]], ["R12", [0.97, 12.91, 11.02], [3.0600000000000005, 2.379999999999999, 1.6800000000000015]], ["R13", [6.87, 12.81, 11.02], [3.0599999999999996, 2.379999999999999, 1.6800000000000015]], ["R14", [1.97, -6.19, 9.62], [3.0600000000000005, 2.380000000000001, 1.6421087000000014]], ["R15", [6.47, -5.19, 9.62], [3.0599999999999996, 2.380000000000001, 1.6421087000000014]], ["R16", [-2.74, -15.53, 11.02], [2.38, 3.0599999999999987, 1.6800000000000015]], ["R17", [-5.44, -13.53, 9.67], [2.380000000000001, 3.0599999999999987, 1.5921087000000007]], ["R18", [-1.1300000000000001, -13.29, 11.02], [3.06, 2.379999999999999, 1.6300000000000008]], ["R19", [-1.61, -14.92, 11.02], [3.06, 2.380000000000001, 1.6800000000000015]], ["R2", [-14.83, 2.8099999999999996, 9.62], [3.0600000000000005, 2.380000000000001, 1.6421087000000014]], ["R20", [2.9699999999999998, -14.94, 11.02], [3.0600000000000005, 2.379999999999999, 1.6800000000000015]], ["R21", [14.97, -11.44, 11.02], [3.0600000000000005, 2.379999999999999, 1.6800000000000015]], ["R22", [16.47, -12.69, 11.02], [3.0600000000000023, 2.379999999999999, 1.6800000000000015]], ["R23", [16.56, 8.97, 11.02], [2.3800000000000026, 3.0599999999999987, 1.6800000000000015]], ["R24", [-11.03, 8.31, 11.02], [3.059999999999998, 2.379999999999999, 1.6300000000000008]], ["R25", [-4.94, 9.97, 11.02], [2.380000000000001, 3.0599999999999987, 1.6300000000000008]], ["R26", [0.21999999999999986, 10.06, 11.02], [3.0600000000000005, 2.379999999999999, 1.6300000000000008]], ["R27", [-6.28, 13.06, 11.02], [3.0600000000000005, 2.379999999999999, 1.6300000000000008]], ["R28", [-15.19, 9.97, 9.67], [2.379999999999999, 3.0599999999999987, 1.5921087000000007]], ["R29", [-15.53, 13.56, 9.67], [3.0599999999999987, 2.379999999999999, 1.5921087000000007]], ["R3", [-5.73, -7.49, 11.02], [3.0600000000000005, 2.38, 1.6800000000000015]], ["R30", [-19.78, 10.81, 11.02], [3.0600000000000023, 2.379999999999999, 1.6300000000000008]], ["R4", [6.77, -6.49, 11.02], [3.0600000000000005, 2.38, 1.6800000000000015]], ["R5", [6.77, -7.89, 11.02], [3.0600000000000005, 2.38, 1.6800000000000015]], ["R6", [-13.53, -12.99, 11.02], [3.0599999999999987, 2.380000000000001, 1.6800000000000015]], ["R7", [-11.33, -12.99, 11.02], [3.0600000000000005, 2.380000000000001, 1.6800000000000015]], ["R8", [-9.53, 10.81, 9.62], [3.0599999999999996, 2.379999999999999, 1.6421087000000014]], ["R9", [-6.53, 10.81, 9.62], [3.0600000000000005, 2.379999999999999, 1.6421087000000014]], ["U1", [-14.47, -5.47, 11.02], [14.440000000000001, 13.44, 2.580000000000002]], ["U10", [-8.9, 9.2, 11.02], [3.8000000000000007, 4.600000000000001, 2.380000000000001]], ["U11", [-2.9000000000000004, 10.7, 11.02], [3.8000000000000003, 4.600000000000001, 2.380000000000001]], ["U12", [-20.15, 10.675, 8.92], [3.799999999999997, 4.649999999999999, 2.3421087000000007]], ["U2", [2.8, -4.7, 11.02], [4.39999, 4.4, 1.9800000000000004]], ["U3", [-15.225, -10.97, 11.02], [4.449999999999999, 4.140000000000001, 2.080000000000002]], ["U4", [-17.55, 9.13, 11.02], [5.100000000000001, 5.02, 2.7300000000000004]], ["U5", [8.73, 7.590000000000001, 11.02], [4.18, 4.179999999999999, 1.9800000000000004]], ["U6", [-8.1, -15.37, 11.02], [5.2, 5.02, 2.7300000000000004]], ["U7", [-4.37, -11.85, 8.57], [5.0200000000000005, 5.199999999999999, 2.6921087000000004]], ["U8", [12.675, -14.92, 11.02], [4.649999999999999, 4.01, 2.380000000000001]], ["U9", [14.95, 0.15999999999999992, 11.02], [3.8249999999999993, 4.615, 2.080000000000002]]];

module xy_box(b,z,h){translate([b[0],b[1],z])cube([b[2]-b[0],b[3]-b[1],h]);}
module body_locators(){for(b=locator_ribs)xy_box(b,floor_t,pcb_z-floor_t);}
module retention_posts(){for(b=retainer_posts)xy_box(b,retainer_post_z,body_h-retainer_post_z+.1);}
module guide_rail_solids(offset_z=0){difference(){
    intersection(){
        translate([0,0,pcb_z-1.5+offset_z-.01])linear_extrude(guide_top_z-(pcb_z-1.5)+.02)rr(41.6,33.6,1.8);
        union()for(i=[0:3])let(b=guide_rails[i],q=[b[0]-(i==0?.01:0),b[1]-(i==2?.01:0),b[2]+(i==1?.01:0),b[3]+(i==3?.01:0)])
            xy_box(q,pcb_z-1.5+offset_z,guide_top_z-(pcb_z-1.5));
    }
    // Open SIM lane: a bridge would intersect D1 at the admitted board lift.
    xy_box(sim_bridge_cut,pcb_z-1.5+offset_z-.01,guide_top_z-(pcb_z-1.5)+.02);
    for(b=guide_reliefs)xy_box(b,pcb_z-1.5+offset_z-.01,guide_top_z-(pcb_z-1.5)+.02);
    for(b=radial_slots)xy_box(b,key_slot_z+offset_z,guide_top_z-key_slot_z+.01);
}}
module retainer_plan(){intersection(){
    rr(retainer_outer[0],retainer_outer[1],retainer_outer_r);
    union(){difference(){rr(retainer_outer[0],retainer_outer[1],retainer_outer_r);rr(retainer_inner[0],retainer_inner[1],retainer_inner_r);}
        for(b=retainer_tabs)translate([b[0],b[1]])square([b[2]-b[0],b[3]-b[1]]);}
}}
module retainer(){
    translate([0,0,retainer_z])linear_extrude(retainer_h)retainer_plan();
    intersection(){
        translate([0,0,key_z-.01])linear_extrude(retainer_z-key_z+.12)rr(retainer_outer[0],retainer_outer[1],retainer_outer_r);
        union()for(i=[0:3])let(b=radial_keys[i],q=[b[0]-(i==0?.01:0),b[1]-(i==2?.01:0),b[2]+(i==1?.01:0),b[3]+(i==3?.01:0)])
            xy_box(q,key_z,retainer_z-key_z+.1);
    }
}
module moving_components(rows,clearance=0){for(p=rows)
    translate(p[1]-[clearance,clearance,clearance])cube(p[2]+[2*clearance,2*clearance,2*clearance]);}
module retention_interference(){
    intersection(){moving_components(motion_boxes,.2);union(){body_locators();retention_posts();}}
    intersection(){moving_components(frame_motion_boxes,.2);retainer();}
}
