gokselozgur5/pcb-design-collar-tracker/mechanical/swim-r17-cable-integration/routing.scad

rf_paths=[[[0.3, -8.3, 12.890880000000001], [-0.5918732506949225, -8.299024870582466, 12.89736855777778], [-1.4326487399089483, -8.29590083408391, 12.91639432888889], [-2.2241538920005164, -8.290329918135406, 12.947297460000001], [-2.968216131328064, -8.28201415036802, 12.98941809777778], [-3.666662882250032, -8.270655558412827, 13.042096388888893], [-4.321321569124858, -8.255956169900895, 13.104672480000005], [-4.934019616310978, -8.237618012463296, 13.176486517777777], [-5.506584448166835, -8.215343113731103, 13.256878648888891], [-6.040843489050864, -8.188833501335383, 13.34518902], [-6.538624163321506, -8.15779120290721, 13.440757777777781], [-7.001753895337196, -8.121918246077652, 13.542925068888888], [-7.43206010945638, -8.080916658477785, 13.65103104], [-7.831370230037488, -8.034488467738672, 13.764415837777777], [-8.201511681438962, -7.982335701491392, 13.882419608888888], [-8.544311888019244, -7.92416038736701, 14.0043825], [-8.861598274136766, -7.859664552996602, 14.129644657777778], [-9.15519826414997, -7.788550226011233, 14.257546228888888], [-9.426939282417294, -7.710519434041976, 14.38742736], [-9.678648753297182, -7.625274204719906, 14.518628197777778], [-9.912154101148062, -7.532516565676088, 14.65048888888889], [-10.129282750328379, -7.431948544541596, 14.78234958], [-10.331862125196572, -7.323272168947502, 14.913550417777776], [-10.521719650111079, -7.206189466524875, 15.043431548888888], [-10.700682749430337, -7.080402464904785, 15.17133312], [-10.870578847512784, -6.945613191718304, 15.296595277777776], [-11.033235368716864, -6.801523674596503, 15.418558168888888], [-11.19047973740101, -6.647835941170453, 15.53656194], [-11.344139377923657, -6.484252019071226, 15.649946737777777], [-11.496041714643253, -6.310473935929888, 15.758052708888888], [-11.648014171918232, -6.126203719377517, 15.860219999999998], [-11.801524008424485, -5.931260491968218, 15.955935391851849], [-11.956597820107728, -5.725931755948243, 16.045272201481477], [-12.112902037231125, -5.510622108486889, 16.12845038], [-12.270103090057841, -5.285736146753452, 16.205689878518516], [-12.427867408851046, -5.05167846791722, 16.27721064814815], [-12.5858614238739, -4.808853669147492, 16.343232639999997], [-12.743751565389571, -4.557666347613554, 16.403975805185183], [-12.901204263661228, -4.298521100484707, 16.45966009481481], [-13.057885948952038, -4.031822524930238, 16.510505459999997], [-13.213463051525162, -3.7579752181194452, 16.55673185185185], [-13.36760200164377, -3.477383777221617, 16.59855922148148], [-13.519969229571025, -3.1904527994060525, 16.63620752], [-13.67023116557009, -2.8975868818420385, 16.669896698518514], [-13.818054239904143, -2.5991906216988743, 16.699846708148144], [-13.96310488283634, -2.295668616145849, 16.7262775], [-14.105049524629848, -1.9874254623522591, 16.749409025185184], [-14.243554595547838, -1.674865757487394, 16.769461234814813], [-14.378286525853474, -1.35839409872055, 16.786654079999998], [-14.508911745809918, -1.038415083221021, 16.80120751185185], [-14.63509668568034, -0.7153333081580968, 16.81334148148148], [-14.756507775727908, -0.38955337070107504, 16.82327594], [-14.872811446215781, -0.06147986801924432, 16.831230838518515], [-14.98367412740713, 0.268482602718097, 16.837426128148145], [-15.088762249565125, 0.5999294443416594, 16.84208176], [-15.187742242952918, 0.9324560596821472, 16.845417685185183], [-15.280280537833693, 1.2656578515702708, 16.847653854814812], [-15.366043564470605, 1.5991302228367317, 16.849010219999997], [-15.444697753126825, 1.9324685763122416, 16.84970673185185], [-15.515909534065516, 2.2652683148275026, 16.84996334148148], [-15.579345337549842, 2.597124841213226, 16.849999999999998], [-15.634691603675888, 2.927656640171915, 16.849999999999998], [-15.681714811871373, 3.2565745238932826, 16.849999999999998], [-15.720201451396942, 3.583612386438847, 16.849999999999998], [-15.749938011513226, 3.908504121870111, 16.849999999999998], [-15.770710981480866, 4.230983624248592, 16.849999999999998], [-15.782306850560504, 4.550784787635805, 16.849999999999994], [-15.784512108012773, 4.867641506093253, 16.849999999999998], [-15.777113243098317, 5.181287673682459, 16.849999999999998], [-15.759896745077766, 5.491457184464929, 16.849999999999998], [-15.732649103211767, 5.797883932502183, 16.849999999999998], [-15.69515680676095, 6.100301811855722, 16.85], [-15.647206344985962, 6.398444716587065, 16.85], [-15.588584207147433, 6.692046540757724, 16.849999999999998], [-15.519076882506, 6.980841178429215, 16.849999999999998], [-15.438470860322315, 7.264562523663043, 16.849999999999998], [-15.346552629857003, 7.542944470520723, 16.849999999999998], [-15.243108680370707, 7.815720913063769, 16.849999999999998], [-15.12792550112406, 8.082625745353697, 16.849999999999998], [-15.00078958137771, 8.343392861452012, 16.849999999999998], [-14.86148741039229, 8.597756155420228, 16.849999999999998], [-14.709805477428434, 8.845449521319866, 16.849999999999998], [-14.545530271746784, 9.086206853212428, 16.849999999999998], [-14.368448282607982, 9.319762045159427, 16.849999999999998], [-14.178345999272663, 9.54584899122238, 16.849999999999998], [-13.975009911001463, 9.764201585462798, 16.849999999999998], [-13.75822650705502, 9.974553721942193, 16.849999999999998], [-13.527782276693976, 10.176639294722076, 16.849999999999998], [-13.283463709178971, 10.370192197863965, 16.849999999999998], [-13.025057293770633, 10.554946325429366, 16.85], [-12.752349519729613, 10.730635571479796, 16.849999999999998], [-12.465231579865351, 10.897072740279302, 16.849999999999998], [-12.164013481182524, 11.05438627690209, 16.849999999999998], [-11.849109934234617, 11.202783536624908, 16.849999999999998], [-11.520935649575126, 11.342471874724492, 16.849999999999998], [-11.179905337757534, 11.47365864647759, 16.849999999999998], [-10.826433709335323, 11.596551207160948, 16.849999999999994], [-10.460935474861989, 11.711356912051304, 16.849999999999998], [-10.083825344891018, 11.818283116425405, 16.849999999999998], [-9.695518029975892, 11.917537175559996, 16.849999999999998], [-9.296428240670096, 12.009326444731817, 16.849999999999998], [-8.886970687527127, 12.093858279217612, 16.85], [-8.467560081100464, 12.171340034294126, 16.85], [-8.038611131943599, 12.241979065238102, 16.849999999999998], [-7.600538550610009, 12.305982727326285, 16.849999999999998], [-7.153757047653197, 12.363558375835417, 16.849999999999998], [-6.6986813336266415, 12.414913366042242, 16.849999999999998], [-6.2357261190838305, 12.460255053223499, 16.849999999999998], [-5.7653061145782445, 12.499790792655944, 16.849999999999998], [-5.287836030663383, 12.533727939616307, 16.849999999999998], [-4.803730577892729, 12.562273849381338, 16.849999999999998], [-4.313404466819767, 12.58563587722778, 16.849999999999998], [-3.8172724079979767, 12.604021378432376, 16.849999999999998], [-3.315749111980862, 12.617637708271872, 16.849999999999998], [-2.8092492893219014, 12.626692222023006, 16.849999999999998], [-2.298187650574575, 12.631392274962531, 16.849999999999998], [-1.7829789062923844, 12.631945222367177, 16.849999999999998], [-1.2640377670288092, 12.628558419513698, 16.849999999999998], [-0.7417789433373374, 12.621439221678838, 16.849999999999998], [-0.2166171457714487, 12.610794984139332, 16.85], [0.31103291511535636, 12.596833062171935, 16.849999999999998], [0.8407104498192091, 12.579628334071018, 16.849999999999998], [1.3717703530346863, 12.558725770201503, 16.849999999999998], [1.9035214405059755, 12.53353786394596, 16.849999999999998], [2.435272527977264, 12.50347710868694, 16.849999999999998], [2.9663324311927557, 12.467955997807005, 16.849999999999994], [3.4960099658966093, 12.426387024688717, 16.849999999999994], [4.023613947833027, 12.378182682714638, 16.849999999999998], [4.548453192746196, 12.32275546526732, 16.849999999999998], [5.069836516380308, 12.25951786572933, 16.849999999999998], [5.5870727344795466, 12.187882377483223, 16.849999999999998], [6.099470662788102, 12.107261493911565, 16.849999999999998], [6.606339117050175, 12.017067708396908, 16.849999999999998], [7.106986913009928, 11.91671351432182, 16.849999999999998], [7.600722866411563, 11.805611405068856, 16.849999999999998], [8.086855792999268, 11.683173874020575, 16.849999999999998], [8.564694508517228, 11.54881341455954, 16.849999999999998], [9.033547828709633, 11.40194252006831, 16.849999999999998], [9.492724569320671, 11.241973683929444, 16.849999999999998], [9.941533546094533, 11.068319399525501, 16.849999999999998], [10.379283574775418, 10.88039216023904, 16.849999999999998], [10.805283471107485, 10.677604459452626, 16.849999999999998], [11.218842050834937, 10.459368790548815, 16.849999999999998], [11.619268129701965, 10.225097646910172, 16.849999999999998], [12.005870523452757, 9.97420352191925, 16.849999999999998], [12.377958047831495, 9.706098908958614, 16.849999999999998], [12.734839518582374, 9.420196301410817, 16.849999999999998], [13.075823751449587, 9.11590819265842, 16.849999999999998], [13.400219562177307, 8.792647076083991, 16.849999999999998], [13.707335766509726, 8.44982544507009, 16.85], [13.99648118019104, 8.086855792999268, 16.849999999999998], [14.267131655160581, 7.703461646169204, 16.850004938271603], [14.519431188138325, 7.300610662538037, 16.850039506172838], [14.75369081203937, 6.8795815329790155, 16.850133333333332], [14.970221559778846, 6.441652948365394, 16.850316049382712], [15.169334464271863, 5.988103599570411, 16.850617283950612], [15.351340558433531, 5.520212177467343, 16.85106666666666], [15.516550875178972, 5.03925737292943, 16.851693827160492], [15.665276447423297, 4.546517876829924, 16.852528395061725], [15.797828308081623, 4.043272380042078, 16.8536], [15.91451749006907, 3.530799573439142, 16.854938271604937], [16.015655026300742, 3.0103781478943707, 16.85657283950617], [16.10155194969177, 2.4832867942810006, 16.85853333333333], [16.172519293157258, 1.9508042034723105, 16.860849382716047], [16.228868089612323, 1.4142090663415394, 16.86355061728395], [16.27090937197208, 0.8747800737619401, 16.866666666666667], [16.29895417315165, 0.3337959166067641, 16.870227160493826], [16.31331352606614, -0.20746471425073731, 16.87426172839506], [16.314298463630674, -0.7477231279373103, 16.8788], [16.302220018760362, -1.2857006335797045, 16.88387160493827], [16.277389224370317, -1.8201185403046836, 16.889506172839504], [16.24011711337566, -2.3496981572389632, 16.89573333333333], [16.190714718691506, -2.873160793509307, 16.90258271604938], [16.129493073232965, -3.3892277582424644, 16.910083950617285], [16.05676320991516, -3.896620360565182, 16.918266666666668], [15.972836161653198, -4.394059909604208, 16.92716049382716], [15.878022961362202, -4.880267714486292, 16.93679506172839], [15.77263464195728, -5.353965084338193, 16.9472], [15.656982236353553, -5.813873328286633, 16.9584049382716], [15.531376777466136, -6.258713755458373, 16.970439506172838], [15.396129298210143, -6.687207674980161, 16.983333333333334], [15.251552689868873, -7.09829384731672, 16.997102021604935], [15.097967277198368, -7.491780838284664, 17.011705061728392], [14.935695243322849, -7.867694665038582, 17.027087916666662], [14.765058771366546, -8.226061344733056, 17.043196049382715], [14.586380044453671, -8.566906894522686, 17.0599749228395], [14.399981245708464, -8.890257331562042, 17.077369999999995], [14.206184558255138, -9.19613867300572, 17.095326743827158], [14.005312165217928, -9.48457693600831, 17.113790617283946], [13.797686249721048, -9.755598137724396, 17.132707083333333], [13.583628994888729, -10.009228295308569, 17.15202160493827], [13.363462583845191, -10.245493425915413, 17.171679645061726], [13.137509199714657, -10.464419546699524, 17.191626666666664], [12.906091025621357, -10.666032674815478, 17.211808132716047], [12.669530244689513, -10.850358827417868, 17.232169506172838], [12.428149040043351, -11.01742402166128, 17.25265625], [12.182269594807096, -11.167254274700305, 17.27321382716049], [11.932214092104964, -11.299875603689527, 17.293787700617283], [11.678304715061188, -11.415314025783536, 17.31432333333333], [11.420863646799988, -11.51359555813692, 17.334766188271605], [11.160213070445588, -11.594746217904266, 17.35506172839506], [10.896675169122215, -11.658792022240162, 17.375155416666665], [10.630572125954096, -11.705758988299191, 17.394992716049384], [10.362226124065451, -11.735673133235947, 17.41451908950617], [10.091959346580506, -11.748560474205014, 17.433679999999995], [9.820093976623482, -11.744447028360984, 17.452420910493824], [9.546952197318609, -11.72335881285844, 17.470687283950614], [9.272856191790106, -11.68532184485197, 17.48842458333333], [8.998128143162194, -11.630362141496162, 17.505578271604936], [8.72309023455911, -11.558505719945606, 17.522093811728393], [8.44806464910507, -11.469778597354889, 17.537916666666668], [8.173162419715194, -11.364425600729605, 17.55300396604938], [7.897649978468155, -11.2435667964794, 17.56735950617284], [7.620582607233526, -11.108541060864926, 17.58099875], [7.3410155878808805, -10.96068727014683, 17.593937160493827], [7.0580042022797755, -10.801344300585763, 17.606190200617284], [6.7706037322998025, -10.631851028442382, 17.617773333333332], [6.47786945981052, -10.453546329977335, 17.628702021604937], [6.178856666681501, -10.267769081451274, 17.638991728395062], [5.872620634782316, -10.075858159124852, 17.648657916666664], [5.558216645982533, -9.879152439258718, 17.657716049382714], [5.2346999821517235, -9.678990798113526, 17.66618158950617], [4.90112592515946, -9.476712111949922, 17.674069999999997], [4.556549756875301, -9.27365525702856, 17.68139674382716], [4.200026759168835, -9.071159109610097, 17.688177283950616], [3.8306122139096255, -8.870562545955181, 17.69442708333333], [3.4473614029672426, -8.673204442324462, 17.700161604938273], [3.0493296082112553, -8.480423674978592, 17.705396311728393], [2.6355721115112347, -8.293559120178223, 17.710146666666667], [2.205144194736752, -8.113949654184008, 17.714428132716048], [1.757101139757364, -7.942934153256592, 17.718256172839503], [1.2904982284426663, -7.781851493656633, 17.72164625], [0.804390742662217, -7.632040551644784, 17.724613827160493], [0.2978339642855865, -7.494840203481692, 17.72717436728395], [-0.23011682481765472, -7.371589325428009, 17.729343333333333], [-0.7804063427779356, -7.263626793744389, 17.731136188271602], [-1.3539793077256874, -7.172291484691479, 17.732568395061726], [-1.9517804377913377, -7.098922274529935, 17.733655416666664], [-2.5747544511053344, -7.044858039520404, 17.734412716049384], [-3.2238460657980728, -7.011437655923543, 17.734855756172838], [-3.9, -7.0, 17.735]], [[10.3, 2.2, 12.890880000000001], [10.297934506141697, 2.65593145809252, 12.894418557777778], [10.291420641291582, 3.1039650241751398, 12.90479432888889], [10.279982330536843, 3.5439785525771823, 12.92164746], [10.263143498964665, 3.9758498976279704, 12.94461809777778], [10.240428071662233, 4.399456913656829, 12.973346388888892], [10.211359973716737, 4.814677454993081, 13.007472480000004], [10.17546313021536, 5.221389375966049, 13.046636517777777], [10.1322614662453, 5.619470530905058, 13.09047864888889], [10.08127890689373, 6.00879877413943, 13.13863902], [10.022039377247848, 6.389251959998492, 13.19075777777778], [9.95406680239483, 6.760707942811563, 13.246475068888888], [9.876885107421874, 7.12304457690797, 13.305431040000002], [9.790018217416163, 7.476139716617034, 13.36726583777778], [9.69299005746488, 7.81987121626808, 13.431619608888887], [9.58532455265522, 8.154116930190433, 13.498132499999999], [9.466545628074364, 8.478754712713412, 13.56644465777778], [9.336177208809499, 8.793662418166345, 13.636196228888892], [9.193743219947814, 9.098717900878553, 13.707027360000001], [9.038767586576498, 9.393799015179361, 13.77857819777778], [8.870774233782734, 9.678783615398093, 13.85048888888889], [8.689287086653708, 9.95354955586407, 13.92239958], [8.493830070276612, 10.217974690906615, 13.993950417777778], [8.283927109738631, 10.471936874855055, 14.064781548888888], [8.059102130126954, 10.715313962038712, 14.134533120000002], [7.818879056528762, 10.94798380678691, 14.202845277777776], [7.562781814031246, 11.169824263428973, 14.26935816888889], [7.290334327721594, 11.380713186294223, 14.333711940000002], [7.001060522686993, 11.58052842971198, 14.395546737777778], [6.694484324014627, 11.769147848011576, 14.454502708888889], [6.370129656791686, 11.946449295522331, 14.51022], [6.027768675026189, 12.112327071416221, 14.562418725185186], [5.668166448409468, 12.266741254235855, 14.611138868148151], [5.292336275553701, 12.409668367366491, 14.65650038], [4.901291455071061, 12.541084934193382, 14.698623211851853], [4.496045285573711, 12.660967478101796, 14.737627314814814], [4.077611065673828, 12.769292522476988, 14.77363264], [3.6470020939835774, 12.86603659070422, 14.806759138518519], [3.2052316691151375, 12.951176206168748, 14.837126761481482], [2.7533130896806703, 13.024687892255837, 14.864855460000001], [2.2922596542923537, 13.08654817235074, 14.890065185185184], [1.8230846615623544, 13.136733569838722, 14.91287588814815], [1.3468014101028463, 13.175220608105036, 14.93340752], [0.8644231985259931, 13.20198581053495, 14.951780031851854], [0.3769633254439755, 13.217005700513717, 14.968113374814816], [-0.114564910531044, 13.2202568014266, 14.982527500000002], [-0.6091482107868886, 13.211715636658859, 14.99514235851852], [-1.1057732767113926, 13.191358729595748, 15.006077901481483], [-1.6034268096923832, 13.159162603622534, 15.015454080000001], [-2.1010955111176868, 13.115103782124468, 15.023390845185187], [-2.597766082375138, 13.059158788486817, 15.030008148148148], [-3.0924252248525606, 12.991304146094837, 15.035425940000001], [-3.5840596399377906, 12.91151637833379, 15.039764171851854], [-4.071656029018648, 12.81977200858893, 15.043142794814814], [-4.554201093482971, 12.716047560245524, 15.04568176], [-5.030681534718583, 12.600319556688826, 15.047501018518519], [-5.500084054113317, 12.472564521304095, 15.048720521481481], [-5.961395353054998, 12.332758977476596, 15.04946022], [-6.413602132931461, 12.180879448591583, 15.049840065185185], [-6.855691095130529, 12.01690245803432, 15.049980008148149], [-7.2866489410400375, 11.840804529190061, 15.05], [-7.705653744807064, 11.652611077527647, 15.050003703703704], [-8.112649071615708, 11.4525430868502, 15.05002962962963], [-8.507769859409333, 11.240870433044432, 15.0501], [-8.891151046131274, 11.017862991997044, 15.050237037037038], [-9.262927569724893, 10.783790639594747, 15.050462962962964], [-9.623234368133545, 10.538923251724238, 15.050799999999999], [-9.972206379300575, 10.283530704272232, 15.051270370370371], [-10.30997854116934, 10.017882873125426, 15.051896296296299], [-10.636685791683192, 9.74224963417053, 15.052700000000002], [-10.952463068785491, 9.456900863294246, 15.053703703703707], [-11.257445310419577, 9.16210643638328, 15.054929629629633], [-11.551767454528806, 8.85813622932434, 15.0564], [-11.835564439056533, 8.545260118004128, 15.058137037037037], [-12.108971201946115, 8.223747978309346, 15.060162962962963], [-12.372122681140898, 7.893869686126707, 15.062500000000002], [-12.625153814584234, 7.555895117342912, 15.065170370370371], [-12.868199540219479, 7.210094147844668, 15.068196296296296], [-13.10139479598999, 6.8567366535186745, 15.0716], [-13.324874519839106, 6.4960925102516445, 15.075403703703705], [-13.53877364971019, 6.12843159393028, 15.07962962962963], [-13.743227123546596, 5.75402378044128, 15.084300000000002], [-13.938369879291674, 5.3731389456713625, 15.089437037037037], [-14.12433685488877, 4.9860469655072235, 15.095062962962963], [-14.301262988281245, 4.593017715835572, 15.1012], [-14.46928321741245, 4.194321072543106, 15.107870370370371], [-14.628532480225735, 3.790226911516542, 15.115096296296297], [-14.779145714664455, 3.3810051086425785, 15.1229], [-14.92125785867196, 2.9669255398079217, 15.131303703703704], [-15.055003850191607, 2.548258080899272, 15.140329629629631], [-15.180518627166744, 2.1252726078033444, 15.150000000000002], [-15.297858413740435, 1.6983008429642092, 15.160331481481482], [-15.406764578854592, 1.2679218950554205, 15.17131851851852], [-15.50689977765083, 0.8347767193078974, 15.18295], [-15.597926665270766, 0.39950627095257824, 15.195214814814815], [-15.679507896856022, -0.03724849477962078, 15.20810185185185], [-15.751306127548213, -0.4748466226577789, 15.221599999999999], [-15.812984012488961, -0.9126471574509591, 15.235698148148149], [-15.864204206819885, -1.350009143928245, 15.250385185185188], [-15.904629365682597, -1.7862916268587088, 15.26565], [-15.933922144218723, -2.2208536510114327, 15.281481481481483], [-15.95174519756988, -2.6530542611554817, 15.297868518518518], [-15.957761180877682, -3.082252502059934, 15.314800000000002], [-15.951632749283753, -3.5078074184938686, 15.332264814814817], [-15.933022557929704, -3.9290780552263627, 15.350251851851851], [-15.901593261957164, -4.345423457026481, 15.368750000000002], [-15.857007516507746, -4.756202668663304, 15.387748148148148], [-15.798927976723068, -5.16077473490591, 15.407235185185186], [-15.727017297744746, -5.558498700523376, 15.427200000000001], [-15.640938134714403, -5.948733610284768, 15.44763148148148], [-15.540353142773661, -6.330838508959166, 15.468518518518518], [-15.42492497706413, -6.704172441315647, 15.48985], [-15.29431629272743, -7.068094452123289, 15.511614814814816], [-15.148189744905185, -7.421963586151158, 15.53380185185185], [-14.986207988739011, -7.765138888168332, 15.5564], [-14.808033679370523, -8.096979402943893, 15.57939814814815], [-14.613329471941343, -8.416844175246908, 15.602785185185185], [-14.401758021593091, -8.724092249846453, 15.626550000000002], [-14.172981983467382, -9.01808267151161, 15.650681481481481], [-13.926664012705833, -9.298174485011453, 15.675168518518518], [-13.66246676445007, -9.56372673511505, 15.700000000000003], [-13.380221566270896, -9.814261516606361, 15.72515], [-13.080434435455887, -10.049953124328892, 15.750533333333335], [-12.763780061721803, -10.271138903141017, 15.776050000000001], [-12.430933134785406, -10.478156197901122, 15.801600000000002], [-12.082568344363454, -10.671342353467587, 15.827083333333333], [-11.719360380172725, -10.851034714698791, 15.852400000000003], [-11.341983931929974, -11.017570626453114, 15.877449999999998], [-10.951113689351962, -11.171287433588944, 15.902133333333333], [-10.547424342155454, -11.312522480964658, 15.92635], [-10.131590580057216, -11.441613113438638, 15.949999999999998], [-9.704287092774006, -11.558896675869267, 15.972983333333332], [-9.266188570022576, -11.66471051311493, 15.9952], [-8.817969701519713, -11.759391970033997, 16.01655], [-8.36030517698217, -11.843278391484859, 16.036933333333334], [-7.893869686126706, -11.916707122325896, 16.056250000000002], [-7.419337918670089, -11.980015507415484, 16.0744], [-6.9373845643290775, -12.033540891612013, 16.091283333333333], [-6.448684312820438, -12.077620619773864, 16.1068], [-5.953911853860932, -12.112592036759407, 16.120849999999997], [-5.453741877167307, -12.13879248742704, 16.133333333333333], [-4.9488490724563565, -12.15655931663513, 16.14415], [-4.4399081294448255, -12.166229869242066, 16.153200000000002], [-3.927593737849482, -12.16814149010623, 16.160383333333336], [-3.4125805873870863, -12.162631524085995, 16.165599999999998], [-2.895543367774401, -12.150037316039754, 16.168750000000003], [-2.377156768728191, -12.130696210825883, 16.169733333333333], [-1.858095479965205, -12.104945553302763, 16.16845], [-1.3390341912022306, -12.073122688328777, 16.164800000000003], [-0.8206475921560201, -12.035564960762304, 16.158683333333332], [-0.3036103725433352, -11.992609715461729, 16.15], [0.21141402274767318, -11.94452120589945, 16.138690740740742], [0.7238071281433066, -11.89127132000393, 16.124859259259257], [1.232961722898477, -11.832758854317666, 16.10865], [1.7382705862680994, -11.76888260538313, 16.09020740740741], [2.2391264975070992, -11.699541369742814, 16.069675925925925], [2.7349222358703633, -11.624633943939209, 16.0472], [3.2250505806128187, -11.544059124514789, 16.022924074074076], [3.7089043109893787, -11.45771570801205, 15.99699259259259], [4.185876206254956, -11.36550249097347, 15.969550000000002], [4.655359045664465, -11.26731826994154, 15.940740740740742], [5.116745608472817, -11.163061841458742, 15.91070925925926], [5.56942867393494, -11.052632002067563, 15.8796], [6.012801021305721, -10.935927548310488, 15.847557407407407], [6.446255429840088, -10.812847276730004, 15.814725925925927], [6.869184678792951, -10.683289983868598, 15.781250000000002], [7.280981547419227, -10.54715446626875, 15.747274074074078], [7.681038814973828, -10.404339520472949, 15.712942592592594], [8.068749260711664, -10.254743943023682, 15.6784], [8.443505663887652, -10.098266530463434, 15.643790740740743], [8.804700803756717, -9.934806079334681, 15.609259259259261], [9.151727459573744, -9.764261386179921, 15.574950000000001], [9.483978410593668, -9.58653124754164, 15.54100740740741], [9.800846436071392, -9.401514459962312, 15.507575925925925], [10.101724315261837, -9.209109819984436, 15.4748], [10.386004827419912, -9.009216124150488, 15.442824074074075], [10.65308075180053, -8.801732169002957, 15.411792592592594], [10.902344867658616, -8.586556751084323, 15.381850000000002], [11.133189954249062, -8.363588666937083, 15.353140740740741], [11.345008790826796, -8.132726713103716, 15.325809259259259], [11.537194156646727, -7.893869686126708, 15.3], [11.70927376890712, -7.6470625653205095, 15.275848935185188], [11.861315096579654, -7.3929350610874325, 15.25345814814815], [11.993520546579358, -7.132263066601755, 15.232921250000002], [12.106092525821259, -6.865822475037755, 15.214331851851853], [12.199233441220386, -6.5943891795697, 15.197783564814815], [12.273145699691767, -6.318739073371884, 15.18337], [12.328031708150437, -6.039648049618577, 15.171184768518518], [12.364093873511418, -5.757892001484058, 15.161321481481483], [12.38153460268974, -5.474246822142601, 15.15387375], [12.380556302600432, -5.189488404768485, 15.148935185185186], [12.361361380158527, -4.904392642535989, 15.146599398148147], [12.324152242279048, -4.61973542861938, 15.14696], [12.269131295877031, -4.336292656192953, 15.150110601851853], [12.196500947867495, -4.054840218430977, 15.156144814814816], [12.10646360516548, -3.776154008507728, 15.16515625], [11.999221674686005, -3.5010099195974846, 15.177238518518518], [11.874977563344107, -3.230183844874525, 15.192485231481482], [11.73393367805481, -2.964451677513125, 15.21099], [11.576292425733143, -2.7045893106875623, 15.232846435185184], [11.40225621329413, -2.4513726375721085, 15.258148148148148], [11.212027447652813, -2.2055775513410545, 15.286988750000003], [11.005808535724213, -1.9679799451686706, 15.319461851851853], [10.783801884423362, -1.739355712229234, 15.355661064814814], [10.54620990066528, -1.520480745697022, 15.395679999999999], [10.293234991365008, -1.3121309387463125, 15.439612268518518], [10.025079563437568, -1.115082184551382, 15.48755148148148], [9.741946023797992, -0.9301103762865093, 15.53959125], [9.444036779361298, -0.7579914071259666, 15.595825185185188], [9.13155423704253, -0.59950117024404, 15.656346898148149], [8.804700803756711, -0.45541555881500245, 15.72125], [8.463926272648353, -0.32606678348735585, 15.790537916666667], [8.110669981779875, -0.2100123248064969, 15.863853333333333], [7.746618655443193, -0.10536598079204687, 15.940748750000001], [7.373459017930211, -0.010241549463626737, 16.020776666666666], [6.992877793532825, 0.0772471711591445, 16.103489583333335], [6.606561706542966, 0.15898638305664106, 16.18844], [6.216197481252527, 0.23686228820924404, 16.275180416666664], [5.823471841953419, 0.3127610885973328, 16.363263333333336], [5.430071512937547, 0.3885689862012859, 16.45224125], [5.037683218496819, 0.4661721830014821, 16.541666666666664], [4.647993682923144, 0.5474568809783006, 16.63109208333333], [4.262689630508428, 0.6343092821121201, 16.720069999999996], [3.883457785544568, 0.7286155883833221, 16.808152916666664], [3.511984872323494, 0.8322620017722804, 16.894893333333332], [3.149957615137099, 0.9471347242593764, 16.97984375], [2.7990627382772946, 1.075119957824989, 17.062556666666666], [2.4609869660359855, 1.2181039044494972, 17.142584583333335], [2.137417022705081, 1.3779727661132795, 17.219479999999997], [1.8300396325764867, 1.5566127447967149, 17.292795416666664], [1.540541519942104, 1.7559100424801881, 17.36208333333333], [1.2706094090938551, 1.977750861144067, 17.42689625], [1.0219300243236393, 2.2240214027687357, 17.486786666666667], [0.7961900899233644, 2.4966078693345732, 17.541307083333333], [0.5950763301849373, 2.7973964628219585, 17.59001], [0.4202754694002659, 3.1282733852112705, 17.632447916666667], [0.2734742318612574, 3.4911248384828872, 17.668173333333332], [0.1563593418598191, 3.8878370246171885, 17.696738749999998], [0.07061752368785665, 4.320296145594566, 17.71769666666667], [0.017935501637282063, 4.790388403395372, 17.730599583333326], [0.0, 5.3, 17.735]]];
part_boxes=[[[-16.625, 2.9, 11.24088], [1.25, 0.8000000000000003, 0.6400000000000006]], [[17.44, 13.030000000000001, 9.6], [1.9199999999999982, 1.2399999999999984, 0.8000000000000007]], [[0.34, -4.2700000000000005, 11.24088], [1.9200000000000002, 1.2400000000000007, 0.8000000000000007]], [[5.54, 0.27999999999999997, 11.24088], [1.92, 1.24, 0.8000000000000007]], [[7.04, -4.42, 11.24088], [1.919999999999999, 1.2400000000000002, 0.8000000000000007]], [[9.780000000000001, -6.46, 11.24088], [1.2399999999999984, 1.92, 0.8000000000000007]], [[-12.42, -7.21, 9.6], [1.2399999999999984, 1.92, 0.8000000000000007]], [[-16.425, -7.62, 11.24088], [2.8499999999999996, 1.54, 1.1999999999999993]], [[-17.16, -9.12, 11.24088], [1.92, 1.2399999999999993, 0.8000000000000007]], [[-16.4, 4.2749999999999995, 11.24088], [0.7999999999999972, 1.2500000000000009, 0.6400000000000006]], [[-12.959999999999999, 11.58, 11.24088], [1.9199999999999982, 1.2399999999999984, 0.8000000000000007]], [[-12.959999999999999, 9.88, 11.24088], [1.9199999999999982, 1.2399999999999984, 0.8000000000000007]], [[13.040000000000001, 9.98, 11.24088], [1.9199999999999982, 1.2399999999999984, 0.8000000000000007]], [[13.040000000000001, 7.88, 11.24088], [1.9199999999999982, 1.2399999999999993, 0.8000000000000007]], [[-7.245, -13.399999999999999, 8.8], [1.9900000000000002, 3.299999999999997, 1.5999999999999996]], [[-5.71, -8.67, 9.6], [1.92, 1.2400000000000002, 0.8000000000000007]], [[-9.37, -14.709999999999999, 11.24088], [1.2399999999999984, 1.9199999999999982, 0.8000000000000007]], [[2.38, -13.459999999999999, 11.24088], [1.2400000000000002, 1.9199999999999982, 0.8000000000000007]], [[12.040000000000001, -15.62, 11.24088], [1.9199999999999982, 1.2399999999999984, 0.8000000000000007]], [[-16.995, -5.95, 11.24088], [1.9900000000000002, 3.3000000000000003, 1.6999999999999993]], [[16.54, 4.88, 11.24088], [1.9200000000000017, 1.2400000000000002, 0.8000000000000007]], [[-9.87, 11.540000000000001, 11.24088], [1.2399999999999984, 1.9199999999999982, 0.8000000000000007]], [[-3.87, 13.040000000000001, 11.24088], [1.2400000000000002, 1.9199999999999982, 0.8000000000000007]], [[-16.62, 13.040000000000001, 9.6], [1.2400000000000002, 1.9199999999999982, 0.8000000000000007]], [[-8.709999999999999, 13.88, 11.24088], [1.919999999999999, 1.2399999999999984, 0.8000000000000007]], [[-1.96, 9.13, 11.24088], [1.92, 1.2399999999999984, 0.8000000000000007]], [[-14.62, -7.96, 9.6], [1.2399999999999984, 1.92, 0.8000000000000007]], [[-14.225, -3.77, 9.200000000000001], [2.8499999999999996, 1.54, 1.1999999999999993]], [[-4.875, 7.8, 11.24088], [1.25, 0.7999999999999998, 0.5800000000000001]], [[-2.96, 8.08, 11.24088], [1.92, 1.2399999999999984, 0.8499999999999996]], [[-11.209999999999999, -7.62, 11.24088], [1.9199999999999982, 1.2400000000000002, 0.8499999999999996]], [[-13.825, 1.6, 9.82], [1.2499999999999982, 0.8000000000000003, 0.5800000000000001]], [[-17.195, -1.95, 8.8], [1.9900000000000002, 3.3, 1.5999999999999996]], [[13.65, 12.760000000000002, 9.05], [3.4999999999999982, 2.9099999999999984, 1.3499999999999996]], [[7.05, -3.74, 9.05], [3.499999999999999, 2.91, 1.3499999999999996]], [[-16.77, -1.425, 11.24088], [1.5399999999999991, 2.85, 1.1999999999999993]], [[-2.9000000000000004, -11.5, 11.24088], [6.4, 6.3999999999999995, 2.75]], [[7.1000000000000005, -0.9999999999999999, 11.24088], [6.3999999999999995, 6.4, 2.75]], [[-15.45, -13.049999999999999, 8.65], [6.899999999999999, 1.9999999999999982, 1.75]], [[3.2249999999999996, -12.235, 10.05], [7.549999999999999, 2.469999999999999, 0.34999999999999964]], [[3.0, -0.65, 8.65], [12.0, 13.299999999999999, 1.75]], [[-15.87, 6.765, 10.05], [3.7399999999999984, 2.4699999999999998, 0.34999999999999964]], [[1.9800000000000002, -3.23, 11.24088], [1.0399999999999998, 1.96, 0.8499999999999996]], [[14.46, -8.83, 11.24088], [2.91, 3.0300000000000002, 1.3499999999999996]], [[-16.84, 3.02, 9.75], [1.2799999999999994, 1.9600000000000004, 0.6500000000000004]], [[1.52, 13.46, 11.24088], [1.96, 1.2799999999999976, 0.6500000000000004]], [[7.42, 13.360000000000001, 11.24088], [1.959999999999999, 1.2799999999999976, 0.6500000000000004]], [[2.52, -5.640000000000001, 9.75], [1.9600000000000004, 1.2800000000000011, 0.6500000000000004]], [[7.02, -4.640000000000001, 9.75], [1.959999999999999, 1.2800000000000007, 0.6500000000000004]], [[-2.19, -14.979999999999999, 11.24088], [1.2799999999999998, 1.9599999999999973, 0.6500000000000004]], [[-4.890000000000001, -12.979999999999999, 9.8], [1.2800000000000007, 1.9599999999999973, 0.5999999999999996]], [[-0.5800000000000001, -12.739999999999998, 11.24088], [1.96, 1.2799999999999976, 0.5999999999999996]], [[-1.06, -14.37, 11.24088], [1.96, 1.2799999999999994, 0.6500000000000004]], [[-14.28, 3.36, 9.75], [1.959999999999999, 1.2800000000000007, 0.6500000000000004]], [[3.52, -14.389999999999999, 11.24088], [1.9600000000000004, 1.2799999999999976, 0.6500000000000004]], [[15.520000000000001, -10.889999999999999, 11.24088], [1.959999999999999, 1.2799999999999976, 0.6500000000000004]], [[17.02, -12.139999999999999, 11.24088], [1.9600000000000009, 1.2799999999999976, 0.6500000000000004]], [[17.11, 9.520000000000001, 11.24088], [1.2800000000000011, 1.9599999999999973, 0.6500000000000004]], [[-10.479999999999999, 8.860000000000001, 11.24088], [1.9599999999999973, 1.2799999999999976, 0.5999999999999996]], [[-4.390000000000001, 10.520000000000001, 11.24088], [1.2800000000000007, 1.9599999999999973, 0.5999999999999996]], [[0.7699999999999999, 10.610000000000001, 11.24088], [1.96, 1.2799999999999976, 0.5999999999999996]], [[-5.73, 13.610000000000001, 11.24088], [1.9600000000000004, 1.2799999999999976, 0.5999999999999996]], [[-14.639999999999999, 10.520000000000001, 9.8], [1.2799999999999976, 1.9599999999999973, 0.5999999999999996]], [[-14.979999999999999, 14.110000000000001, 9.8], [1.9599999999999973, 1.2799999999999976, 0.5999999999999996]], [[-5.180000000000001, -6.94, 11.24088], [1.9600000000000009, 1.2800000000000002, 0.6500000000000004]], [[-19.23, 11.360000000000001, 11.24088], [1.9600000000000009, 1.2799999999999976, 0.5999999999999996]], [[7.319999999999999, -5.94, 11.24088], [1.96, 1.2800000000000002, 0.6500000000000004]], [[7.319999999999999, -7.34, 11.24088], [1.96, 1.2800000000000002, 0.6500000000000004]], [[-12.979999999999999, -12.44, 11.24088], [1.9599999999999973, 1.2799999999999994, 0.6500000000000004]], [[-10.78, -12.44, 11.24088], [1.959999999999999, 1.2799999999999994, 0.6500000000000004]], [[-8.979999999999999, 11.360000000000001, 9.75], [1.959999999999999, 1.2799999999999976, 0.6500000000000004]], [[-5.98, 11.360000000000001, 9.75], [1.9600000000000009, 1.2799999999999976, 0.6500000000000004]], [[-13.92, -4.92, 11.24088], [13.34, 12.34, 1.5500000000000007]], [[-8.35, 9.75, 11.24088], [2.7, 3.5, 1.3499999999999996]], [[-2.35, 11.25, 11.24088], [2.7, 3.5, 1.3499999999999996]], [[-19.599999999999998, 11.225000000000001, 9.05], [2.6999999999999957, 3.549999999999997, 1.3499999999999996]], [[3.3499999999999996, -4.15, 11.24088], [3.29999, 3.3000000000000003, 0.9499999999999993]], [[-14.674999999999999, -10.42, 11.24088], [3.349999999999998, 3.04, 1.0500000000000007]], [[-17.0, 9.680000000000001, 11.24088], [4.0, 3.919999999999998, 1.6999999999999993]], [[9.280000000000001, 8.14, 11.24088], [3.0799999999999983, 3.0799999999999983, 0.9499999999999993]], [[-7.55, -14.819999999999999, 11.24088], [4.1, 3.919999999999998, 1.6999999999999993]], [[-3.8200000000000003, -11.299999999999999, 8.700000000000001], [3.9200000000000004, 4.099999999999999, 1.6999999999999993]], [[13.225000000000001, -14.37, 11.24088], [3.549999999999997, 2.9099999999999984, 1.3499999999999996]], [[15.5, 0.71, 11.24088], [2.724999999999998, 3.5150000000000006, 1.0500000000000007]]];
// Four-cable nominal assembly. Physical qualification remains open.
part="review";
module lid(){translate([0,0,18.5])import("../swim-r11-thermal-fit/lid.stl");}
module witnesses(){import("lte-guide-witness.stl");import("gnss-guide-witness.stl");}
module guide_collision(){intersection(){lid();witnesses();}}
// A 0.3 mm cube is wholly inside the existing LTE guide wall. This gives an
// exact positive-volume Boolean control without tangential cable slivers.
module guide_wall_control(){intersection(){lid();translate([-16.75,2.45,17.95])cube([.3,.3,.3]);}}
module rf(){for(j=[0:1])color(j==0?[.95,.55,.12]:[.15,.48,.9])for(i=[0:len(rf_paths[j])-2])hull(){translate(rf_paths[j][i])sphere(r=.565,$fn=10);translate(rf_paths[j][i+1])sphere(r=.565,$fn=10);}}
module review(){
 color([.72,.76,.80,.18])import("../swim-r16-contact-retention/body.stl");
 color([.26,.62,.68,.18])translate([0,0,1.8])import("../swim-r12-pack-retention/carrier.stl");
 color([.63,.3,.66,.22])translate([0,0,10.6])import("../swim-r11-thermal-fit/retainer.stl");
 color([.35,.42,.48,.22])for(b=part_boxes)translate(b[0])cube(b[1]);
 color([.15,.45,.25,.25])translate([-20,-16,10.4])cube([40,32,.84088]);
 color([.9,.12,.12])import("../../assembly/internal-charge-r02/red-wire.stl");
 color([.12,.12,.14])import("../../assembly/internal-charge-r02/black-wire.stl");
 rf();
}
if(part=="guide_collision")guide_collision();
else if(part=="guide_wall_control")guide_wall_control();
else review();
