gokselozgur5/pcb-design-collar-tracker/mechanical/universal-mount-r01/components.scad

// Simplified component envelopes at native positions; not supplier 3D models.
color([0.12, 0.13, 0.16])translate([-16.425,3.1,11.24088])cube([0.8500000000000014,0.3999999999999999,0.39]); // C1
color([0.12, 0.13, 0.16])translate([17.64,13.23,9.85])cube([1.5199999999999996,0.8399999999999999,0.55]); // C10
color([0.12, 0.13, 0.16])translate([0.54,-4.07,11.24088])cube([1.52,0.8400000000000003,0.55]); // C13
color([0.12, 0.13, 0.16])translate([5.74,0.48,11.24088])cube([1.5199999999999996,0.8400000000000001,0.55]); // C14
color([0.12, 0.13, 0.16])translate([7.24,-4.22,11.24088])cube([1.5199999999999996,0.8399999999999999,0.55]); // C15
color([0.12, 0.13, 0.16])translate([9.98,-6.26,11.24088])cube([0.8399999999999999,1.5199999999999996,0.55]); // C16
color([0.12, 0.13, 0.16])translate([-12.22,-7.01,9.85])cube([0.8399999999999999,1.5199999999999996,0.55]); // C17
color([0.12, 0.13, 0.16])translate([-16.225,-7.42,11.24088])cube([2.450000000000001,1.1399999999999997,0.95]); // C18
color([0.12, 0.13, 0.16])translate([-16.96,-8.92,11.24088])cube([1.5200000000000014,0.8399999999999999,0.55]); // C19
color([0.12, 0.13, 0.16])translate([-16.2,4.475,11.24088])cube([0.3999999999999986,0.8500000000000005,0.39]); // C2
color([0.12, 0.13, 0.16])translate([-12.76,11.78,11.24088])cube([1.5199999999999996,0.8399999999999999,0.55]); // C20
color([0.12, 0.13, 0.16])translate([-12.76,10.08,11.24088])cube([1.5199999999999996,0.8399999999999999,0.55]); // C21
color([0.12, 0.13, 0.16])translate([13.24,10.18,11.24088])cube([1.5199999999999996,0.8399999999999999,0.55]); // C23
color([0.12, 0.13, 0.16])translate([13.24,8.08,11.24088])cube([1.5199999999999996,0.8399999999999999,0.55]); // C24
color([0.12, 0.13, 0.16])translate([-7.045,-13.2,9.05])cube([1.5899999999999999,2.8999999999999986,1.35]); // C25
color([0.12, 0.13, 0.16])translate([-5.51,-8.47,9.85])cube([1.5199999999999996,0.8400000000000007,0.55]); // C26
color([0.12, 0.13, 0.16])translate([-9.17,-14.51,11.24088])cube([0.8399999999999999,1.5199999999999996,0.55]); // C27
color([0.12, 0.13, 0.16])translate([2.58,-13.26,11.24088])cube([0.8399999999999999,1.5199999999999996,0.55]); // C28
color([0.12, 0.13, 0.16])translate([12.24,-15.42,11.24088])cube([1.5199999999999996,0.8399999999999999,0.55]); // C29
color([0.12, 0.13, 0.16])translate([-16.795,-5.75,11.24088])cube([1.5900000000000016,2.9,1.45]); // C3
color([0.12, 0.13, 0.16])translate([16.74,5.08,11.24088])cube([1.5200000000000031,0.8399999999999999,0.55]); // C30
color([0.12, 0.13, 0.16])translate([-9.67,11.74,11.24088])cube([0.8399999999999999,1.5199999999999996,0.55]); // C31
color([0.12, 0.13, 0.16])translate([-3.67,13.24,11.24088])cube([0.8399999999999999,1.5199999999999996,0.55]); // C32
color([0.12, 0.13, 0.16])translate([-16.42,13.24,9.85])cube([0.8400000000000016,1.5199999999999996,0.55]); // C33
color([0.12, 0.13, 0.16])translate([-8.51,14.08,11.24088])cube([1.5199999999999996,0.8399999999999999,0.55]); // C34
color([0.12, 0.13, 0.16])translate([-1.76,9.33,11.24088])cube([1.52,0.8399999999999999,0.55]); // C35
color([0.12, 0.13, 0.16])translate([-14.42,-7.76,9.85])cube([0.8399999999999999,1.5199999999999996,0.55]); // C36
color([0.12, 0.13, 0.16])translate([-14.025,-3.57,9.450000000000001])cube([2.450000000000001,1.1399999999999997,0.95]); // C4
color([0.12, 0.13, 0.16])translate([-4.675,8.0,11.24088])cube([0.8499999999999996,0.40000000000000036,0.33]); // C5
color([0.12, 0.13, 0.16])translate([-2.76,8.28,11.24088])cube([1.5199999999999998,0.8399999999999999,0.6]); // C6
color([0.12, 0.13, 0.16])translate([-11.01,-7.42,11.24088])cube([1.5199999999999996,0.8399999999999999,0.6]); // C7
color([0.12, 0.13, 0.16])translate([-13.625,1.8,10.07])cube([0.8499999999999996,0.40000000000000013,0.33]); // C8
color([0.12, 0.13, 0.16])translate([-16.995,-1.75,9.05])cube([1.5900000000000016,2.9,1.35]); // C9
color([0.12, 0.13, 0.16])translate([13.85,12.96,9.3])cube([3.0999999999999996,2.51,1.1]); // D1
color([0.12, 0.13, 0.16])translate([7.25,-3.54,9.3])cube([3.0999999999999996,2.51,1.1]); // D2
color([0.12, 0.13, 0.16])translate([-16.57,-1.225,11.24088])cube([1.1400000000000006,2.45,0.95]); // FB1
color([0.12, 0.13, 0.16])translate([-1.75,-10.3,11.24088])cube([3.4699999999999998,4.000000000000001,2.5]); // J1
color([0.12, 0.13, 0.16])translate([8.25,0.2,11.24088])cube([3.4700000000000006,4.0,2.5]); // J2
color([0.12, 0.13, 0.16])translate([-17.5,-13.0,11.24088])cube([4.0,1.5999999999999996,1.5]); // J3
color([0.12, 0.13, 0.16])translate([-15.25,-12.85,8.9])cube([6.5,1.5999999999999996,1.5]); // J4
color([0.12, 0.13, 0.16])translate([3.425,-12.035,10.3])cube([7.1499999999999995,2.0700000000000003,0.1]); // J5
color([0.57, 0.6, 0.64])translate([3.2,-0.45,8.9])cube([11.600000000000001,12.899999999999999,1.5]); // J6
color([0.12, 0.13, 0.16])translate([-15.67,6.965,10.3])cube([3.34,2.0700000000000003,0.1]); // J7
color([0.12, 0.13, 0.16])translate([2.18,-3.03,11.24088])cube([0.6399999999999997,1.5599999999999998,0.6]); // L1
color([0.12, 0.13, 0.16])translate([14.66,-8.63,11.24088])cube([2.5100000000000016,2.630000000000001,1.1]); // Q1
color([0.12, 0.13, 0.16])translate([-16.64,3.22,10.0])cube([0.8800000000000008,1.56,0.4]); // R1
color([0.12, 0.13, 0.16])translate([1.72,13.66,11.24088])cube([1.5599999999999998,0.879999999999999,0.4]); // R12
color([0.12, 0.13, 0.16])translate([7.62,13.56,11.24088])cube([1.5599999999999996,0.879999999999999,0.4]); // R13
color([0.12, 0.13, 0.16])translate([2.72,-5.44,10.0])cube([1.56,0.8800000000000008,0.4]); // R14
color([0.12, 0.13, 0.16])translate([7.22,-4.44,10.0])cube([1.5599999999999996,0.8800000000000003,0.4]); // R15
color([0.12, 0.13, 0.16])translate([-1.99,-14.78,11.24088])cube([0.8799999999999999,1.5599999999999987,0.4]); // R16
color([0.12, 0.13, 0.16])translate([-4.69,-12.78,10.05])cube([0.8800000000000003,1.5599999999999987,0.35]); // R17
color([0.12, 0.13, 0.16])translate([-0.38,-12.54,11.24088])cube([1.56,0.879999999999999,0.35]); // R18
color([0.12, 0.13, 0.16])translate([-0.86,-14.17,11.24088])cube([1.56,0.8800000000000008,0.4]); // R19
color([0.12, 0.13, 0.16])translate([-14.08,3.56,10.0])cube([1.5600000000000005,0.8800000000000003,0.4]); // R2
color([0.12, 0.13, 0.16])translate([3.72,-14.19,11.24088])cube([1.56,0.879999999999999,0.4]); // R20
color([0.12, 0.13, 0.16])translate([15.72,-10.69,11.24088])cube([1.5600000000000005,0.879999999999999,0.4]); // R21
color([0.12, 0.13, 0.16])translate([17.22,-11.94,11.24088])cube([1.5600000000000023,0.879999999999999,0.4]); // R22
color([0.12, 0.13, 0.16])translate([17.31,9.72,11.24088])cube([0.8800000000000026,1.5599999999999987,0.4]); // R23
color([0.12, 0.13, 0.16])translate([-10.28,9.06,11.24088])cube([1.5599999999999987,0.879999999999999,0.35]); // R24
color([0.12, 0.13, 0.16])translate([-4.19,10.72,11.24088])cube([0.8800000000000003,1.5599999999999987,0.35]); // R25
color([0.12, 0.13, 0.16])translate([0.97,10.81,11.24088])cube([1.5599999999999998,0.879999999999999,0.35]); // R26
color([0.12, 0.13, 0.16])translate([-5.53,13.81,11.24088])cube([1.56,0.879999999999999,0.35]); // R27
color([0.12, 0.13, 0.16])translate([-14.44,10.72,10.05])cube([0.879999999999999,1.5599999999999987,0.35]); // R28
color([0.12, 0.13, 0.16])translate([-14.78,14.31,10.05])cube([1.5599999999999987,0.879999999999999,0.35]); // R29
color([0.12, 0.13, 0.16])translate([-4.98,-6.74,11.24088])cube([1.5600000000000005,0.8799999999999999,0.4]); // R3
color([0.12, 0.13, 0.16])translate([-19.03,11.56,11.24088])cube([1.5600000000000023,0.879999999999999,0.35]); // R30
color([0.12, 0.13, 0.16])translate([7.52,-5.74,11.24088])cube([1.5600000000000005,0.8799999999999999,0.4]); // R4
color([0.12, 0.13, 0.16])translate([7.52,-7.14,11.24088])cube([1.5600000000000005,0.8799999999999999,0.4]); // R5
color([0.12, 0.13, 0.16])translate([-12.78,-12.24,11.24088])cube([1.5599999999999987,0.8800000000000008,0.4]); // R6
color([0.12, 0.13, 0.16])translate([-10.58,-12.24,11.24088])cube([1.5600000000000005,0.8800000000000008,0.4]); // R7
color([0.12, 0.13, 0.16])translate([-8.78,11.56,10.0])cube([1.5599999999999996,0.879999999999999,0.4]); // R8
color([0.12, 0.13, 0.16])translate([-5.78,11.56,10.0])cube([1.5600000000000005,0.879999999999999,0.4]); // R9
color([0.57, 0.6, 0.64])translate([-13.72,-4.72,11.24088])cube([12.940000000000001,11.94,1.3]); // U1
color([0.12, 0.13, 0.16])translate([-8.15,9.95,11.24088])cube([2.3000000000000007,3.1000000000000014,1.1]); // U10
color([0.12, 0.13, 0.16])translate([-2.15,11.45,11.24088])cube([2.3,3.1000000000000014,1.1]); // U11
color([0.12, 0.13, 0.16])translate([-19.4,11.425,9.3])cube([2.299999999999997,3.1499999999999986,1.1]); // U12
color([0.12, 0.13, 0.16])translate([3.55,-3.95,11.24088])cube([2.89999,2.9000000000000004,0.7]); // U2
color([0.12, 0.13, 0.16])translate([-14.475,-10.22,11.24088])cube([2.9499999999999993,2.6400000000000006,0.8]); // U3
color([0.12, 0.13, 0.16])translate([-16.8,9.88,11.24088])cube([3.6000000000000014,3.5199999999999996,1.45]); // U4
color([0.12, 0.13, 0.16])translate([9.48,8.34,11.24088])cube([2.6799999999999997,2.6799999999999997,0.7]); // U5
color([0.12, 0.13, 0.16])translate([-7.35,-14.62,11.24088])cube([3.6999999999999997,3.5199999999999996,1.45]); // U6
color([0.12, 0.13, 0.16])translate([-3.62,-11.1,8.950000000000001])cube([3.52,3.6999999999999993,1.45]); // U7
color([0.12, 0.13, 0.16])translate([13.425,-14.17,11.24088])cube([3.1499999999999986,2.51,1.1]); // U8
color([0.12, 0.13, 0.16])translate([15.7,0.91,11.24088])cube([2.3249999999999993,3.115,0.8]); // U9
