gokselozgur5/pcb-design-collar-tracker/mechanical/swim-r08-antennas/evidence/initial-guide/cables.scad

// Generated by check_antenna_assembly.py; nominal conditional cable geometry.
cable_radius = 0.565;
cable_0 = [[0.3, -8.3, 12.49088], [-0.016477, -8.299656, 12.493232], [-0.329904, -8.298582, 12.500192], [-0.640275, -8.296712, 12.511618], [-0.947584, -8.293983, 12.527367], [-1.251825, -8.29033, 12.547297], [-1.552992, -8.285689, 12.571266], [-1.851079, -8.279995, 12.59913], [-2.14608, -8.273185, 12.630748], [-2.437989, -8.265193, 12.665976], [-2.726799, -8.255956, 12.704672], [-3.012506, -8.245409, 12.746695], [-3.295102, -8.233488, 12.7919], [-3.574582, -8.220127, 12.840146], [-3.850939, -8.205264, 12.89129], [-4.124169, -8.188834, 12.945189], [-4.394264, -8.170771, 13.001701], [-4.661219, -8.151013, 13.060684], [-4.925028, -8.129494, 13.121995], [-5.185684, -8.10615, 13.185492], [-5.443182, -8.080917, 13.251031], [-5.697515, -8.05373, 13.318471], [-5.948678, -8.024525, 13.387668], [-6.196665, -7.993239, 13.458481], [-6.441469, -7.959805, 13.530767], [-6.683085, -7.92416, 13.604382], [-6.921506, -7.88624, 13.679186], [-7.156726, -7.845981, 13.755035], [-7.38874, -7.803317, 13.831786], [-7.617542, -7.758185, 13.909298], [-7.843125, -7.710519, 13.987427], [-8.065483, -7.660257, 14.066032], [-8.284611, -7.607333, 14.144969], [-8.500502, -7.551683, 14.224096], [-8.71315, -7.493243, 14.30327], [-8.92255, -7.431949, 14.38235], [-9.128694, -7.367735, 14.461191], [-9.331578, -7.300538, 14.539653], [-9.531196, -7.230293, 14.617593], [-9.72754, -7.156936, 14.694867], [-9.920606, -7.080402, 14.771333], [-10.110387, -7.000628, 14.846849], [-10.296877, -6.917549, 14.921273], [-10.48007, -6.8311, 14.994461], [-10.65996, -6.741217, 15.066272], [-10.836541, -6.647836, 15.136562], [-11.009808, -6.550892, 15.205189], [-11.179753, -6.450321, 15.272011], [-11.346371, -6.346059, 15.336885], [-11.509656, -6.238042, 15.399669], [-11.669603, -6.126204, 15.46022], [-11.826208, -6.010507, 15.518427], [-11.979491, -5.891013, 15.574306], [-12.129473, -5.767809, 15.627905], [-12.276177, -5.640983, 15.67927], [-12.419623, -5.510622, 15.72845], [-12.559836, -5.376814, 15.775493], [-12.696835, -5.239645, 15.820444], [-12.830645, -5.099204, 15.863353], [-12.961286, -4.955578, 15.904267], [-13.088781, -4.808854, 15.943233], [-13.213153, -4.659119, 15.980298], [-13.334422, -4.506461, 16.01551], [-13.452612, -4.350967, 16.048917], [-13.567744, -4.192725, 16.080567], [-13.679841, -4.031823, 16.110505], [-13.788924, -3.868346, 16.138781], [-13.895016, -3.702384, 16.165442], [-13.998139, -3.534022, 16.190535], [-14.098315, -3.363349, 16.214108], [-14.195566, -3.190453, 16.236208], [-14.289914, -3.01542, 16.256882], [-14.381381, -2.838337, 16.276179], [-14.46999, -2.659293, 16.294145], [-14.555762, -2.478374, 16.310829], [-14.63872, -2.295669, 16.326277], [-14.718886, -2.111263, 16.340538], [-14.796281, -1.925246, 16.353659], [-14.870929, -1.737704, 16.365687], [-14.94285, -1.548724, 16.376669], [-15.012068, -1.358394, 16.386654], [-15.078604, -1.166802, 16.395689], [-15.142481, -0.974034, 16.403821], [-15.20372, -0.780178, 16.411098], [-15.262344, -0.585322, 16.417567], [-15.318374, -0.389553, 16.423276], [-15.371833, -0.192959, 16.428272], [-15.422744, 0.004374, 16.432604], [-15.471127, 0.202358, 16.436317], [-15.517006, 0.400906, 16.439461], [-15.560402, 0.599929, 16.442082], [-15.601337, 0.799342, 16.444228], [-15.639834, 0.999055, 16.445946], [-15.675915, 1.198983, 16.447284], [-15.709601, 1.399037, 16.44829], [-15.740915, 1.59913, 16.44901], [-15.769879, 1.799175, 16.449493], [-15.796516, 1.999085, 16.449786], [-15.820846, 2.198771, 16.449937], [-15.842893, 2.398147, 16.449992], [-15.862679, 2.597125, 16.45], [-15.880211, 2.795623, 16.45], [-15.895444, 2.993578, 16.45], [-15.908318, 3.190933, 16.45], [-15.918774, 3.38763, 16.45], [-15.926751, 3.583612, 16.45], [-15.932191, 3.778822, 16.45], [-15.935032, 3.973202, 16.45], [-15.935217, 4.166693, 16.45], [-15.932683, 4.35924, 16.45], [-15.927374, 4.550785, 16.45], [-15.919227, 4.741269, 16.45], [-15.908184, 4.930636, 16.45], [-15.894185, 5.118828, 16.45], [-15.87717, 5.305788, 16.45], [-15.85708, 5.491457, 16.45], [-15.833855, 5.675779, 16.45], [-15.807434, 5.858697, 16.45], [-15.777759, 6.040152, 16.45], [-15.74477, 6.220087, 16.45], [-15.708406, 6.398445, 16.45], [-15.668609, 6.575168, 16.45], [-15.625318, 6.750199, 16.45], [-15.578474, 6.92348, 16.45], [-15.528017, 7.094953, 16.45], [-15.473888, 7.264563, 16.45], [-15.416025, 7.432249, 16.45], [-15.354371, 7.597957, 16.45], [-15.288865, 7.761627, 16.45], [-15.219448, 7.923202, 16.45], [-15.146059, 8.082626, 16.45], [-15.068639, 8.23984, 16.45], [-14.987128, 8.394786, 16.45], [-14.901468, 8.547409, 16.45], [-14.811596, 8.697649, 16.45], [-14.717455, 8.84545, 16.45], [-14.618985, 8.990753, 16.45], [-14.516125, 9.133503, 16.45], [-14.408816, 9.27364, 16.45], [-14.296999, 9.411108, 16.45], [-14.180613, 9.545849, 16.45], [-14.059598, 9.677806, 16.45], [-13.933896, 9.806921, 16.45], [-13.803447, 9.933136, 16.45], [-13.66819, 10.056395, 16.45], [-13.528066, 10.176639, 16.45], [-13.383015, 10.293812, 16.45], [-13.232977, 10.407855, 16.45], [-13.077894, 10.518712, 16.45], [-12.917705, 10.626325, 16.45], [-12.75235, 10.730636, 16.45], [-12.581794, 10.831604, 16.45], [-12.406103, 10.929259, 16.45], [-12.225365, 11.023644, 16.45], [-12.039671, 11.114804, 16.45], [-11.84911, 11.202784, 16.45], [-11.653771, 11.287628, 16.45], [-11.453745, 11.369383, 16.45], [-11.24912, 11.448091, 16.45], [-11.039986, 11.523799, 16.45], [-10.826434, 11.596551, 16.45], [-10.608551, 11.666392, 16.45], [-10.386429, 11.733366, 16.45], [-10.160156, 11.797518, 16.45], [-9.929823, 11.858894, 16.45], [-9.695518, 11.917537, 16.45], [-9.457332, 11.973493, 16.45], [-9.215353, 12.026807, 16.45], [-8.969672, 12.077523, 16.45], [-8.720378, 12.125685, 16.45], [-8.46756, 12.17134, 16.45], [-8.211309, 12.214531, 16.45], [-7.951713, 12.255304, 16.45], [-7.688863, 12.293703, 16.45], [-7.422848, 12.329773, 16.45], [-7.153757, 12.363558, 16.45], [-6.88168, 12.395105, 16.45], [-6.606707, 12.424456, 16.45], [-6.328928, 12.451658, 16.45], [-6.048431, 12.476754, 16.45], [-5.765306, 12.499791, 16.45], [-5.479644, 12.520812, 16.45], [-5.191532, 12.539862, 16.45], [-4.901063, 12.556986, 16.45], [-4.608323, 12.572229, 16.45], [-4.313404, 12.585636, 16.45], [-4.016395, 12.597251, 16.45], [-3.717386, 12.60712, 16.45], [-3.416465, 12.615286, 16.45], [-3.113723, 12.621795, 16.45], [-2.809249, 12.626692, 16.45], [-2.503133, 12.630022, 16.45], [-2.195464, 12.631828, 16.45], [-1.886333, 12.632156, 16.45], [-1.575827, 12.631052, 16.45], [-1.264038, 12.628558, 16.45], [-0.951054, 12.624722, 16.45], [-0.636966, 12.619586, 16.45], [-0.321862, 12.613196, 16.45], [-0.005832, 12.605597, 16.45], [0.311033, 12.596833, 16.45], [0.628635, 12.586921, 16.45], [0.946834, 12.575762, 16.45], [1.265481, 12.56323, 16.45], [1.584427, 12.549198, 16.45], [1.903521, 12.533538, 16.45], [2.222616, 12.516124, 16.45], [2.541562, 12.496829, 16.45], [2.860209, 12.475525, 16.45], [3.178408, 12.452087, 16.45], [3.49601, 12.426387, 16.45], [3.812865, 12.398298, 16.45], [4.128825, 12.367694, 16.45], [4.44374, 12.334447, 16.45], [4.75746, 12.298431, 16.45], [5.069837, 12.259518, 16.45], [5.38072, 12.217582, 16.45], [5.689962, 12.172496, 16.45], [5.997411, 12.124133, 16.45], [6.30292, 12.072366, 16.45], [6.606339, 12.017068, 16.45], [6.907519, 11.958112, 16.45], [7.206309, 11.895372, 16.45], [7.502562, 11.82872, 16.45], [7.796127, 11.75803, 16.45], [8.086856, 11.683174, 16.45], [8.374599, 11.604026, 16.45], [8.659206, 11.520459, 16.45], [8.940529, 11.432346, 16.45], [9.218418, 11.33956, 16.45], [9.492725, 11.241974, 16.45], [9.763298, 11.139461, 16.45], [10.02999, 11.031895, 16.45], [10.292651, 10.919148, 16.45], [10.551132, 10.801093, 16.45], [10.805283, 10.677604, 16.45], [11.054956, 10.548554, 16.45], [11.3, 10.413816, 16.45], [11.540267, 10.273263, 16.45], [11.775607, 10.126768, 16.45], [12.005871, 9.974204, 16.45], [12.230909, 9.815444, 16.45], [12.450573, 9.650361, 16.45], [12.664713, 9.478829, 16.45], [12.87318, 9.30072, 16.45], [13.075824, 9.115908, 16.45], [13.272496, 8.924266, 16.45], [13.463047, 8.725666, 16.45], [13.647328, 8.519983, 16.45], [13.825189, 8.307088, 16.45], [13.996481, 8.086856, 16.45], [14.161091, 7.859226, 16.45], [14.31905, 7.624407, 16.45], [14.470424, 7.382676, 16.45], [14.615282, 7.134309, 16.45], [14.753691, 6.879582, 16.45], [14.885717, 6.61877, 16.45], [15.011428, 6.352152, 16.45], [15.13089, 6.080002, 16.45], [15.244172, 5.802596, 16.45], [15.351341, 5.520212, 16.45], [15.452462, 5.233125, 16.45], [15.547605, 4.941611, 16.45], [15.636835, 4.645947, 16.45], [15.720221, 4.346409, 16.45], [15.797828, 4.043272, 16.45], [15.869725, 3.736814, 16.45], [15.935979, 3.42731, 16.45], [15.996657, 3.115037, 16.45], [16.051825, 2.80027, 16.45], [16.101552, 2.483287, 16.45], [16.145904, 2.164362, 16.45], [16.184949, 1.843773, 16.45], [16.218753, 1.521796, 16.45], [16.247384, 1.198706, 16.45], [16.270909, 0.87478, 16.45], [16.289396, 0.550294, 16.45], [16.302911, 0.225525, 16.45], [16.311522, -0.099252, 16.45], [16.315295, -0.42376, 16.45], [16.314298, -0.747723, 16.45], [16.308599, -1.070865, 16.45], [16.298264, -1.39291, 16.45], [16.283361, -1.713581, 16.45], [16.263956, -2.032603, 16.45], [16.240117, -2.349698, 16.45], [16.211911, -2.664592, 16.45], [16.179406, -2.977007, 16.45], [16.142668, -3.286667, 16.45], [16.101765, -3.593297, 16.45], [16.056763, -3.89662, 16.45], [16.007731, -4.19636, 16.45], [15.954734, -4.492241, 16.45], [15.897842, -4.783986, 16.45], [15.837119, -5.07132, 16.45], [15.772635, -5.353965, 16.45], [15.704455, -5.631647, 16.45], [15.632647, -5.904088, 16.45], [15.557279, -6.171012, 16.45], [15.478417, -6.432145, 16.45], [15.396129, -6.687208, 16.45], [15.310482, -6.935973, 16.450002], [15.221546, -7.178398, 16.450014], [15.12939, -7.41449, 16.450048], [15.034083, -7.644254, 16.450113], [14.935695, -7.867695, 16.450221], [14.834296, -8.084819, 16.450382], [14.729956, -8.295631, 16.450607], [14.622744, -8.500138, 16.450906], [14.512729, -8.698345, 16.45129], [14.399981, -8.890257, 16.45177], [14.28457, -9.075881, 16.452356], [14.166566, -9.255221, 16.453059], [14.046037, -9.428283, 16.453889], [13.923054, -9.595074, 16.454857], [13.797686, -9.755598, 16.455974], [13.670003, -9.909861, 16.45725], [13.540074, -10.05787, 16.458696], [13.407969, -10.199628, 16.460323], [13.273758, -10.335143, 16.46214], [13.137509, -10.46442, 16.46416], [12.999293, -10.587463, 16.466392], [12.85918, -10.70428, 16.468847], [12.717238, -10.814875, 16.471536], [12.573538, -10.919255, 16.474468], [12.428149, -11.017424, 16.477656], [12.281141, -11.109389, 16.48111], [12.132582, -11.195154, 16.484839], [11.982544, -11.274727, 16.488855], [11.831095, -11.348111, 16.493169], [11.678305, -11.415314, 16.49779], [11.524243, -11.47634, 16.50273], [11.36898, -11.531195, 16.507999], [11.212584, -11.579885, 16.513608], [11.055126, -11.622416, 16.519568], [10.896675, -11.658792, 16.525889], [10.737301, -11.68902, 16.532581], [10.577072, -11.713105, 16.539656], [10.416059, -11.731053, 16.547123], [10.254332, -11.74287, 16.554995], [10.091959, -11.74856, 16.56328], [9.929011, -11.748131, 16.57199], [9.765557, -11.741587, 16.581136], [9.601667, -11.728933, 16.590727], [9.43741, -11.710176, 16.600776], [9.272856, -11.685322, 16.611291], [9.108075, -11.654375, 16.622285], [8.943135, -11.617342, 16.633767], [8.778107, -11.574227, 16.645748], [8.61306, -11.525038, 16.658239], [8.448065, -11.469779, 16.67125], [8.283144, -11.408502, 16.684785], [8.118139, -11.341451, 16.69882], [7.952847, -11.268915, 16.713321], [7.787063, -11.191182, 16.728258], [7.620583, -11.108541, 16.743599], [7.453203, -11.021282, 16.759311], [7.284719, -10.929695, 16.775363], [7.114927, -10.834068, 16.791723], [6.943624, -10.73469, 16.80836], [6.770604, -10.631851, 16.82524], [6.595664, -10.52584, 16.842333], [6.418599, -10.416946, 16.859606], [6.239207, -10.305458, 16.877028], [6.057282, -10.191666, 16.894567], [5.872621, -10.075858, 16.912191], [5.685019, -9.958324, 16.929868], [5.494273, -9.839354, 16.947566], [5.300178, -9.719235, 16.965254], [5.10253, -9.598258, 16.982899], [4.901126, -9.476712, 17.00047], [4.695761, -9.354886, 17.017935], [4.486231, -9.233068, 17.035261], [4.272332, -9.111549, 17.052418], [4.053861, -8.990618, 17.069373], [3.830612, -8.870563, 17.086094], [3.602383, -8.751673, 17.102549], [3.368968, -8.634239, 17.118708], [3.130164, -8.518549, 17.134537], [2.885767, -8.404893, 17.150005], [2.635572, -8.293559, 17.16508], [2.379376, -8.184837, 17.17973], [2.116975, -8.079016, 17.193924], [1.848164, -7.976385, 17.207629], [1.57274, -7.877234, 17.220814], [1.290498, -7.781851, 17.233446], [1.001235, -7.690527, 17.245495], [0.704746, -7.603549, 17.256927], [0.400827, -7.521207, 17.267712], [0.089274, -7.443791, 17.277817], [-0.230117, -7.371589, 17.28721], [-0.557549, -7.304892, 17.29586], [-0.893228, -7.243987, 17.303735], [-1.237357, -7.189164, 17.310802], [-1.590139, -7.140713, 17.317031], [-1.95178, -7.098922, 17.322389], [-2.322484, -7.064081, 17.326844], [-2.702453, -7.03648, 17.330364], [-3.091893, -7.016406, 17.332918], [-3.491007, -7.00415, 17.334474], [-3.9, -7.0, 17.335]];
cable_1 = [[10.3, 2.2, 12.49088], [10.299268, 2.486236, 12.492163], [10.297003, 2.768937, 12.495958], [10.293102, 3.048095, 12.502189], [10.287463, 3.323699, 12.510778], [10.279982, 3.59574, 12.521647], [10.270558, 3.864209, 12.534719], [10.259086, 4.129096, 12.549915], [10.245464, 4.390392, 12.567157], [10.22959, 4.648088, 12.586369], [10.21136, 4.902173, 12.607472], [10.190672, 5.152639, 12.630389], [10.167422, 5.399476, 12.655042], [10.141509, 5.642674, 12.681353], [10.112829, 5.882225, 12.709245], [10.081279, 6.118118, 12.738639], [10.046756, 6.350345, 12.769458], [10.009159, 6.578895, 12.801625], [9.968383, 6.803759, 12.835061], [9.924326, 7.024929, 12.869689], [9.876885, 7.242394, 12.905431], [9.825958, 7.456144, 12.942209], [9.771441, 7.666172, 12.979947], [9.713231, 7.872466, 13.018565], [9.651227, 8.075018, 13.057986], [9.585325, 8.273819, 13.098132], [9.515421, 8.468858, 13.138927], [9.441414, 8.660126, 13.180291], [9.363201, 8.847614, 13.222148], [9.280678, 9.031313, 13.264419], [9.193743, 9.211212, 13.307027], [9.102293, 9.387303, 13.349895], [9.006226, 9.559577, 13.392943], [8.905437, 9.728022, 13.436095], [8.799825, 9.892631, 13.479273], [8.689287, 10.053393, 13.5224], [8.57372, 10.2103, 13.565396], [8.45302, 10.363342, 13.608186], [8.327086, 10.512509, 13.65069], [8.195814, 10.657792, 13.692832], [8.059102, 10.799181, 13.734533], [7.916847, 10.936667, 13.775716], [7.768945, 11.070241, 13.816303], [7.615294, 11.199893, 13.856217], [7.455792, 11.325614, 13.895379], [7.290334, 11.447393, 13.933712], [7.11882, 11.565223, 13.971138], [6.941145, 11.679093, 14.00758], [6.757207, 11.788994, 14.042959], [6.566903, 11.894916, 14.077198], [6.37013, 11.99685, 14.11022], [6.166839, 12.094787, 14.141963], [5.957195, 12.188719, 14.172437], [5.741418, 12.278639, 14.201667], [5.519725, 12.364538, 14.22968], [5.292336, 12.446411, 14.2565], [5.05947, 12.524248, 14.282155], [4.821346, 12.598043, 14.30667], [4.578182, 12.667788, 14.33007], [4.330197, 12.733475, 14.352383], [4.077611, 12.795098, 14.373633], [3.820642, 12.852648, 14.393846], [3.559508, 12.906118, 14.41305], [3.29443, 12.955501, 14.431268], [3.025625, 13.00079, 14.448528], [2.753313, 13.041975, 14.464855], [2.477712, 13.079051, 14.480276], [2.199042, 13.11201, 14.494815], [1.917521, 13.140844, 14.5085], [1.633368, 13.165545, 14.521355], [1.346801, 13.186107, 14.533408], [1.058041, 13.202522, 14.544682], [0.767305, 13.214781, 14.555206], [0.474813, 13.222879, 14.565004], [0.180783, 13.226806, 14.574103], [-0.114565, 13.226557, 14.582528], [-0.411013, 13.222123, 14.590305], [-0.708342, 13.213496, 14.59746], [-1.006334, 13.20067, 14.604019], [-1.304768, 13.183636, 14.610009], [-1.603427, 13.162388, 14.615454], [-1.902091, 13.136918, 14.620381], [-2.200542, 13.107218, 14.624816], [-2.49856, 13.073281, 14.628784], [-2.795928, 13.035099, 14.632312], [-3.092425, 12.992665, 14.635426], [-3.387834, 12.945971, 14.638151], [-3.681934, 12.895011, 14.640513], [-3.974508, 12.839775, 14.642538], [-4.265337, 12.780258, 14.644252], [-4.554201, 12.716451, 14.645682], [-4.840882, 12.648347, 14.646852], [-5.125161, 12.575938, 14.647789], [-5.406818, 12.499217, 14.648519], [-5.685636, 12.418177, 14.649067], [-5.961395, 12.332809, 14.64946], [-6.233877, 12.243107, 14.649724], [-6.502862, 12.149063, 14.649883], [-6.768131, 12.05067, 14.649965], [-7.029467, 11.94792, 14.649996], [-7.286649, 11.840805, 14.65], [-7.539501, 11.729329, 14.65], [-7.788009, 11.613539, 14.65], [-8.032204, 11.493494, 14.65], [-8.272115, 11.369251, 14.65], [-8.50777, 11.24087, 14.65], [-8.739199, 11.108409, 14.65], [-8.96643, 10.971925, 14.65], [-9.189494, 10.831477, 14.65], [-9.408419, 10.687124, 14.65], [-9.623234, 10.538923, 14.65], [-9.833969, 10.386933, 14.65], [-10.040652, 10.231213, 14.65], [-10.243314, 10.07182, 14.65], [-10.441982, 9.908813, 14.65], [-10.636686, 9.74225, 14.65], [-10.827455, 9.572189, 14.65], [-11.014319, 9.398689, 14.65], [-11.197306, 9.221808, 14.65], [-11.376446, 9.041604, 14.65], [-11.551767, 8.858136, 14.65], [-11.7233, 8.671462, 14.65], [-11.891073, 8.48164, 14.65], [-12.055115, 8.288728, 14.65], [-12.215455, 8.092785, 14.65], [-12.372123, 7.89387, 14.65], [-12.525147, 7.692039, 14.65], [-12.674557, 7.487352, 14.65], [-12.820383, 7.279867, 14.65], [-12.962652, 7.069643, 14.65], [-13.101395, 6.856737, 14.65], [-13.23664, 6.641207, 14.65], [-13.368416, 6.423113, 14.65], [-13.496754, 6.202512, 14.65], [-13.621681, 5.979463, 14.65], [-13.743227, 5.754024, 14.65], [-13.861421, 5.526253, 14.65], [-13.976293, 5.296208, 14.65], [-14.087871, 5.063949, 14.65], [-14.196185, 4.829533, 14.65], [-14.301263, 4.593018, 14.65], [-14.403135, 4.354463, 14.65], [-14.50183, 4.113925, 14.65], [-14.597378, 3.871465, 14.65], [-14.689807, 3.627138, 14.65], [-14.779146, 3.381005, 14.65], [-14.865424, 3.133123, 14.65], [-14.948672, 2.88355, 14.65], [-15.028917, 2.632346, 14.65], [-15.10619, 2.379567, 14.65], [-15.180519, 2.125273, 14.65], [-15.251916, 1.869534, 14.65], [-15.320325, 1.612477, 14.65], [-15.385674, 1.354239, 14.65], [-15.44789, 1.09496, 14.65], [-15.5069, 0.834777, 14.65], [-15.56263, 0.573828, 14.65], [-15.615009, 0.312254, 14.65], [-15.663963, 0.05019, 14.65], [-15.70942, -0.212222, 14.65], [-15.751306, -0.474847, 14.65], [-15.789549, -0.737544, 14.65], [-15.824075, -1.000175, 14.65], [-15.854813, -1.262603, 14.65], [-15.881689, -1.524688, 14.65], [-15.904629, -1.786292, 14.65], [-15.923563, -2.047276, 14.65], [-15.938415, -2.307503, 14.65], [-15.949114, -2.566834, 14.65], [-15.955587, -2.82513, 14.65], [-15.957761, -3.082253, 14.65], [-15.955563, -3.338064, 14.65], [-15.94892, -3.592425, 14.65], [-15.937759, -3.845197, 14.65], [-15.922008, -4.096243, 14.65], [-15.901593, -4.345423, 14.65], [-15.876442, -4.5926, 14.65], [-15.846482, -4.837634, 14.65], [-15.81164, -5.080388, 14.65], [-15.771842, -5.320722, 14.65], [-15.727017, -5.558499, 14.65], [-15.677092, -5.793579, 14.65], [-15.621992, -6.025826, 14.65], [-15.561647, -6.255099, 14.65], [-15.495982, -6.48126, 14.65], [-15.424925, -6.704172, 14.65], [-15.348403, -6.923696, 14.65], [-15.266343, -7.139693, 14.65], [-15.178673, -7.352025, 14.65], [-15.085319, -7.560553, 14.65], [-14.986208, -7.765139, 14.65], [-14.881268, -7.965644, 14.65], [-14.770426, -8.161931, 14.65], [-14.653609, -8.35386, 14.65], [-14.530744, -8.541293, 14.65], [-14.401758, -8.724092, 14.65], [-14.266579, -8.902118, 14.65], [-14.125133, -9.075233, 14.65], [-13.977347, -9.243299, 14.65], [-13.82315, -9.406176, 14.65], [-13.662467, -9.563727, 14.65], [-13.495262, -9.715848, 14.65], [-13.321646, -9.862576, 14.65], [-13.141763, -10.003986, 14.65], [-12.955759, -10.140149, 14.65], [-12.76378, -10.271139, 14.65], [-12.565972, -10.397028, 14.65], [-12.36248, -10.517889, 14.65], [-12.15345, -10.633795, 14.65], [-11.939029, -10.74482, 14.65], [-11.71936, -10.851035, 14.65], [-11.494592, -10.952513, 14.65], [-11.264868, -11.049329, 14.65], [-11.030335, -11.141553, 14.65], [-10.791138, -11.22926, 14.65], [-10.547424, -11.312522, 14.65], [-10.299338, -11.391413, 14.65], [-10.047026, -11.466004, 14.65], [-9.790633, -11.536368, 14.65], [-9.530305, -11.60258, 14.65], [-9.266189, -11.664711, 14.65], [-8.998429, -11.722834, 14.65], [-8.727171, -11.777022, 14.65], [-8.452561, -11.827349, 14.65], [-8.174746, -11.873886, 14.65], [-7.89387, -11.916707, 14.65], [-7.610079, -11.955885, 14.65], [-7.323519, -11.991492, 14.65], [-7.034337, -12.023602, 14.65], [-6.742676, -12.052287, 14.65], [-6.448684, -12.077621, 14.65], [-6.152506, -12.099675, 14.65], [-5.854288, -12.118523, 14.65], [-5.554175, -12.134238, 14.65], [-5.252314, -12.146892, 14.65], [-4.948849, -12.156559, 14.65], [-4.643927, -12.163312, 14.65], [-4.337694, -12.167222, 14.65], [-4.030294, -12.168364, 14.65], [-3.721875, -12.166809, 14.65], [-3.412581, -12.162632, 14.65], [-3.102558, -12.155904, 14.65], [-2.791952, -12.146698, 14.65], [-2.48091, -12.135088, 14.65], [-2.169575, -12.121146, 14.65], [-1.858095, -12.104946, 14.65], [-1.546616, -12.086559, 14.65], [-1.235281, -12.066059, 14.65], [-0.924239, -12.043519, 14.65], [-0.613633, -12.019012, 14.65], [-0.30361, -11.99261, 14.65], [0.005686, -11.96437, 14.65], [0.314123, -11.934287, 14.65], [0.621568, -11.902339, 14.65], [0.927892, -11.868504, 14.65], [1.232962, -11.832759, 14.65], [1.536647, -11.795083, 14.65], [1.838817, -11.755455, 14.65], [2.139341, -11.713852, 14.65], [2.438086, -11.670252, 14.65], [2.734922, -11.624634, 14.65], [3.029718, -11.576976, 14.65], [3.322343, -11.527255, 14.65], [3.612665, -11.475451, 14.65], [3.900553, -11.42154, 14.65], [4.185876, -11.365502, 14.65], [4.468503, -11.307315, 14.65], [4.748303, -11.246956, 14.65], [5.025145, -11.184404, 14.65], [5.298897, -11.119636, 14.65], [5.569429, -11.052632, 14.65], [5.836608, -10.983369, 14.65], [6.100305, -10.911825, 14.65], [6.360387, -10.837978, 14.65], [6.616724, -10.761807, 14.65], [6.869185, -10.68329, 14.65], [7.117638, -10.602405, 14.65], [7.361952, -10.519129, 14.65], [7.601996, -10.433442, 14.65], [7.837639, -10.345321, 14.65], [8.068749, -10.254744, 14.65], [8.295196, -10.16169, 14.65], [8.516849, -10.066136, 14.65], [8.733576, -9.968062, 14.65], [8.945246, -9.867444, 14.65], [9.151727, -9.764261, 14.65], [9.35289, -9.658492, 14.65], [9.548602, -9.550114, 14.65], [9.738733, -9.439106, 14.65], [9.92315, -9.325445, 14.65], [10.101724, -9.20911, 14.65], [10.274323, -9.090079, 14.65], [10.440816, -8.96833, 14.65], [10.601071, -8.843841, 14.65], [10.754958, -8.716591, 14.65], [10.902345, -8.586557, 14.65], [11.043101, -8.453717, 14.65], [11.177095, -8.318051, 14.65], [11.304196, -8.179535, 14.65], [11.424273, -8.038149, 14.65], [11.537194, -7.89387, 14.65], [11.642858, -7.746707, 14.650005], [11.741279, -7.596798, 14.650043], [11.8325, -7.444309, 14.650145], [11.916566, -7.289408, 14.650344], [11.993521, -7.132263, 14.650671], [12.063407, -6.973041, 14.65116], [12.126269, -6.81191, 14.651842], [12.18215, -6.649038, 14.652749], [12.231094, -6.484592, 14.653915], [12.273146, -6.318739, 14.65537], [12.308348, -6.151648, 14.657147], [12.336744, -5.983485, 14.659279], [12.358378, -5.814419, 14.661798], [12.373293, -5.644617, 14.664735], [12.381535, -5.474247, 14.668124], [12.383145, -5.303476, 14.671996], [12.378168, -5.132471, 14.676383], [12.366648, -4.961402, 14.681318], [12.348628, -4.790434, 14.686833], [12.324152, -4.619735, 14.69296], [12.293264, -4.449474, 14.699732], [12.256008, -4.279818, 14.70718], [12.212426, -4.110934, 14.715337], [12.162564, -3.94299, 14.724235], [12.106464, -3.776154, 14.733906], [12.04417, -3.610593, 14.744383], [11.975727, -3.446474, 14.755698], [11.901177, -3.283966, 14.767882], [11.820565, -3.123236, 14.780969], [11.733934, -2.964452, 14.79499], [11.641328, -2.80778, 14.809978], [11.54279, -2.653389, 14.825964], [11.438365, -2.501447, 14.842982], [11.328096, -2.352121, 14.861062], [11.212027, -2.205578, 14.880239], [11.090202, -2.061986, 14.900543], [10.962664, -1.921512, 14.922007], [10.829457, -1.784325, 14.944663], [10.690624, -1.650592, 14.968543], [10.54621, -1.520481, 14.99368], [10.396258, -1.394158, 15.020106], [10.240812, -1.271792, 15.047853], [10.079915, -1.153551, 15.076953], [9.913612, -1.039601, 15.107438], [9.741946, -0.93011, 15.139341], [9.564961, -0.825247, 15.172694], [9.3827, -0.725178, 15.20753], [9.195207, -0.630072, 15.243879], [9.002526, -0.540095, 15.281775], [8.804701, -0.455416, 15.32125], [8.601828, -0.376105, 15.362314], [8.39422, -0.301853, 15.404893], [8.182239, -0.23225, 15.44889], [7.96625, -0.16689, 15.494207], [7.746619, -0.105366, 15.540749], [7.523708, -0.047269, 15.588418], [7.297883, 0.007807, 15.637119], [7.069507, 0.06027, 15.686754], [6.838945, 0.110527, 15.737226], [6.606562, 0.158986, 15.78844], [6.372721, 0.206055, 15.840298], [6.137787, 0.25214, 15.892704], [5.902125, 0.297649, 15.945561], [5.666098, 0.34299, 15.998772], [5.430072, 0.388569, 16.052241], [5.194409, 0.434795, 16.105871], [4.959475, 0.482074, 16.159566], [4.725635, 0.530815, 16.213228], [4.493251, 0.581424, 16.266762], [4.26269, 0.634309, 16.32007], [4.034314, 0.689878, 16.373056], [3.808489, 0.748537, 16.425623], [3.585578, 0.810695, 16.477674], [3.365946, 0.876758, 16.529113], [3.149958, 0.947135, 16.579844], [2.937977, 1.022232, 16.629769], [2.730368, 1.102456, 16.678791], [2.527496, 1.188217, 16.726815], [2.329724, 1.27992, 16.773744], [2.137417, 1.377973, 16.81948], [1.95094, 1.482784, 16.863927], [1.770656, 1.594759, 16.90699], [1.59693, 1.714307, 16.948569], [1.430126, 1.841836, 16.988571], [1.270609, 1.977751, 17.026896], [1.118744, 2.122461, 17.06345], [0.974893, 2.276373, 17.098135], [0.839422, 2.439895, 17.130854], [0.712695, 2.613433, 17.161511], [0.595076, 2.797396, 17.19001], [0.48693, 2.992191, 17.216253], [0.388621, 3.198225, 17.240144], [0.300514, 3.415906, 17.261587], [0.222971, 3.645641, 17.280484], [0.156359, 3.887837, 17.296739], [0.101042, 4.142902, 17.310255], [0.057382, 4.411244, 17.320936], [0.025746, 4.693269, 17.328685], [0.006497, 4.989385, 17.333405], [0.0, 5.3, 17.335]];
cable_paths = [cable_0,cable_1];
cable_clips = [[[-15.862947050486092, 2.6, 16.45], [-0.09294024854429697, 0.9956716879576943, 0.0], [-17.31294705048609, 1.9, 15.299999999999999], [-14.412947050486093, 3.3, 18.1], 1.8, 1.0], [[16.08390217946675, 2.6, 16.45], [0.15235381225117434, -0.9883260170068042, 0.0], [14.633902179466752, 1.9, 15.299999999999999], [17.53390217946675, 3.3, 18.1], 1.8, 1.0], [[-15.038993942870865, 2.6, 14.650000000000002], [-0.29649622436932277, -0.9550340250141542, 0.0], [-16.488993942870867, 1.9, 13.500000000000002], [-13.588993942870866, 3.3, 18.1], 1.8, 1.0], [[0.7219456750509492, 2.6, 17.159271894358355], [-0.5618899294576891, 0.8159508739737836, 0.13602896175245832], [-0.7280543249490508, 1.9, 16.009271894358356], [2.1719456750509494, 3.3, 18.1], 1.8, 1.0]];
