gokselozgur5/pcb-design-collar-tracker/firmware/evidence/factory-r01/positive-build.txt

-- west build: generating a build system
Loading Zephyr default modules (Zephyr base).
-- Application: /Users/gok/codex/projects/collar-tracker/firmware/factory
-- CMake version: 4.1.2
-- Found Python3: /Volumes/GOKSSD/codex/toolchains/collar-ncs-3.4.1/venv/bin/python (found suitable version "3.12.13", minimum required is "3.12") found components: Interpreter
-- Cache files will be written to: /Volumes/GOKSSD/codex/toolchains/collar-ncs-3.4.1/cache/zephyr
-- Zephyr version: 4.4.2 (/Volumes/GOKSSD/codex/toolchains/collar-ncs-3.4.1/zephyr)
-- Found west (found suitable version "1.5.0", minimum required is "0.14.0")
-- Board: collar_r05l, qualifiers: nrf9151
-- Found host-tools: zephyr 1.0.1 (/Volumes/GOKSSD/codex/toolchains/collar-ncs-3.4.1/zephyr-sdk-1.0.1)
-- Found toolchain: zephyr 1.0.1 (/Volumes/GOKSSD/codex/toolchains/collar-ncs-3.4.1/zephyr-sdk-1.0.1)
-- Could NOT find Dtc (missing: DTC) (Required is at least version "1.4.6")
Hint: The project() command has not yet been called.  It sets up system-specific search paths.
-- Found BOARD.dts: /Users/gok/codex/projects/collar-tracker/firmware/boards/goksel/collar_r05l/collar_r05l_nrf9151.dts
-- Generated zephyr.dts: /Volumes/GOKSSD/codex/toolchains/collar-ncs-3.4.1/build-factory-final/zephyr/zephyr.dts
-- Generated pickled edt: /Volumes/GOKSSD/codex/toolchains/collar-ncs-3.4.1/build-factory-final/zephyr/edt.pickle
-- Generated devicetree_generated.h: /Volumes/GOKSSD/codex/toolchains/collar-ncs-3.4.1/build-factory-final/zephyr/include/generated/zephyr/devicetree_generated.h
Parsing /Volumes/GOKSSD/codex/toolchains/collar-ncs-3.4.1/zephyr/Kconfig
Loaded configuration '/Users/gok/codex/projects/collar-tracker/firmware/boards/goksel/collar_r05l/collar_r05l_nrf9151_defconfig'
Merged configuration '/Users/gok/codex/projects/collar-tracker/firmware/factory/prj.conf'
Configuration saved to '/Volumes/GOKSSD/codex/toolchains/collar-ncs-3.4.1/build-factory-final/zephyr/.config'
Kconfig header saved to '/Volumes/GOKSSD/codex/toolchains/collar-ncs-3.4.1/build-factory-final/zephyr/include/generated/zephyr/autoconf.h'
-- Found GnuLd: /Volumes/GOKSSD/codex/toolchains/collar-ncs-3.4.1/zephyr-sdk-1.0.1/gnu/arm-zephyr-eabi/arm-zephyr-eabi/bin/ld.bfd (found version "2.43.1")
-- The C compiler identification is GNU 14.3.0
-- The CXX compiler identification is GNU 14.3.0
-- The ASM compiler identification is GNU
-- Found assembler: /Volumes/GOKSSD/codex/toolchains/collar-ncs-3.4.1/zephyr-sdk-1.0.1/gnu/arm-zephyr-eabi/bin/arm-zephyr-eabi-gcc
-- Found gen_kobject_list: /Volumes/GOKSSD/codex/toolchains/collar-ncs-3.4.1/zephyr/scripts/build/gen_kobject_list.py
CMake Warning at /Volumes/GOKSSD/codex/toolchains/collar-ncs-3.4.1/zephyr/CMakeLists.txt:2358 (message):
  __ASSERT() statements are globally ENABLED

-- Configuring done (6.2s)
-- Generating done (0.3s)
-- Build files have been written to: /Volumes/GOKSSD/codex/toolchains/collar-ncs-3.4.1/build-factory-final
-- west build: building application
[1/184] Preparing syscall dependency handling

[2/184] Generating ../../zephyr/include/generated/ncs_commit.h
[3/184] Generating ../../zephyr/include/generated/zephyr_commit.h
[4/184] Generating ../../zephyr/include/generated/ncs_version.h
[5/184] Generating misc/generated/syscalls_subdirs.trigger
[6/184] Generating include/generated/zephyr/version.h
-- Zephyr version: 4.4.2 (/Volumes/GOKSSD/codex/toolchains/collar-ncs-3.4.1/zephyr), build: 33fa6a7aac6a
[7/184] Generating misc/generated/syscalls.json, misc/generated/struct_tags.json
[8/184] Generating include/generated/device-api-sections.ld, include/generated/device-api-sections.cmake
[9/184] Generating include/generated/zephyr/syscall_dispatch.c, include/generated/zephyr/syscall_exports_llext.c, syscall_weakdefs_llext.c, include/generated/zephyr/syscall_list.h
[10/184] Generating include/generated/zephyr/driver-validation.h
[11/184] Generating include/generated/zephyr/kobj-types-enum.h, include/generated/zephyr/otype-to-str.h, include/generated/zephyr/otype-to-size.h
[12/184] Building C object zephyr/lib/heap/CMakeFiles/heap_constants.dir/heap_constants.c.obj
[13/184] Generating ../../include/generated/zephyr/heap_constants.h
[14/184] Building C object zephyr/CMakeFiles/offsets.dir/arch/arm/core/offsets/offsets.c.obj
[15/184] Generating include/generated/zephyr/offsets.h
[16/184] Building C object zephyr/CMakeFiles/zephyr.dir/lib/libc/validate_libc.c.obj
[17/184] Building C object zephyr/arch/common/CMakeFiles/isr_tables.dir/isr_tables.c.obj
[18/184] Building C object zephyr/CMakeFiles/zephyr.dir/lib/os/thread_entry.c.obj
[19/184] Building C object zephyr/CMakeFiles/zephyr.dir/lib/os/printk.c.obj
[20/184] Building C object CMakeFiles/app.dir/src/main.c.obj
[21/184] Building C object zephyr/CMakeFiles/zephyr.dir/lib/os/clock.c.obj
[22/184] Building C object zephyr/CMakeFiles/zephyr.dir/lib/os/sem.c.obj
[23/184] Building C object zephyr/CMakeFiles/zephyr.dir/lib/os/cbprintf_packaged.c.obj
[24/184] Building C object zephyr/CMakeFiles/zephyr.dir/lib/os/cbprintf_complete.c.obj
[25/184] Building C object zephyr/CMakeFiles/zephyr.dir/lib/utils/dec.c.obj
[26/184] Building C object zephyr/CMakeFiles/zephyr.dir/lib/utils/set.c.obj
[27/184] Building C object zephyr/CMakeFiles/zephyr.dir/lib/utils/hex.c.obj
[28/184] Building C object zephyr/CMakeFiles/zephyr.dir/lib/utils/bitmask.c.obj
[29/184] Building C object zephyr/CMakeFiles/zephyr.dir/lib/heap/heap.c.obj
[30/184] Building C object zephyr/CMakeFiles/zephyr.dir/lib/os/assert.c.obj
[31/184] Building C object zephyr/CMakeFiles/zephyr.dir/lib/utils/last_section_id.c.obj
[32/184] Building C object zephyr/CMakeFiles/zephyr.dir/misc/generated/configs.c.obj
[33/184] Building C object zephyr/CMakeFiles/zephyr.dir/lib/utils/timeutil.c.obj
[34/184] Building C object zephyr/CMakeFiles/zephyr.dir/lib/utils/getopt/getopt_common.c.obj
[35/184] Building C object zephyr/CMakeFiles/zephyr.dir/lib/utils/notify.c.obj
[36/184] Building C object zephyr/CMakeFiles/zephyr.dir/lib/utils/ring_buffer.c.obj
[37/184] Building C object zephyr/CMakeFiles/zephyr.dir/lib/utils/getopt/getopt.c.obj
[38/184] Generating linker_zephyr_pre0.cmd
[39/184] Building C object zephyr/CMakeFiles/zephyr.dir/subsys/mem_mgmt/mem_attr.c.obj
[40/184] Building C object zephyr/CMakeFiles/zephyr.dir/Volumes/GOKSSD/codex/toolchains/collar-ncs-3.4.1/nrf/lib/boot_banner/banner.c.obj
[41/184] Building C object zephyr/CMakeFiles/zephyr.dir/subsys/tracing/tracing_none.c.obj
[42/184] Building C object zephyr/CMakeFiles/zephyr.dir/Volumes/GOKSSD/codex/toolchains/collar-ncs-3.4.1/nrfxlib/crypto/nrf_cc310_platform/src/nrf_cc3xx_platform_abort_zephyr.c.obj
[43/184] Building C object zephyr/CMakeFiles/zephyr.dir/lib/utils/rb.c.obj
[44/184] Building C object zephyr/CMakeFiles/zephyr.dir/Volumes/GOKSSD/codex/toolchains/collar-ncs-3.4.1/nrfxlib/crypto/nrf_cc310_platform/src/nrf_cc3xx_platform_mutex_zephyr.c.obj
[45/184] Linking C static library zephyr/arch/common/libisr_tables.a
[46/184] Building C object zephyr/arch/common/CMakeFiles/arch__common.dir/init.c.obj
[47/184] Building C object zephyr/arch/common/CMakeFiles/arch__common.dir/sw_isr_common.c.obj
[48/184] Building ASM object zephyr/arch/arch/arm/core/CMakeFiles/arch__arm__core.dir/nmi_on_reset.S.obj
[49/184] Building C object zephyr/CMakeFiles/zephyr.dir/lib/utils/onoff.c.obj
[50/184] Building ASM object zephyr/arch/arch/arm/core/cortex_m/CMakeFiles/arch__arm__core__cortex_m.dir/fault_s.S.obj
[51/184] Building C object zephyr/arch/common/CMakeFiles/arch__common.dir/xip.c.obj
[52/184] Building ASM object zephyr/arch/arch/arm/core/cortex_m/CMakeFiles/arch__arm__core__cortex_m.dir/reset.S.obj
[53/184] Building C object zephyr/arch/arch/arm/core/CMakeFiles/arch__arm__core.dir/fatal.c.obj
[54/184] Building C object zephyr/arch/arch/arm/core/CMakeFiles/arch__arm__core.dir/nmi.c.obj
[55/184] Building C object zephyr/arch/arch/arm/core/cortex_m/CMakeFiles/arch__arm__core__cortex_m.dir/fpu.c.obj
[56/184] Building C object zephyr/CMakeFiles/zephyr.dir/lib/utils/bitarray.c.obj
[57/184] Building ASM object zephyr/arch/arch/arm/core/cortex_m/CMakeFiles/arch__arm__core__cortex_m.dir/vector_table.S.obj
[58/184] Building C object zephyr/arch/arch/arm/core/CMakeFiles/arch__arm__core.dir/tls.c.obj
[59/184] Building ASM object zephyr/arch/arch/arm/core/cortex_m/CMakeFiles/arch__arm__core__cortex_m.dir/svc.S.obj
[60/184] Building C object zephyr/arch/arch/arm/core/cortex_m/CMakeFiles/arch__arm__core__cortex_m.dir/scb.c.obj
[61/184] Building ASM object zephyr/arch/arch/arm/core/cortex_m/CMakeFiles/arch__arm__core__cortex_m.dir/swap_helper.S.obj
[62/184] Building C object zephyr/arch/arch/arm/core/cortex_m/CMakeFiles/arch__arm__core__cortex_m.dir/exc_exit.c.obj
[63/184] Building C object zephyr/arch/arch/arm/core/cortex_m/CMakeFiles/arch__arm__core__cortex_m.dir/irq_manage.c.obj
[64/184] Building C object zephyr/arch/arch/arm/core/cortex_m/CMakeFiles/arch__arm__core__cortex_m.dir/fault.c.obj
[65/184] Building C object zephyr/arch/arch/arm/core/cortex_m/CMakeFiles/arch__arm__core__cortex_m.dir/prep_c.c.obj
[66/184] Building C object zephyr/arch/arch/arm/core/cortex_m/CMakeFiles/arch__arm__core__cortex_m.dir/thread_abort.c.obj
[67/184] Building C object zephyr/arch/arch/arm/core/cortex_m/CMakeFiles/arch__arm__core__cortex_m.dir/cpu_idle.c.obj
[68/184] Building C object zephyr/CMakeFiles/zephyr.dir/Volumes/GOKSSD/codex/toolchains/collar-ncs-3.4.1/modules/hal/st/sensor/stmemsc/lis2dw12_STdC/driver/lis2dw12_reg.c.obj
[69/184] Building C object zephyr/arch/arch/arm/core/cortex_m/CMakeFiles/arch__arm__core__cortex_m.dir/thread.c.obj
[70/184] Building C object zephyr/arch/arch/arm/core/cortex_m/CMakeFiles/arch__arm__core__cortex_m.dir/irq_init.c.obj
[71/184] Building ASM object zephyr/arch/arch/arm/core/cortex_m/CMakeFiles/arch__arm__core__cortex_m.dir/__aeabi_read_tp.S.obj
[72/184] Building C object zephyr/arch/arch/arm/core/cortex_m/CMakeFiles/arch__arm__core__cortex_m.dir/isr_wrapper.c.obj
[73/184] Building C object zephyr/arch/arch/arm/core/mpu/CMakeFiles/arch__arm__core__mpu.dir/arm_mpu_regions.c.obj
[74/184] Building C object zephyr/lib/libc/picolibc/CMakeFiles/lib__libc__picolibc.dir/assert.c.obj
[75/184] Building C object zephyr/arch/arch/arm/core/cortex_m/cmse/CMakeFiles/arch__arm__core__cortex_m__cmse.dir/arm_core_cmse.c.obj
[76/184] Building C object zephyr/lib/libc/picolibc/CMakeFiles/lib__libc__picolibc.dir/errno_wrap.c.obj
[77/184] Building C object zephyr/arch/arch/arm/core/mpu/CMakeFiles/arch__arm__core__mpu.dir/arm_core_mpu.c.obj
[78/184] Building C object zephyr/lib/libc/picolibc/CMakeFiles/lib__libc__picolibc.dir/chk_fail.c.obj
[79/184] Building C object zephyr/lib/libc/picolibc/CMakeFiles/lib__libc__picolibc.dir/cbprintf.c.obj
[80/184] Building C object zephyr/lib/libc/picolibc/CMakeFiles/lib__libc__picolibc.dir/exit.c.obj
[81/184] Building C object zephyr/arch/arch/arm/core/mpu/CMakeFiles/arch__arm__core__mpu.dir/arm_mpu.c.obj
[82/184] Building C object zephyr/lib/libc/common/CMakeFiles/lib__libc__common.dir/source/time/time.c.obj
[83/184] Building C object zephyr/lib/libc/picolibc/CMakeFiles/lib__libc__picolibc.dir/locks.c.obj
[84/184] Building C object zephyr/lib/posix/c_lib_ext/CMakeFiles/lib__posix__c_lib_ext.dir/fnmatch.c.obj
[85/184] Building C object zephyr/lib/libc/common/CMakeFiles/lib__libc__common.dir/source/stdlib/abort.c.obj
[86/184] Building C object zephyr/soc/soc/nrf9151/CMakeFiles/soc__nordic.dir/validate_binding_headers.c.obj
[87/184] Building C object zephyr/soc/soc/nrf9151/CMakeFiles/soc__nordic.dir/nrf91/soc.c.obj
[88/184] Building C object zephyr/lib/posix/c_lib_ext/CMakeFiles/lib__posix__c_lib_ext.dir/getentropy.c.obj
[89/184] Building C object zephyr/soc/soc/nrf9151/CMakeFiles/soc__nordic.dir/validate_base_addresses.c.obj
[90/184] Building C object zephyr/lib/libc/picolibc/CMakeFiles/lib__libc__picolibc.dir/stdio.c.obj
[91/184] Building C object zephyr/soc/soc/nrf9151/CMakeFiles/soc__nordic.dir/validate_enabled_instances.c.obj
[92/184] Building C object zephyr/lib/posix/c_lib_ext/CMakeFiles/lib__posix__c_lib_ext.dir/getopt_shim.c.obj
[93/184] Building C object zephyr/drivers/pinctrl/CMakeFiles/drivers__pinctrl.dir/common.c.obj
[94/184] Building C object zephyr/soc/soc/nrf9151/CMakeFiles/soc__nordic.dir/common/reboot.c.obj
[95/184] Building C object zephyr/lib/libc/common/CMakeFiles/lib__libc__common.dir/source/stdlib/malloc.c.obj
[96/184] Building C object zephyr/drivers/console/CMakeFiles/drivers__console.dir/rtt_console.c.obj
[97/184] Building C object zephyr/drivers/i2c/CMakeFiles/drivers__i2c.dir/i2c_common.c.obj
[98/184] Building C object zephyr/drivers/i2c/CMakeFiles/drivers__i2c.dir/i2c_nrfx_twim_common.c.obj
[99/184] Building C object zephyr/drivers/sensor/st/stmemsc/CMakeFiles/drivers__sensor__st__stmemsc.dir/stmemsc_mdelay.c.obj
[100/184] Building C object zephyr/drivers/i2c/CMakeFiles/drivers__i2c.dir/i2c_nrfx_twim.c.obj
[101/184] Building C object zephyr/drivers/timer/CMakeFiles/drivers__timer.dir/sys_clock_init.c.obj
[102/184] Building C object zephyr/drivers/sensor/st/stmemsc/CMakeFiles/drivers__sensor__st__stmemsc.dir/stmemsc_i2c.c.obj
[103/184] Building C object modules/hal_nordic/modules/hal_nordic/nrfx/CMakeFiles/nrfx.dir/Volumes/GOKSSD/codex/toolchains/collar-ncs-3.4.1/modules/hal/nordic/nrfx/bsp/stable/mdk/system_nrf91.c.obj
[104/184] Building C object zephyr/drivers/clock_control/CMakeFiles/drivers__clock_control.dir/clock_control_nrf.c.obj
[105/184] Building C object modules/nrf/drivers/hw_cc3xx/CMakeFiles/..__nrf__drivers__hw_cc3xx.dir/hw_cc3xx.c.obj
[106/184] Building C object zephyr/drivers/sensor/st/lis2dw12/CMakeFiles/drivers__sensor__st__lis2dw12.dir/lis2dw12.c.obj
[107/184] Building C object modules/hal_nordic/modules/hal_nordic/nrfx/CMakeFiles/nrfx.dir/nrfx_glue.c.obj
[108/184] Building C object modules/hal_nordic/modules/hal_nordic/nrfx/CMakeFiles/nrfx.dir/Volumes/GOKSSD/codex/toolchains/collar-ncs-3.4.1/modules/hal/nordic/nrfx/drivers/src/nrfx_clock_hfclkaudio.c.obj
[109/184] Building C object modules/hal_nordic/modules/hal_nordic/nrfx/CMakeFiles/nrfx.dir/Volumes/GOKSSD/codex/toolchains/collar-ncs-3.4.1/modules/hal/nordic/nrfx/helpers/nrfx_flag32_allocator.c.obj
[110/184] Building C object zephyr/drivers/pinctrl/CMakeFiles/drivers__pinctrl.dir/pinctrl_nrf.c.obj
[111/184] Building C object modules/hal_nordic/modules/hal_nordic/nrfx/CMakeFiles/nrfx.dir/Volumes/GOKSSD/codex/toolchains/collar-ncs-3.4.1/modules/hal/nordic/nrfx/drivers/src/nrfx_clock_hfclk.c.obj
[112/184] Building C object modules/hal_nordic/modules/hal_nordic/nrfx/CMakeFiles/nrfx.dir/Volumes/GOKSSD/codex/toolchains/collar-ncs-3.4.1/modules/hal/nordic/nrfx/drivers/src/nrfx_clock_hfclk192m.c.obj
[113/184] Building C object zephyr/drivers/timer/CMakeFiles/drivers__timer.dir/nrf_rtc_timer.c.obj
[114/184] Building C object modules/hal_nordic/modules/hal_nordic/nrfx/CMakeFiles/nrfx.dir/Volumes/GOKSSD/codex/toolchains/collar-ncs-3.4.1/modules/hal/nordic/nrfx/drivers/src/nrfx_clock.c.obj
[115/184] Building C object modules/hal_nordic/modules/hal_nordic/nrfx/CMakeFiles/nrfx.dir/Volumes/GOKSSD/codex/toolchains/collar-ncs-3.4.1/modules/hal/nordic/nrfx/drivers/src/nrfx_clock_xo.c.obj
[116/184] Building C object modules/hal_nordic/modules/hal_nordic/nrfx/CMakeFiles/nrfx.dir/Volumes/GOKSSD/codex/toolchains/collar-ncs-3.4.1/modules/hal/nordic/nrfx/drivers/src/nrfx_clock_lfclk.c.obj
[117/184] Building C object modules/hal_nordic/modules/hal_nordic/nrfx/CMakeFiles/nrfx.dir/Volumes/GOKSSD/codex/toolchains/collar-ncs-3.4.1/modules/hal/nordic/nrfx/drivers/src/nrfx_clock_xo24m.c.obj
[118/184] Building C object zephyr/soc/soc/nrf9151/CMakeFiles/soc__nordic.dir/common/gpiote_nrfx.c.obj
[119/184] Building C object zephyr/kernel/CMakeFiles/kernel.dir/main_weak.c.obj
[120/184] Building C object zephyr/kernel/CMakeFiles/kernel.dir/banner.c.obj
[121/184] Building C object modules/segger/CMakeFiles/modules__segger.dir/SEGGER_RTT_zephyr.c.obj
[122/184] Building C object modules/segger/CMakeFiles/modules__segger.dir/Volumes/GOKSSD/codex/toolchains/collar-ncs-3.4.1/modules/debug/segger/SEGGER/SEGGER_RTT.c.obj
[123/184] Building C object zephyr/kernel/CMakeFiles/kernel.dir/busy_wait.c.obj
[124/184] Building C object zephyr/kernel/CMakeFiles/kernel.dir/errno.c.obj
[125/184] Building C object zephyr/kernel/CMakeFiles/kernel.dir/device.c.obj
[126/184] Building C object zephyr/kernel/CMakeFiles/kernel.dir/version.c.obj
[127/184] Building C object zephyr/drivers/gpio/CMakeFiles/drivers__gpio.dir/gpio_nrfx.c.obj
[128/184] Building C object zephyr/kernel/CMakeFiles/kernel.dir/float.c.obj
[129/184] Building C object zephyr/kernel/CMakeFiles/kernel.dir/fatal.c.obj
[130/184] Building C object zephyr/kernel/CMakeFiles/kernel.dir/idle.c.obj
[131/184] Building C object zephyr/kernel/CMakeFiles/kernel.dir/init.c.obj
[132/184] Building C object zephyr/kernel/CMakeFiles/kernel.dir/kheap.c.obj
[133/184] Building C object modules/hal_nordic/modules/hal_nordic/nrfx/CMakeFiles/nrfx.dir/Volumes/GOKSSD/codex/toolchains/collar-ncs-3.4.1/modules/hal/nordic/nrfx/drivers/src/nrfx_twi_twim.c.obj
[134/184] Building C object zephyr/kernel/CMakeFiles/kernel.dir/mem_slab.c.obj
[135/184] Building C object zephyr/kernel/CMakeFiles/kernel.dir/mailbox.c.obj
[136/184] Building C object zephyr/kernel/CMakeFiles/kernel.dir/mutex.c.obj
[137/184] Building C object zephyr/kernel/CMakeFiles/kernel.dir/stack.c.obj
[138/184] Building C object zephyr/kernel/CMakeFiles/kernel.dir/system_work_q.c.obj
[139/184] Building C object zephyr/kernel/CMakeFiles/kernel.dir/sem.c.obj
[140/184] Building C object modules/hal_nordic/modules/hal_nordic/nrfx/CMakeFiles/nrfx.dir/Volumes/GOKSSD/codex/toolchains/collar-ncs-3.4.1/modules/hal/nordic/nrfx/drivers/src/nrfx_twim.c.obj
[141/184] Building C object zephyr/kernel/CMakeFiles/kernel.dir/msg_q.c.obj
[142/184] Building C object zephyr/kernel/CMakeFiles/kernel.dir/condvar.c.obj
[143/184] Building C object zephyr/kernel/CMakeFiles/kernel.dir/spinlock_validate.c.obj
[144/184] Building C object zephyr/kernel/CMakeFiles/kernel.dir/thread.c.obj
[145/184] Building C object zephyr/kernel/CMakeFiles/kernel.dir/timeslicing.c.obj
[146/184] Building C object zephyr/kernel/CMakeFiles/kernel.dir/queue.c.obj
[147/184] Linking C static library app/libapp.a
[148/184] Building C object zephyr/kernel/CMakeFiles/kernel.dir/timeout.c.obj
[149/184] Building C object zephyr/kernel/CMakeFiles/kernel.dir/dynamic_disabled.c.obj
[150/184] Building C object zephyr/kernel/CMakeFiles/kernel.dir/pipe.c.obj
[151/184] Linking C static library zephyr/libzephyr.a
[152/184] Building C object zephyr/CMakeFiles/zephyr_pre0.dir/misc/empty_file.c.obj
[153/184] Building C object zephyr/kernel/CMakeFiles/kernel.dir/mempool.c.obj
[154/184] Linking C static library zephyr/arch/common/libarch__common.a
[155/184] Linking C static library zephyr/arch/arch/arm/core/cortex_m/cmse/libarch__arm__core__cortex_m__cmse.a
[156/184] Linking C static library zephyr/arch/arch/arm/core/libarch__arm__core.a
[157/184] Linking C static library zephyr/arch/arch/arm/core/mpu/libarch__arm__core__mpu.a
[158/184] Building C object zephyr/kernel/CMakeFiles/kernel.dir/timer.c.obj
[159/184] Linking C static library zephyr/arch/arch/arm/core/cortex_m/libarch__arm__core__cortex_m.a
[160/184] Linking C static library zephyr/lib/libc/picolibc/liblib__libc__picolibc.a
[161/184] Linking C static library zephyr/lib/libc/common/liblib__libc__common.a
[162/184] Building C object zephyr/kernel/CMakeFiles/kernel.dir/work.c.obj
[163/184] Linking C static library zephyr/drivers/clock_control/libdrivers__clock_control.a
[164/184] Linking C static library zephyr/lib/posix/c_lib_ext/liblib__posix__c_lib_ext.a
[165/184] Linking C static library zephyr/drivers/gpio/libdrivers__gpio.a
[166/184] Linking C static library zephyr/soc/soc/nrf9151/libsoc__nordic.a
[167/184] Linking C static library zephyr/drivers/console/libdrivers__console.a
[168/184] Linking C static library zephyr/drivers/i2c/libdrivers__i2c.a
[169/184] Linking C static library zephyr/drivers/pinctrl/libdrivers__pinctrl.a
[170/184] Linking C static library zephyr/drivers/sensor/st/lis2dw12/libdrivers__sensor__st__lis2dw12.a
[171/184] Linking C static library zephyr/drivers/sensor/st/stmemsc/libdrivers__sensor__st__stmemsc.a
[172/184] Linking C static library modules/nrf/drivers/hw_cc3xx/lib..__nrf__drivers__hw_cc3xx.a
[173/184] Linking C static library modules/segger/libmodules__segger.a
[174/184] Linking C static library zephyr/drivers/timer/libdrivers__timer.a
[175/184] Building C object zephyr/kernel/CMakeFiles/kernel.dir/sched.c.obj
[176/184] Building C object modules/hal_nordic/modules/hal_nordic/nrfx/CMakeFiles/nrfx.dir/Volumes/GOKSSD/codex/toolchains/collar-ncs-3.4.1/modules/hal/nordic/nrfx/drivers/src/nrfx_gpiote.c.obj
[177/184] Linking C static library zephyr/kernel/libkernel.a
[178/184] Linking C static library modules/hal_nordic/modules/hal_nordic/nrfx/libnrfx.a
[179/184] Linking C executable zephyr/zephyr_pre0.elf; Logical command for additional byproducts on target: zephyr_pre0
[180/184] Generating linker.cmd
[181/184] Generating isr_tables.c, isr_tables_vt.ld, isr_tables_swi.ld
[182/184] Building C object zephyr/CMakeFiles/zephyr_final.dir/misc/empty_file.c.obj
[183/184] Building C object zephyr/CMakeFiles/zephyr_final.dir/isr_tables.c.obj
[184/184] Linking C executable zephyr/zephyr.elf
Memory region         Used Size  Region Size  %age Used
           FLASH:       46872 B         1 MB      4.47%
             RAM:        8256 B       256 KB      3.15%
        IDT_LIST:           0 B        32 KB      0.00%
Generating files from /Volumes/GOKSSD/codex/toolchains/collar-ncs-3.4.1/build-factory-final/zephyr/zephyr.elf for board: collar_r05l/nrf9151
{
  "result": "BUILD_PASS",
  "board": "collar_r05l/nrf9151",
  "artifacts": {
    "zephyr.elf": {
      "bytes": 1059636,
      "sha256": "4f9aa0e429861106826ffffe4267ffdae589407990d21f8500d7a4ee648c5263"
    },
    "zephyr.hex": {
      "bytes": 131893,
      "sha256": "1ea7dc3608cebe887118877600e4190420cbd0804470321f155bc8c6007a2b86"
    },
    "zephyr.dts": {
      "bytes": 44188,
      "sha256": "a1d4e653353cfd0fc23e2da2838bc23c551be91d7159f589cbe0377a2391badb"
    },
    ".config": {
      "bytes": 47395,
      "sha256": "5a9bb1f3b15693eb7670a8b4774d2a51048c168618e019046abb468b7f45ffa1"
    }
  },
  "flashed": false,
  "physical_test": false,
  "manufacturing_release": false
}
