gokselozgur5/pcb-design-collar-tracker/assembly/pcba-r02/placement-reference.pdf

## r05l / PCBA r02 — native connector and Q1 placement reference

Review only. Dimensions in mm; not a stencil, machine program or assembly approval.
Gerber origin unchanged. J6 is shown from the bottom component side (X mirrored).
J1 — Top | physical centre (18.3, 5.7)

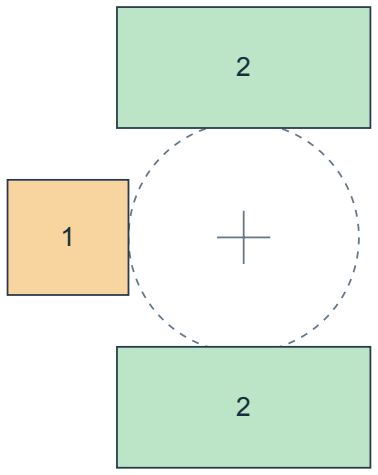
[picture p175: figure]

Pin 1 = RF; both pin-2 lands = GND. Coax centre = crosshair. Only the dated JLC model origin moves -0.632003 mm in X.

J2 — Top | physical centre (28.3, 16.2)

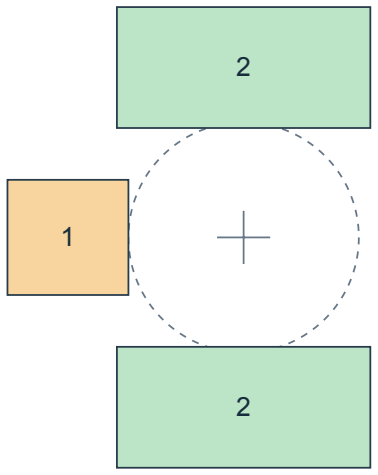
[picture p176: figure]

Pin 1 = RF; both pin-2 lands = GND. Coax centre = crosshair. Only the dated JLC model origin moves -0.632003 mm in X.

J6 — Bottom | physical centre (27, 20)
1 | 2 | 3
5 | 6 | 7
8 | 8

1 VCC / 2 RST / 3 CLK / 5 GND / 6 NC / 7 IO / 8 shield

Opening at Gerber +Y edge; insert toward -Y

No-peg variant. Do not drill locating holes or fit a 180-degree reversal.

Q1 — Top | physical centre (34, 6.75)
1 | 2 | 3
6 | 5 | 4

Original DMN62D2UDW-7 remains mandatory; candidate not selected.

1 S1 / 2 G1 / 3 D1 / 4 S2 / 5 G2 / 6 D2 S1/S2: GND; G1/G2: POWER_FAULT D1: VIO_ENABLE; D2: VIO_DISCHARGE

Reference geometry: native r05l pad export; Hirose U.FL mounting pattern; GCT SIM8051 D6; Diodes SOT363.
