gokselozgur5/pcb-design-collar-tracker/assembly/internal-charge-r03/restraint-sheet-1.pdf

## CT-INTERNAL-CHARGE-003-A / R19

PROTOTYPE REVIEW - manufacturing and physical qualification HOLD

DISPENSING ENVELOPES / mm

pcb-pair

X: -17.200 to -13.400
Y: -13.050 to -11.120
Z: 11.241 to 12.950

red-terminal

X: 20.700 to 22.450
Y: -3.950 to -2.650
Z: 12.800 to 14.250

black-terminal

X: 20.700 to 22.450
Y: 5.350 to 6.650
Z: 12.800 to 14.250

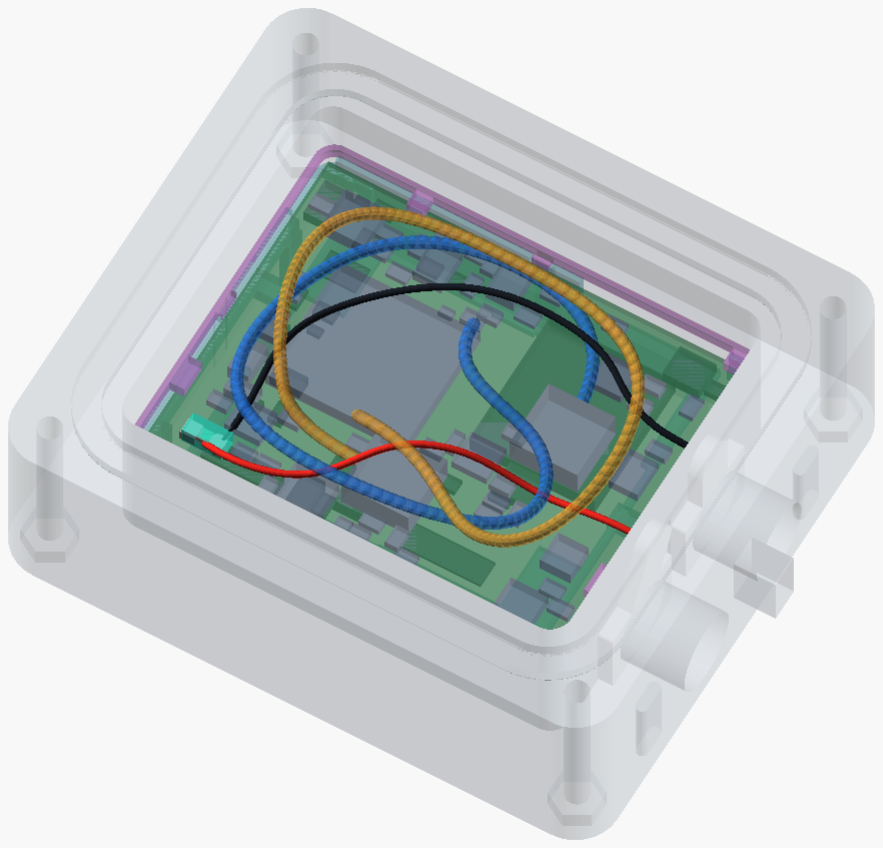
[picture p177: figure]

Dimensions use the assembled enclosure frame. Total placement/service allowance +/-0.05mm.

The PCB owns one shared insulating block. Each metal terminal owns a separate block.

PTFE adhesion is not relied on. Inspect both solder joints before covering them.

27/27 static poses pass; 52 added checks per pose. Minimum component gap: 0.22mm.

The geometry does not establish bond strength, continuous motion or a production process.

Factory trial: lid open, battery absent, 21..25C / 40..60% RH / >=168h plus passing witnesses.

Handling qualification target: 0.5N for 60s, anchor movement <=0.03mm. Not yet tested.

Use restraint.json and README.md for covered lengths, substrate tests and release requirements.

1 / 2 | Nominal CAD illustration. No order, supplier approval or physical test is recorded.
