gokselozgur5/pcb-design-collar-tracker/assembly/internal-charge-r03/restraint-sheet-2.pdf

## CT-INTERNAL-CHARGE-003-A / R19

PROTOTYPE REVIEW - manufacturing and physical qualification HOLD

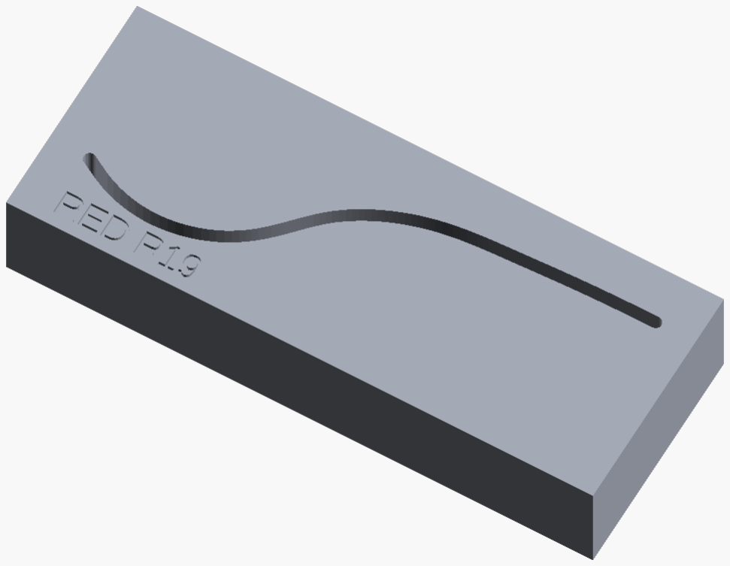
[picture p178: figure]

RED FORMING NEST

Overall: 47.39 x 18.33 x 9.00mm

Centerline reference: 43.7658mm

Bounded tool clearance: 0.0730mm

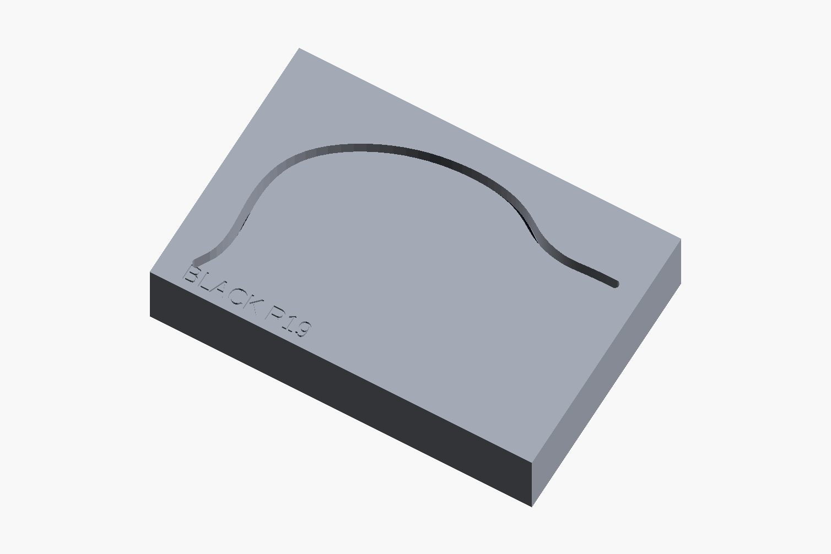
[picture p179: figure]

BLACK FORMING NEST

Overall: 44.77 x 30.33 x 9.00mm

Centerline reference: 54.9209mm

Bounded tool clearance: 0.0459mm

The tools sit on a bench and are removed before final assembly. They do not fit inside the collar.

Channels are open vertically. Lift the wire straight out, then inspect released shape and springback.

Maximum wire OD 0.6604mm; tool tolerance +/-0.05mm. Tool material/process must meet that tolerance.

Strip 1.8 +/-0.1mm at the terminal and 2.4 +/-0.1mm at the PCB. Verify actual ends in assembly.

The recorded curve lengths are not a qualified cut-length tolerance. Do not stretch wires to fit.

Confirm lid installation, adhesive deformation and cyclic motion on samples before release.

2 / 2 | Green PCB DFM does not cover tool accuracy, factory wiring, operating function or IP68.
