gokselozgur5/pcb-design-collar-tracker/assembly/pack-r03/request-sheet.pdf

# CT-BAT-001-A | Protected pack + temperature sensor

## SUPPLIER REQUEST — dimensions and ratings need written confirmation

## Requested pack body

Complete protected 1S pack

Flat NTC attachment

Active sensing area: confirm

32 mm MAX

30.5
mm

### Side section — budgets, not a supplier-approved stack

5.3 mm

Body limit must include PCM, insulation and service swelling. NTC: 26 x 4.1 x 0.5 mm; bond ≤0.15 mm; cover ≤0.10 mm. Available complete assembly envelope: 33 x 31.5 x 6.2 mm.

## Electrical requirements

Capacity | ≥300 mAh; about 350 mAh preferred
Pack voltage | 1S, 3.7 V nominal
Charge voltage | 4.2 V ±0.5%; confirm compatible limits
Charge current | 100 mA nominal; check 112 mA screen
Cell charging | 0–45°C; hardware temperature interlock
Pack discharge | 600 mA continuous design allowance
Charge finish | About 10 mA termination; 6 h nominal safety timer
Pulse rating | Return duration, duty and temperature limits
Sensor | 10k ±1%; B3435 ±1%; attached to cell
Protection | Return thresholds, delays and recovery
Termination | Three insulated, factory-assembled outputs

## Native board interface

J4.1 RED protected positive / VBAT
J4.2 BLACK protected negative + NTC return J4.3 WHITE NTC signal / BAT_NTC

Please return a controlled part/drawing, complete-pack limits, NTC construction, safety documents, MOQ and lead time. The reference EEMB LP503030-PCM-LD sheet limits its PCM to 350 mA continuous. It is NOT approved for this request. If these limits cannot be met, propose a supported alternative. This enquiry is not an order or a manufacturing release. No end-user soldering. Lead length, routing, strain relief, sensor lag and physical qualification are still open.

2026-10-26 | Engineering request | Units: mm | Not to scale | 1 / 1
