gokselozgur5/pcb-design-collar-tracker/release/r08-assembly-review/assembly-review.pdf

# COLLAR TRACKER / r08 ASSEMBLY REVIEW

Prototype antennas and routed cables. The all-green r05l PCB is unchanged.

LTE + GNSS / actual connector positions | SECTION / seal, carrier and cable guides

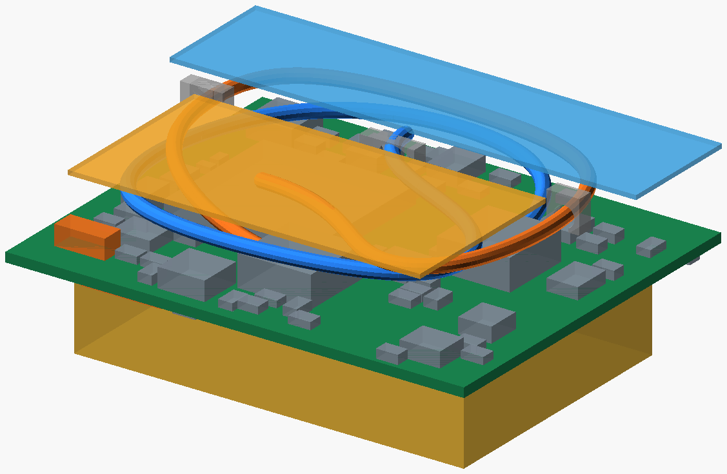
[picture p180: figure]

### CHECKED MODEL / CONDITIONAL

CAPH LTE + ZETA GNSS; standard 100 mm cable candidates. 85 populated envelopes; four PCB thickness cases.
Separate cable paths and four internal lid guides.
CAD guide interference empty; undersized control fails.
Eight closed meshes; five inspected assembly views. Rigid shell + lid: 57.4 x 49.4 x 20.6 mm.
Boot: 60.4 x 52.4 x 25.4 mm. Key adds 1.3 mm.

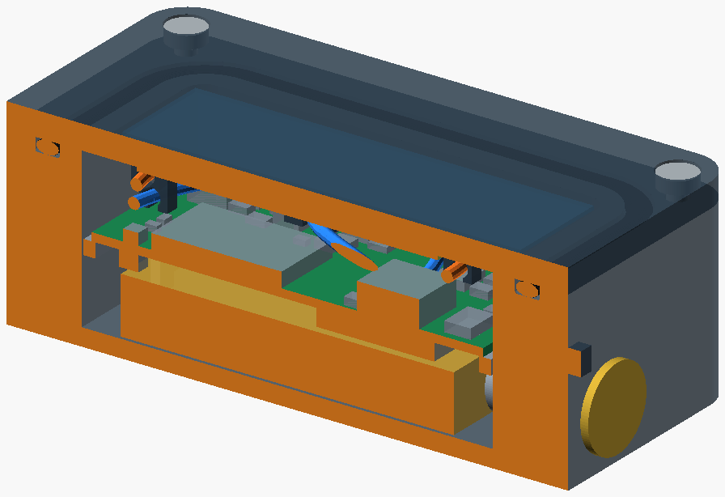
[picture p181: figure]

### WORKING-DEVICE RELEASE STILL ON HOLD

Protected pack / NTC attachment: not selected.
Cable end datums and length tolerance fit: open.
Exact coax bend limit and feed bond: open.
Clip strength and opening/service motion: untested.
PCB retention, dock/harness and factory firmware: open. No powered, RF or physical water/dust test exists.
IP68 is a design target, not an achieved rating.

PCB SHA256: 241c84d6ba98793c37344e1e46ddc4918e7b05322ba87daea7c9a90ffb8379b3

Two preserved JLC runs: 0 Danger / 0 Warning / 455 Good each. SMT was not analyzed.
