gokselozgur5/pcb-design-collar-tracker/release/r08-assembly-review/pcb-review.pdf

# COLLAR TRACKER / r05l PCB REVIEW

Two actual all-green PCB DFM reports. Working-device release remains on hold.

TOP / copper and silkscreen | BOTTOM / mirrored component view


### VERIFIED PCB / UNCHANGED

40 x 32 mm / six Cu layers / 87 footprints.
Native DRC, ERC, connectivity and parity: zero findings. JLC: 0 Danger / 0 Warning / 455 Good in both runs. Same ZIP, unchanged rules, all 29 rows; SMT off.
81 fitted references / 44 exact candidate MPNs.
109 physical GND pads have local via paths.
Two GND planes; 154/154 signal-via return screens.


### REQUIRED BEFORE WORKING DELIVERY

Hardware charge-temperature interlock is implemented. Its thermal/startup model still needs powered tests. Protected pack and NTC attachment are unselected.
r08 prototype antenna/cable model: see next page. Firmware, factory programming and functional tests: open. Procurement, CPL rotations and SMT acceptance: open. This package is for review, not an order release.

PCB SHA256: 241c84d6ba98793c37344e1e46ddc4918e7b05322ba87daea7c9a90ffb8379b3

JLC records: 637366592129687553 / 637366801595977730
