gokselozgur5/pcb-design-collar-tracker/assembly/internal-charge-r03/red-fixture-preview.png

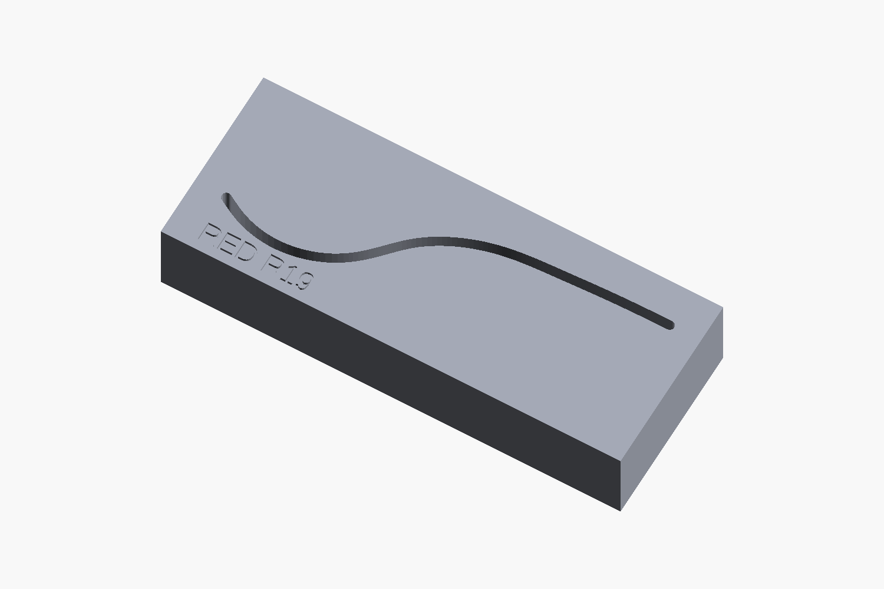
assembly/internal-charge-r03/red-fixture-preview.png
