gokselozgur5/pcb-design-collar-tracker/assembly/internal-charge-r03/restraint-preview.png

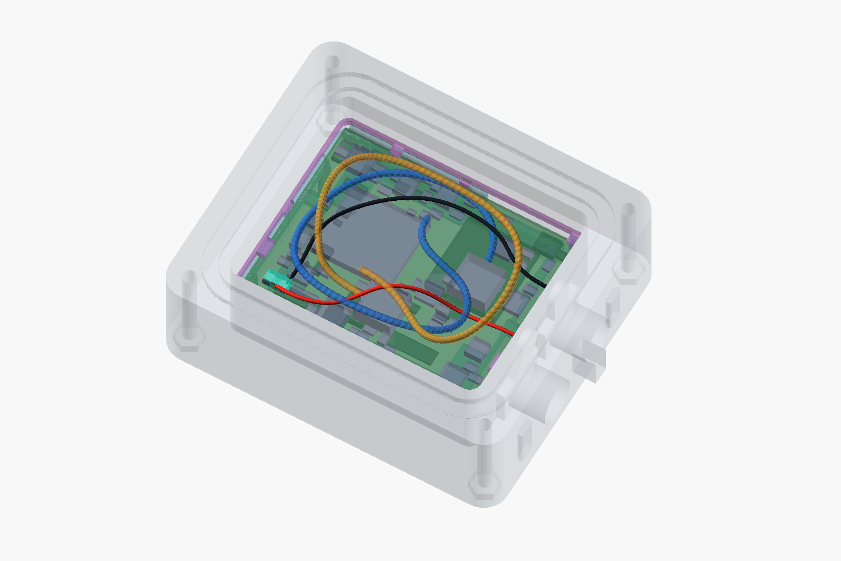
assembly/internal-charge-r03/restraint-preview.png
