gokselozgur5/pcb-design-collar-tracker/assembly/pack-r03/request-sheet.png

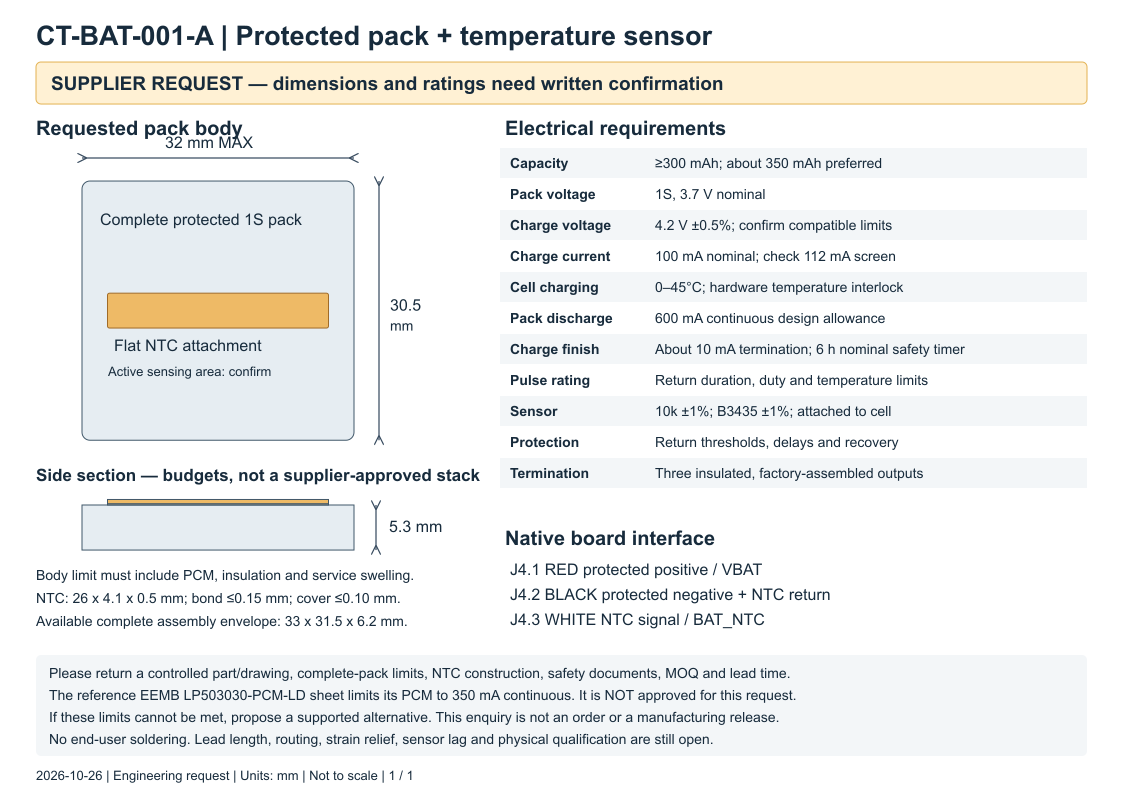
assembly/pack-r03/request-sheet.png
