gokselozgur5/pcb-design-collar-tracker/assembly/pcba-r01/previews/native-top.png

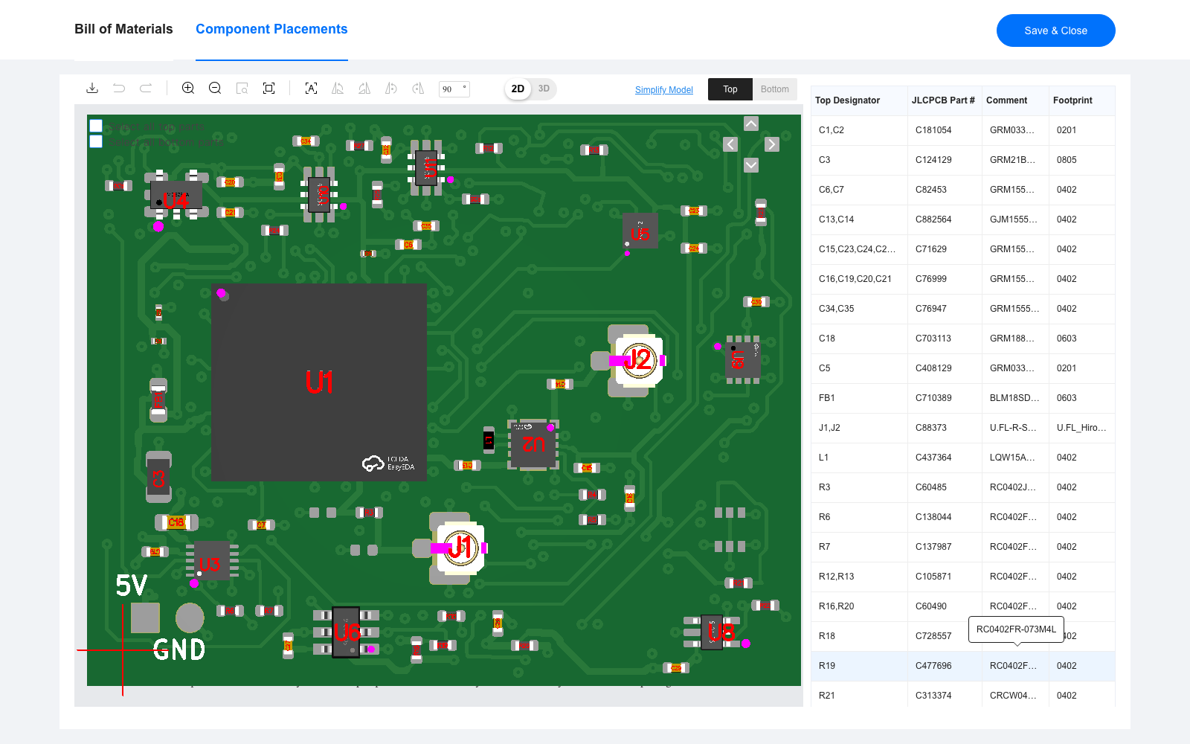
assembly/pcba-r01/previews/native-top.png
