gokselozgur5/pcb-design-collar-tracker/assembly/pcba-r03/previews/q1-stock.png

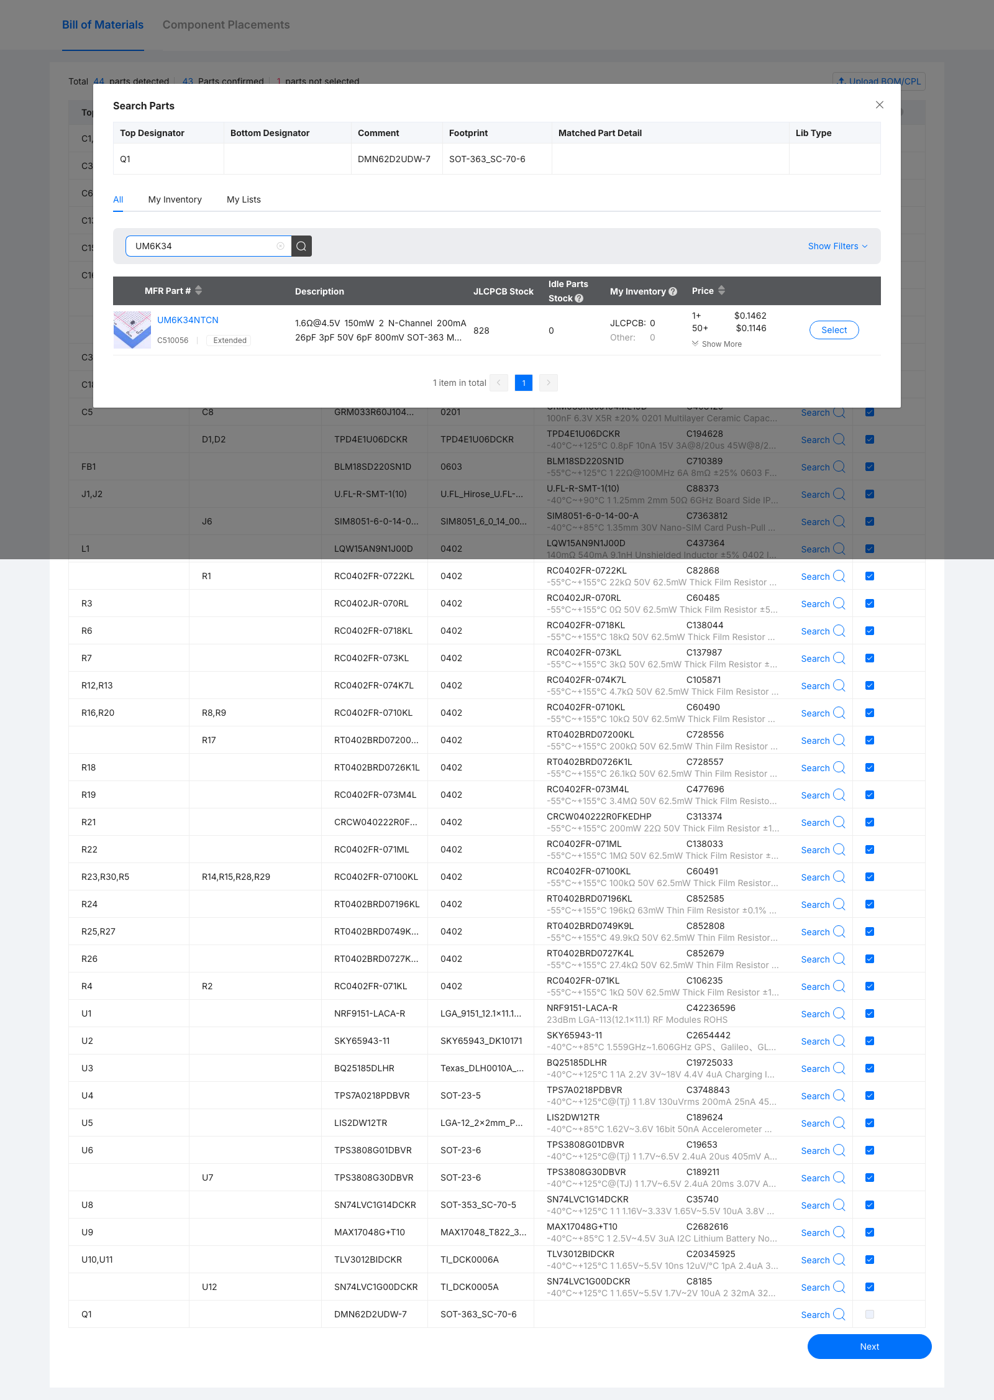
assembly/pcba-r03/previews/q1-stock.png
