gokselozgur5/pcb-design-collar-tracker/assembly/pcba-r03/previews/smt-board-edge.png

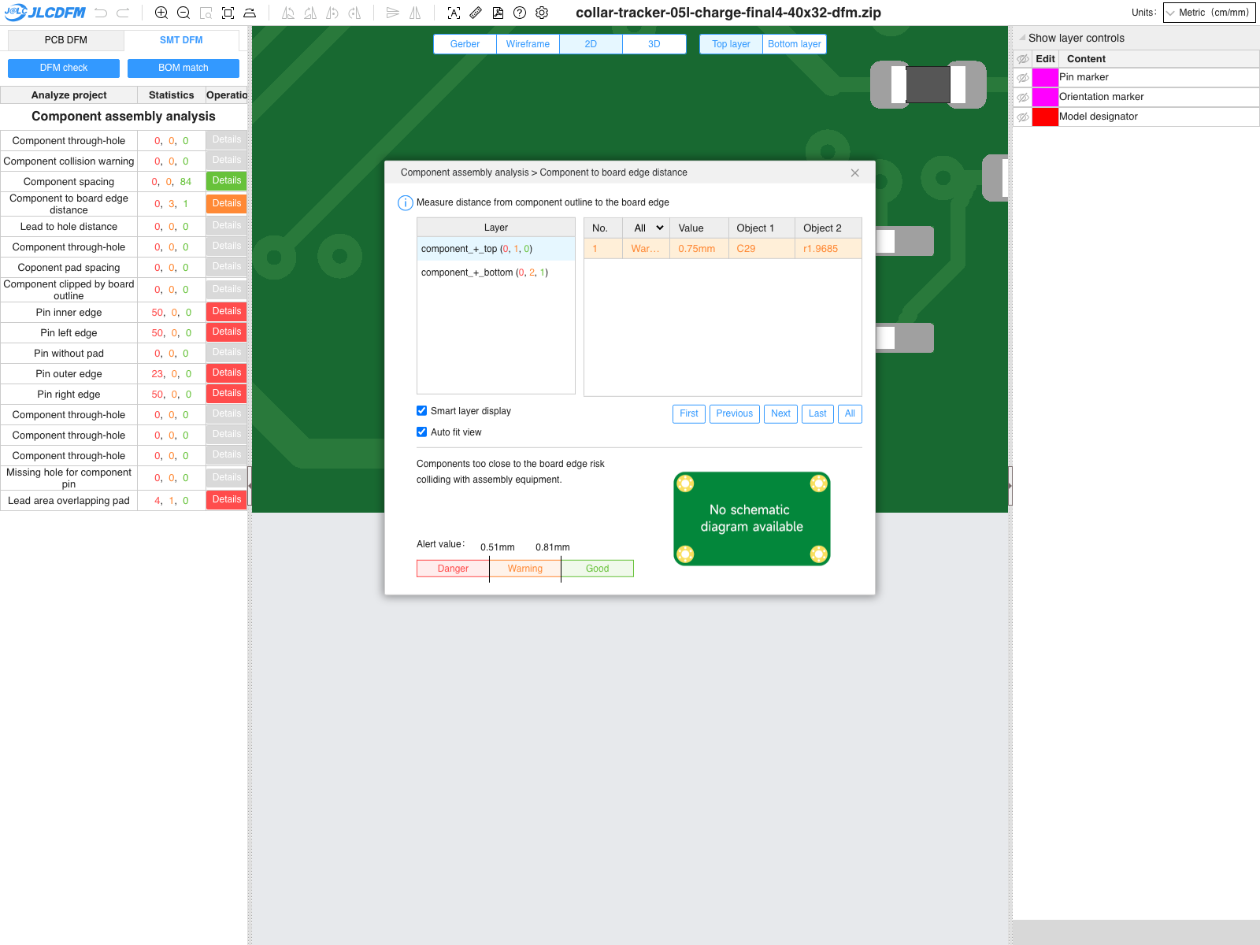
assembly/pcba-r03/previews/smt-board-edge.png
