gokselozgur5/pcb-design-collar-tracker/assembly/pcba-r03/previews/smt-initial.png

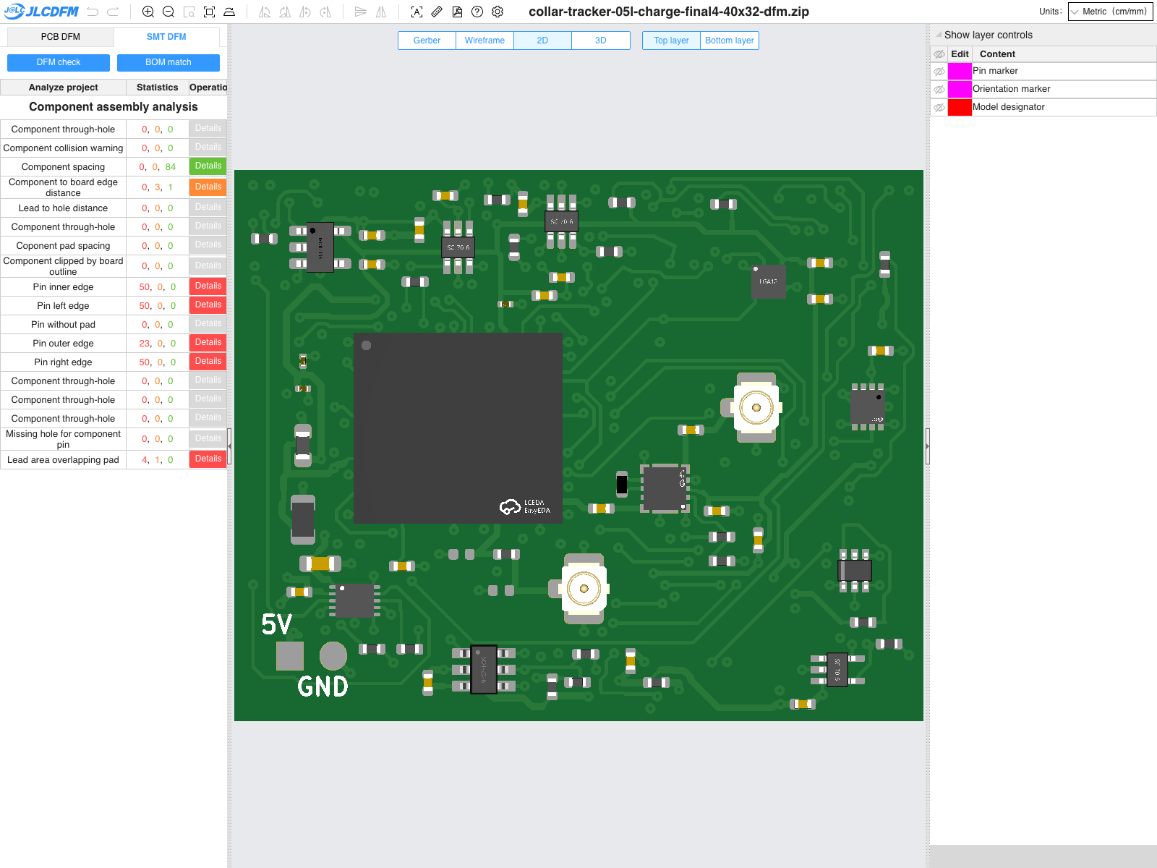
assembly/pcba-r03/previews/smt-initial.png
