gokselozgur5/pcb-design-collar-tracker/assembly/pcba-r03/previews/smt-lead-overlap.png

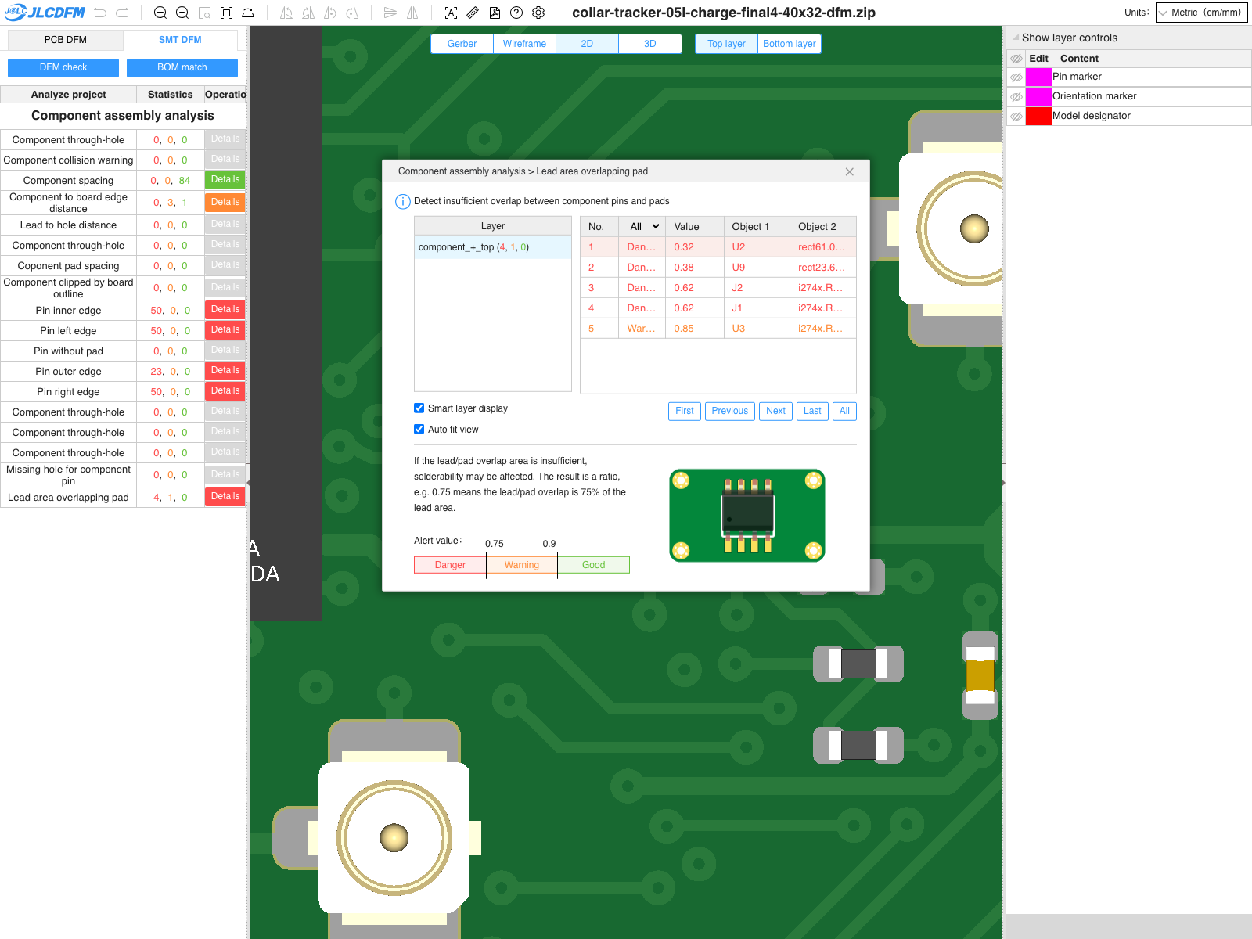
assembly/pcba-r03/previews/smt-lead-overlap.png
