gokselozgur5/pcb-design-collar-tracker/release/r16-current-review/assembly-review.png

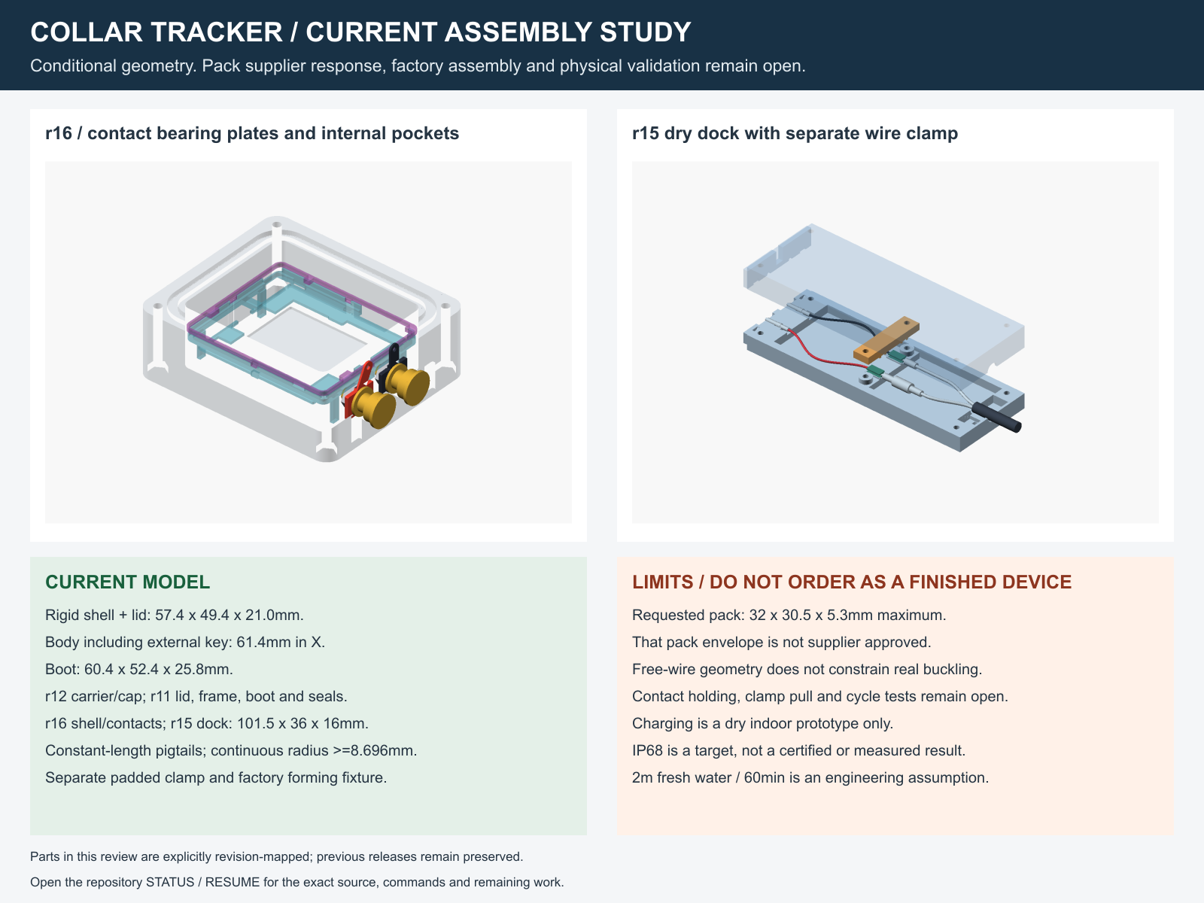
release/r16-current-review/assembly-review.png
