gokselozgur5/pcb-design-collar-tracker/experiments/paul-nanosim-r04/previews/README.md

# Initial placement preview

`placement-bottom.svg` and its PNG show the initial unrouted placement before
D1 and R14 moved for ground-via clearance. They are historical intermediate
previews, not the current routed board. Use the native PCB and the trial's
`build/placement.json` for current component positions.
