gokselozgur5/pcb-design-collar-tracker/experiments/power-r05h-six-layer/evidence/review.pdf

# COLLAR TRACKER / r05h DESIGN REVIEW

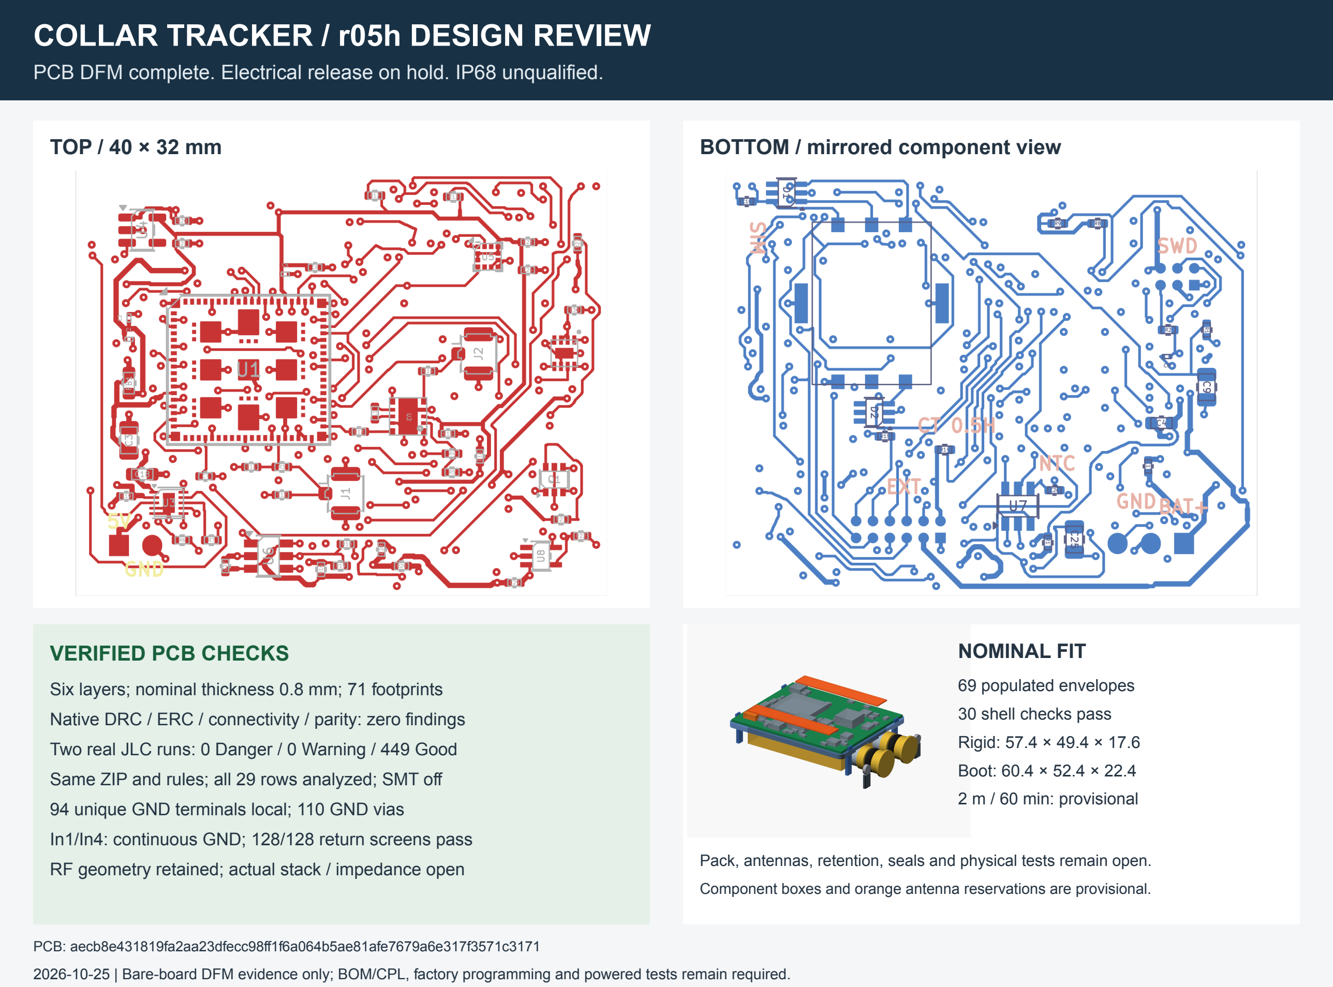
[picture p196: page 1]

PCB DFM complete. Electrical release on hold. IP68 unqualified.

TOP / 40 × 32 mm | BOTTOM / mirrored component view

### VERIFIED PCB CHECKS

Six layers; nominal thickness 0.8 mm; 71 footprints Native DRC / ERC / connectivity / parity: zero findings Two real JLC runs: 0 Danger / 0 Warning / 449 Good Same ZIP and rules; all 29 rows analyzed; SMT off 94 unique GND terminals local; 110 GND vias In1/In4: continuous GND; 128/128 return screens pass RF geometry retained; actual stack / impedance open

NOMINAL FIT

69 populated envelopes
30 shell checks pass
Rigid: 57.4 × 49.4 × 17.6
Boot: 60.4 × 52.4 × 22.4
2 m / 60 min: provisional

Pack, antennas, retention, seals and physical tests remain open. Component boxes and orange antenna reservations are provisional.

PCB: aecb8e431819fa2aa23dfecc98ff1f6a064b5ae81afe7679a6e317f3571c3171
2026-10-25 | Bare-board DFM evidence only; BOM/CPL, factory programming and powered tests remain required.
