gokselozgur5/pcb-design-collar-tracker/experiments/35x28-in2/previews/final-bottom.png

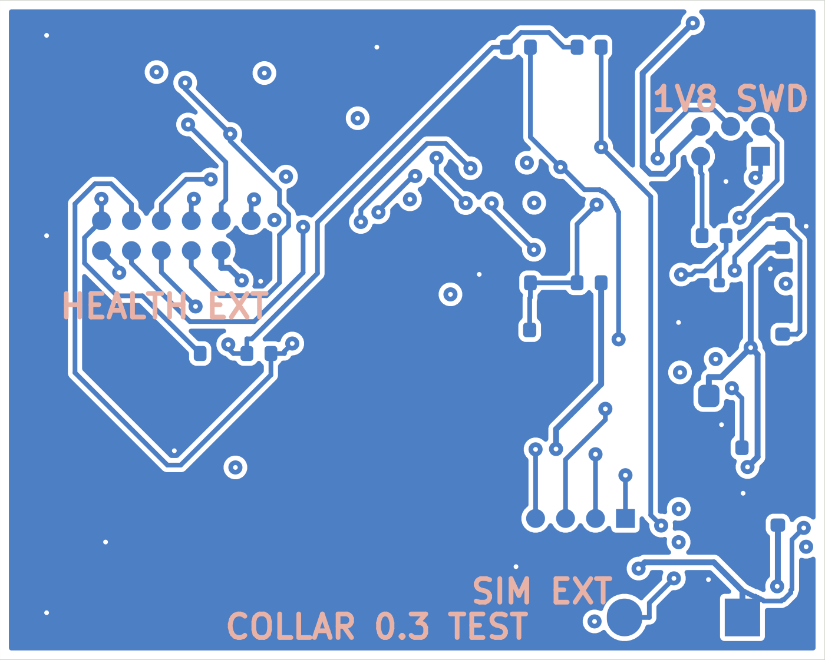
experiments/35x28-in2/previews/final-bottom.png
