gokselozgur5/pcb-design-collar-tracker/experiments/35x28-in2/previews/final-top.png

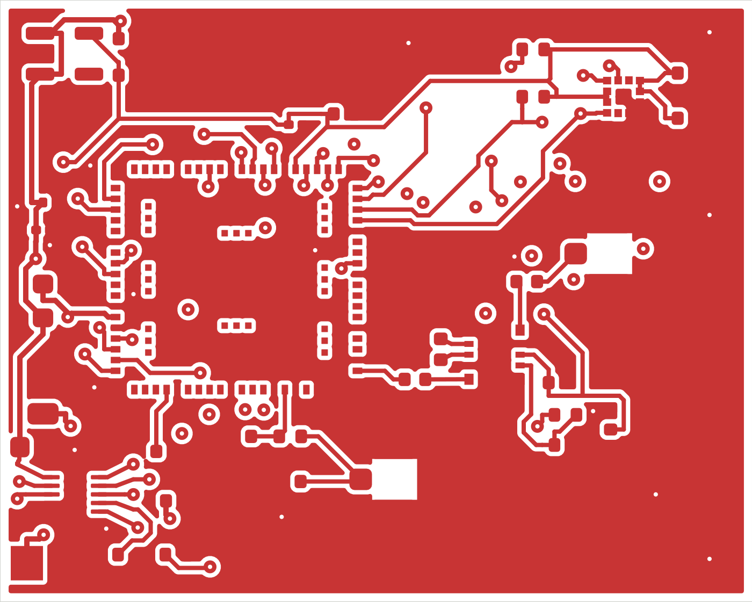
experiments/35x28-in2/previews/final-top.png
