gokselozgur5/pcb-design-collar-tracker/experiments/35x28/previews/placement-top.png

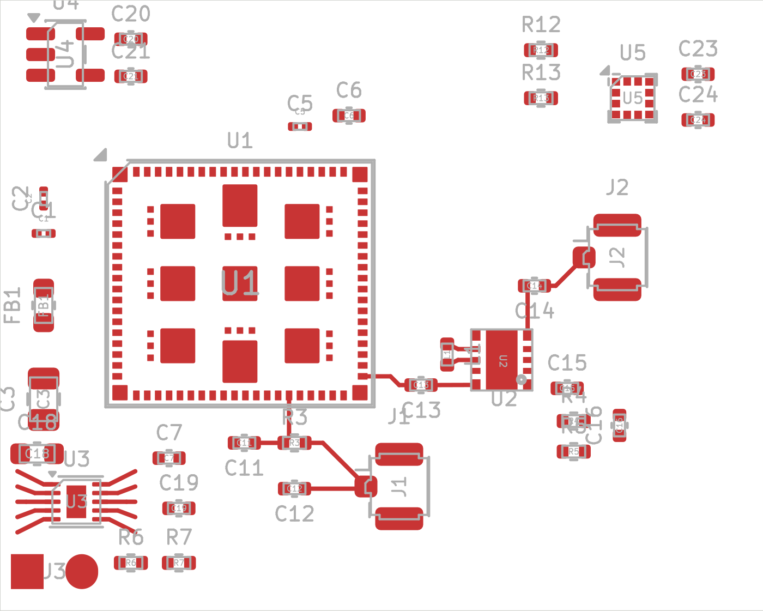
experiments/35x28/previews/placement-top.png
