gokselozgur5/pcb-design-collar-tracker/experiments/paul-nanosim-r04/previews/placement-bottom.png

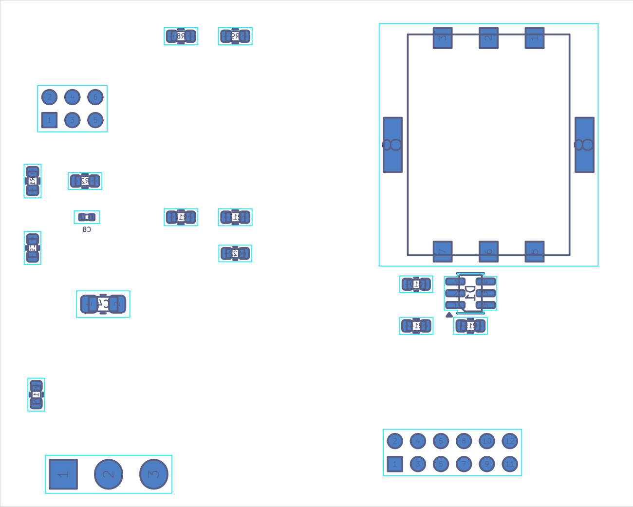
experiments/paul-nanosim-r04/previews/placement-bottom.png
