gokselozgur5/pcb-design-collar-tracker/experiments/paul-nanosim-r04c/previews/bottom-placement.png

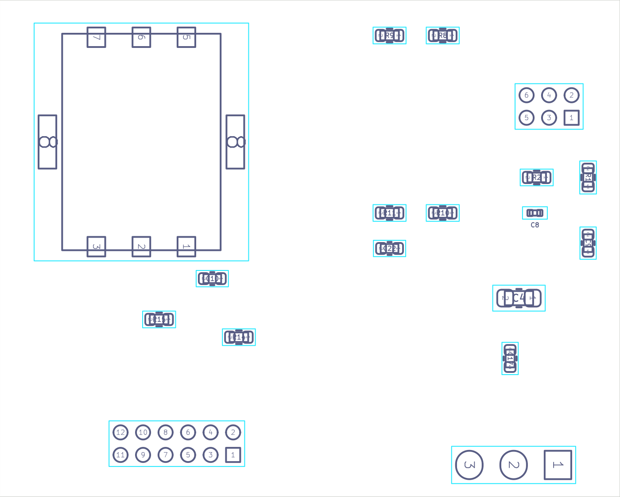
experiments/paul-nanosim-r04c/previews/bottom-placement.png
