gokselozgur5/pcb-design-collar-tracker/experiments/paul-nanosim-r04g-returns-40x32/evidence/bottom-review.png

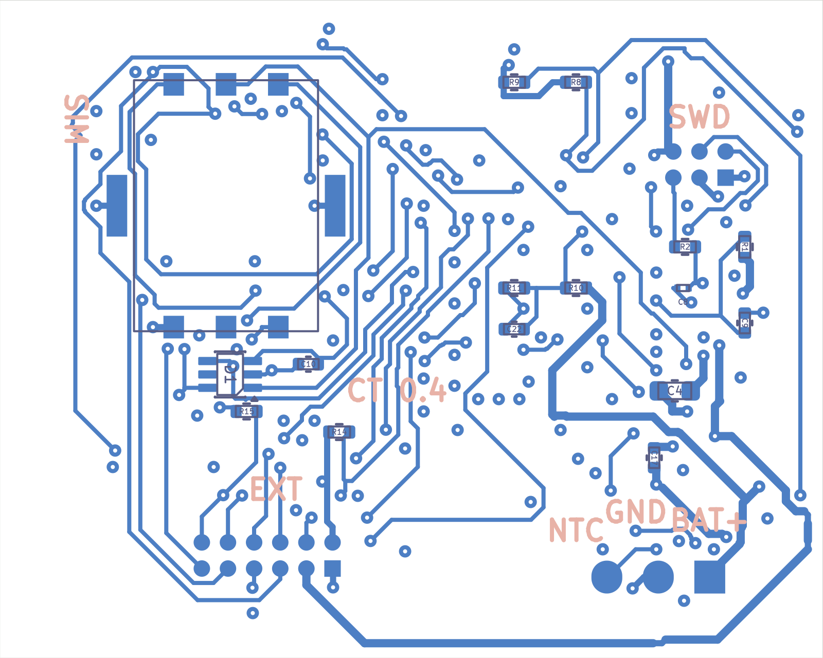
experiments/paul-nanosim-r04g-returns-40x32/evidence/bottom-review.png
