gokselozgur5/pcb-design-collar-tracker/experiments/paul-nanosim-r04i-sim-access-40x32/evidence/back.png

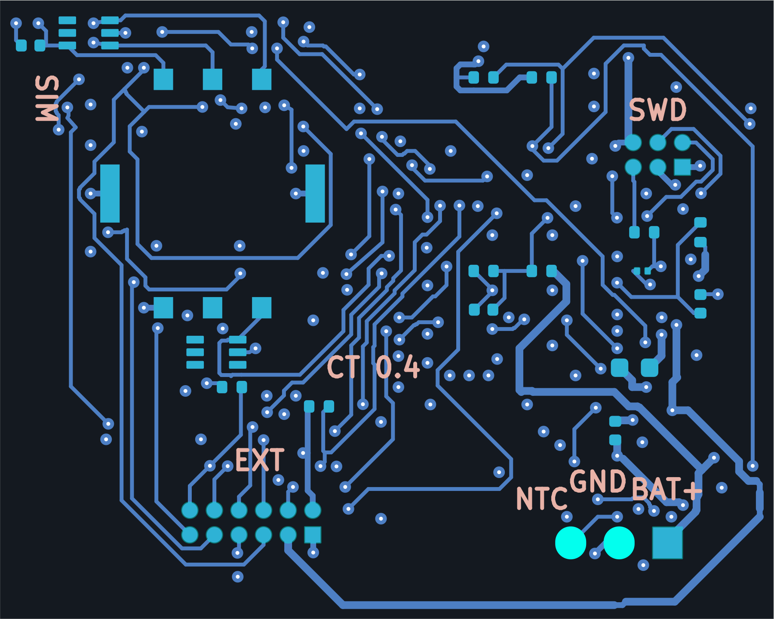
experiments/paul-nanosim-r04i-sim-access-40x32/evidence/back.png
