gokselozgur5/pcb-design-collar-tracker/experiments/power-r05b-pin-exits/previews/routing-bottom.png

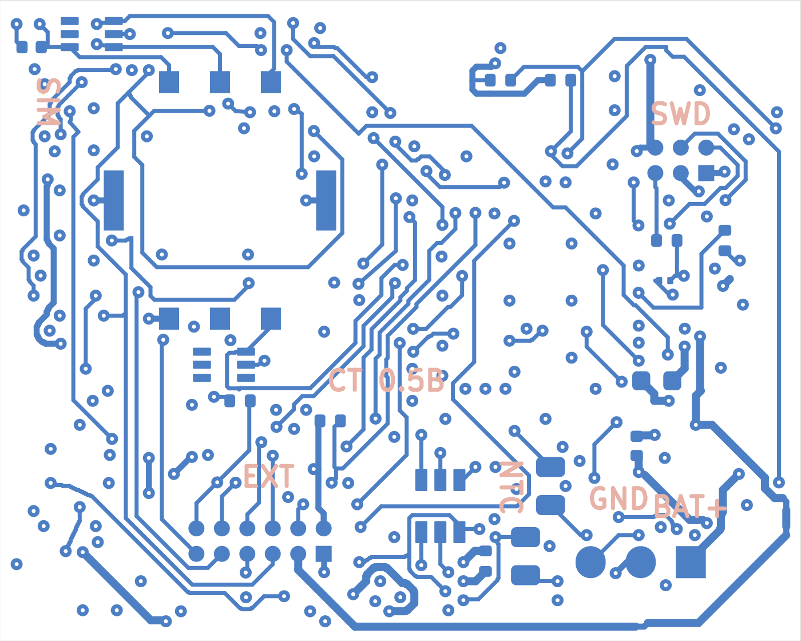
experiments/power-r05b-pin-exits/previews/routing-bottom.png
