gokselozgur5/pcb-design-collar-tracker/experiments/power-r05f-return-reset/previews/pcb-bottom.png

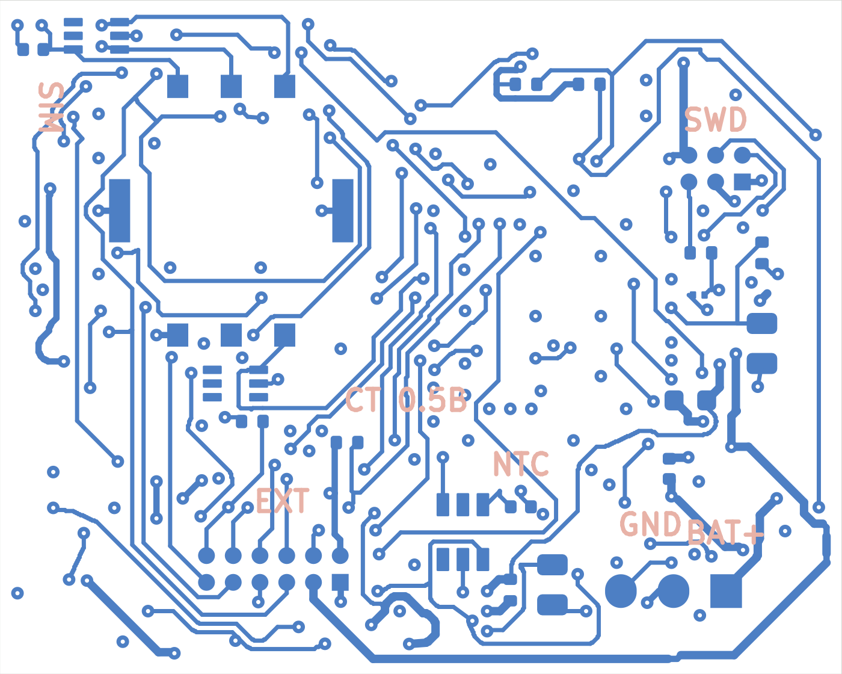
experiments/power-r05f-return-reset/previews/pcb-bottom.png
