gokselozgur5/pcb-design-collar-tracker/experiments/power-r05f-return-reset/previews/pcb-top.png

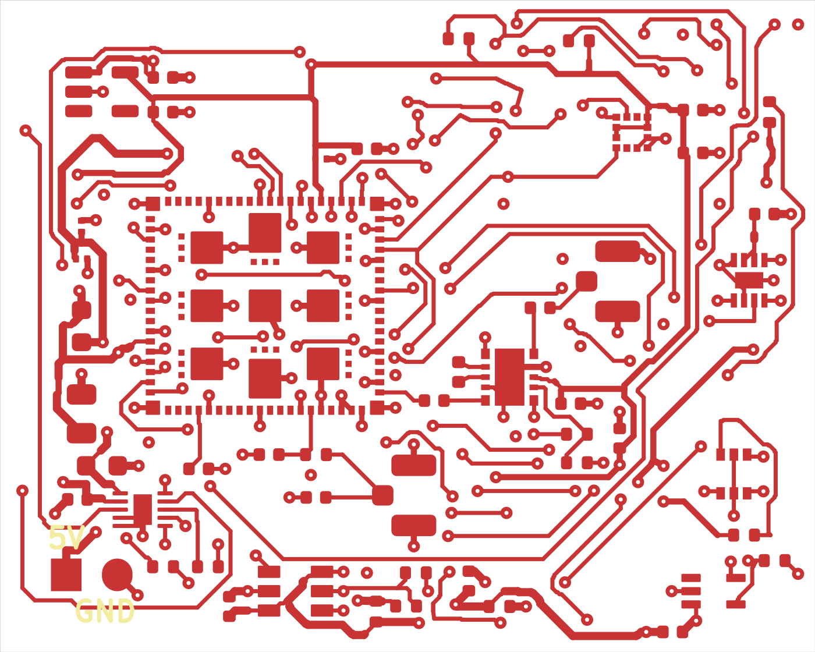
experiments/power-r05f-return-reset/previews/pcb-top.png
