gokselozgur5/pcb-design-collar-tracker/experiments/power-r05h-six-layer/evidence/top.png

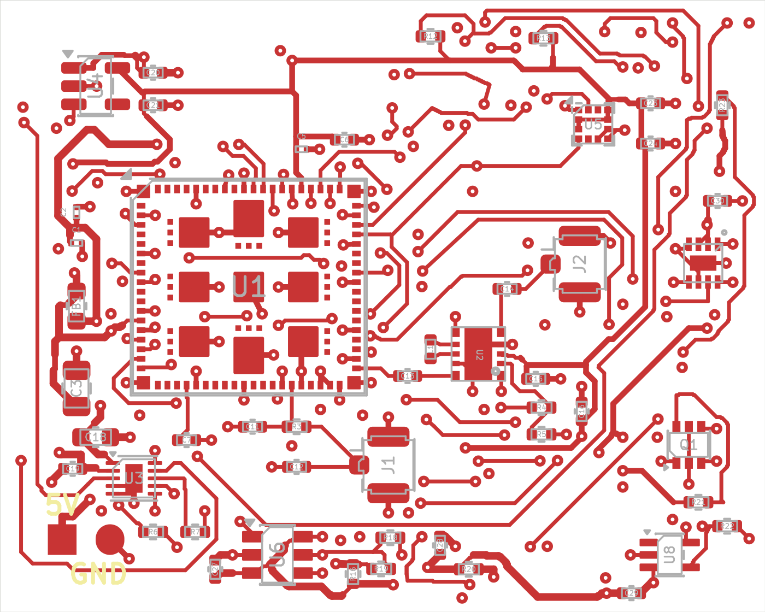
experiments/power-r05h-six-layer/evidence/top.png
