gokselozgur5/pcb-design-collar-tracker/experiments/power-r05i-rf-stack/evidence/rf-review.png

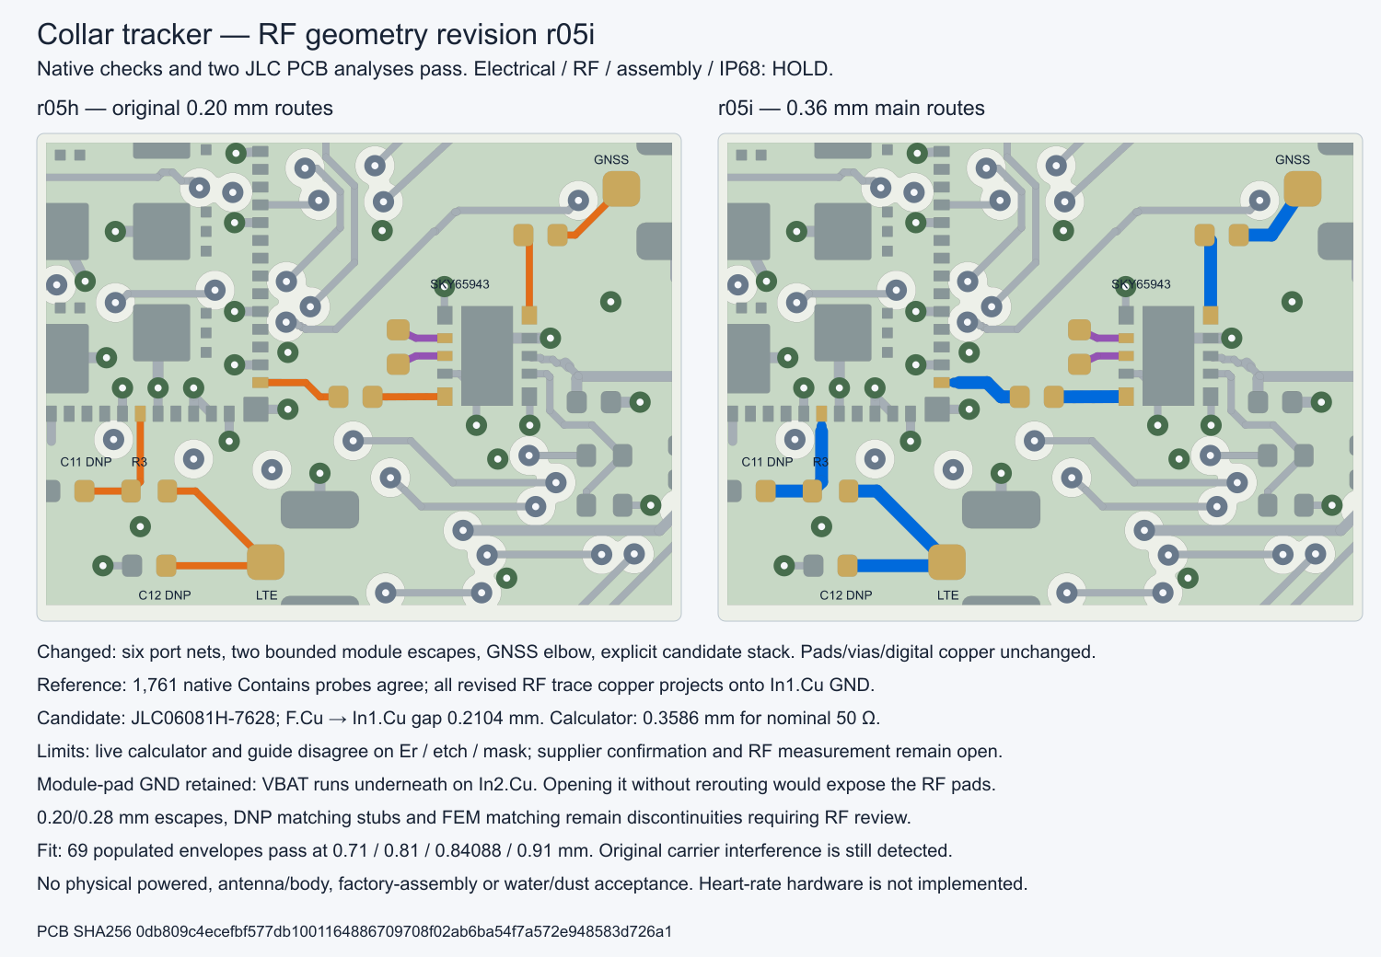
experiments/power-r05i-rf-stack/evidence/rf-review.png
