gokselozgur5/pcb-design-collar-tracker/experiments/power-r05i-rf-stack/evidence/six-layer-08-2116-noncoplanar-50.png

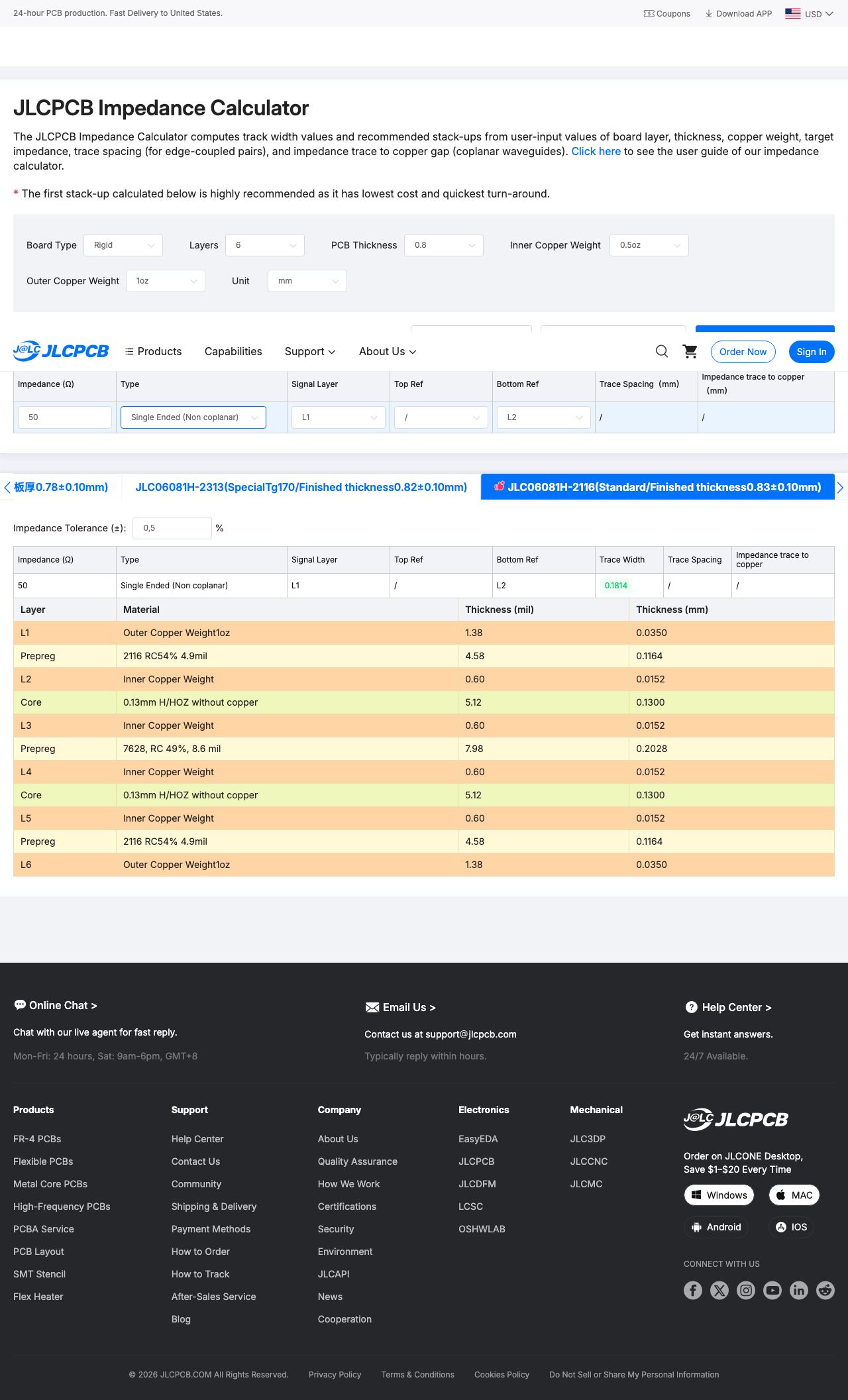
experiments/power-r05i-rf-stack/evidence/six-layer-08-2116-noncoplanar-50.png
