gokselozgur5/pcb-design-collar-tracker/experiments/power-r05j-rf-junctions/evidence/rf-junction-review.png

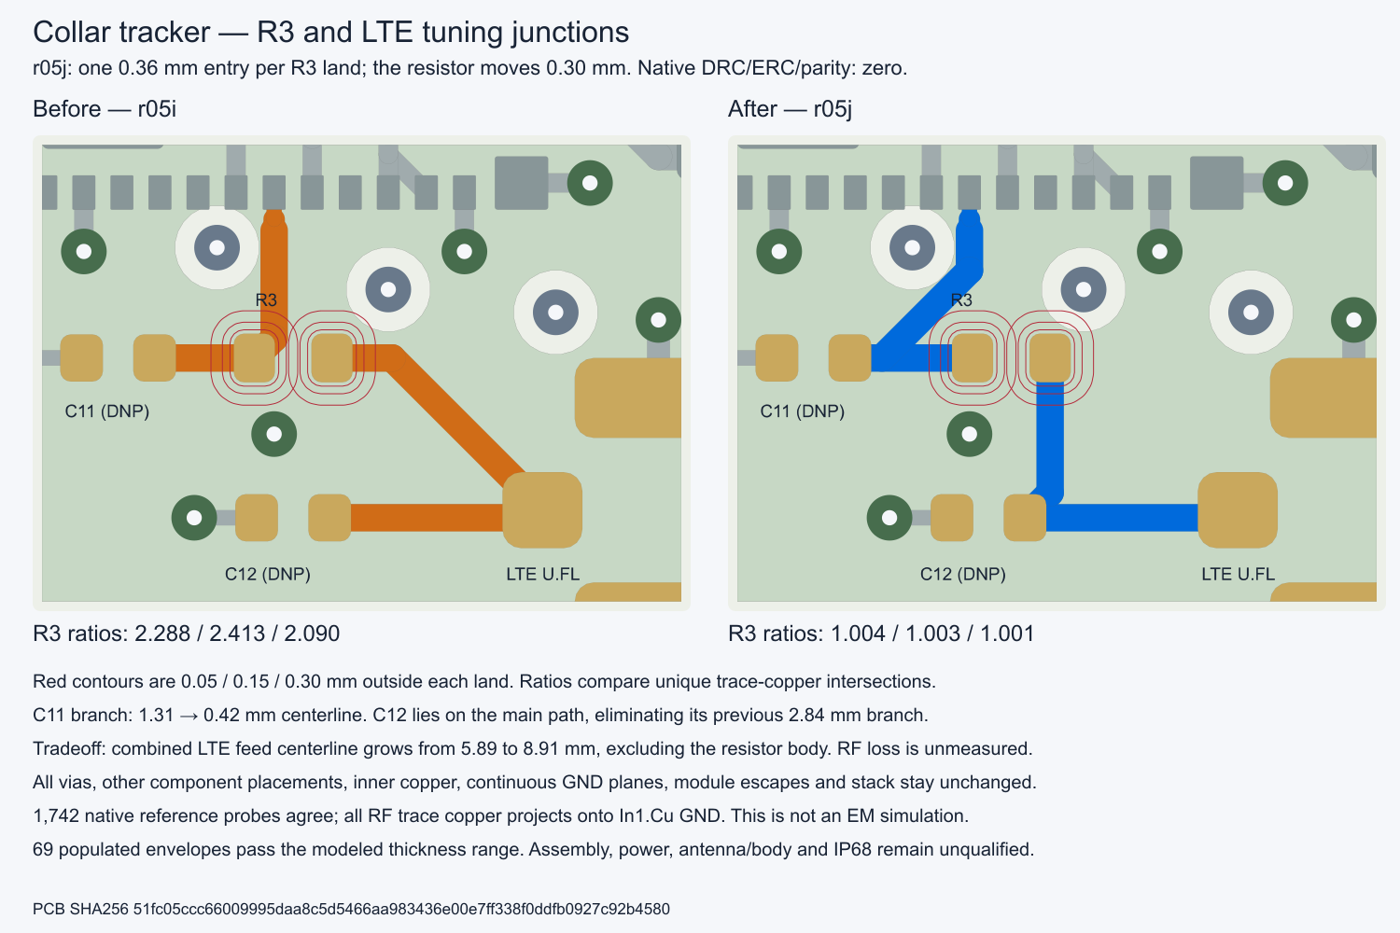
experiments/power-r05j-rf-junctions/evidence/rf-junction-review.png
