gokselozgur5/pcb-design-collar-tracker/experiments/power-r05l-charge-interlock/evidence/jlc-check1/screen.png

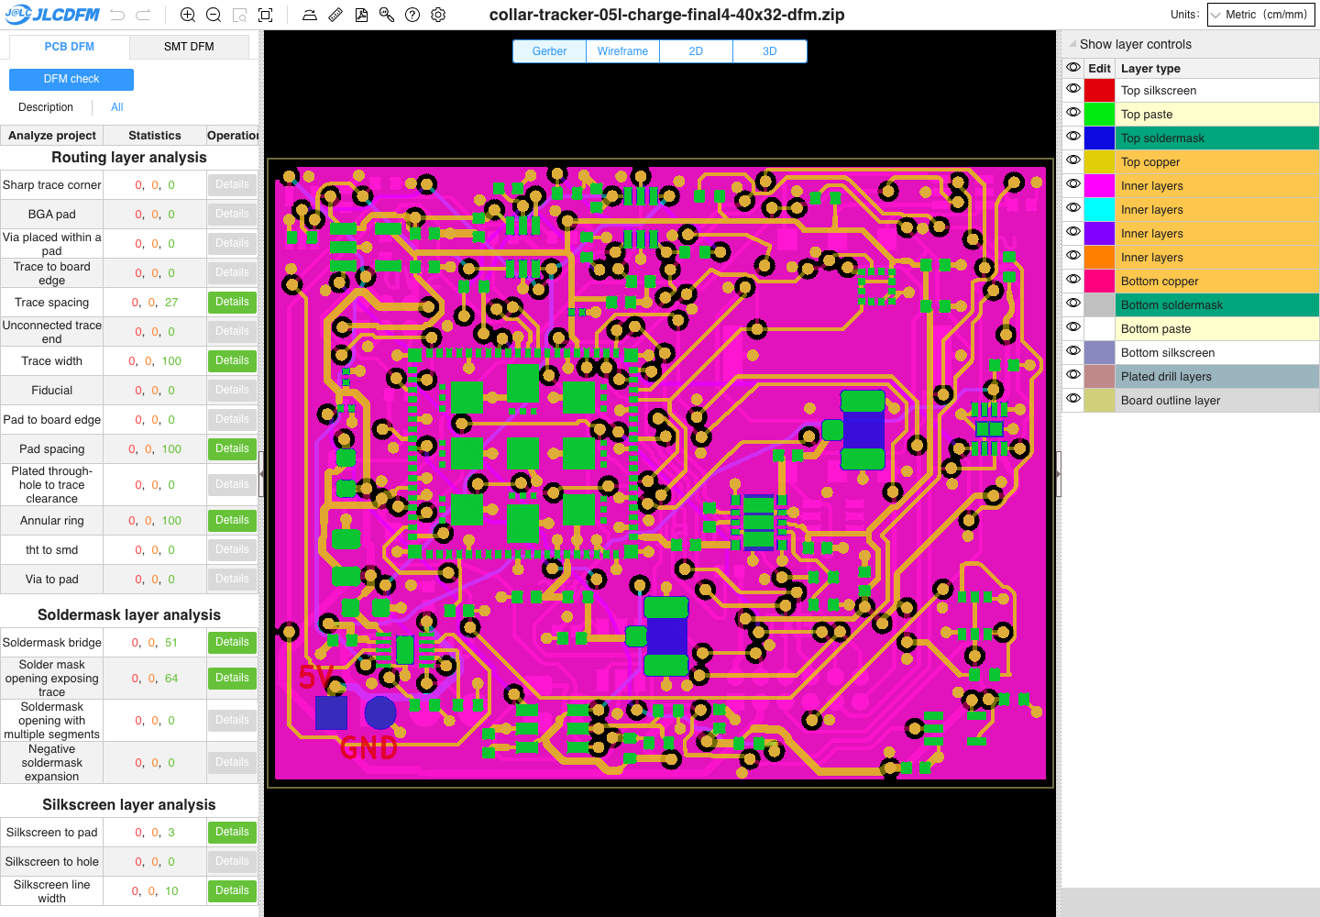
experiments/power-r05l-charge-interlock/evidence/jlc-check1/screen.png
