gokselozgur5/pcb-design-collar-tracker/experiments/power-r05-supervised/previews/schematic.pdf

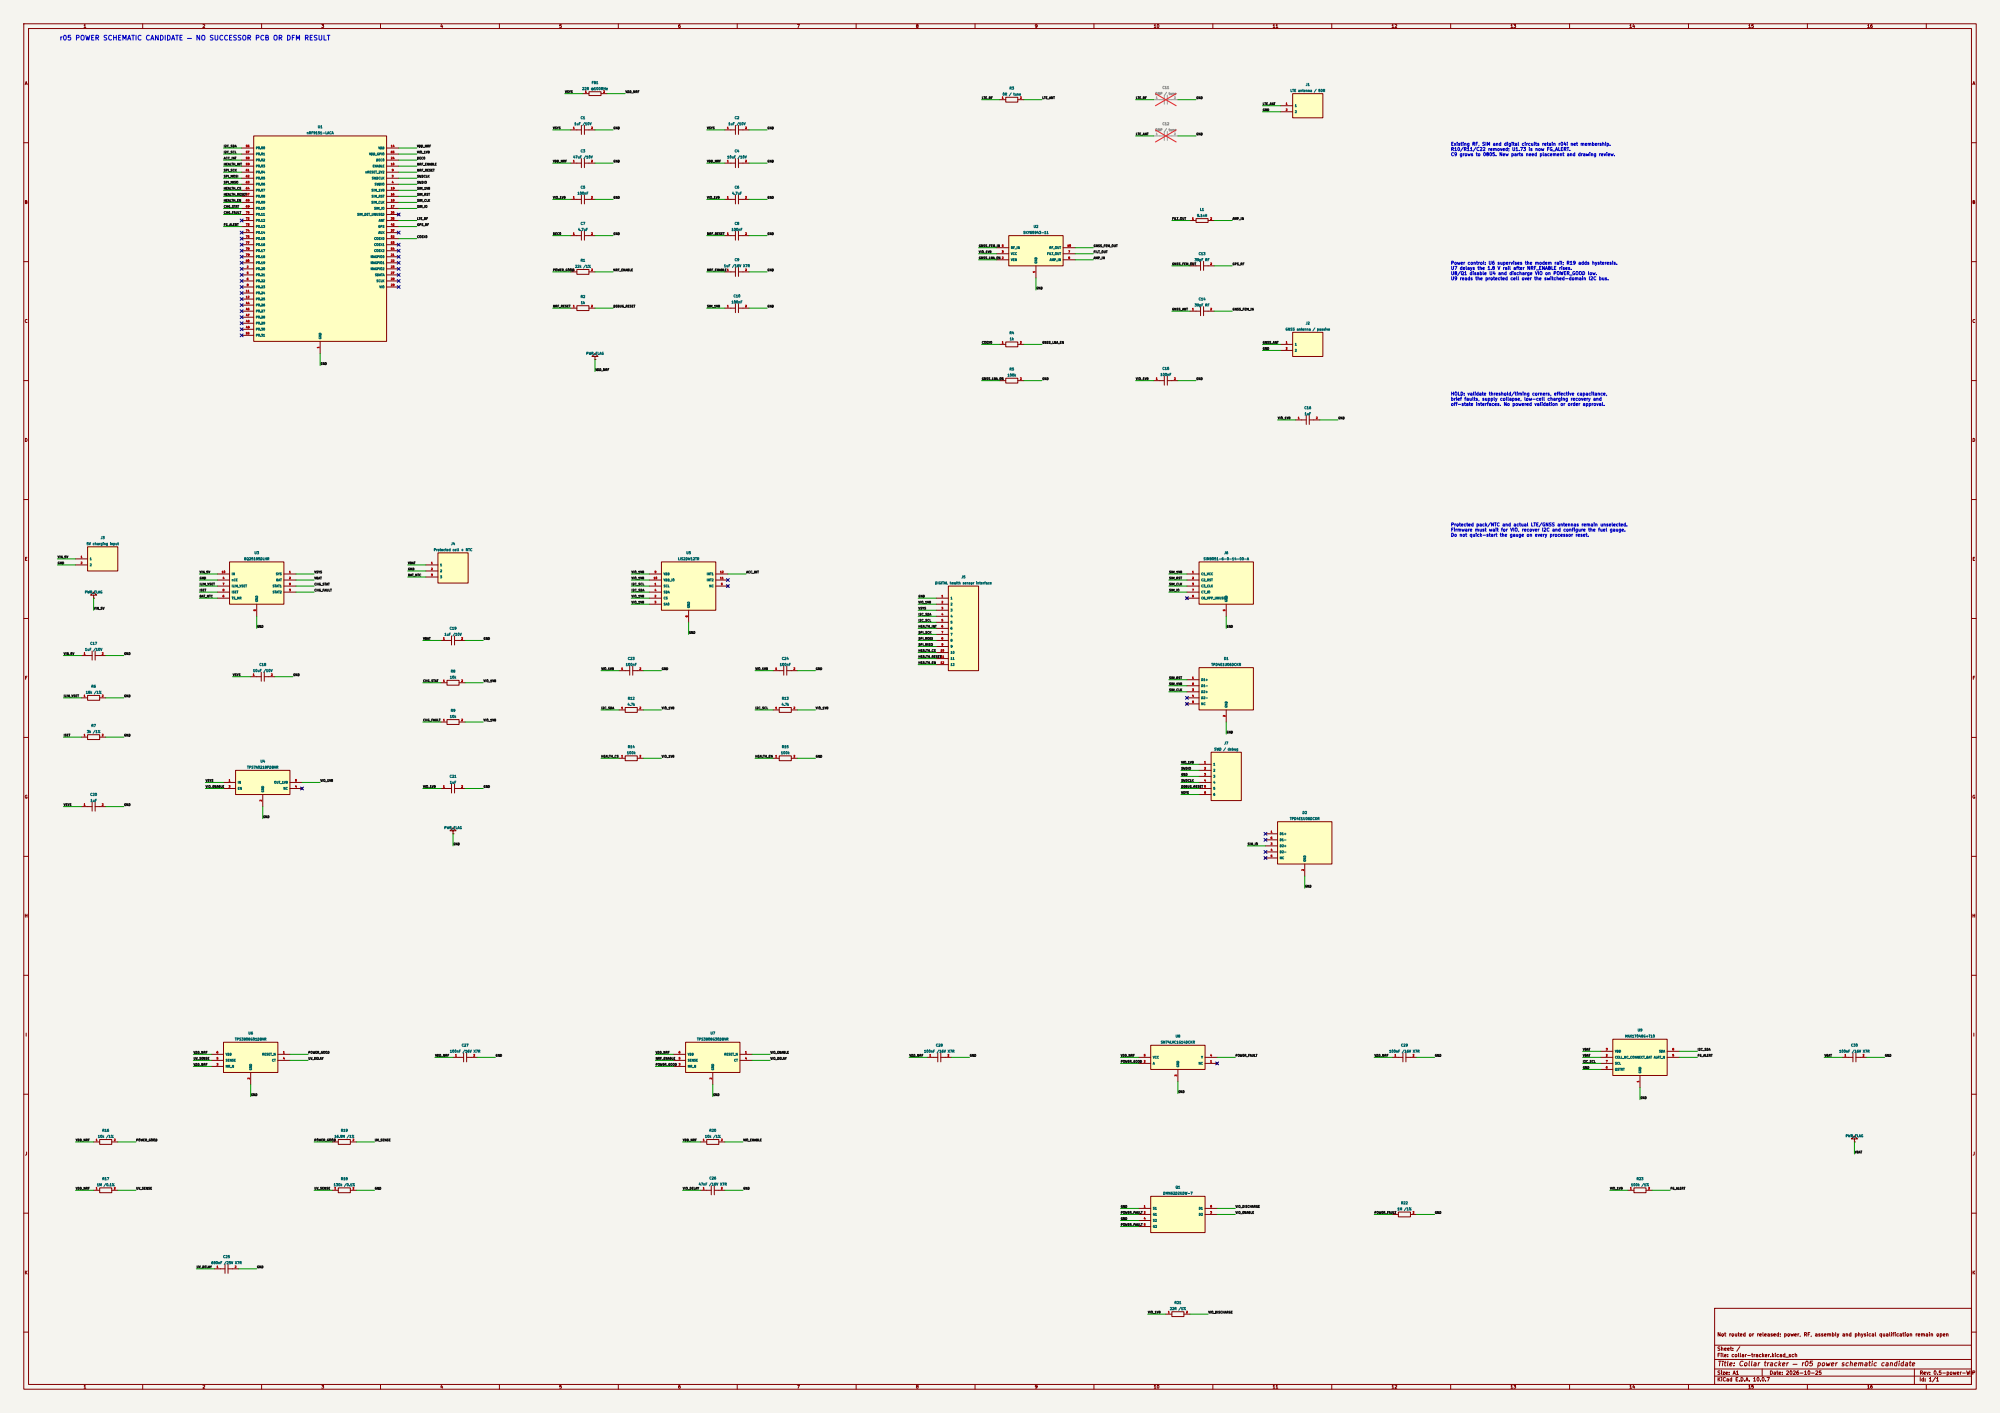
[picture p215: page 1]

r05 POWER SCHEMATIC CANDIDATE — NO SUCCESSOR PCB OR DFM RESULT

Existing RF, SIM and digital circuits retain r04i net membership.
R10/R11/C22 removed; U1.73 is now FG_ALERT. C9 grows to 0805. New parts need placement and drawing review. HOLD: validate threshold/timing corners, effective capacitance, brief faults, supply collapse, low-cell charging recovery and

Power control: U6 supervises the modem rail; R19 adds hysteresis. U7 delays the 1.8 V rail after NRF_ENABLE rises. U8/Q1 disable U4 and discharge VIO on POWER_GOOD low. U9 reads the protected cell over the switched-domain I2C bus. Protected pack/NTC and actual LTE/GNSS antennas remain unselected. Firmware must wait for VIO, recover I2C and configure the fuel gauge. Do not quick-start the gauge on every processor reset.

off-state interfaces. No powered validation or order approval.

Not routed or released; power, RF, assembly and physical qualification remain open

Sheet: /
File: collar-tracker.kicad_sch
Title: Collar tracker — r05 power schematic candidate
KiCad E.D.A. 10.0.7
