gokselozgur5/pcb-design-collar-tracker/(list of files, drawings)

Other design files:
build/pcb/collar-r4.dsn
build/pcb/collar-r5.dsn
build/pcb/collar-r6.dsn
build/pcb/collar-tracker.dsn
experiments/35x28-in2/build/collar-tracker.dsn
experiments/35x28-in2/build/route-r1-input.dsn
experiments/35x28/build/collar-tracker.dsn
experiments/35x28/build/route-r2-input.dsn
experiments/paul-nanosim-r04/build/collar-tracker.dsn
experiments/paul-nanosim-r04/build/route3.dsn
experiments/paul-nanosim-r04c/build/fanout.dsn
experiments/paul-nanosim-r04d/build/contact-copper.dsn
experiments/paul-nanosim-r04d/build/contact-ground.dsn
experiments/paul-nanosim-r04d/build/contact-minimal.dsn
experiments/paul-nanosim-r04d/build/contact-normalized.dsn
experiments/paul-nanosim-r04d/build/contact-pads.dsn
experiments/paul-nanosim-r04d/build/contact-replay.dsn
experiments/paul-nanosim-r04d/build/native-repro.dsn
experiments/paul-nanosim-r04d/build/repair-native-ground.dsn
experiments/paul-nanosim-r04d/build/repair-native-pads.dsn
experiments/paul-nanosim-r04d/build/repair-protected.dsn
experiments/paul-nanosim-r04e/build/clean-contacts.dsn
experiments/paul-nanosim-r04e/build/clean-native.dsn
experiments/paul-nanosim-r04e/build/clean-unlocked.dsn
experiments/paul-nanosim-r04e/build/contact-minimal.dsn
experiments/paul-nanosim-r04e/build/lockcheck-contacts.dsn
experiments/paul-nanosim-r04e/build/lockcheck-native.dsn
experiments/paul-nanosim-r04e/build/native.dsn
experiments/paul-nanosim-r04f-40x32/build/contacts.dsn
experiments/paul-nanosim-r04f-40x32/build/native.dsn
experiments/power-r05-supervised/build/power-route1-contacts.dsn
experiments/power-r05-supervised/build/power-route1.dsn
experiments/power-r05-supervised/evidence/pcb-seed.json
experiments/power-r05l-charge-interlock/evidence/pcb-seed.json
experiments/power-r05l-charge-interlock/evidence/schematic-seed.json
