gokselozgur5/pcb-design-collar-tracker/experiments/pcba-r05m-rohm-q1/hardware/collar-tracker.kicad_pcb

## KiCad design experiments/pcba-r05m-rohm-q1/hardware/collar-tracker.kicad_pcb (2026-10-26)

Schematic: collar-tracker.kicad_sch, Collar tracker — r05l hardware charge interlock

Parts:
C1: 1uF /10V; C1_C_0201_0603Metric; MPN GRM033R61A105ME15D
C2: 1uF /10V; C2_C_0201_0603Metric; MPN GRM033R61A105ME15D
C3: 47uF /10V; C3_C_0805_2012Metric; MPN GRM21BR61A476ME15L
C4: 10uF /10V; C4_C_0603_1608Metric; MPN GRM188R61A106MAALD
C5: 100nF; C5_C_0201_0603Metric; MPN GRM033R60J104ME19D
C6: 4.7uF; C6_C_0402_1005Metric; MPN GRM155R60J475ME47D
C7: 4.7uF; C7_C_0402_1005Metric; MPN GRM155R60J475ME47D
C8: 100nF; C8_C_0201_0603Metric; MPN GRM033R60J104ME19D
C9: 1uF /16V X7R; C9_C_0805_2012Metric; MPN GRM21BR71C105KA01L
C10: 100nF; C10_C_0402_1005Metric; MPN GRM155R71C104KA88D
C11: DNP / tune; C11_C_0402_1005Metric; not fitted
C12: DNP / tune; C12_C_0402_1005Metric; not fitted
C13: 39pF RF; C13_C_0402_1005Metric; MPN GJM1555C1H390FB01D
C14: 39pF RF; C14_C_0402_1005Metric; MPN GJM1555C1H390FB01D
C15: 100nF; C15_C_0402_1005Metric; MPN GRM155R71C104KA88D
C16: 1uF; C16_C_0402_1005Metric; MPN GRM155R61A105KE15D
C17: 1uF /10V; C17_C_0402_1005Metric; MPN GRM155R61A105KE15D
C18: 10uF /10V; C18_C_0603_1608Metric; MPN GRM188R61A106MAALD
C19: 1uF /10V; C19_C_0402_1005Metric; MPN GRM155R61A105KE15D
C20: 1uF; C20_C_0402_1005Metric; MPN GRM155R61A105KE15D
C21: 1uF; C21_C_0402_1005Metric; MPN GRM155R61A105KE15D
C23: 100nF; C23_C_0402_1005Metric; MPN GRM155R71C104KA88D
C24: 100nF; C24_C_0402_1005Metric; MPN GRM155R71C104KA88D
C25: 1uF /16V X7R; C25_C_0805_2012Metric; MPN GRM21BR71C105KA01L
C26: 47nF /16V X7R; C26_C_0402_1005Metric; MPN GRM155R71C473KA01D
C27: 100nF /16V X7R; C27_C_0402_1005Metric; MPN GRM155R71C104KA88D
C28: 100nF /16V X7R; C28_C_0402_1005Metric; MPN GRM155R71C104KA88D
C29: 100nF /16V X7R; C29_C_0402_1005Metric; MPN GRM155R71C104KA88D
C30: 100nF /16V X7R; C30_C_0402_1005Metric; MPN GRM155R71C104KA88D
C31, C32, C33: 100nF /16V; C30_C_0402_1005Metric; MPN GRM155R71C104KA88D
C34, C35, C36: 1nF /50V C0G; C30_C_0402_1005Metric; MPN GRM1555C1H102JA01D
D1, D2: TPD4E1U06DCKR; MPN TPD4E1U06DCKR
FB1: 22R @100MHz; FB1_L_0603_1608Metric; MPN BLM18SD220SN1D
J1: LTE antenna / 50R; J1_U.FL_Hirose_U.FL-R-SMT-1_Vertical; MPN U.FL-R-SMT-1(10)
J2: GNSS antenna / passive; J2_U.FL_Hirose_U.FL-R-SMT-1_Vertical; MPN U.FL-R-SMT-1(10)
J3: 5V charging input; J3_Solder_1x02_P2.5mm
J4: Protected cell + NTC; J4_Solder_1x03_P2.5mm
J5: DIGITAL health sensor interface; J5_Contact_2x06_P1.27mm
J6: SIM8051-6-0-14-00-A; SIM8051_6_0_14_00_A; MPN SIM8051-6-0-14-00-A
J7: SWD / debug; J7_Contact_2x03_P1.27mm
L1: 9.1nH; L1_L_0402_1005Metric; MPN LQW15AN9N1J00D
Q1: UM6K34NTCN; Q1_SOT-363_SC-70-6; MPN UM6K34NTCN
R1: 22k /1%; R1_R_0402_1005Metric; MPN RC0402FR-0722KL
R2: 1k; R2_R_0402_1005Metric; MPN RC0402FR-071KL
R3: 0R / tune; R3_R_0402_1005Metric; MPN RC0402JR-070RL
R4: 1k; R4_R_0402_1005Metric; MPN RC0402FR-071KL
R5: 100k; R5_R_0402_1005Metric; MPN RC0402FR-07100KL
R6: 18k /1%; R6_R_0402_1005Metric; MPN RC0402FR-0718KL
R7: 3k /1%; R7_R_0402_1005Metric; MPN RC0402FR-073KL
R8: 10k; R8_R_0402_1005Metric; MPN RC0402FR-0710KL
R9: 10k; R9_R_0402_1005Metric; MPN RC0402FR-0710KL
R12: 4.7k; R12_R_0402_1005Metric; MPN RC0402FR-074K7L
R13: 4.7k; R13_R_0402_1005Metric; MPN RC0402FR-074K7L
R14: 100k; R14_R_0402_1005Metric; MPN RC0402FR-07100KL
R15: 100k; R15_R_0402_1005Metric; MPN RC0402FR-07100KL
R16: 10k /1%; R16_R_0402_1005Metric; MPN RC0402FR-0710KL
R17: 200k /0.1%; R17_R_0402_1005Metric; MPN RT0402BRD07200KL
R18: 26.1k /0.1%; R18_R_0402_1005Metric; MPN RT0402BRD0726K1L
R19: 3.4M /1%; R19_R_0402_1005Metric; MPN RC0402FR-073M4L
R20: 10k /1%; R20_R_0402_1005Metric; MPN RC0402FR-0710KL
R21: 22R /1%; R21_R_0402_1005Metric; MPN CRCW040222R0FKEDHP
R22: 1M /1%; R22_R_0402_1005Metric; MPN RC0402FR-071ML
R23: 100k /1%; R23_R_0402_1005Metric; MPN RC0402FR-07100KL
R24: 196k /0.1%; R16_R_0402_1005Metric; MPN RT0402BRD07196KL
R25, R27: 49.9k /0.1%; R16_R_0402_1005Metric; MPN RT0402BRD0749K9L
R26: 27.4k /0.1%; R16_R_0402_1005Metric; MPN RT0402BRD0727K4L
R28, R29, R30: 100k; R16_R_0402_1005Metric; MPN RC0402FR-07100KL
U1: nRF9151-LACA; U1_LGA_9151_12.1x11.1mm; MPN NRF9151-LACA-R
U2: SKY65943-11; U2_SKY65943_DK10171; MPN SKY65943-11
U3: BQ25185DLHR; U3_Texas_DLH0010A_WSON-10-1EP_2.2x2mm_P0.4mm_EP0.9x1.5mm; MPN BQ25185DLHR
U4: TPS7A0218PDBVR; U4_SOT-23-5; MPN TPS7A0218PDBVR
U5: LIS2DW12TR; U5_LGA-12_2x2mm_P0.5mm; MPN LIS2DW12TR
U6: TPS3808G01DBVR; U6_SOT-23-6; MPN TPS3808G01DBVR
U7: TPS3808G30DBVR; U7_SOT-23-6; MPN TPS3808G30DBVR
U8: SN74LVC1G14DCKR; U8_SOT-353_SC-70-5; MPN SN74LVC1G14DCKR
U9: MAX17048G+T10; U9_MAX17048_T822_3_90_0065E; MPN MAX17048G+T10
U10: TLV3012BIDCKR / HOT; TI_DCK0006A; MPN TLV3012BIDCKR
U11: TLV3012BIDCKR / COLD; TI_DCK0006A; MPN TLV3012BIDCKR
U12: SN74LVC1G00DCKR; TI_DCK0005A; MPN SN74LVC1G00DCKR

Connections:
/ACC_INT: U1.58 (P0.02), U5.12 (INT1)
/AMP_IN: L1.2, U2.8 (AMP_IN)
/BAT_NTC: C36.1, J4.3, U3.6 (TS_MR), U10.3 (IN+), U11.4 (IN-)
/CHARGE_DISABLE: R28.2, U3.4 (nCE), U12.4 (Y_DISABLE)
/CHG_COLD_LIMIT: R26.2, R27.1, U11.3 (IN+)
/CHG_COLD_OK: R30.1, U11.1 (OUT), U12.2 (B_COLD_OK)
/CHG_COLD_REF: C35.1, R26.1, U11.5 (REF_1V242)
/CHG_FAULT: R9.1, U1.70 (P0.11), U3.3 (STAT2)
/CHG_HOT_LIMIT: R24.2, R25.1, U10.4 (IN-)
/CHG_HOT_OK: R29.1, U10.1 (OUT), U12.1 (A_HOT_OK)
/CHG_HOT_REF: C34.1, R24.1, U10.5 (REF_1V242)
/CHG_STAT: R8.1, U1.69 (P0.10), U3.9 (STAT1)
/COEX0: R4.1, U1.52 (COEX0)
/DEBUG_RESET: J7.5, R2.2
/DEC0: C7.1, U1.24 (DEC0)
/FG_ALERT: R23.2, U1.73 (P0.13), U9.5 (ALRT_N)
/FILT_OUT: L1.1, U2.7 (FILT_OUT)
/GND: C1.2, C2.2, C3.2, C4.2, C5.2, C6.2, C7.2, C8.2, C9.2, C10.2, C11.2, C12.2, C15.2, C16.2, C17.2, C18.2, C19.2, C20.2, C21.2, C23.2, C24.2, C25.2, C26.2, C27.2, C28.2, C29.2, C30.2, C31.2, C32.2, C33.2, C34.2, C35.2, C36.2, D1.2 (GND), D2.2 (GND), J1.2, J2.2, J3.2, J4.2, J5.1, J6.5 (GND), J6.8 (GND), J7.3, Q1.1 (S1), Q1.4 (S2), R5.2, R6.2, R7.2, R15.2, R18.2, R22.2, R25.2, R27.2, R29.2, R30.2, U1.1 (GND), U1.7 (GND), U1.13 (GND), U1.15 (GND), U1.20 (GND), U1.25 (GND), U1.30 (GND), U1.34 (GND), U1.36 (GND), U1.38 (GND), U1.39 (GND), U1.40 (GND), U1.41 (GND), U1.43 (GND), U1.46 (GND), U1.51 (GND), U1.55 (GND), U1.60 (GND), U1.66 (GND), U1.71 (GND), U1.76 (GND), U1.105 (GND), U1.106 (GND), U1.107 (GND), U1.108 (GND), U1.109 (GND), U1.110 (GND), U1.111 (GND), U1.112 (GND), U1.113 (GND), U2.1 (GND), U2.4 (GND), U2.6 (GND), U2.9 (GND), U2.11 (GND), U3.5 (GND), U3.11 (GND), U4.2 (GND), U5.6 (GND), U5.7 (GND), U5.8 (GND), U6.2 (GND), U7.2 (GND), U8.3 (GND), U9.1 (GND), U9.4 (GND), U9.6 (QSTRT), U9.9 (GND), U10.2 (GND), U11.2 (GND), U12.3 (GND)
/GNSS_ANT: C14.1, J2.1
/GNSS_FEM_IN: C14.2, U2.5 (RF_IN)
/GNSS_FEM_OUT: C13.1, U2.10 (RF_OUT)
/GNSS_LNA_EN: R4.2, R5.1, U2.2 (VEN)
/GPS_RF: C13.2, U1.42 (GPS)
/HEALTH_CS: J5.10, R14.1, U1.64 (P0.07)
/HEALTH_EN: J5.12, R15.1, U1.68 (P0.09)
/HEALTH_INT: J5.6, U1.59 (P0.03)
/HEALTH_RESET: J5.11, U1.67 (P0.08)
/I2C_SCL: J5.5, R13.1, U1.57 (P0.01), U5.1 (SCL), U9.7 (SCL)
/I2C_SDA: J5.4, R12.1, U1.56 (P0.00), U5.4 (SDA), U9.8 (SDA)
/ILIM_VSET: R6.1, U3.7 (ILIM_VSET)
/ISET: R7.1, U3.8 (ISET)
/LTE_ANT: C12.1, J1.1, R3.2
/LTE_RF: C11.1, R3.1, U1.35 (ANT)
/NRF_ENABLE: C9.1, R1.2, U1.10 (ENABLE), U7.5 (SENSE)
/NRF_RESET: C8.1, R2.1, U1.9 (nRESET_2V2)
/POWER_FAULT: Q1.2 (G1), Q1.5 (G2), R22.1, U8.4 (Y)
/POWER_GOOD: R1.1, R16.2, R19.1, U6.1 (RESET_N), U7.3 (MR_N), U8.2 (A)
/SIM_1V8: C10.1, D1.6 (D1-), J6.1 (C1_VCC), U1.19 (SIM_1V8)
/SIM_CLK: D1.3 (D2+), J6.3 (C3_CLK), U1.18 (SIM_CLK)
/SIM_IO: D2.3 (D2+), J6.7 (C7_IO), U1.17 (SIM_IO)
/SIM_RST: D1.1 (D1+), J6.2 (C2_RST), U1.16 (SIM_RST)
/SPI_MISO: J5.9, U1.63 (P0.06)
/SPI_MOSI: J5.8, U1.62 (P0.05)
/SPI_SCK: J5.7, U1.61 (P0.04)
/SWDCLK: J7.4, U1.3 (SWDCLK)
/SWDIO: J7.2, U1.4 (SWDIO)
/UV_DELAY: C25.1, U6.4 (CT)
/UV_SENSE: R17.2, R18.1, R19.2, U6.5 (SENSE)
/VBAT: C19.1, C30.1, J4.1, U3.2 (BAT), U9.2 (CELL_NC_CONNECT_BAT), U9.3 (VDD)
/VDD_NRF: C3.1, C4.1, C27.1, C28.1, C29.1, FB1.2, R16.1, R17.1, R20.1, U1.14 (VDD), U6.3 (MR_N), U6.6 (VDD), U7.6 (VDD), U8.5 (VCC)
/VIN_5V: C17.1, J3.1, U3.10 (IN)
/VIO_1V8: C5.1, C6.1, C15.1, C16.1, C21.1, C23.1, C24.1, J5.2, J7.1, R8.2, R9.2, R12.2, R13.2, R14.2, R21.1, R23.1, U1.65 (VDD_GPIO), U2.3 (VCC), U4.5 (OUT_1V8), U5.2 (CS), U5.3 (SA0), U5.9 (VDD), U5.10 (VDD_IO)
/VIO_DELAY: C26.1, U7.4 (CT)
/VIO_DISCHARGE: Q1.6 (D1), R21.2
/VIO_ENABLE: Q1.3 (D2), R20.2, U4.3 (EN), U7.1 (RESET_N)
/VSYS: C1.1, C2.1, C18.1, C20.1, C31.1, C32.1, C33.1, FB1.1, J5.3, J7.6, R28.1, U3.1 (SYS), U4.1 (IN), U10.6 (V+), U11.6 (V+), U12.5 (VCC)

Notes on the sheet:
r05k SELECTED COMPONENTS — PHYSICAL ELECTRICAL / RF QUALIFICATION OPEN
Circuit topology retains r05; PCB routing retains r05j. R17/R18/R19: 200k / 26.1k / 3.4M; C25: 1uF. All 65 fitted component references have exact candidate MPNs.
Power control: U6 supervises the modem rail; R19 adds hysteresis. U7 delays the 1.8 V rail after NRF_ENABLE rises. U8/Q1 disable U4 and discharge VIO on POWER_GOOD low. U9 reads the protected cell over the switched-domain I2C bus.
HOLD: validate threshold/timing corners, effective capacitance, brief faults, supply collapse, low-cell charging recovery and off-state interfaces. No powered validation or order approval.
Protected pack/NTC and actual LTE/GNSS antennas remain unselected. Firmware must wait for VIO, recover I2C and configure the fuel gauge. Do not quick-start the gauge on every processor reset.
09 / HARDWARE CELL-TEMPERATURE CHARGE INTERLOCK
Both comparator outputs must be HIGH to enable charging. POR outputs LOW; NAND drives /CE HIGH. Always-on VSYS supply: independent of MCU/VIO reset and undervoltage shutdown. Candidate 103JT-025 must be bonded to the cell. Open/short sensor inhibits charging. Conservative window; threshold toleranc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

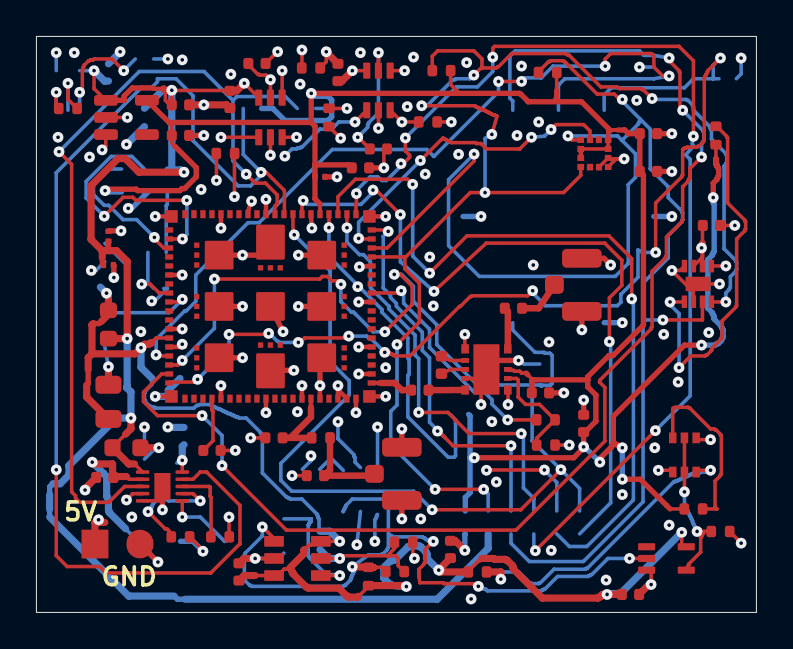
[picture p216: board collar-tracker.kicad_pcb from above]

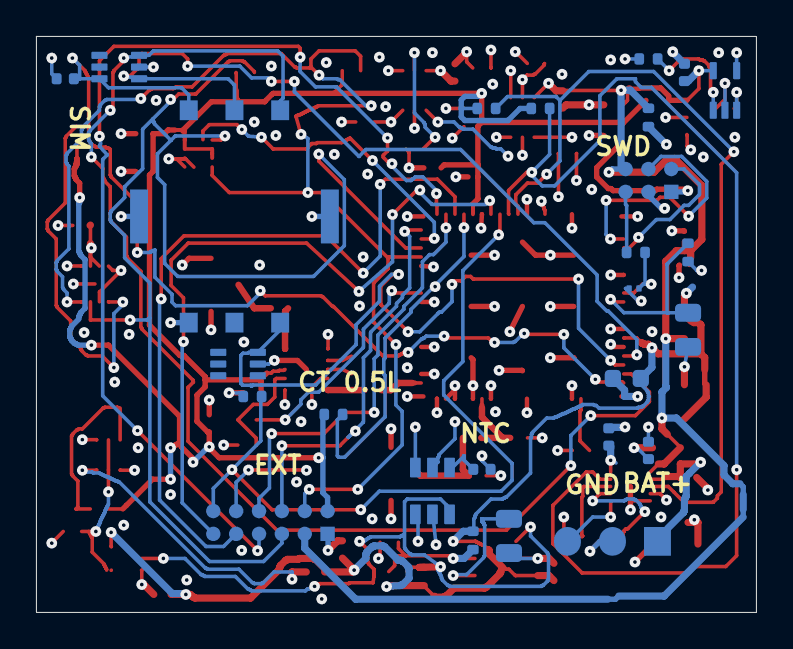
[picture p217: board collar-tracker.kicad_pcb from below]

Board: 6 copper layers, 40.0 x 32.0 mm, 87 parts (26 on the bottom side), 56 nets.
