gokselozgur5/pcb-design-collar-tracker/(commit log)

2026-10-25 feat(hardware): preserve tracker schematic and mechanical study
    Import the initial 30x22 mm KiCad design, reproducible scripts, sizing models and early DFM artifacts. Keep unresolved power, RF and assembly requirements explicit.
    [bom.csv, collar-r4.dsn, collar-r5.dsn, collar-r6.dsn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]
2026-10-25 feat(pcb): preserve the 35x28 mm routed layout
    Record the larger-board trial, routing helpers, native checks and 0.3 manufacturing package.
    [collar-tracker-B_Cu.gbl, collar-tracker-B_Mask.gbs, collar-tracker-B_Paste.gbp, collar-tracker-B_Silkscreen.gbo, collar-tracker-Edge_Cuts.gm1, collar-tracker-F_Cu.gtl, collar-tracker-F_Mask.gts, collar-tracker-F_Paste.gtp]
2026-10-25 fix(pcb): preserve the 0.3.1 solder-mask revision
    Record the first 35x28 mask corrections and their geometry checks without rewriting the earlier board.
    [bom.csv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]
2026-10-25 fix(pcb): preserve the 0.3.2 mask-window revision
    Record the revised mask openings, release package and manufacturer-review limits.
    [bom.csv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]
2026-10-25 fix(pcb): preserve 0.3.3 footprint and clearance changes
    Record project-local footprints and native cleanup. The later reproduction found one remaining JLC warning; this is not the final all-green baseline.
    [bom.csv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]
2026-10-25 test(pcb): preserve 0.3.4 all-green evidence and readiness audit
    Bind the immutable PCB/Gerber bytes to two real JLC DFM results and native checks. Preserve the separate ground-return, power and assembly blockers.
    [bom.csv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]
2026-10-25 wip(pcb): checkpoint nano-SIM schematic and Paul layout work
    Add the real socket and ESD candidates, manufacturer references and the isolated r04 builder. The builder currently fails during KiCad board mutation; no new PCB, DRC pass or DFM acceptance is claimed.
    [bom.csv, collar-tracker.kicad_sch]
2026-10-25 chore(handoff): add Claude resume context and portable checks
    Load project rules and current state through CLAUDE.md. Document the exact unfinished r04 step, preserve scoped authorizations, and add read-only source/evidence verification plus configurable local tool entry points.
2026-10-25 docs(pcb): establish reusable design and acceptance workflow
    Document the PCB Design process from requirements through manufacture and powered acceptance, with software-engineering equivalents, evidence gates, atomic Git workflow and reusable lessons. Link it from the project and agent entry points.
2026-10-25 wip(pcb): connect inner ground planes and preserve first nano-SIM route
    Save local fanout for 81 GND pads through 68 vias and the first imported outer-layer route. Native DRC still reports 14 opens and three dangling vias; the new revision has no JLC acceptance. Record the actual source, evidence and next routing step for continuation.
    [collar-tracker.dsn, collar-tracker.kicad_pcb, ground-base.kicad_pcb]
2026-10-25 docs: make repository content English and adopt renamed GitHub origin
    Translate current and historical engineering documents, the reusable PCB Design workflow, agent instructions and generated mechanical review labels. Preserve released CAD/manufacturing bytes and raw evidence. Record English as the standing language for GitHub content.
2026-10-25 wip(routing): add footprint-aware completion and ground return planning
2026-10-25 wip(pcb): rework charger escapes and retain native routing evidence
    [before-charger-local-rework.kicad_pcb, collar-tracker.kicad_pcb, route3.dsn, routed-1.kicad_pcb, routed-2.kicad_pcb, routed-3.kicad_pcb, routed-5.kicad_pcb]
2026-10-25 feat(review): audit ground planes and actual power paths
2026-10-25 wip(pcb): preserve localized charger trials and routing evidence
    [bom.csv, clearance-base.kicad_pcb, collar-tracker.kicad_pcb, collar-tracker.kicad_sch, corridor-2.kicad_pcb, corridor-base.kicad_pcb, fanout.dsn, ground-base.kicad_pcb]
2026-10-25 docs: refresh English PCB handoff and review lessons
2026-10-25 feat(review): audit native copper contacts and local ground paths
2026-10-25 fix(router): preserve native contacts and unlock movable signal routes
    [clean-contacts.dsn, clean-unlocked.dsn, contact-minimal.dsn, lockcheck-contacts.dsn, lockcheck-native.dsn]
2026-10-25 wip(pcb): preserve five-open SIM escape trial and rejected route evidence
    [bom.csv, clean-native.dsn, collar-tracker.kicad_pcb, collar-tracker.kicad_sch, contact-copper.dsn, contact-ground.dsn, contact-minimal-roundtrip.kicad_pcb, contact-minimal.dsn]
2026-10-25 wip(pcb): complete 40x32 routing and add 15 ground returns
    [bom.csv, collar-tracker.kicad_pcb, collar-tracker.kicad_sch, connected-before-returns.kicad_pcb, connected-with-unused-vias.kicad_pcb, contacts.dsn, growth-initial.kicad_pcb, last-connection.kicad_pcb]
2026-10-25 docs: publish English native-clean PCB handoff and remaining reviews
2026-10-25 docs: preserve the first 40x32 JLC result and two measured warnings
    [collar-tracker-B_Cu.gbl, collar-tracker-B_Mask.gbs, collar-tracker-B_Paste.gbp, collar-tracker-B_Silkscreen.gbo, collar-tracker-Edge_Cuts.gm1, collar-tracker-F_Cu.gtl, collar-tracker-F_Mask.gts, collar-tracker-F_Paste.gtp]
2026-10-25 fix: place labels using native board bounds and silk constraints
    [size_trial_labels.py]
2026-10-25 wip(pcb): reduce return gaps and record two clean r04g DFM runs
    [bom.csv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]
2026-10-25 WIP: preserve r04h layout with unresolved SIM entry clearance
    [bom.csv, collar-tracker.kicad_pcb, collar-tracker.kicad_sch, return-only-native-clean.kicad_pcb]
2026-10-25 Finalize r04i SIM access and preserve two green DFM analyses
    [bom.csv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]
2026-10-25 Add swim-r01 enclosure prototype and checked review bundle
    [body.stl, boot.stl, carrier.stl, contact.stl, contact_seal.stl, dock.stl, enclosure.scad, lid.stl]
2026-10-25 Clear carrier and charging hardware in the swim enclosure
    [body.stl, boot.stl, carrier.stl, contact.stl, contact_seal.stl, dock.stl, enclosure.scad, lid.stl]
2026-10-25 Publish the populated enclosure review and continuation checks
2026-10-25 Record source-verified power-domain gaps without changing r04i
2026-10-25 feat(pcb): add WIP supervised power schematic and conditional checks
    [bom.csv, collar-tracker.kicad_sch]
2026-10-25 feat(pcb): checkpoint r05 layout with 23 unfinished connections
    [collar-tracker.kicad_pcb, collar-tracker.kicad_sch, ground-base.kicad_pcb, pcb-seed.json, placement-first.kicad_pcb, power-route1-contacts.dsn, power-route1.dsn, seed-before-placement.kicad_pcb]
2026-10-25 chore(pcb): verify r05 handoff and document native crash recovery
    [resume.py, verify_handoff.py]
2026-10-25 fix(pcb): preserve unchanged native RF track identities on import
2026-10-25 feat(pcb): checkpoint WIP r05b pin exits with 14 open connections
    [bom.csv, collar-tracker.kicad_pcb, collar-tracker.kicad_sch]
2026-10-25 feat(mechanical): screen r05b populated envelopes with open part requirements
    [enclosure.scad, parameters.scad, populated.scad]
2026-10-25 chore(pcb): verify r05b evidence and document exact continuation
2026-10-25 Add guarded capacitor relocation and unused copper cleanup
2026-10-25 Save r05c routing progress and preliminary populated fit
    [bom.csv, collar-tracker.kicad_pcb, collar-tracker.kicad_sch, enclosure.scad, parameters.scad, populated.scad]
2026-10-25 Record unselected joint-routing trials and their limits
    [bom.csv, collar-tracker.kicad_pcb, collar-tracker.kicad_sch]
2026-10-25 Save five-open r05f layout and refreshed populated fit
    [bom.csv, collar-tracker.kicad_pcb, collar-tracker.kicad_sch, enclosure.scad, parameters.scad, populated.scad]
2026-10-25 Support six-layer routing with ground-return and topology checks
2026-10-25 Preserve the unselected r05g local-crossing trial
    [bom.csv, collar-tracker.kicad_pcb, collar-tracker.kicad_sch]
2026-10-25 Complete r05h routing and restore local ground returns
    [bom.csv, collar-tracker.kicad_pcb, collar-tracker.kicad_sch]
2026-10-25 Verify r05h with two clean JLC analyses and refresh the design handoff
    [collar-tracker-B_Cu.gbl, collar-tracker-B_Mask.gbs, collar-tracker-B_Paste.gbp, collar-tracker-B_Silkscreen.gbo, collar-tracker-Edge_Cuts.gm1, collar-tracker-F_Cu.gtl, collar-tracker-F_Mask.gts, collar-tracker-F_Paste.gtp]
2026-10-25 Revise RF port routing and record two clean r05i DFM runs
    [bom.csv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]
2026-10-25 Balance R3 entries and preserve two clean r05j DFM analyses
    [bom.csv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]
2026-10-25 Select power components and model tolerance, leakage and capacitor bounds
    [check_power_parts.py]
2026-10-25 Apply selected components in r05k and preserve two clean JLC analyses
    [bom.csv, candidate-bom.csv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]
2026-10-25 Record battery charging-temperature and pack-current incompatibilities
    [check_pack_charge.py, verify_handoff.py]
2026-10-25 Package the verified r05k PCB and charging hold for review
2026-10-25 Prioritize the cell-temperature interlock in the project handoff
2026-10-25 Implement hardware charge-temperature interlock with verified PCB DFM
    [bom.csv, candidate-bom.csv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]
2026-10-25 Clear charge logic in the carrier and validate populated enclosure CAD
    [body.stl, boot.stl, carrier.stl, contact.stl, contact_seal.stl, dock.stl, enclosure.scad, lid.stl]
2026-10-25 Verify charge circuit, source preservation and supplier evidence on resume
2026-10-25 Deliver r05l PCB and enclosure review with current continuation state
2026-10-25 Model prototype antenna cables and validate r08 enclosure clearances
    [body.stl, boot.stl, cables.scad, carrier.stl, contact.stl, contact_seal.stl, dock.stl, enclosure.scad]
2026-10-25 Deliver r08 assembly review and update continuation instructions
2026-10-25 Define battery supplier request and validate r09 fit study
    [body.stl, boot.stl, cables.scad, carrier.stl, contact.stl, contact_seal.stl, dock.stl, enclosure.scad]
2026-10-25 Add and validate a captive PCB retention prototype
    [body.stl, boot.stl, cables.scad, carrier.stl, contact.stl, contact_seal.stl, dock.stl, enclosure.scad]
2026-10-25 Add conditional thermal-fit retention prototype
    [body.stl, boot.stl, cables.scad, carrier.stl, contact.stl, contact_seal.stl, dock.stl, enclosure.scad]
2026-10-25 Record thermal prototype status and verification
2026-10-25 Add conditional battery cradle and retention cap
    [body.stl, carrier.stl, enclosure.scad, pack-retention-parameters.scad, pack-retention.scad, pack.scad]
2026-10-25 Record battery retention evidence and remaining integration work
2026-10-25 Add a sourced charging dock geometry prototype
    [body.stl, candidate-bom.csv, collar-interference.stl, dock.scad, lower.stl, parameters.scad, upper.stl]
2026-10-26 Bound charging-wire movement and thermal clearance
    [dock.scad, lower.stl, parameters.scad, upper.stl]
2026-10-26 Package the current PCB and enclosure review with remaining work
2026-10-26 Add a padded charging-wire clamp and assembly fixture
    [cap.stl, dock.scad, fixture.stl, lower.stl, parameters.scad, upper.stl]
2026-10-26 Add rear bearing terminals for the charging contacts
    [body.stl, contact.stl, contacts.scad, negative_terminal.stl, parameters.scad, positive_terminal.stl]
2026-10-26 WIP: model internal charge leads and expose movement failures
    [black-wire.stl, harness.scad, red-wire.stl]
2026-10-26 WIP: verify fixed-length charge routes across correlated board poses
    [check_internal_harness.py, check_internal_harness_motion.py, search_internal_harness_motion.py, verify_internal_harness.py]
2026-10-26 fix(harness): include RF guide blocks in route checks
    [check_internal_harness.py, verify_internal_harness.py]
2026-10-26 fix(harness): refine continuous bounds for short curve handles
    [check_internal_harness.py, internal_harness_geometry.py]
2026-10-26 WIP: integrate four cable routes across 27 PCB poses
    [gnss-guide-witness.stl, lte-guide-witness.stl, routing.scad]
2026-10-26 WIP: correct charge-wire thermal clearance in r18
    [black-wire.stl, gnss-guide-witness.stl, harness.scad, red-wire.stl, retainer.scad, retainer.stl]
2026-10-26 docs: Record internal charge-staking material references
2026-10-26 WIP: Add internal charge-wire support and forming tools
    [black-fixture-wire.stl, black-fixture-witness.stl, black-fixture.scad, black-fixture.stl, red-fixture-wire.stl, red-fixture-witness.stl, red-fixture.scad, red-fixture.stl]
2026-10-26 chore: Update collar handoff for r19 assembly prototype
2026-10-26 feat(firmware): add nRF9151 non-secure board and pinned modem SDK
2026-10-26 docs: record tracker prototype evidence and remaining release work
2026-10-26 test(firmware): preserve r02 build and recovery fault evidence
    [tfm-config.txt]
2026-10-26 test: preserve signed tracker build and recovery evidence
    [tfm-config.txt]
2026-10-26 feat: prepare r05l supplier assembly files and native pad maps
    [bom.csv, fitted-pads.csv, interface-pads.csv, pin-one.csv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]
2026-10-26 fix: align r05l IC placement angles with JLC library
    [cpl-jlc-review.csv]
2026-10-26 docs: package assembly review and record factory release gaps
2026-10-26 fix: align U.FL models and document remaining assembly gaps
    [cpl-jlc-review.csv]
2026-10-26 chore: advance manufacturing handoff to PCBA r02
2026-10-26 docs: prepare PCBA sourcing and factory feasibility enquiry
2026-10-26 Select ROHM Q1 for the next assembled prototype
    [bom.csv, collar-tracker.kicad_pcb, collar-tracker.kicad_sch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]
2026-10-26 Reject the U.FL datum alternative with actual SMT evidence
    [bom.csv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]
2026-10-26 Report the current assembly revision when resuming
2026-10-26 feat(mechanical): add adjustable dual-strap collar mount
    [antennas.stl, battery.stl, body.stl, boot.stl, carrier.stl, charge_wires.stl, components.scad, contacts.stl]
2026-10-26 feat(preview): add offline PCB and enclosure 3D viewer
2026-10-28 docs(media): add reproducible CAD animations and system diagram
2026-10-28 docs: pause collar work pending PCB ordering
2026-11-11 Configure Linguist overrides for KiCad and HTML viewer
2026-11-11 Configure hyphenated KiCad Linguist rules and generated trees
